sigmadrone/sigmadrone/hardware/kicad.old/readme.txt

This is old design for Panda ES extension board. It will not be used in the future!
It will be kept here just as reference.
