sigmadrone/sigmadrone/source/tools/glplane/numbers.bmp

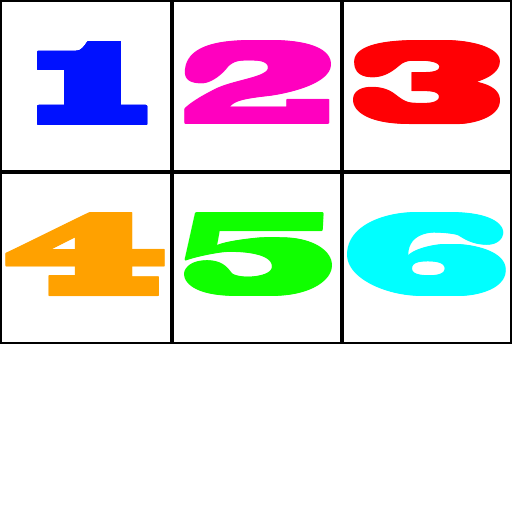
source/tools/glplane/numbers.bmp
