sigmadrone/sigmadrone/hardware/colibri/rev1j/Colibri_Rev1j_BOM.xlsx

Sheet: FULL BOM
 | DATE: | 2015-04-19 | FULL BOM
 | PROJECT: | Colibri_Rev1j
Note | Comp Name | PartName | Description | Type | Value | Maker | Maker Part Name | Provider | Provider Part Name | Maker2 | Maker2 Part Name | Provider2 | Provider2 Part Name | Maker3 | Maker3 Part Name | Provider3 | Provider3 Part Name | Maker4 | Maker4 Part Name | Provider4 | Provider4 Part Name
 | A1 | 1575AT43A0040E | ANTENNA CHIP GPS 1575 MHZ | SMT | 1575AT43A0040E | Johanson Technology Inc | 1575AT43A0040E | Digikey | 712-1003-1-ND | - | - | Mouser | 609-1575AT43A0040E | - | - | - | - | - | - | - | -
 | AREA1 | PATCH AREA 2.54/5X10/2X2/DRILL 1.00 | Patch Area 2.54/5x10/2x2/drill 1.00 | THT | Patch Area 2.54/5x10/2x2/drill 1.00 | - | - | - | - | - | - | - | - | - | - | - | - | - | - | - | -
 | B1 | WURTH 79527141 / BATTERY HOLDER 2032 | Battery Holder WA-BCMC 2032 | SMT | Battery Holder 2032 | WURTH ELEKTRONIK | 795 271 41 | WURTH ELEKTRONIK | - | - | - | - | - | - | - | - | - | - | - | - | -
 | C1 | C0603-100N/50V/±10%/X7R | Chip Capacitor 0603 100nF/50V/±10%/X7R | SMT | 100n/50V | KEMET | C0603X104K5RAC | Farnell | 1414028 | Kemet | C0603X104K5RACTU | DigiKey | 399-7969-1-ND | SAMSUNG | CL10B104KB8NNNC | Future | CL10B104KB8NNNC | Samsung | CL10B104KBNC | Comet | C0603 100nF 50V X7R SAMSU
 | C2 | C0603-100N/50V/±10%/X7R | Chip Capacitor 0603 100nF/50V/±10%/X7R | SMT | 100n/50V | KEMET | C0603X104K5RAC | Farnell | 1414028 | Kemet | C0603X104K5RACTU | DigiKey | 399-7969-1-ND | SAMSUNG | CL10B104KB8NNNC | Future | CL10B104KB8NNNC | Samsung | CL10B104KBNC | Comet | C0603 100nF 50V X7R SAMSU
 | C3 | C0805-10u/16V/X5R | CAP CER 10UF 16V 20% X5R 0805 | SMT | 10u/16V/X5R | MURATA | GRM21BR61C106KE15L | Farnell | 1762635 | TDK Corporation | C2012X5R1C106M/1.25 | Digikey | 445-4115-1-ND | SAMSUNG | CL21A106KOQNNNE | Comet | C0805 10uF 16V X5R SAMSUN | - | - | - | -
 | C4 | C0805-10u/16V/X5R | CAP CER 10UF 16V 20% X5R 0805 | SMT | 10u/16V/X5R | MURATA | GRM21BR61C106KE15L | Farnell | 1762635 | TDK Corporation | C2012X5R1C106M/1.25 | Digikey | 445-4115-1-ND | SAMSUNG | CL21A106KOQNNNE | Comet | C0805 10uF 16V X5R SAMSUN | - | - | - | -
 | C5 | C0603-100N/50V/±10%/X7R | Chip Capacitor 0603 100nF/50V/±10%/X7R | SMT | 100n/50V | KEMET | C0603X104K5RAC | Farnell | 1414028 | Kemet | C0603X104K5RACTU | DigiKey | 399-7969-1-ND | SAMSUNG | CL10B104KB8NNNC | Future | CL10B104KB8NNNC | Samsung | CL10B104KBNC | Comet | C0603 100nF 50V X7R SAMSU
 | C6 | C0805-10u/16V/X5R | CAP CER 10UF 16V 20% X5R 0805 | SMT | 10u/16V/X5R | MURATA | GRM21BR61C106KE15L | Farnell | 1762635 | TDK Corporation | C2012X5R1C106M/1.25 | Digikey | 445-4115-1-ND | SAMSUNG | CL21A106KOQNNNE | Comet | C0805 10uF 16V X5R SAMSUN | - | - | - | -
 | C7 | C0603-100N/50V/±10%/X7R | Chip Capacitor 0603 100nF/50V/±10%/X7R | SMT | 100n/50V | KEMET | C0603X104K5RAC | Farnell | 1414028 | Kemet | C0603X104K5RACTU | DigiKey | 399-7969-1-ND | SAMSUNG | CL10B104KB8NNNC | Future | CL10B104KB8NNNC | Samsung | CL10B104KBNC | Comet | C0603 100nF 50V X7R SAMSU
 | C8 | C_Tantalum C 220u/6V3 | Tantal Capacitor Case C 220u/6V3 | SMT | 220u/6V3_T | AVX | TPSC227K006R0125 | Farnell | 1462420 | AVX | TPSC227K006R0125 | Digikey | 478-1768-1-ND | AVX | TPSC227K006R0125 | Future | TPSC227K006R0125 | - | - | - | -
 | C9 | C0805-10u/16V/X5R | CAP CER 10UF 16V 20% X5R 0805 | SMT | 10u/16V/X5R | MURATA | GRM21BR61C106KE15L | Farnell | 1762635 | TDK Corporation | C2012X5R1C106M/1.25 | Digikey | 445-4115-1-ND | SAMSUNG | CL21A106KOQNNNE | Comet | C0805 10uF 16V X5R SAMSUN | - | - | - | -
 | C10 | C0603-100N/50V/±10%/X7R | Chip Capacitor 0603 100nF/50V/±10%/X7R | SMT | 100n/50V | KEMET | C0603X104K5RAC | Farnell | 1414028 | Kemet | C0603X104K5RACTU | DigiKey | 399-7969-1-ND | SAMSUNG | CL10B104KB8NNNC | Future | CL10B104KB8NNNC | Samsung | CL10B104KBNC | Comet | C0603 100nF 50V X7R SAMSU
 | C11 | C0603-100N/50V/±10%/X7R | Chip Capacitor 0603 100nF/50V/±10%/X7R | SMT | 100n/50V | KEMET | C0603X104K5RAC | Farnell | 1414028 | Kemet | C0603X104K5RACTU | DigiKey | 399-7969-1-ND | SAMSUNG | CL10B104KB8NNNC | Future | CL10B104KB8NNNC | Samsung | CL10B104KBNC | Comet | C0603 100nF 50V X7R SAMSU
 | C12 | C0805-10u/16V/X5R | CAP CER 10UF 16V 20% X5R 0805 | SMT | 10u/16V/X5R | MURATA | GRM21BR61C106KE15L | Farnell | 1762635 | TDK Corporation | C2012X5R1C106M/1.25 | Digikey | 445-4115-1-ND | SAMSUNG | CL21A106KOQNNNE | Comet | C0805 10uF 16V X5R SAMSUN | - | - | - | -
 | C13 | C0603-100N/50V/±10%/X7R | Chip Capacitor 0603 100nF/50V/±10%/X7R | SMT | 100n/50V | KEMET | C0603X104K5RAC | Farnell | 1414028 | Kemet | C0603X104K5RACTU | DigiKey | 399-7969-1-ND | SAMSUNG | CL10B104KB8NNNC | Future | CL10B104KB8NNNC | Samsung | CL10B104KBNC | Comet | C0603 100nF 50V X7R SAMSU
 | C14 | C0603-100N/50V/±10%/X7R | Chip Capacitor 0603 100nF/50V/±10%/X7R | SMT | 100n/50V | KEMET | C0603X104K5RAC | Farnell | 1414028 | Kemet | C0603X104K5RACTU | DigiKey | 399-7969-1-ND | SAMSUNG | CL10B104KB8NNNC | Future | CL10B104KB8NNNC | Samsung | CL10B104KBNC | Comet | C0603 100nF 50V X7R SAMSU
 | C15 | C0603-47p/50V/C0G/5% | Chip Capacitor 0603 47p/50V | SMT | 47p/50V | KEMET | C0603C470J1GACTU | Farnell | 1813433 | KEMET | C0603C470J1GACTU | Digikey | 399-7917-1-ND | AVX | 06035A470JAT2A | Future | 06035A470JAT2A | SAMSUNG | CL10C470JBNC | Comet | C0603 47pF 50V C0G SAMSUN
 | C16 | C0603-47p/50V/C0G/5% | Chip Capacitor 0603 47p/50V | SMT | 47p/50V | KEMET | C0603C470J1GACTU | Farnell | 1813433 | KEMET | C0603C470J1GACTU | Digikey | 399-7917-1-ND | AVX | 06035A470JAT2A | Future | 06035A470JAT2A | SAMSUNG | CL10C470JBNC | Comet | C0603 47pF 50V C0G SAMSUN
 | C17 | C_Tantalum C 220u/6V3 | Tantal Capacitor Case C 220u/6V3 | SMT | 220u/6V3_T | AVX | TPSC227K006R0125 | Farnell | 1462420 | AVX | TPSC227K006R0125 | Digikey | 478-1768-1-ND | AVX | TPSC227K006R0125 | Future | TPSC227K006R0125 | - | - | - | -
 | C18 | C0603-100N/50V/±10%/X7R | Chip Capacitor 0603 100nF/50V/±10%/X7R | SMT | 100n/50V | KEMET | C0603X104K5RAC | Farnell | 1414028 | Kemet | C0603X104K5RACTU | DigiKey | 399-7969-1-ND | SAMSUNG | CL10B104KB8NNNC | Future | CL10B104KB8NNNC | Samsung | CL10B104KBNC | Comet | C0603 100nF 50V X7R SAMSU
 | C19 | C0805-10u/16V/X5R | CAP CER 10UF 16V 20% X5R 0805 | SMT | 10u/16V/X5R | MURATA | GRM21BR61C106KE15L | Farnell | 1762635 | TDK Corporation | C2012X5R1C106M/1.25 | Digikey | 445-4115-1-ND | SAMSUNG | CL21A106KOQNNNE | Comet | C0805 10uF 16V X5R SAMSUN | - | - | - | -
 | C20 | C0603-100N/50V/±10%/X7R | Chip Capacitor 0603 100nF/50V/±10%/X7R | SMT | 100n/50V | KEMET | C0603X104K5RAC | Farnell | 1414028 | Kemet | C0603X104K5RACTU | DigiKey | 399-7969-1-ND | SAMSUNG | CL10B104KB8NNNC | Future | CL10B104KB8NNNC | Samsung | CL10B104KBNC | Comet | C0603 100nF 50V X7R SAMSU
 | C21 | C0603-100N/50V/±10%/X7R | Chip Capacitor 0603 100nF/50V/±10%/X7R | SMT | 100n/50V | KEMET | C0603X104K5RAC | Farnell | 1414028 | Kemet | C0603X104K5RACTU | DigiKey | 399-7969-1-ND | SAMSUNG | CL10B104KB8NNNC | Future | CL10B104KB8NNNC | Samsung | CL10B104KBNC | Comet | C0603 100nF 50V X7R SAMSU
 | C22 | C0603-220n/50V/±10%/X7R | CAP CER 0.22UF 50V 10% X7R 0603 | SMT | 220n/50V/X7R | TDK Corporation | CGA3E3X7R1H224K080AB | Farnell | 2210924 | TDK Corporation | C1608X7R1H224K | Digikey | 445-7408-1-ND | UWA | - | Comet | C0603 220nF 50V Y5V | - | - | - | -
 | C23 | C0603-100N/50V/±10%/X7R | Chip Capacitor 0603 100nF/50V/±10%/X7R | SMT | 100n/50V | KEMET | C0603X104K5RAC | Farnell | 1414028 | Kemet | C0603X104K5RACTU | DigiKey | 399-7969-1-ND | SAMSUNG | CL10B104KB8NNNC | Future | CL10B104KB8NNNC | Samsung | CL10B104KBNC | Comet | C0603 100nF 50V X7R SAMSU
 | C24 | C0603-4u7/6V3/X5R | Chip Capacitor 0603 4u7/6V3/X5R/10% | SMT | 4u7/6V3/X5R | AVX | 06036D475KAT2A | Farnell | 1833803 | TDK Corporation | C1608X6S0J475K | Digikey | 445-7446-1-ND | - | - | - | - | - | - | -
 | C25 | C0805-10u/16V/X5R | CAP CER 10UF 16V 20% X5R 0805 | SMT | 10u/16V/X5R | MURATA | GRM21BR61C106KE15L | Farnell | 1762635 | TDK Corporation | C2012X5R1C106M/1.25 | Digikey | 445-4115-1-ND | SAMSUNG | CL21A106KOQNNNE | Comet | C0805 10uF 16V X5R SAMSUN | - | - | - | -
 | C26 | C0603-100N/50V/±10%/X7R | Chip Capacitor 0603 100nF/50V/±10%/X7R | SMT | 100n/50V | KEMET | C0603X104K5RAC | Farnell | 1414028 | Kemet | C0603X104K5RACTU | DigiKey | 399-7969-1-ND | SAMSUNG | CL10B104KB8NNNC | Future | CL10B104KB8NNNC | Samsung | CL10B104KBNC | Comet | C0603 100nF 50V X7R SAMSU
 | C27 | C0805-10u/16V/X5R | CAP CER 10UF 16V 20% X5R 0805 | SMT | 10u/16V/X5R | MURATA | GRM21BR61C106KE15L | Farnell | 1762635 | TDK Corporation | C2012X5R1C106M/1.25 | Digikey | 445-4115-1-ND | SAMSUNG | CL21A106KOQNNNE | Comet | C0805 10uF 16V X5R SAMSUN | - | - | - | -
 | C28 | C0603-10n/50V/X7R | Chip Capacitor 0603 10nF/50V/X7R | SMT | 10n/50V/X7R | KEMET | C0603C103K5RACTU | Farnell | 1414609 | KEMET | C0603C103K5RACTU | DigiKey | 399-1091-1-ND | SAMSUNG | CL10B103KB8NNNC | Future | CL10B103KB8NNNC | MURATA | GRM216R71H103KA01D | Farnell | 1828948
 | C29 | C0603-470N/25V/±10%/X7R | Chip Capacitor 0603 470n/±10%/25V/X7R | SMT | 470n/25V/X7R | MULTICOMP | MCCA001174 | Farnell | 1856365 | - | - | - | - | - | - | - | - | - | - | - | -
 | C30 | C0603-15p/50V/1%/NP0 | Chip Capacitor 0603-15p/50V/1%/NP0 | SMT | 15p/50V/1% | MULTICOMP | MCCA000984 | Farnell | 1856143 | Samsung Electro-Mechanics | CL10C150JBNC | Comet | C0603 15pF 50V C0G SAMSUNG | YAGEO | CC0603FRNPO9BN150 | Future | CC0603FRNPO9BN150 | - | - | - | -
 | C31 | C0603-15p/50V/1%/NP0 | Chip Capacitor 0603-15p/50V/1%/NP0 | SMT | 15p/50V/1% | MULTICOMP | MCCA000984 | Farnell | 1856143 | Samsung Electro-Mechanics | CL10C150JBNC | Comet | C0603 15pF 50V C0G SAMSUNG | YAGEO | CC0603FRNPO9BN150 | Future | CC0603FRNPO9BN150 | - | - | - | -
 | C32 | C0603-10p/±0.25pF/NPO | Chip Capacitor 0603 10p/±0.25pF/NPO | SMT | 10p/50V/NPO | KEMET | C0603C100C5GAC | Farnell | 1414599 | KEMET | C0603C100C5GACTU | Digikey | C0603C100C5GACTU-ND | YAGEO AMERICA CORPORATION | CC0603CRNPO9BN100 | Future | CC0603CRNPO9BN100 | - | - | - | -
 | C33 | C0603-10p/±0.25pF/NPO | Chip Capacitor 0603 10p/±0.25pF/NPO | SMT | 10p/50V/NPO | KEMET | C0603C100C5GAC | Farnell | 1414599 | KEMET | C0603C100C5GACTU | Digikey | C0603C100C5GACTU-ND | YAGEO AMERICA CORPORATION | CC0603CRNPO9BN100 | Future | CC0603CRNPO9BN100 | - | - | - | -
 | C34 | C0603-2u2/10V/X5R | CAP CER 2.2UF 10V 10% X5R 0603 | SMT | 2u2/10V/X5R | KEMET | C0603C225K8PAC7867 | Farnell | 1108322 | Kemet | C0603C225K8PACTU | Digikey | 399-4911-1-ND | SAMSUNG | CL10A225KO8NNNC | Comet | C0603 2.2uF 16V X5R SAMSU | - | - | - | -
 | C35 | C0603-100N/50V/±10%/X7R | Chip Capacitor 0603 100nF/50V/±10%/X7R | SMT | 100n/50V | KEMET | C0603X104K5RAC | Farnell | 1414028 | Kemet | C0603X104K5RACTU | DigiKey | 399-7969-1-ND | SAMSUNG | CL10B104KB8NNNC | Future | CL10B104KB8NNNC | Samsung | CL10B104KBNC | Comet | C0603 100nF 50V X7R SAMSU
 | C36 | C0603-47p/50V/C0G/5% | Chip Capacitor 0603 47p/50V | SMT | 47p/50V | KEMET | C0603C470J1GACTU | Farnell | 1813433 | KEMET | C0603C470J1GACTU | Digikey | 399-7917-1-ND | AVX | 06035A470JAT2A | Future | 06035A470JAT2A | SAMSUNG | CL10C470JBNC | Comet | C0603 47pF 50V C0G SAMSUN
 | C37 | C0603-47p/50V/C0G/5% | Chip Capacitor 0603 47p/50V | SMT | 47p/50V | KEMET | C0603C470J1GACTU | Farnell | 1813433 | KEMET | C0603C470J1GACTU | Digikey | 399-7917-1-ND | AVX | 06035A470JAT2A | Future | 06035A470JAT2A | SAMSUNG | CL10C470JBNC | Comet | C0603 47pF 50V C0G SAMSUN
 | C38 | C0603-100N/50V/±10%/X7R | Chip Capacitor 0603 100nF/50V/±10%/X7R | SMT | 100n/50V | KEMET | C0603X104K5RAC | Farnell | 1414028 | Kemet | C0603X104K5RACTU | DigiKey | 399-7969-1-ND | SAMSUNG | CL10B104KB8NNNC | Future | CL10B104KB8NNNC | Samsung | CL10B104KBNC | Comet | C0603 100nF 50V X7R SAMSU
 | C39 | C0603-100N/50V/±10%/X7R | Chip Capacitor 0603 100nF/50V/±10%/X7R | SMT | 100n/50V | KEMET | C0603X104K5RAC | Farnell | 1414028 | Kemet | C0603X104K5RACTU | DigiKey | 399-7969-1-ND | SAMSUNG | CL10B104KB8NNNC | Future | CL10B104KB8NNNC | Samsung | CL10B104KBNC | Comet | C0603 100nF 50V X7R SAMSU
 | C40 | C0603-100N/50V/±10%/X7R | Chip Capacitor 0603 100nF/50V/±10%/X7R | SMT | 100n/50V | KEMET | C0603X104K5RAC | Farnell | 1414028 | Kemet | C0603X104K5RACTU | DigiKey | 399-7969-1-ND | SAMSUNG | CL10B104KB8NNNC | Future | CL10B104KB8NNNC | Samsung | CL10B104KBNC | Comet | C0603 100nF 50V X7R SAMSU
 | C41 | C0603-100N/50V/±10%/X7R | Chip Capacitor 0603 100nF/50V/±10%/X7R | SMT | 100n/50V | KEMET | C0603X104K5RAC | Farnell | 1414028 | Kemet | C0603X104K5RACTU | DigiKey | 399-7969-1-ND | SAMSUNG | CL10B104KB8NNNC | Future | CL10B104KB8NNNC | Samsung | CL10B104KBNC | Comet | C0603 100nF 50V X7R SAMSU
 | C42 | C0603-100N/50V/±10%/X7R | Chip Capacitor 0603 100nF/50V/±10%/X7R | SMT | 100n/50V | KEMET | C0603X104K5RAC | Farnell | 1414028 | Kemet | C0603X104K5RACTU | DigiKey | 399-7969-1-ND | SAMSUNG | CL10B104KB8NNNC | Future | CL10B104KB8NNNC | Samsung | CL10B104KBNC | Comet | C0603 100nF 50V X7R SAMSU
 | C43 | C0603-100N/50V/±10%/X7R | Chip Capacitor 0603 100nF/50V/±10%/X7R | SMT | 100n/50V | KEMET | C0603X104K5RAC | Farnell | 1414028 | Kemet | C0603X104K5RACTU | DigiKey | 399-7969-1-ND | SAMSUNG | CL10B104KB8NNNC | Future | CL10B104KB8NNNC | Samsung | CL10B104KBNC | Comet | C0603 100nF 50V X7R SAMSU
 | C44 | C0603-100N/50V/±10%/X7R | Chip Capacitor 0603 100nF/50V/±10%/X7R | SMT | 100n/50V | KEMET | C0603X104K5RAC | Farnell | 1414028 | Kemet | C0603X104K5RACTU | DigiKey | 399-7969-1-ND | SAMSUNG | CL10B104KB8NNNC | Future | CL10B104KB8NNNC | Samsung | CL10B104KBNC | Comet | C0603 100nF 50V X7R SAMSU
 | C45 | C0603-100N/50V/±10%/X7R | Chip Capacitor 0603 100nF/50V/±10%/X7R | SMT | 100n/50V | KEMET | C0603X104K5RAC | Farnell | 1414028 | Kemet | C0603X104K5RACTU | DigiKey | 399-7969-1-ND | SAMSUNG | CL10B104KB8NNNC | Future | CL10B104KB8NNNC | Samsung | CL10B104KBNC | Comet | C0603 100nF 50V X7R SAMSU
 | C46 | C0603-100N/50V/±10%/X7R | Chip Capacitor 0603 100nF/50V/±10%/X7R | SMT | 100n/50V | KEMET | C0603X104K5RAC | Farnell | 1414028 | Kemet | C0603X104K5RACTU | DigiKey | 399-7969-1-ND | SAMSUNG | CL10B104KB8NNNC | Future | CL10B104KB8NNNC | Samsung | CL10B104KBNC | Comet | C0603 100nF 50V X7R SAMSU
 | C47 | C0603-100N/50V/±10%/X7R | Chip Capacitor 0603 100nF/50V/±10%/X7R | SMT | 100n/50V | KEMET | C0603X104K5RAC | Farnell | 1414028 | Kemet | C0603X104K5RACTU | DigiKey | 399-7969-1-ND | SAMSUNG | CL10B104KB8NNNC | Future | CL10B104KB8NNNC | Samsung | CL10B104KBNC | Comet | C0603 100nF 50V X7R SAMSU
 | C48 | C0603-100N/50V/±10%/X7R | Chip Capacitor 0603 100nF/50V/±10%/X7R | SMT | 100n/50V | KEMET | C0603X104K5RAC | Farnell | 1414028 | Kemet | C0603X104K5RACTU | DigiKey | 399-7969-1-ND | SAMSUNG | CL10B104KB8NNNC | Future | CL10B104KB8NNNC | Samsung | CL10B104KBNC | Comet | C0603 100nF 50V X7R SAMSU
 | C49 | C0805-10u/16V/X5R | CAP CER 10UF 16V 20% X5R 0805 | SMT | 10u/16V/X5R | MURATA | GRM21BR61C106KE15L | Farnell | 1762635 | TDK Corporation | C2012X5R1C106M/1.25 | Digikey | 445-4115-1-ND | SAMSUNG | CL21A106KOQNNNE | Comet | C0805 10uF 16V X5R SAMSUN | - | - | - | -
 | C50 | C0603-1u/25V/±10%/X7R | CAP CER 1UF 25V 10% X7R 0603 | SMT | 1u/25V/X7R | MURATA | GRM188R71E105KA12D | Farnell | 1735540 | TDK Corporation | C1608X7R1E105K080AB | Digi-Key | 445-5956-1-ND | - | - | - | - | - | - | - | -
 | C51 | C0603-100N/50V/±10%/X7R | Chip Capacitor 0603 100nF/50V/±10%/X7R | SMT | 100n/50V | KEMET | C0603X104K5RAC | Farnell | 1414028 | Kemet | C0603X104K5RACTU | DigiKey | 399-7969-1-ND | SAMSUNG | CL10B104KB8NNNC | Future | CL10B104KB8NNNC | Samsung | CL10B104KBNC | Comet | C0603 100nF 50V X7R SAMSU
 | C52 | C0603-100N/50V/±10%/X7R | Chip Capacitor 0603 100nF/50V/±10%/X7R | SMT | 100n/50V | KEMET | C0603X104K5RAC | Farnell | 1414028 | Kemet | C0603X104K5RACTU | DigiKey | 399-7969-1-ND | SAMSUNG | CL10B104KB8NNNC | Future | CL10B104KB8NNNC | Samsung | CL10B104KBNC | Comet | C0603 100nF 50V X7R SAMSU
 | C53 | C0805-10u/16V/X5R | CAP CER 10UF 16V 20% X5R 0805 | SMT | 10u/16V/X5R | MURATA | GRM21BR61C106KE15L | Farnell | 1762635 | TDK Corporation | C2012X5R1C106M/1.25 | Digikey | 445-4115-1-ND | SAMSUNG | CL21A106KOQNNNE | Comet | C0805 10uF 16V X5R SAMSUN | - | - | - | -
 | C54 | C0603-100N/50V/±10%/X7R | Chip Capacitor 0603 100nF/50V/±10%/X7R | SMT | 100n/50V | KEMET | C0603X104K5RAC | Farnell | 1414028 | Kemet | C0603X104K5RACTU | DigiKey | 399-7969-1-ND | SAMSUNG | CL10B104KB8NNNC | Future | CL10B104KB8NNNC | Samsung | CL10B104KBNC | Comet | C0603 100nF 50V X7R SAMSU
 | C55 | C0603-100N/50V/±10%/X7R | Chip Capacitor 0603 100nF/50V/±10%/X7R | SMT | 100n/50V | KEMET | C0603X104K5RAC | Farnell | 1414028 | Kemet | C0603X104K5RACTU | DigiKey | 399-7969-1-ND | SAMSUNG | CL10B104KB8NNNC | Future | CL10B104KB8NNNC | Samsung | CL10B104KBNC | Comet | C0603 100nF 50V X7R SAMSU
 | C56 | C0603-2u2/10V/X5R | CAP CER 2.2UF 10V 10% X5R 0603 | SMT | 2u2/10V/X5R | KEMET | C0603C225K8PAC7867 | Farnell | 1108322 | Kemet | C0603C225K8PACTU | Digikey | 399-4911-1-ND | SAMSUNG | CL10A225KO8NNNC | Comet | C0603 2.2uF 16V X5R SAMSU | - | - | - | -
 | C57 | C0603-100N/50V/±10%/X7R | Chip Capacitor 0603 100nF/50V/±10%/X7R | SMT | 100n/50V | KEMET | C0603X104K5RAC | Farnell | 1414028 | Kemet | C0603X104K5RACTU | DigiKey | 399-7969-1-ND | SAMSUNG | CL10B104KB8NNNC | Future | CL10B104KB8NNNC | Samsung | CL10B104KBNC | Comet | C0603 100nF 50V X7R SAMSU
 | C58 | C0603-100N/50V/±10%/X7R | Chip Capacitor 0603 100nF/50V/±10%/X7R | SMT | 100n/50V | KEMET | C0603X104K5RAC | Farnell | 1414028 | Kemet | C0603X104K5RACTU | DigiKey | 399-7969-1-ND | SAMSUNG | CL10B104KB8NNNC | Future | CL10B104KB8NNNC | Samsung | CL10B104KBNC | Comet | C0603 100nF 50V X7R SAMSU
 | C59 | C0603-100N/50V/±10%/X7R | Chip Capacitor 0603 100nF/50V/±10%/X7R | SMT | 100n/50V | KEMET | C0603X104K5RAC | Farnell | 1414028 | Kemet | C0603X104K5RACTU | DigiKey | 399-7969-1-ND | SAMSUNG | CL10B104KB8NNNC | Future | CL10B104KB8NNNC | Samsung | CL10B104KBNC | Comet | C0603 100nF 50V X7R SAMSU
 | C60 | C0603-100N/50V/±10%/X7R | Chip Capacitor 0603 100nF/50V/±10%/X7R | SMT | 100n/50V | KEMET | C0603X104K5RAC | Farnell | 1414028 | Kemet | C0603X104K5RACTU | DigiKey | 399-7969-1-ND | SAMSUNG | CL10B104KB8NNNC | Future | CL10B104KB8NNNC | Samsung | CL10B104KBNC | Comet | C0603 100nF 50V X7R SAMSU
 | C61 | C0603-100N/50V/±10%/X7R | Chip Capacitor 0603 100nF/50V/±10%/X7R | SMT | 100n/50V | KEMET | C0603X104K5RAC | Farnell | 1414028 | Kemet | C0603X104K5RACTU | DigiKey | 399-7969-1-ND | SAMSUNG | CL10B104KB8NNNC | Future | CL10B104KB8NNNC | Samsung | CL10B104KBNC | Comet | C0603 100nF 50V X7R SAMSU
 | C62 | C0603-100N/50V/±10%/X7R | Chip Capacitor 0603 100nF/50V/±10%/X7R | SMT | 100n/50V | KEMET | C0603X104K5RAC | Farnell | 1414028 | Kemet | C0603X104K5RACTU | DigiKey | 399-7969-1-ND | SAMSUNG | CL10B104KB8NNNC | Future | CL10B104KB8NNNC | Samsung | CL10B104KBNC | Comet | C0603 100nF 50V X7R SAMSU
 | C63 | C0603-100N/50V/±10%/X7R | Chip Capacitor 0603 100nF/50V/±10%/X7R | SMT | 100n/50V | KEMET | C0603X104K5RAC | Farnell | 1414028 | Kemet | C0603X104K5RACTU | DigiKey | 399-7969-1-ND | SAMSUNG | CL10B104KB8NNNC | Future | CL10B104KB8NNNC | Samsung | CL10B104KBNC | Comet | C0603 100nF 50V X7R SAMSU
 | C64 | C0603-100N/50V/±10%/X7R | Chip Capacitor 0603 100nF/50V/±10%/X7R | SMT | 100n/50V | KEMET | C0603X104K5RAC | Farnell | 1414028 | Kemet | C0603X104K5RACTU | DigiKey | 399-7969-1-ND | SAMSUNG | CL10B104KB8NNNC | Future | CL10B104KB8NNNC | Samsung | CL10B104KBNC | Comet | C0603 100nF 50V X7R SAMSU
 | C65 | C0603-100N/50V/±10%/X7R | Chip Capacitor 0603 100nF/50V/±10%/X7R | SMT | 100n/50V | KEMET | C0603X104K5RAC | Farnell | 1414028 | Kemet | C0603X104K5RACTU | DigiKey | 399-7969-1-ND | SAMSUNG | CL10B104KB8NNNC | Future | CL10B104KB8NNNC | Samsung | CL10B104KBNC | Comet | C0603 100nF 50V X7R SAMSU
 | C66 | C0603-100N/50V/±10%/X7R | Chip Capacitor 0603 100nF/50V/±10%/X7R | SMT | 100n/50V | KEMET | C0603X104K5RAC | Farnell | 1414028 | Kemet | C0603X104K5RACTU | DigiKey | 399-7969-1-ND | SAMSUNG | CL10B104KB8NNNC | Future | CL10B104KB8NNNC | Samsung | CL10B104KBNC | Comet | C0603 100nF 50V X7R SAMSU
 | C67 | C0603-100N/50V/±10%/X7R | Chip Capacitor 0603 100nF/50V/±10%/X7R | SMT | 100n/50V | KEMET | C0603X104K5RAC | Farnell | 1414028 | Kemet | C0603X104K5RACTU | DigiKey | 399-7969-1-ND | SAMSUNG | CL10B104KB8NNNC | Future | CL10B104KB8NNNC | Samsung | CL10B104KBNC | Comet | C0603 100nF 50V X7R SAMSU
 | C68 | C0603-100N/50V/±10%/X7R | Chip Capacitor 0603 100nF/50V/±10%/X7R | SMT | 100n/50V | KEMET | C0603X104K5RAC | Farnell | 1414028 | Kemet | C0603X104K5RACTU | DigiKey | 399-7969-1-ND | SAMSUNG | CL10B104KB8NNNC | Future | CL10B104KB8NNNC | Samsung | CL10B104KBNC | Comet | C0603 100nF 50V X7R SAMSU
 | C69 | C0603-2u2/10V/X5R | CAP CER 2.2UF 10V 10% X5R 0603 | SMT | 2u2/10V/X5R | KEMET | C0603C225K8PAC7867 | Farnell | 1108322 | Kemet | C0603C225K8PACTU | Digikey | 399-4911-1-ND | SAMSUNG | CL10A225KO8NNNC | Comet | C0603 2.2uF 16V X5R SAMSU | - | - | - | -
 | C70 | C0603-100N/50V/±10%/X7R | Chip Capacitor 0603 100nF/50V/±10%/X7R | SMT | 100n/50V | KEMET | C0603X104K5RAC | Farnell | 1414028 | Kemet | C0603X104K5RACTU | DigiKey | 399-7969-1-ND | SAMSUNG | CL10B104KB8NNNC | Future | CL10B104KB8NNNC | Samsung | CL10B104KBNC | Comet | C0603 100nF 50V X7R SAMSU
 | C71 | C0603-100N/50V/±10%/X7R | Chip Capacitor 0603 100nF/50V/±10%/X7R | SMT | 100n/50V | KEMET | C0603X104K5RAC | Farnell | 1414028 | Kemet | C0603X104K5RACTU | DigiKey | 399-7969-1-ND | SAMSUNG | CL10B104KB8NNNC | Future | CL10B104KB8NNNC | Samsung | CL10B104KBNC | Comet | C0603 100nF 50V X7R SAMSU
 | C72 | C0805-10u/16V/X5R | CAP CER 10UF 16V 20% X5R 0805 | SMT | 10u/16V/X5R | MURATA | GRM21BR61C106KE15L | Farnell | 1762635 | TDK Corporation | C2012X5R1C106M/1.25 | Digikey | 445-4115-1-ND | SAMSUNG | CL21A106KOQNNNE | Comet | C0805 10uF 16V X5R SAMSUN | - | - | - | -
 | C73 | C0603-100N/50V/±10%/X7R | Chip Capacitor 0603 100nF/50V/±10%/X7R | SMT | 100n/50V | KEMET | C0603X104K5RAC | Farnell | 1414028 | Kemet | C0603X104K5RACTU | DigiKey | 399-7969-1-ND | SAMSUNG | CL10B104KB8NNNC | Future | CL10B104KB8NNNC | Samsung | CL10B104KBNC | Comet | C0603 100nF 50V X7R SAMSU
 | C74 | C0805-10u/16V/X5R | CAP CER 10UF 16V 20% X5R 0805 | SMT | 10u/16V/X5R | MURATA | GRM21BR61C106KE15L | Farnell | 1762635 | TDK Corporation | C2012X5R1C106M/1.25 | Digikey | 445-4115-1-ND | SAMSUNG | CL21A106KOQNNNE | Comet | C0805 10uF 16V X5R SAMSUN | - | - | - | -
 | C75 | C0603-10n/50V/X7R | Chip Capacitor 0603 10nF/50V/X7R | SMT | 10n/50V/X7R | KEMET | C0603C103K5RACTU | Farnell | 1414609 | KEMET | C0603C103K5RACTU | DigiKey | 399-1091-1-ND | SAMSUNG | CL10B103KB8NNNC | Future | CL10B103KB8NNNC | MURATA | GRM216R71H103KA01D | Farnell | 1828948
 | C76 | C0805-10u/16V/X5R | CAP CER 10UF 16V 20% X5R 0805 | SMT | 10u/16V/X5R | MURATA | GRM21BR61C106KE15L | Farnell | 1762635 | TDK Corporation | C2012X5R1C106M/1.25 | Digikey | 445-4115-1-ND | SAMSUNG | CL21A106KOQNNNE | Comet | C0805 10uF 16V X5R SAMSUN | - | - | - | -
 | C77 | C0805-10u/16V/X5R | CAP CER 10UF 16V 20% X5R 0805 | SMT | 10u/16V/X5R | MURATA | GRM21BR61C106KE15L | Farnell | 1762635 | TDK Corporation | C2012X5R1C106M/1.25 | Digikey | 445-4115-1-ND | SAMSUNG | CL21A106KOQNNNE | Comet | C0805 10uF 16V X5R SAMSUN | - | - | - | -
 | C78 | C0603-100N/50V/±10%/X7R | Chip Capacitor 0603 100nF/50V/±10%/X7R | SMT | 100n/50V | KEMET | C0603X104K5RAC | Farnell | 1414028 | Kemet | C0603X104K5RACTU | DigiKey | 399-7969-1-ND | SAMSUNG | CL10B104KB8NNNC | Future | CL10B104KB8NNNC | Samsung | CL10B104KBNC | Comet | C0603 100nF 50V X7R SAMSU
 | C79 | C1206-4u7/25V/X7R | Chip Capacitor 1206 4u7/25V | SMT | 4u7/25V | KEMET | C1206X475K3RAC | Farnell | 1414061 | Samsung | CL31B475KAHNNNE | Comet | C1206 4.7uF 25V X7R SAMSUNG | - | - | - | - | - | - | - | -
 | C80 | C1206-4u7/25V/X7R | Chip Capacitor 1206 4u7/25V | SMT | 4u7/25V | KEMET | C1206X475K3RAC | Farnell | 1414061 | Samsung | CL31B475KAHNNNE | Comet | C1206 4.7uF 25V X7R SAMSUNG | - | - | - | - | - | - | - | -
 | C81 | C0603-8n2/50V/±10%/X7R | Chip Capacitor 0603 8n2/50V/±0.10%/X7R | SMT | 8n2/50V | KEMET | C0603C822K5RACTU | Farnell | 1865533 | KEMET | C0603C822K5RACTU | Digikey | 399-7961-1-ND | - | - | - | - | - | - | - | -
 | C82 | C0805-10u/16V/X5R | CAP CER 10UF 16V 20% X5R 0805 | SMT | 10u/16V/X5R | MURATA | GRM21BR61C106KE15L | Farnell | 1762635 | TDK Corporation | C2012X5R1C106M/1.25 | Digikey | 445-4115-1-ND | SAMSUNG | CL21A106KOQNNNE | Comet | C0805 10uF 16V X5R SAMSUN | - | - | - | -
 | C83 | C0603-100N/50V/±10%/X7R | Chip Capacitor 0603 100nF/50V/±10%/X7R | SMT | 100n/50V | KEMET | C0603X104K5RAC | Farnell | 1414028 | Kemet | C0603X104K5RACTU | DigiKey | 399-7969-1-ND | SAMSUNG | CL10B104KB8NNNC | Future | CL10B104KB8NNNC | Samsung | CL10B104KBNC | Comet | C0603 100nF 50V X7R SAMSU
 | C84 | C1206-4u7/25V/X7R | Chip Capacitor 1206 4u7/25V | SMT | 4u7/25V | KEMET | C1206X475K3RAC | Farnell | 1414061 | Samsung | CL31B475KAHNNNE | Comet | C1206 4.7uF 25V X7R SAMSUNG | - | - | - | - | - | - | - | -
 | C85 | C1206-4u7/25V/X7R | Chip Capacitor 1206 4u7/25V | SMT | 4u7/25V | KEMET | C1206X475K3RAC | Farnell | 1414061 | Samsung | CL31B475KAHNNNE | Comet | C1206 4.7uF 25V X7R SAMSUNG | - | - | - | - | - | - | - | -
 | C86 | C0603-8n2/50V/±10%/X7R | Chip Capacitor 0603 8n2/50V/±0.10%/X7R | SMT | 8n2/50V | KEMET | C0603C822K5RACTU | Farnell | 1865533 | KEMET | C0603C822K5RACTU | Digikey | 399-7961-1-ND | - | - | - | - | - | - | - | -
 | C87 | C0603-10p/±0.25pF/NPO | Chip Capacitor 0603 10p/±0.25pF/NPO | SMT | 10p/50V/NPO | KEMET | C0603C100C5GAC | Farnell | 1414599 | KEMET | C0603C100C5GACTU | Digikey | C0603C100C5GACTU-ND | YAGEO AMERICA CORPORATION | CC0603CRNPO9BN100 | Future | CC0603CRNPO9BN100 | - | - | - | -
 | C88 | C0603-470p/50V/10%/X7R | CAP CERM X7R 470PF 50V 0603 | SMT | 470p/50V | AVX | 06035C471KAT2A | Farnell | 498580 | - | - | - | - | - | - | - | - | - | - | - | -
 | C89 | C0603-100N/50V/±10%/X7R | Chip Capacitor 0603 100nF/50V/±10%/X7R | SMT | 100n/50V | KEMET | C0603X104K5RAC | Farnell | 1414028 | Kemet | C0603X104K5RACTU | DigiKey | 399-7969-1-ND | SAMSUNG | CL10B104KB8NNNC | Future | CL10B104KB8NNNC | Samsung | CL10B104KBNC | Comet | C0603 100nF 50V X7R SAMSU
 | C90 | C0603-33n/50V/X7R/10% | Chip Capacitor 0603 33n/50V/X7R/10% | SMT | 33n/50V/10%/X7R | KEMET | C0603C333K5RAC | Farnell | 1414636 | KEMET | C0603C333K5RAC | Digikey | 399-7906-1-ND | - | - | - | - | - | - | - | -
 | C91 | C0603-10p/±0.25pF/NPO | Chip Capacitor 0603 10p/±0.25pF/NPO | SMT | 10p/50V/NPO | KEMET | C0603C100C5GAC | Farnell | 1414599 | KEMET | C0603C100C5GACTU | Digikey | C0603C100C5GACTU-ND | YAGEO AMERICA CORPORATION | CC0603CRNPO9BN100 | Future | CC0603CRNPO9BN100 | - | - | - | -
 | C92 | C0603-470p/50V/10%/X7R | CAP CERM X7R 470PF 50V 0603 | SMT | 470p/50V | AVX | 06035C471KAT2A | Farnell | 498580 | - | - | - | - | - | - | - | - | - | - | - | -
 | C93 | C0603-100N/50V/±10%/X7R | Chip Capacitor 0603 100nF/50V/±10%/X7R | SMT | 100n/50V | KEMET | C0603X104K5RAC | Farnell | 1414028 | Kemet | C0603X104K5RACTU | DigiKey | 399-7969-1-ND | SAMSUNG | CL10B104KB8NNNC | Future | CL10B104KB8NNNC | Samsung | CL10B104KBNC | Comet | C0603 100nF 50V X7R SAMSU
 | C94 | C0805-10u/16V/X5R | CAP CER 10UF 16V 20% X5R 0805 | SMT | 10u/16V/X5R | MURATA | GRM21BR61C106KE15L | Farnell | 1762635 | TDK Corporation | C2012X5R1C106M/1.25 | Digikey | 445-4115-1-ND | SAMSUNG | CL21A106KOQNNNE | Comet | C0805 10uF 16V X5R SAMSUN | - | - | - | -
 | C95 | C0603-100N/50V/±10%/X7R | Chip Capacitor 0603 100nF/50V/±10%/X7R | SMT | 100n/50V | KEMET | C0603X104K5RAC | Farnell | 1414028 | Kemet | C0603X104K5RACTU | DigiKey | 399-7969-1-ND | SAMSUNG | CL10B104KB8NNNC | Future | CL10B104KB8NNNC | Samsung | CL10B104KBNC | Comet | C0603 100nF 50V X7R SAMSU
 | C96 | C0603-1u/25V/±10%/X7R | CAP CER 1UF 25V 10% X7R 0603 | SMT | 1u/25V/X7R | MURATA | GRM188R71E105KA12D | Farnell | 1735540 | TDK Corporation | C1608X7R1E105K080AB | Digi-Key | 445-5956-1-ND | - | - | - | - | - | - | - | -
 | C97 | C0603-100N/50V/±10%/X7R | Chip Capacitor 0603 100nF/50V/±10%/X7R | SMT | 100n/50V | KEMET | C0603X104K5RAC | Farnell | 1414028 | Kemet | C0603X104K5RACTU | DigiKey | 399-7969-1-ND | SAMSUNG | CL10B104KB8NNNC | Future | CL10B104KB8NNNC | Samsung | CL10B104KBNC | Comet | C0603 100nF 50V X7R SAMSU
 | C98 | C0603-100N/50V/±10%/X7R | Chip Capacitor 0603 100nF/50V/±10%/X7R | SMT | 100n/50V | KEMET | C0603X104K5RAC | Farnell | 1414028 | Kemet | C0603X104K5RACTU | DigiKey | 399-7969-1-ND | SAMSUNG | CL10B104KB8NNNC | Future | CL10B104KB8NNNC | Samsung | CL10B104KBNC | Comet | C0603 100nF 50V X7R SAMSU
 | C99 | C0603-100N/50V/±10%/X7R | Chip Capacitor 0603 100nF/50V/±10%/X7R | SMT | 100n/50V | KEMET | C0603X104K5RAC | Farnell | 1414028 | Kemet | C0603X104K5RACTU | DigiKey | 399-7969-1-ND | SAMSUNG | CL10B104KB8NNNC | Future | CL10B104KB8NNNC | Samsung | CL10B104KBNC | Comet | C0603 100nF 50V X7R SAMSU
 | C100 | C0603-100N/50V/±10%/X7R | Chip Capacitor 0603 100nF/50V/±10%/X7R | SMT | 100n/50V | KEMET | C0603X104K5RAC | Farnell | 1414028 | Kemet | C0603X104K5RACTU | DigiKey | 399-7969-1-ND | SAMSUNG | CL10B104KB8NNNC | Future | CL10B104KB8NNNC | Samsung | CL10B104KBNC | Comet | C0603 100nF 50V X7R SAMSU
 | C101 | C0603-100N/50V/±10%/X7R | Chip Capacitor 0603 100nF/50V/±10%/X7R | SMT | 100n/50V | KEMET | C0603X104K5RAC | Farnell | 1414028 | Kemet | C0603X104K5RACTU | DigiKey | 399-7969-1-ND | SAMSUNG | CL10B104KB8NNNC | Future | CL10B104KB8NNNC | Samsung | CL10B104KBNC | Comet | C0603 100nF 50V X7R SAMSU
 | C102 | C_EL/SIZE5.0X5.5/-22U/35V | Electrolitic Capacitor SMD 22uF 35V | SMT | 22uF/35V | WURTH ELEKTRONIK | 865080542006 | Farnell | 2466315 | - | - | - | - | - | - | - | - | - | - | - | -
 | C103 | C0603-100N/50V/±10%/X7R | Chip Capacitor 0603 100nF/50V/±10%/X7R | SMT | 100n/50V | KEMET | C0603X104K5RAC | Farnell | 1414028 | Kemet | C0603X104K5RACTU | DigiKey | 399-7969-1-ND | SAMSUNG | CL10B104KB8NNNC | Future | CL10B104KB8NNNC | Samsung | CL10B104KBNC | Comet | C0603 100nF 50V X7R SAMSU
 | C104 | C0603-100N/50V/±10%/X7R | Chip Capacitor 0603 100nF/50V/±10%/X7R | SMT | 100n/50V | KEMET | C0603X104K5RAC | Farnell | 1414028 | Kemet | C0603X104K5RACTU | DigiKey | 399-7969-1-ND | SAMSUNG | CL10B104KB8NNNC | Future | CL10B104KB8NNNC | Samsung | CL10B104KBNC | Comet | C0603 100nF 50V X7R SAMSU
 | C105 | C_EL/SIZE5.0X5.5/-22U/35V | Electrolitic Capacitor SMD 22uF 35V | SMT | 22uF/35V | WURTH ELEKTRONIK | 865080542006 | Farnell | 2466315 | - | - | - | - | - | - | - | - | - | - | - | -
 | C106 | C0603-100N/50V/±10%/X7R | Chip Capacitor 0603 100nF/50V/±10%/X7R | SMT | 100n/50V | KEMET | C0603X104K5RAC | Farnell | 1414028 | Kemet | C0603X104K5RACTU | DigiKey | 399-7969-1-ND | SAMSUNG | CL10B104KB8NNNC | Future | CL10B104KB8NNNC | Samsung | CL10B104KBNC | Comet | C0603 100nF 50V X7R SAMSU
 | C107 | C0603-100N/50V/±10%/X7R | Chip Capacitor 0603 100nF/50V/±10%/X7R | SMT | 100n/50V | KEMET | C0603X104K5RAC | Farnell | 1414028 | Kemet | C0603X104K5RACTU | DigiKey | 399-7969-1-ND | SAMSUNG | CL10B104KB8NNNC | Future | CL10B104KB8NNNC | Samsung | CL10B104KBNC | Comet | C0603 100nF 50V X7R SAMSU
 | C108 | C0603-100N/50V/±10%/X7R | Chip Capacitor 0603 100nF/50V/±10%/X7R | SMT | 100n/50V | KEMET | C0603X104K5RAC | Farnell | 1414028 | Kemet | C0603X104K5RACTU | DigiKey | 399-7969-1-ND | SAMSUNG | CL10B104KB8NNNC | Future | CL10B104KB8NNNC | Samsung | CL10B104KBNC | Comet | C0603 100nF 50V X7R SAMSU
 | C109 | C_EL/SIZE5.0X5.5/-22U/35V | Electrolitic Capacitor SMD 22uF 35V | SMT | 22uF/35V | WURTH ELEKTRONIK | 865080542006 | Farnell | 2466315 | - | - | - | - | - | - | - | - | - | - | - | -
 | C110 | C0603-1u/25V/±10%/X7R | CAP CER 1UF 25V 10% X7R 0603 | SMT | 1u/25V/X7R | MURATA | GRM188R71E105KA12D | Farnell | 1735540 | TDK Corporation | C1608X7R1E105K080AB | Digi-Key | 445-5956-1-ND | - | - | - | - | - | - | - | -
 | C111 | C0603-100N/50V/±10%/X7R | Chip Capacitor 0603 100nF/50V/±10%/X7R | SMT | 100n/50V | KEMET | C0603X104K5RAC | Farnell | 1414028 | Kemet | C0603X104K5RACTU | DigiKey | 399-7969-1-ND | SAMSUNG | CL10B104KB8NNNC | Future | CL10B104KB8NNNC | Samsung | CL10B104KBNC | Comet | C0603 100nF 50V X7R SAMSU
 | C112 | C0603-100N/50V/±10%/X7R | Chip Capacitor 0603 100nF/50V/±10%/X7R | SMT | 100n/50V | KEMET | C0603X104K5RAC | Farnell | 1414028 | Kemet | C0603X104K5RACTU | DigiKey | 399-7969-1-ND | SAMSUNG | CL10B104KB8NNNC | Future | CL10B104KB8NNNC | Samsung | CL10B104KBNC | Comet | C0603 100nF 50V X7R SAMSU
 | C113 | C0603-100N/50V/±10%/X7R | Chip Capacitor 0603 100nF/50V/±10%/X7R | SMT | 100n/50V | KEMET | C0603X104K5RAC | Farnell | 1414028 | Kemet | C0603X104K5RACTU | DigiKey | 399-7969-1-ND | SAMSUNG | CL10B104KB8NNNC | Future | CL10B104KB8NNNC | Samsung | CL10B104KBNC | Comet | C0603 100nF 50V X7R SAMSU
 | C114 | C0603-100N/50V/±10%/X7R | Chip Capacitor 0603 100nF/50V/±10%/X7R | SMT | 100n/50V | KEMET | C0603X104K5RAC | Farnell | 1414028 | Kemet | C0603X104K5RACTU | DigiKey | 399-7969-1-ND | SAMSUNG | CL10B104KB8NNNC | Future | CL10B104KB8NNNC | Samsung | CL10B104KBNC | Comet | C0603 100nF 50V X7R SAMSU
 | C115 | C0603-100N/50V/±10%/X7R | Chip Capacitor 0603 100nF/50V/±10%/X7R | SMT | 100n/50V | KEMET | C0603X104K5RAC | Farnell | 1414028 | Kemet | C0603X104K5RACTU | DigiKey | 399-7969-1-ND | SAMSUNG | CL10B104KB8NNNC | Future | CL10B104KB8NNNC | Samsung | CL10B104KBNC | Comet | C0603 100nF 50V X7R SAMSU
 | C116 | C0603-100N/50V/±10%/X7R | Chip Capacitor 0603 100nF/50V/±10%/X7R | SMT | 100n/50V | KEMET | C0603X104K5RAC | Farnell | 1414028 | Kemet | C0603X104K5RACTU | DigiKey | 399-7969-1-ND | SAMSUNG | CL10B104KB8NNNC | Future | CL10B104KB8NNNC | Samsung | CL10B104KBNC | Comet | C0603 100nF 50V X7R SAMSU
 | C117 | C0603-2u2/10V/X5R | CAP CER 2.2UF 10V 10% X5R 0603 | SMT | 2u2/10V/X5R | KEMET | C0603C225K8PAC7867 | Farnell | 1108322 | Kemet | C0603C225K8PACTU | Digikey | 399-4911-1-ND | SAMSUNG | CL10A225KO8NNNC | Comet | C0603 2.2uF 16V X5R SAMSU | - | - | - | -
 | CN1 | 692121030100 | USB 3.0 TYPE A RECEPTACLE THT RA | THT | 692121030100 | WURTH ELEKTRONIK | 692121030100 | Farnell | 1861251 | - | - | - | - | - | - | - | - | - | - | - | -
 | CN2 | 629105150921 | Micro USB 2.0 Type AB - Horizontal - WR-COM | SMT | 629105150921 | WURTH ELEKTRONIK | 629105150921 | WURTH ELEKTRONIK | 629105150921 | - | - | - | - | - | - | - | - | - | - | - | -
 | CN3 | 629105150921 | Micro USB 2.0 Type AB - Horizontal - WR-COM | SMT | 629105150921 | WURTH ELEKTRONIK | 629105150921 | WURTH ELEKTRONIK | 629105150921 | - | - | - | - | - | - | - | - | - | - | - | -
 | CN4 | 687 118 145 22 | FFC 0.5MM R/A BOT ZIIF 18WAY | SMT | Wurth - 68711814522 | WURTH ELEKTRONIK | 68711814522 | WURTH ELEKTRONIK | - | - | - | - | - | - | - | - | - | - | - | - | -
 | CN5 | 629105150921 | Micro USB 2.0 Type AB - Horizontal - WR-COM | SMT | 629105150921 | WURTH ELEKTRONIK | 629105150921 | WURTH ELEKTRONIK | 629105150921 | - | - | - | - | - | - | - | - | - | - | - | -
 | CN6 | 629105150921 | Micro USB 2.0 Type AB - Horizontal - WR-COM | SMT | 629105150921 | WURTH ELEKTRONIK | 629105150921 | WURTH ELEKTRONIK | 629105150921 | - | - | - | - | - | - | - | - | - | - | - | -
 | CN7 | 612 020 216 21 | 2.54mm Male Box Header WR-BHD 20 pins | THT | 612 020 216 21 | WURTH ELEKTRONIK | 612 020 216 21 | Farnell | 1642021 | - | - | - | - | - | - | - | - | - | - | - | -
 | CN8 | MM70-314-310B1-1-R300 | MEM SOCKET 314POS RT ANG GOLD | SMT | MM70-314-310B1-1-R300 | JAE Electronics | MM70-314-310B1-1-R300 | DigiKey | 670-2431-1-ND | - | - | - | - | - | - | - | - | - | - | - | -
 | CN9 | FI-SE20P-HFE LVDS | FI-SE20P-HFE LVDS | SMT | FI-SE20P-HFE | JAE Electronics | FI-SE20P-HFE | DigiKey | 670-1843-ND | - | - | - | - | - | - | - | - | - | - | - | -
 | CN10 | 7499111121A | JACK MODULAR RJ45 1PORT 8P8C 10/100/1000 Base-T | THT | 7499111121A | WURTH ELEKTRONIK | 7499111121A | Farnell | 2356115 | WURTH ELEKTRONIK | 7499111121A | Digikey | 1297-1070-5-ND | - | - | - | - | - | - | - | -
 | CN11 | 685119136923 | Mini HDMI | SMT | 685119136923 | WURTH ELEKTRONIK | 685119136923 | WURTH ELEKTRONIK | 685119136923 | - | - | - | - | - | - | - | - | - | - | - | -
 | CN12 | YDJ-1134 | DC Power Connector O2.0mm | THT | YDJ-1134 | - | YDJ-1134 | Comet | YDJ-1134 | - | - | - | - | - | - | - | - | - | - | - | -
 | D1 | BAS316 - SOD323 | Diode SOD323 | SMT | BAS316 | NXP | BAS316 | Farnell | 8734275 | NXP | BAS316 | Digikey | 568-5003-1-ND | NXP | BAS316 | Future | BAS316 | - | - | - | -
 | D2 | BAS316 - SOD323 | Diode SOD323 | SMT | BAS316 | NXP | BAS316 | Farnell | 8734275 | NXP | BAS316 | Digikey | 568-5003-1-ND | NXP | BAS316 | Future | BAS316 | - | - | - | -
 | D3 | B560C-13-F | SCHOTTKY RECTIFIER 60V 5A | SMT | B560C-13-F | Diodes Incorporated | B560C-13-F | Farnell | 1858602 | Diodes Incorporated | B560C-13-F | Digikey | B560C-FDICT-ND | - | - | - | - | - | - | - | -
 | D4 | B560C-13-F | SCHOTTKY RECTIFIER 60V 5A | SMT | B560C-13-F | Diodes Incorporated | B560C-13-F | Farnell | 1858602 | Diodes Incorporated | B560C-13-F | Digikey | B560C-FDICT-ND | - | - | - | - | - | - | - | -
 | D5 | BAS316 - SOD323 | Diode SOD323 | SMT | BAS316 | NXP | BAS316 | Farnell | 8734275 | NXP | BAS316 | Digikey | 568-5003-1-ND | NXP | BAS316 | Future | BAS316 | - | - | - | -
 | D6 | VS-15MQ040NTRPBF | DIODE SCHOTTKY 3A 40V SMA | SMT | VS-15MQ040NTRPBF | VISHAY | VS-15MQ040NTRPBF | Farnell | 1463215 | VISHAY | VS-15MQ040NTRPBF | Digikey | 15MQ040NPBFCT-ND | - | - | - | - | - | - | - | -
 | D7 | BAS316 - SOD323 | Diode SOD323 | SMT | BAS316 | NXP | BAS316 | Farnell | 8734275 | NXP | BAS316 | Digikey | 568-5003-1-ND | NXP | BAS316 | Future | BAS316 | - | - | - | -
 | D8 | VS-15MQ040NTRPBF | DIODE SCHOTTKY 3A 40V SMA | SMT | VS-15MQ040NTRPBF | VISHAY | VS-15MQ040NTRPBF | Farnell | 1463215 | VISHAY | VS-15MQ040NTRPBF | Digikey | 15MQ040NPBFCT-ND | - | - | - | - | - | - | - | -
 | DL1 | LED 0603 WURTH - 150060RS75000 | LED 0603 RED 250MCD 625NM | SMT | LED 0603 RED | WURTH ELEKTRONIK | 150060RS75000 | Farnell | 2322071 | WURTH ELEKTRONIK | 150060RS75000 | Digikey | 732-4978-1-ND | - | - | - | - | - | - | - | -
 | DL2 | LED 0603 WURTH - 150060RS75000 | LED 0603 RED 250MCD 625NM | SMT | LED 0603 RED | WURTH ELEKTRONIK | 150060RS75000 | Farnell | 2322071 | WURTH ELEKTRONIK | 150060RS75000 | Digikey | 732-4978-1-ND | - | - | - | - | - | - | - | -
 | DL3 | LED 0603 WURTH - 150060GS75000 | LED 0603 GREEN 430MCD 520NM | SMT | LED 0603 GREEN | WURTH ELEKTRONIK | 150060GS75000 | Farnell | 2322070 | WURTH ELEKTRONIK | 150060GS75000 | Digikey | 732-4971-1-ND | - | - | - | - | - | - | - | -
 | DL4 | LED 0603 WURTH - 150060GS75000 | LED 0603 GREEN 430MCD 520NM | SMT | LED 0603 GREEN | WURTH ELEKTRONIK | 150060GS75000 | Farnell | 2322070 | WURTH ELEKTRONIK | 150060GS75000 | Digikey | 732-4971-1-ND | - | - | - | - | - | - | - | -
 | DL5 | LED 0603 WURTH - 150060RS75000 | LED 0603 RED 250MCD 625NM | SMT | LED 0603 RED | WURTH ELEKTRONIK | 150060RS75000 | Farnell | 2322071 | WURTH ELEKTRONIK | 150060RS75000 | Digikey | 732-4978-1-ND | - | - | - | - | - | - | - | -
 | DL6 | LED 0603 WURTH - 150060RS75000 | LED 0603 RED 250MCD 625NM | SMT | LED 0603 RED | WURTH ELEKTRONIK | 150060RS75000 | Farnell | 2322071 | WURTH ELEKTRONIK | 150060RS75000 | Digikey | 732-4978-1-ND | - | - | - | - | - | - | - | -
 | DL7 | LED 0603 WURTH - 150060GS75000 | LED 0603 GREEN 430MCD 520NM | SMT | LED 0603 GREEN | WURTH ELEKTRONIK | 150060GS75000 | Farnell | 2322070 | WURTH ELEKTRONIK | 150060GS75000 | Digikey | 732-4971-1-ND | - | - | - | - | - | - | - | -
 | DL8 | LED 0603 WURTH - 150060RS75000 | LED 0603 RED 250MCD 625NM | SMT | LED 0603 RED | WURTH ELEKTRONIK | 150060RS75000 | Farnell | 2322071 | WURTH ELEKTRONIK | 150060RS75000 | Digikey | 732-4978-1-ND | - | - | - | - | - | - | - | -
 | DL9 | LED 0603 WURTH - 150060GS75000 | LED 0603 GREEN 430MCD 520NM | SMT | LED 0603 GREEN | WURTH ELEKTRONIK | 150060GS75000 | Farnell | 2322070 | WURTH ELEKTRONIK | 150060GS75000 | Digikey | 732-4971-1-ND | - | - | - | - | - | - | - | -
 | DL10 | LED 0603 WURTH - 150060RS75000 | LED 0603 RED 250MCD 625NM | SMT | LED 0603 RED | WURTH ELEKTRONIK | 150060RS75000 | Farnell | 2322071 | WURTH ELEKTRONIK | 150060RS75000 | Digikey | 732-4978-1-ND | - | - | - | - | - | - | - | -
 | DL11 | LED 0603 WURTH - 150060RS75000 | LED 0603 RED 250MCD 625NM | SMT | LED 0603 RED | WURTH ELEKTRONIK | 150060RS75000 | Farnell | 2322071 | WURTH ELEKTRONIK | 150060RS75000 | Digikey | 732-4978-1-ND | - | - | - | - | - | - | - | -
 | DL12 | LED 0603 WURTH - 150060RS75000 | LED 0603 RED 250MCD 625NM | SMT | LED 0603 RED | WURTH ELEKTRONIK | 150060RS75000 | Farnell | 2322071 | WURTH ELEKTRONIK | 150060RS75000 | Digikey | 732-4978-1-ND | - | - | - | - | - | - | - | -
 | DZ1 | BZX384-B3V3 | DIODE ZENER 300MW 3V3 5% SOD323 | SMT | BZX384-B3V3 | NXP | BZX384-C3V3 | Farnell | 8735646 | NXP | BZX384-B3V3 | DIGIKEY | 568-3826-1-ND | - | - | - | - | - | - | - | -
 | DZ2 | BZX384-B16 | DIODE ZENER 300MW 16V 5% SOD323 | SMT | BZX384-B16 | NXP | BZX384-B16 | Farnell | 1757828 | NXP | BZX384-B16 | Digikey | 568-3813-1-ND | - | - | - | - | - | - | - | -
 | DZ3 | BZV55-C18 | DIODE ZENER 500MW 18V 5% SOD80 | SMT | BZV55-C18 | NXP | BZV55-C18 | Farnell | 1097211 | - | - | Comet | BZV55C18 | - | - | - | - | - | - | - | -
 | FB1 | FB - WURTH - 742792093 | FERRITE BEAD 0805 0.6OHM 0.2A | SMT | 742792093 | WURTH ELECRONICS | 742792093 | Farnell | 1635726 | WURTH ELECRONICS | 742792093 | Digikey | 732-1609-1-ND | - | - | - | - | - | - | - | -
 | FB2 | FB - WURTH - 742792093 | FERRITE BEAD 0805 0.6OHM 0.2A | SMT | 742792093 | WURTH ELECRONICS | 742792093 | Farnell | 1635726 | WURTH ELECRONICS | 742792093 | Digikey | 732-1609-1-ND | - | - | - | - | - | - | - | -
 | H1 | USD CARD HOLDER / 693072010801 WURTH | Micro SD Connector Hinge Type | SMT | 693072010801 | WURTH ELEKTRONIK | 693072010801 | Farnell | 2081364 | - | - | - | - | - | - | - | - | - | - | - | -
 | J1 | HEADER 2X1/100/0GR | Header 1Row 2.54mm S 2 pins | THT | Header 2x1/100/0gr | MULTICOMP | 2211S-02G | Farnell | 1593411 | Sullins Connector Solutions | PTC02SAAN | DigiKey | S1012-02-ND | Cvilux | CH31022V200 | Comet | HN1X2 | - | - | - | -
 | J3 | HEADER 2X1/100/0GR | Header 1Row 2.54mm S 2 pins | THT | Header 2x1/100/0gr | MULTICOMP | 2211S-02G | Farnell | 1593411 | Sullins Connector Solutions | PTC02SAAN | DigiKey | S1012-02-ND | Cvilux | CH31022V200 | Comet | HN1X2 | - | - | - | -
 | J4 | Header 4x1/100/0gr | Header 1Row 2.54mm S 4 pins | THT | Header 4x1/100/0gr | MULTICOMP | 2211S-04G | Farnell | 1593413 | - | - | - | - | - | - | - | - | Cvilux | CH31162V200 | Comet | HN1X16
NA | J5 | HEADER 7X1/100/0GR | Header 1Row 2.54mm S | THT | Header 7x1/100/0gr | - | - | - | - | - | - | - | - | - | - | - | - | - | - | - | -
NA | J6 | HEADER 8X1/100/0GR | Header 1Row 2.54mm S 8pos | THT | HEADER 8x1/100/0gr | TE CONNECTIVITY / AMP | 826629-8 | Farnell | 3418364 | 3M | 961108-6404-AR | DigiKey | 3M9452-ND | Cvilux | CH31402V200 | Comet 1/5 | HN1X40 | - | - | - | -
NA | J7 | HEADER 10x1/100/0gr | - | THT | HEADER 10x1/100/0gr | MULTICOMP | 2211S-10G | Farnell | 1593417 | Sullins Connector Solutions | PTC10SAAN | DigiKey | S1012-10-ND | - | - | - | - | - | - | - | -
NA | J8 | Header 4x1/100/0gr | Header 1Row 2.54mm S 4 pins | THT | Header 4x1/100/0gr | MULTICOMP | 2211S-04G | Farnell | 1593413 | - | - | - | - | - | - | - | - | Cvilux | CH31162V200 | Comet | HN1X16
NA | J9 | HEADER 10x1/100/0gr | - | THT | HEADER 10x1/100/0gr | MULTICOMP | 2211S-10G | Farnell | 1593417 | Sullins Connector Solutions | PTC10SAAN | DigiKey | S1012-10-ND | - | - | - | - | - | - | - | -
NA | J10 | Header 4x1/100/0gr | Header 1Row 2.54mm S 4 pins | THT | Header 4x1/100/0gr | MULTICOMP | 2211S-04G | Farnell | 1593413 | - | - | - | - | - | - | - | - | Cvilux | CH31162V200 | Comet | HN1X16
 | J11 | Header 3x2/100/0gr | Header 2Rows 2.54mm S | THT | Header 3x2/100/0gr | MULTICOMP | 2213S-06G | Farnell | 1593440 | - | - | - | - | - | - | - | - | - | - | - | -
 | J12 | HEADER 3X1/100/0GR | Header 1Row 2.54mm S | THT | Header 3x1/100/0gr | Cvilux | CH31402V200 | Comet 1/13 | HN1X40 | HARWIN | M20-9990345 | Farnell | 1022248 | Sullins Connector Solutions | PTC03SAAN | DigiKey | S1012-03-ND | - | - | - | -
 | J13 | HEADER 3X1/100/0GR | Header 1Row 2.54mm S | THT | Header 3x1/100/0gr | Cvilux | CH31402V200 | Comet 1/13 | HN1X40 | HARWIN | M20-9990345 | Farnell | 1022248 | Sullins Connector Solutions | PTC03SAAN | DigiKey | S1012-03-ND | - | - | - | -
 | J14 | HEADER 3X1/100/0GR | Header 1Row 2.54mm S | THT | Header 3x1/100/0gr | Cvilux | CH31402V200 | Comet 1/13 | HN1X40 | HARWIN | M20-9990345 | Farnell | 1022248 | Sullins Connector Solutions | PTC03SAAN | DigiKey | S1012-03-ND | - | - | - | -
 | J15 | HEADER 3X1/100/0GR | Header 1Row 2.54mm S | THT | Header 3x1/100/0gr | Cvilux | CH31402V200 | Comet 1/13 | HN1X40 | HARWIN | M20-9990345 | Farnell | 1022248 | Sullins Connector Solutions | PTC03SAAN | DigiKey | S1012-03-ND | - | - | - | -
 | J16 | HEADER 3X1/100/0GR | Header 1Row 2.54mm S | THT | Header 3x1/100/0gr | Cvilux | CH31402V200 | Comet 1/13 | HN1X40 | HARWIN | M20-9990345 | Farnell | 1022248 | Sullins Connector Solutions | PTC03SAAN | DigiKey | S1012-03-ND | - | - | - | -
 | J17 | HEADER 3X1/100/0GR | Header 1Row 2.54mm S | THT | Header 3x1/100/0gr | Cvilux | CH31402V200 | Comet 1/13 | HN1X40 | HARWIN | M20-9990345 | Farnell | 1022248 | Sullins Connector Solutions | PTC03SAAN | DigiKey | S1012-03-ND | - | - | - | -
 | J18 | HEADER 3X1/100/0GR | Header 1Row 2.54mm S | THT | Header 3x1/100/0gr | Cvilux | CH31402V200 | Comet 1/13 | HN1X40 | HARWIN | M20-9990345 | Farnell | 1022248 | Sullins Connector Solutions | PTC03SAAN | DigiKey | S1012-03-ND | - | - | - | -
 | J19 | HEADER 3X1/100/0GR | Header 1Row 2.54mm S | THT | Header 3x1/100/0gr | Cvilux | CH31402V200 | Comet 1/13 | HN1X40 | HARWIN | M20-9990345 | Farnell | 1022248 | Sullins Connector Solutions | PTC03SAAN | DigiKey | S1012-03-ND | - | - | - | -
 | J20 | HEADER 2X1/100/0GR | Header 1Row 2.54mm S 2 pins | THT | Header 2x1/100/0gr | MULTICOMP | 2211S-02G | Farnell | 1593411 | Sullins Connector Solutions | PTC02SAAN | DigiKey | S1012-02-ND | Cvilux | CH31022V200 | Comet | HN1X2 | - | - | - | -
 | J21 | HEADER 2X1/100/0GR | Header 1Row 2.54mm S 2 pins | THT | Header 2x1/100/0gr | MULTICOMP | 2211S-02G | Farnell | 1593411 | Sullins Connector Solutions | PTC02SAAN | DigiKey | S1012-02-ND | Cvilux | CH31022V200 | Comet | HN1X2 | - | - | - | -
 | J22 | HEADER 2X1/100/0GR | Header 1Row 2.54mm S 2 pins | THT | Header 2x1/100/0gr | MULTICOMP | 2211S-02G | Farnell | 1593411 | Sullins Connector Solutions | PTC02SAAN | DigiKey | S1012-02-ND | Cvilux | CH31022V200 | Comet | HN1X2 | - | - | - | -
 | J23 | HEADER 2X1/100/0GR | Header 1Row 2.54mm S 2 pins | THT | Header 2x1/100/0gr | MULTICOMP | 2211S-02G | Farnell | 1593411 | Sullins Connector Solutions | PTC02SAAN | DigiKey | S1012-02-ND | Cvilux | CH31022V200 | Comet | HN1X2 | - | - | - | -
 | J24 | HEADER 2X1/100/0GR | Header 1Row 2.54mm S 2 pins | THT | Header 2x1/100/0gr | MULTICOMP | 2211S-02G | Farnell | 1593411 | Sullins Connector Solutions | PTC02SAAN | DigiKey | S1012-02-ND | Cvilux | CH31022V200 | Comet | HN1X2 | - | - | - | -
 | L1 | BLM18EG101TN1D | FERRITE BEAD 0.045OHM 2A 0603 | SMT | BLM18EG101TN1D | MURATA | BLM18EG101TN1D | Farnell | 1515714 | MURATA | BLM18EG101TN1D | Digikey | 490-5978-1-ND | - | - | - | - | - | - | - | -
 | L2 | BLM18EG101TN1D | FERRITE BEAD 0.045OHM 2A 0603 | SMT | BLM18EG101TN1D | MURATA | BLM18EG101TN1D | Farnell | 1515714 | MURATA | BLM18EG101TN1D | Digikey | 490-5978-1-ND | - | - | - | - | - | - | - | -
 | L3 | BLM18EG101TN1D | FERRITE BEAD 0.045OHM 2A 0603 | SMT | BLM18EG101TN1D | MURATA | BLM18EG101TN1D | Farnell | 1515714 | MURATA | BLM18EG101TN1D | Digikey | 490-5978-1-ND | - | - | - | - | - | - | - | -
 | L4 | BLM18EG101TN1D | FERRITE BEAD 0.045OHM 2A 0603 | SMT | BLM18EG101TN1D | MURATA | BLM18EG101TN1D | Farnell | 1515714 | MURATA | BLM18EG101TN1D | Digikey | 490-5978-1-ND | - | - | - | - | - | - | - | -
 | L5 | FB 0.1R_DC/60R_100MHZ/300MA | FERRITE BEAD 0.1ohm/dc 60ohm/100MHz 300MA 0603 | SMT | 60ohm/100MHz/300mA | FERROXCUBE | MLS0603-4S7-600 | Farnell | 3056491 | - | - | - | - | - | - | - | - | - | - | - | -
 | L6 | L 3u3/4A6 - 7447713033 | INDUCTOR POWER 3.3UH 4.6A SMD | SMT | 3u3/4A6 | WURTH ELEKTRONIK | 7447713033 | Farnell | 2082660 | WURTH ELEKTRONIK | 7447713033 | Digikey | 732-2974-1-ND | - | - | - | - | - | - | - | -
 | L7 | L 3u3/4A6 - 7447713033 | INDUCTOR POWER 3.3UH 4.6A SMD | SMT | 3u3/4A6 | WURTH ELEKTRONIK | 7447713033 | Farnell | 2082660 | WURTH ELEKTRONIK | 7447713033 | Digikey | 732-2974-1-ND | - | - | - | - | - | - | - | -
 | Q1 | BSS138PW | MOSFET N CH 60V 0.32A SOT323 | SMT | BSS138PW | NXP | BSS138PW | Farnell | 1907611 | NXP | BSS138PW | Digikey | 568-10309-1-ND | - | - | - | - | - | - | - | -
 | Q2 | BSS138PW | MOSFET N CH 60V 0.32A SOT323 | SMT | BSS138PW | NXP | BSS138PW | Farnell | 1907611 | NXP | BSS138PW | Digikey | 568-10309-1-ND | - | - | - | - | - | - | - | -
 | Q3 | BSS138PW | MOSFET N CH 60V 0.32A SOT323 | SMT | BSS138PW | NXP | BSS138PW | Farnell | 1907611 | NXP | BSS138PW | Digikey | 568-10309-1-ND | - | - | - | - | - | - | - | -
 | Q4 | BSS138PW | MOSFET N CH 60V 0.32A SOT323 | SMT | BSS138PW | NXP | BSS138PW | Farnell | 1907611 | NXP | BSS138PW | Digikey | 568-10309-1-ND | - | - | - | - | - | - | - | -
 | Q5 | IRLML6402TRPBF | P MOS 20V 3.7A 1.3W 0.065Ohm/4.5V | SMT | IRLML6402TRPBF | INTERNATIONAL RECTIFIER | IRLML6402TRPBF | COMET | IRLML6402 | - | - | - | - | - | - | - | - | - | - | - | -
 | Q6 | BSS138PW | MOSFET N CH 60V 0.32A SOT323 | SMT | BSS138PW | NXP | BSS138PW | Farnell | 1907611 | NXP | BSS138PW | Digikey | 568-10309-1-ND | - | - | - | - | - | - | - | -
 | Q7 | BSS806N | MOSFET N-CH 20V 2.3A SOT23 | SMT | BSS806N | Infineon Technologies | BSS806N H6327 | Farnell | 2443469 | Infineon Technologies | BSS806N H6327 | Digikey | BSS806N H6327CT-ND | Infineon Technologies | BSS806NH6327XT | Mouser | 726-BSS806NH6327XTSA | - | - | - | -
 | Q8 | FDMA530PZ | MOSFET P-CH 30V 6.8A MLP2X2 | SMT | FDMA530PZ | Fairchild Semiconductor | FDMA530PZ | Farnell | 1495165 | Fairchild Semiconductor | FDMA530PZ | Digikey | FDMA530PZCT-ND | - | - | - | - | - | - | - | -
 | Q9 | AP6681GMT-HF-3TR | PMOS 30V 135A 83.3W 3.1mOhm/10V 4.6mOhm/4.5V PMPAK 5x6 | SMT | AP6681GMT-HF-3TR | APEC | AP6681GMT-HF-3TR | COMET | AP6681GMT | - | - | - | - | - | - | - | - | - | - | - | -
 | R1 | R0603-5% 10K | Chip Resistor 5% 0603 10k | SMT | 10k | MULTICOMP | MC 0.063W 0603 5% 10K | Farnell | 9331700 | Panasonic Electronic Components | ERJ-3GEYJ103V | DigiKey | P10KGCT-ND | YAGEO | RC0603JR-0710KL | Future | RC0603JR-0710KL | - | - | - | -
 | R2 | R0603-5% 620R | Chip Resistor 5% 0603 | SMT | 620R | VISHAY DRALORIC | CRCW0603620RFKEA | Farnell | 2141352 | - | - | - | - | - | - | - | - | - | - | - | -
 | R3 | R0603-5% 10K | Chip Resistor 5% 0603 10k | SMT | 10k | MULTICOMP | MC 0.063W 0603 5% 10K | Farnell | 9331700 | Panasonic Electronic Components | ERJ-3GEYJ103V | DigiKey | P10KGCT-ND | YAGEO | RC0603JR-0710KL | Future | RC0603JR-0710KL | - | - | - | -
 | R4 | R0603-5% 10K | Chip Resistor 5% 0603 10k | SMT | 10k | MULTICOMP | MC 0.063W 0603 5% 10K | Farnell | 9331700 | Panasonic Electronic Components | ERJ-3GEYJ103V | DigiKey | P10KGCT-ND | YAGEO | RC0603JR-0710KL | Future | RC0603JR-0710KL | - | - | - | -
 | R5 | R0603-5% 22R | Chip Resistor 5% 0603 22R | SMT | 22R | MULTICOMP | MC 0.063W 0603 5% 22R | Farnell | 9331891 | Stackpole Electronics Inc | RMCF0603JT22R0 | Digikey | RMCF0603JT22R0CT-ND | YAGEO | RC0603JR-0722RL | Future | RC0603JR-0722RL | Uni ohm | 0603SAJ0220T50 | Comet | R0603 22R 5%
 | R6 | R0603-5% 10K | Chip Resistor 5% 0603 10k | SMT | 10k | MULTICOMP | MC 0.063W 0603 5% 10K | Farnell | 9331700 | Panasonic Electronic Components | ERJ-3GEYJ103V | DigiKey | P10KGCT-ND | YAGEO | RC0603JR-0710KL | Future | RC0603JR-0710KL | - | - | - | -
 | R7 | R0603-5% 10K | Chip Resistor 5% 0603 10k | SMT | 10k | MULTICOMP | MC 0.063W 0603 5% 10K | Farnell | 9331700 | Panasonic Electronic Components | ERJ-3GEYJ103V | DigiKey | P10KGCT-ND | YAGEO | RC0603JR-0710KL | Future | RC0603JR-0710KL | - | - | - | -
 | R8 | R0603-5% 10K | Chip Resistor 5% 0603 10k | SMT | 10k | MULTICOMP | MC 0.063W 0603 5% 10K | Farnell | 9331700 | Panasonic Electronic Components | ERJ-3GEYJ103V | DigiKey | P10KGCT-ND | YAGEO | RC0603JR-0710KL | Future | RC0603JR-0710KL | - | - | - | -
 | R9 | R0603-5% 10K | Chip Resistor 5% 0603 10k | SMT | 10k | MULTICOMP | MC 0.063W 0603 5% 10K | Farnell | 9331700 | Panasonic Electronic Components | ERJ-3GEYJ103V | DigiKey | P10KGCT-ND | YAGEO | RC0603JR-0710KL | Future | RC0603JR-0710KL | - | - | - | -
 | R10 | R0603-5% 10K | Chip Resistor 5% 0603 10k | SMT | 10k | MULTICOMP | MC 0.063W 0603 5% 10K | Farnell | 9331700 | Panasonic Electronic Components | ERJ-3GEYJ103V | DigiKey | P10KGCT-ND | YAGEO | RC0603JR-0710KL | Future | RC0603JR-0710KL | - | - | - | -
 | R11 | R0603-5% 10K | Chip Resistor 5% 0603 10k | SMT | 10k | MULTICOMP | MC 0.063W 0603 5% 10K | Farnell | 9331700 | Panasonic Electronic Components | ERJ-3GEYJ103V | DigiKey | P10KGCT-ND | YAGEO | RC0603JR-0710KL | Future | RC0603JR-0710KL | - | - | - | -
 | R12 | R0603-5% 270R | Chip Resistor 5% 0603 270R | SMT | 270R | MULTICOMP | MC 0.063W 0603 1% 270R | Farnell | 9330917 | YAG/ASJ | R0603 270R 5% YAG/ASJ | Comet | R0603 270R 5% YAG/ASJ | - | - | - | - | - | - | - | -
 | R13 | R0603-5% 270R | Chip Resistor 5% 0603 270R | SMT | 270R | MULTICOMP | MC 0.063W 0603 1% 270R | Farnell | 9330917 | YAG/ASJ | R0603 270R 5% YAG/ASJ | Comet | R0603 270R 5% YAG/ASJ | - | - | - | - | - | - | - | -
NA | R14 | R0603-5% 0R | Chip Resistor 5% 0603 0R | SMT | 0R | VISHAY DRALORIC | CRCW06030000Z0EA | Farnell | 1469739 | Panasonic - ECG | ERJ-3GEY0R00V | Digikey | P0.0GCT-ND | YAGEO | RC0603JR-070RL | Future | RC0603JR-070RL | Uni ohm | 0603SAJ000JT50 | Comet | R0603 0R 5%
 | R15 | R0603-5% 620R | Chip Resistor 5% 0603 | SMT | 620R | VISHAY DRALORIC | CRCW0603620RFKEA | Farnell | 2141352 | - | - | - | - | - | - | - | - | - | - | - | -
 | R16 | R0603-5% 330R | Chip Resistor 5% 0603 330R | SMT | 330R | MULTICOMP | MC 0.063W 0603 5% 330R | Farnell | 9332014 | Panasonic Electronic Components | ERJ-3GEYJ331V | DigiKey | P330GCT-ND | ROHM | MCR03EZHJ331 | Future | MCR03EZHJ331 | - | - | - | -
 | R17 | R0603-5% 10K | Chip Resistor 5% 0603 10k | SMT | 10k | MULTICOMP | MC 0.063W 0603 5% 10K | Farnell | 9331700 | Panasonic Electronic Components | ERJ-3GEYJ103V | DigiKey | P10KGCT-ND | YAGEO | RC0603JR-0710KL | Future | RC0603JR-0710KL | - | - | - | -
 | R18 | R0603-5% 47K | Chip Resistor 5% 0603 47k | SMT | 47k | MULTICOMP | MC 0.063W 0603 5% 47K | Farnell | 9332162 | Stackpole Electronics Inc | RMCF0603JT47K0 | Digikey | RMCF0603JT47K0CT-ND | YAGEO | RC0603JR-0747KL | Future | RC0603JR-0747KL | Uni ohm | 0603SAJ0473T50 | Comet | R0603 47K 5%
 | R19 | R0603-5% 10K | Chip Resistor 5% 0603 10k | SMT | 10k | MULTICOMP | MC 0.063W 0603 5% 10K | Farnell | 9331700 | Panasonic Electronic Components | ERJ-3GEYJ103V | DigiKey | P10KGCT-ND | YAGEO | RC0603JR-0710KL | Future | RC0603JR-0710KL | - | - | - | -
 | R20 | R0603-5% 100R | Chip Resistor 5% 0603 100R | SMT | 100R | MULTICOMP | MC 0.063W 0603 5% 100R | Farnell | 9331689 | Yageo | RC0603FR-07100RL | Digikey | 311-100HRCT-ND | YAGEO | RC0603JR-07100RL | Future | RC0603JR-07100RL | - | - | - | -
 | R21 | R0603-5% 10K | Chip Resistor 5% 0603 10k | SMT | 10k | MULTICOMP | MC 0.063W 0603 5% 10K | Farnell | 9331700 | Panasonic Electronic Components | ERJ-3GEYJ103V | DigiKey | P10KGCT-ND | YAGEO | RC0603JR-0710KL | Future | RC0603JR-0710KL | - | - | - | -
 | R22 | R0603-5% 10K | Chip Resistor 5% 0603 10k | SMT | 10k | MULTICOMP | MC 0.063W 0603 5% 10K | Farnell | 9331700 | Panasonic Electronic Components | ERJ-3GEYJ103V | DigiKey | P10KGCT-ND | YAGEO | RC0603JR-0710KL | Future | RC0603JR-0710KL | - | - | - | -
 | R23 | R0603-5% 270R | Chip Resistor 5% 0603 270R | SMT | 270R | MULTICOMP | MC 0.063W 0603 1% 270R | Farnell | 9330917 | YAG/ASJ | R0603 270R 5% YAG/ASJ | Comet | R0603 270R 5% YAG/ASJ | - | - | - | - | - | - | - | -
 | R24 | R0603-5% 270R | Chip Resistor 5% 0603 270R | SMT | 270R | MULTICOMP | MC 0.063W 0603 1% 270R | Farnell | 9330917 | YAG/ASJ | R0603 270R 5% YAG/ASJ | Comet | R0603 270R 5% YAG/ASJ | - | - | - | - | - | - | - | -
 | R25 | R0603-5% 22R | Chip Resistor 5% 0603 22R | SMT | 22R | MULTICOMP | MC 0.063W 0603 5% 22R | Farnell | 9331891 | Stackpole Electronics Inc | RMCF0603JT22R0 | Digikey | RMCF0603JT22R0CT-ND | YAGEO | RC0603JR-0722RL | Future | RC0603JR-0722RL | Uni ohm | 0603SAJ0220T50 | Comet | R0603 22R 5%
 | R26 | R0603-5% 22R | Chip Resistor 5% 0603 22R | SMT | 22R | MULTICOMP | MC 0.063W 0603 5% 22R | Farnell | 9331891 | Stackpole Electronics Inc | RMCF0603JT22R0 | Digikey | RMCF0603JT22R0CT-ND | YAGEO | RC0603JR-0722RL | Future | RC0603JR-0722RL | Uni ohm | 0603SAJ0220T50 | Comet | R0603 22R 5%
 | R27 | R0603-5% 100R | Chip Resistor 5% 0603 100R | SMT | 100R | MULTICOMP | MC 0.063W 0603 5% 100R | Farnell | 9331689 | Yageo | RC0603FR-07100RL | Digikey | 311-100HRCT-ND | YAGEO | RC0603JR-07100RL | Future | RC0603JR-07100RL | - | - | - | -
 | R28 | R0603-5% 10K | Chip Resistor 5% 0603 10k | SMT | 10k | MULTICOMP | MC 0.063W 0603 5% 10K | Farnell | 9331700 | Panasonic Electronic Components | ERJ-3GEYJ103V | DigiKey | P10KGCT-ND | YAGEO | RC0603JR-0710KL | Future | RC0603JR-0710KL | - | - | - | -
NA | R29 | R0603-5% 10K | Chip Resistor 5% 0603 10k | SMT | 10k | MULTICOMP | MC 0.063W 0603 5% 10K | Farnell | 9331700 | Panasonic Electronic Components | ERJ-3GEYJ103V | DigiKey | P10KGCT-ND | YAGEO | RC0603JR-0710KL | Future | RC0603JR-0710KL | - | - | - | -
 | R30 | R0603-5% 620R | Chip Resistor 5% 0603 | SMT | 620R | VISHAY DRALORIC | CRCW0603620RFKEA | Farnell | 2141352 | - | - | - | - | - | - | - | - | - | - | - | -
 | R31 | R0603-5% 330R | Chip Resistor 5% 0603 330R | SMT | 330R | MULTICOMP | MC 0.063W 0603 5% 330R | Farnell | 9332014 | Panasonic Electronic Components | ERJ-3GEYJ331V | DigiKey | P330GCT-ND | ROHM | MCR03EZHJ331 | Future | MCR03EZHJ331 | - | - | - | -
 | R32 | R0603-5% 22R | Chip Resistor 5% 0603 22R | SMT | 22R | MULTICOMP | MC 0.063W 0603 5% 22R | Farnell | 9331891 | Stackpole Electronics Inc | RMCF0603JT22R0 | Digikey | RMCF0603JT22R0CT-ND | YAGEO | RC0603JR-0722RL | Future | RC0603JR-0722RL | Uni ohm | 0603SAJ0220T50 | Comet | R0603 22R 5%
 | R33 | R0603-5% 10K | Chip Resistor 5% 0603 10k | SMT | 10k | MULTICOMP | MC 0.063W 0603 5% 10K | Farnell | 9331700 | Panasonic Electronic Components | ERJ-3GEYJ103V | DigiKey | P10KGCT-ND | YAGEO | RC0603JR-0710KL | Future | RC0603JR-0710KL | - | - | - | -
 | R34 | R0603-5% 47K | Chip Resistor 5% 0603 47k | SMT | 47k | MULTICOMP | MC 0.063W 0603 5% 47K | Farnell | 9332162 | Stackpole Electronics Inc | RMCF0603JT47K0 | Digikey | RMCF0603JT47K0CT-ND | YAGEO | RC0603JR-0747KL | Future | RC0603JR-0747KL | Uni ohm | 0603SAJ0473T50 | Comet | R0603 47K 5%
 | R35 | R0603-5% 22R | Chip Resistor 5% 0603 22R | SMT | 22R | MULTICOMP | MC 0.063W 0603 5% 22R | Farnell | 9331891 | Stackpole Electronics Inc | RMCF0603JT22R0 | Digikey | RMCF0603JT22R0CT-ND | YAGEO | RC0603JR-0722RL | Future | RC0603JR-0722RL | Uni ohm | 0603SAJ0220T50 | Comet | R0603 22R 5%
 | R36 | R0603-5% 22R | Chip Resistor 5% 0603 22R | SMT | 22R | MULTICOMP | MC 0.063W 0603 5% 22R | Farnell | 9331891 | Stackpole Electronics Inc | RMCF0603JT22R0 | Digikey | RMCF0603JT22R0CT-ND | YAGEO | RC0603JR-0722RL | Future | RC0603JR-0722RL | Uni ohm | 0603SAJ0220T50 | Comet | R0603 22R 5%
 | R37 | R0603-5% 22R | Chip Resistor 5% 0603 22R | SMT | 22R | MULTICOMP | MC 0.063W 0603 5% 22R | Farnell | 9331891 | Stackpole Electronics Inc | RMCF0603JT22R0 | Digikey | RMCF0603JT22R0CT-ND | YAGEO | RC0603JR-0722RL | Future | RC0603JR-0722RL | Uni ohm | 0603SAJ0220T50 | Comet | R0603 22R 5%
 | R38 | R0603-5% 22R | Chip Resistor 5% 0603 22R | SMT | 22R | MULTICOMP | MC 0.063W 0603 5% 22R | Farnell | 9331891 | Stackpole Electronics Inc | RMCF0603JT22R0 | Digikey | RMCF0603JT22R0CT-ND | YAGEO | RC0603JR-0722RL | Future | RC0603JR-0722RL | Uni ohm | 0603SAJ0220T50 | Comet | R0603 22R 5%
 | R39 | R0603-5% 22R | Chip Resistor 5% 0603 22R | SMT | 22R | MULTICOMP | MC 0.063W 0603 5% 22R | Farnell | 9331891 | Stackpole Electronics Inc | RMCF0603JT22R0 | Digikey | RMCF0603JT22R0CT-ND | YAGEO | RC0603JR-0722RL | Future | RC0603JR-0722RL | Uni ohm | 0603SAJ0220T50 | Comet | R0603 22R 5%
NA | R40 | R0603-5% 0R | Chip Resistor 5% 0603 0R | SMT | 0R | VISHAY DRALORIC | CRCW06030000Z0EA | Farnell | 1469739 | Panasonic - ECG | ERJ-3GEY0R00V | Digikey | P0.0GCT-ND | YAGEO | RC0603JR-070RL | Future | RC0603JR-070RL | Uni ohm | 0603SAJ000JT50 | Comet | R0603 0R 5%
 | R41 | R0603-5% 10K | Chip Resistor 5% 0603 10k | SMT | 10k | MULTICOMP | MC 0.063W 0603 5% 10K | Farnell | 9331700 | Panasonic Electronic Components | ERJ-3GEYJ103V | DigiKey | P10KGCT-ND | YAGEO | RC0603JR-0710KL | Future | RC0603JR-0710KL | - | - | - | -
 | R42 | R0603-5% 10K | Chip Resistor 5% 0603 10k | SMT | 10k | MULTICOMP | MC 0.063W 0603 5% 10K | Farnell | 9331700 | Panasonic Electronic Components | ERJ-3GEYJ103V | DigiKey | P10KGCT-ND | YAGEO | RC0603JR-0710KL | Future | RC0603JR-0710KL | - | - | - | -
 | R43 | R0603-5% 10K | Chip Resistor 5% 0603 10k | SMT | 10k | MULTICOMP | MC 0.063W 0603 5% 10K | Farnell | 9331700 | Panasonic Electronic Components | ERJ-3GEYJ103V | DigiKey | P10KGCT-ND | YAGEO | RC0603JR-0710KL | Future | RC0603JR-0710KL | - | - | - | -
 | R44 | R0603-5% 10K | Chip Resistor 5% 0603 10k | SMT | 10k | MULTICOMP | MC 0.063W 0603 5% 10K | Farnell | 9331700 | Panasonic Electronic Components | ERJ-3GEYJ103V | DigiKey | P10KGCT-ND | YAGEO | RC0603JR-0710KL | Future | RC0603JR-0710KL | - | - | - | -
 | R45 | R0603-5% 10K | Chip Resistor 5% 0603 10k | SMT | 10k | MULTICOMP | MC 0.063W 0603 5% 10K | Farnell | 9331700 | Panasonic Electronic Components | ERJ-3GEYJ103V | DigiKey | P10KGCT-ND | YAGEO | RC0603JR-0710KL | Future | RC0603JR-0710KL | - | - | - | -
 | R46 | R0603-5% 10K | Chip Resistor 5% 0603 10k | SMT | 10k | MULTICOMP | MC 0.063W 0603 5% 10K | Farnell | 9331700 | Panasonic Electronic Components | ERJ-3GEYJ103V | DigiKey | P10KGCT-ND | YAGEO | RC0603JR-0710KL | Future | RC0603JR-0710KL | - | - | - | -
 | R47 | R0603-5% 22R | Chip Resistor 5% 0603 22R | SMT | 22R | MULTICOMP | MC 0.063W 0603 5% 22R | Farnell | 9331891 | Stackpole Electronics Inc | RMCF0603JT22R0 | Digikey | RMCF0603JT22R0CT-ND | YAGEO | RC0603JR-0722RL | Future | RC0603JR-0722RL | Uni ohm | 0603SAJ0220T50 | Comet | R0603 22R 5%
 | R48 | R0603-5% 22R | Chip Resistor 5% 0603 22R | SMT | 22R | MULTICOMP | MC 0.063W 0603 5% 22R | Farnell | 9331891 | Stackpole Electronics Inc | RMCF0603JT22R0 | Digikey | RMCF0603JT22R0CT-ND | YAGEO | RC0603JR-0722RL | Future | RC0603JR-0722RL | Uni ohm | 0603SAJ0220T50 | Comet | R0603 22R 5%
 | R49 | R0603-5% 22R | Chip Resistor 5% 0603 22R | SMT | 22R | MULTICOMP | MC 0.063W 0603 5% 22R | Farnell | 9331891 | Stackpole Electronics Inc | RMCF0603JT22R0 | Digikey | RMCF0603JT22R0CT-ND | YAGEO | RC0603JR-0722RL | Future | RC0603JR-0722RL | Uni ohm | 0603SAJ0220T50 | Comet | R0603 22R 5%
 | R50 | R0603-5% 22R | Chip Resistor 5% 0603 22R | SMT | 22R | MULTICOMP | MC 0.063W 0603 5% 22R | Farnell | 9331891 | Stackpole Electronics Inc | RMCF0603JT22R0 | Digikey | RMCF0603JT22R0CT-ND | YAGEO | RC0603JR-0722RL | Future | RC0603JR-0722RL | Uni ohm | 0603SAJ0220T50 | Comet | R0603 22R 5%
 | R51 | R0603-5% 22R | Chip Resistor 5% 0603 22R | SMT | 22R | MULTICOMP | MC 0.063W 0603 5% 22R | Farnell | 9331891 | Stackpole Electronics Inc | RMCF0603JT22R0 | Digikey | RMCF0603JT22R0CT-ND | YAGEO | RC0603JR-0722RL | Future | RC0603JR-0722RL | Uni ohm | 0603SAJ0220T50 | Comet | R0603 22R 5%
 | R52 | R0603-5% 22R | Chip Resistor 5% 0603 22R | SMT | 22R | MULTICOMP | MC 0.063W 0603 5% 22R | Farnell | 9331891 | Stackpole Electronics Inc | RMCF0603JT22R0 | Digikey | RMCF0603JT22R0CT-ND | YAGEO | RC0603JR-0722RL | Future | RC0603JR-0722RL | Uni ohm | 0603SAJ0220T50 | Comet | R0603 22R 5%
 | R53 | R0603-5% 2K2 | Chip Resistor 5% 0603 2k2 | SMT | 2k2 | MULTICOMP | MC 0.063W 0603 5% 2K2 | Farnell | 9331913 | Stackpole Electronics Inc | RMCF0603JT2K20 | Digikey | RMCF0603JT2K20CT-ND | YAGEO | RC0603JR-072K2L | Future | RC0603JR-072K2L | - | - | - | -
 | R54 | R0603-5% 22R | Chip Resistor 5% 0603 22R | SMT | 22R | MULTICOMP | MC 0.063W 0603 5% 22R | Farnell | 9331891 | Stackpole Electronics Inc | RMCF0603JT22R0 | Digikey | RMCF0603JT22R0CT-ND | YAGEO | RC0603JR-0722RL | Future | RC0603JR-0722RL | Uni ohm | 0603SAJ0220T50 | Comet | R0603 22R 5%
 | R55 | R0603-5% 22R | Chip Resistor 5% 0603 22R | SMT | 22R | MULTICOMP | MC 0.063W 0603 5% 22R | Farnell | 9331891 | Stackpole Electronics Inc | RMCF0603JT22R0 | Digikey | RMCF0603JT22R0CT-ND | YAGEO | RC0603JR-0722RL | Future | RC0603JR-0722RL | Uni ohm | 0603SAJ0220T50 | Comet | R0603 22R 5%
 | R56 | R0603-5% 22R | Chip Resistor 5% 0603 22R | SMT | 22R | MULTICOMP | MC 0.063W 0603 5% 22R | Farnell | 9331891 | Stackpole Electronics Inc | RMCF0603JT22R0 | Digikey | RMCF0603JT22R0CT-ND | YAGEO | RC0603JR-0722RL | Future | RC0603JR-0722RL | Uni ohm | 0603SAJ0220T50 | Comet | R0603 22R 5%
 | R57 | R0603-5% 22R | Chip Resistor 5% 0603 22R | SMT | 22R | MULTICOMP | MC 0.063W 0603 5% 22R | Farnell | 9331891 | Stackpole Electronics Inc | RMCF0603JT22R0 | Digikey | RMCF0603JT22R0CT-ND | YAGEO | RC0603JR-0722RL | Future | RC0603JR-0722RL | Uni ohm | 0603SAJ0220T50 | Comet | R0603 22R 5%
 | R58 | R0603-5% 22R | Chip Resistor 5% 0603 22R | SMT | 22R | MULTICOMP | MC 0.063W 0603 5% 22R | Farnell | 9331891 | Stackpole Electronics Inc | RMCF0603JT22R0 | Digikey | RMCF0603JT22R0CT-ND | YAGEO | RC0603JR-0722RL | Future | RC0603JR-0722RL | Uni ohm | 0603SAJ0220T50 | Comet | R0603 22R 5%
 | R59 | R0603-5% 22R | Chip Resistor 5% 0603 22R | SMT | 22R | MULTICOMP | MC 0.063W 0603 5% 22R | Farnell | 9331891 | Stackpole Electronics Inc | RMCF0603JT22R0 | Digikey | RMCF0603JT22R0CT-ND | YAGEO | RC0603JR-0722RL | Future | RC0603JR-0722RL | Uni ohm | 0603SAJ0220T50 | Comet | R0603 22R 5%
 | R60 | R0603-5% 22R | Chip Resistor 5% 0603 22R | SMT | 22R | MULTICOMP | MC 0.063W 0603 5% 22R | Farnell | 9331891 | Stackpole Electronics Inc | RMCF0603JT22R0 | Digikey | RMCF0603JT22R0CT-ND | YAGEO | RC0603JR-0722RL | Future | RC0603JR-0722RL | Uni ohm | 0603SAJ0220T50 | Comet | R0603 22R 5%
 | R61 | R0603-5% 22R | Chip Resistor 5% 0603 22R | SMT | 22R | MULTICOMP | MC 0.063W 0603 5% 22R | Farnell | 9331891 | Stackpole Electronics Inc | RMCF0603JT22R0 | Digikey | RMCF0603JT22R0CT-ND | YAGEO | RC0603JR-0722RL | Future | RC0603JR-0722RL | Uni ohm | 0603SAJ0220T50 | Comet | R0603 22R 5%
 | R62 | R0603-5% 22R | Chip Resistor 5% 0603 22R | SMT | 22R | MULTICOMP | MC 0.063W 0603 5% 22R | Farnell | 9331891 | Stackpole Electronics Inc | RMCF0603JT22R0 | Digikey | RMCF0603JT22R0CT-ND | YAGEO | RC0603JR-0722RL | Future | RC0603JR-0722RL | Uni ohm | 0603SAJ0220T50 | Comet | R0603 22R 5%
 | R63 | R0603-5% 22R | Chip Resistor 5% 0603 22R | SMT | 22R | MULTICOMP | MC 0.063W 0603 5% 22R | Farnell | 9331891 | Stackpole Electronics Inc | RMCF0603JT22R0 | Digikey | RMCF0603JT22R0CT-ND | YAGEO | RC0603JR-0722RL | Future | RC0603JR-0722RL | Uni ohm | 0603SAJ0220T50 | Comet | R0603 22R 5%
 | R64 | R0603-5% 22R | Chip Resistor 5% 0603 22R | SMT | 22R | MULTICOMP | MC 0.063W 0603 5% 22R | Farnell | 9331891 | Stackpole Electronics Inc | RMCF0603JT22R0 | Digikey | RMCF0603JT22R0CT-ND | YAGEO | RC0603JR-0722RL | Future | RC0603JR-0722RL | Uni ohm | 0603SAJ0220T50 | Comet | R0603 22R 5%
 | R65 | R0603-5% 22R | Chip Resistor 5% 0603 22R | SMT | 22R | MULTICOMP | MC 0.063W 0603 5% 22R | Farnell | 9331891 | Stackpole Electronics Inc | RMCF0603JT22R0 | Digikey | RMCF0603JT22R0CT-ND | YAGEO | RC0603JR-0722RL | Future | RC0603JR-0722RL | Uni ohm | 0603SAJ0220T50 | Comet | R0603 22R 5%
 | R66 | R0603-5% 10R | Chip Resistor 5% 0603 10R | SMT | 10R | MULTICOMP | MC 0.063W 0603 5% 10R | Farnell | 9331670 | Yageo | RC0603JR-0710RL | DigiKey | 311-10GRCT-ND | YAGEO | RC0603JR-0710RL | Future | RC0603JR-0710RL | - | - | - | -
 | R67 | R0603-5% 10K | Chip Resistor 5% 0603 10k | SMT | 10k | MULTICOMP | MC 0.063W 0603 5% 10K | Farnell | 9331700 | Panasonic Electronic Components | ERJ-3GEYJ103V | DigiKey | P10KGCT-ND | YAGEO | RC0603JR-0710KL | Future | RC0603JR-0710KL | - | - | - | -
NA | R68 | R0603-5% 0R | Chip Resistor 5% 0603 0R | SMT | 0R | VISHAY DRALORIC | CRCW06030000Z0EA | Farnell | 1469739 | Panasonic - ECG | ERJ-3GEY0R00V | Digikey | P0.0GCT-ND | YAGEO | RC0603JR-070RL | Future | RC0603JR-070RL | Uni ohm | 0603SAJ000JT50 | Comet | R0603 0R 5%
 | R69 | R0603-5% 10K | Chip Resistor 5% 0603 10k | SMT | 10k | MULTICOMP | MC 0.063W 0603 5% 10K | Farnell | 9331700 | Panasonic Electronic Components | ERJ-3GEYJ103V | DigiKey | P10KGCT-ND | YAGEO | RC0603JR-0710KL | Future | RC0603JR-0710KL | - | - | - | -
NA | R70 | R0603-5% 0R | Chip Resistor 5% 0603 0R | SMT | 0R | VISHAY DRALORIC | CRCW06030000Z0EA | Farnell | 1469739 | Panasonic - ECG | ERJ-3GEY0R00V | Digikey | P0.0GCT-ND | YAGEO | RC0603JR-070RL | Future | RC0603JR-070RL | Uni ohm | 0603SAJ000JT50 | Comet | R0603 0R 5%
 | R71 | R0603-5% 1K | Chip Resistor 5% 0603 1k | SMT | 1k | MULTICOMP | MC 0.063W 0603 5% 1K | Farnell | 9331697 | Panasonic Electronic Components | ERJ-3GEYJ102V | DIgiKey | P1.0KGCT-ND | YAGEO | RC0603JR-071KL | Future | RC0603JR-071KL | - | - | - | -
 | R72 | R0603-5% 22R | Chip Resistor 5% 0603 22R | SMT | 22R | MULTICOMP | MC 0.063W 0603 5% 22R | Farnell | 9331891 | Stackpole Electronics Inc | RMCF0603JT22R0 | Digikey | RMCF0603JT22R0CT-ND | YAGEO | RC0603JR-0722RL | Future | RC0603JR-0722RL | Uni ohm | 0603SAJ0220T50 | Comet | R0603 22R 5%
 | R73 | R0603-5% 2K2 | Chip Resistor 5% 0603 2k2 | SMT | 2k2 | MULTICOMP | MC 0.063W 0603 5% 2K2 | Farnell | 9331913 | Stackpole Electronics Inc | RMCF0603JT2K20 | Digikey | RMCF0603JT2K20CT-ND | YAGEO | RC0603JR-072K2L | Future | RC0603JR-072K2L | - | - | - | -
 | R74 | R0603-5% 10K | Chip Resistor 5% 0603 10k | SMT | 10k | MULTICOMP | MC 0.063W 0603 5% 10K | Farnell | 9331700 | Panasonic Electronic Components | ERJ-3GEYJ103V | DigiKey | P10KGCT-ND | YAGEO | RC0603JR-0710KL | Future | RC0603JR-0710KL | - | - | - | -
 | R75 | R0603-5% 10K | Chip Resistor 5% 0603 10k | SMT | 10k | MULTICOMP | MC 0.063W 0603 5% 10K | Farnell | 9331700 | Panasonic Electronic Components | ERJ-3GEYJ103V | DigiKey | P10KGCT-ND | YAGEO | RC0603JR-0710KL | Future | RC0603JR-0710KL | - | - | - | -
 | R76 | R0603-5% 10K | Chip Resistor 5% 0603 10k | SMT | 10k | MULTICOMP | MC 0.063W 0603 5% 10K | Farnell | 9331700 | Panasonic Electronic Components | ERJ-3GEYJ103V | DigiKey | P10KGCT-ND | YAGEO | RC0603JR-0710KL | Future | RC0603JR-0710KL | - | - | - | -
 | R77 | R0603-5% 22R | Chip Resistor 5% 0603 22R | SMT | 22R | MULTICOMP | MC 0.063W 0603 5% 22R | Farnell | 9331891 | Stackpole Electronics Inc | RMCF0603JT22R0 | Digikey | RMCF0603JT22R0CT-ND | YAGEO | RC0603JR-0722RL | Future | RC0603JR-0722RL | Uni ohm | 0603SAJ0220T50 | Comet | R0603 22R 5%
 | R78 | R0603-5% 22R | Chip Resistor 5% 0603 22R | SMT | 22R | MULTICOMP | MC 0.063W 0603 5% 22R | Farnell | 9331891 | Stackpole Electronics Inc | RMCF0603JT22R0 | Digikey | RMCF0603JT22R0CT-ND | YAGEO | RC0603JR-0722RL | Future | RC0603JR-0722RL | Uni ohm | 0603SAJ0220T50 | Comet | R0603 22R 5%
 | R79 | R0603-5% 22R | Chip Resistor 5% 0603 22R | SMT | 22R | MULTICOMP | MC 0.063W 0603 5% 22R | Farnell | 9331891 | Stackpole Electronics Inc | RMCF0603JT22R0 | Digikey | RMCF0603JT22R0CT-ND | YAGEO | RC0603JR-0722RL | Future | RC0603JR-0722RL | Uni ohm | 0603SAJ0220T50 | Comet | R0603 22R 5%
 | R80 | R0603-5% 22R | Chip Resistor 5% 0603 22R | SMT | 22R | MULTICOMP | MC 0.063W 0603 5% 22R | Farnell | 9331891 | Stackpole Electronics Inc | RMCF0603JT22R0 | Digikey | RMCF0603JT22R0CT-ND | YAGEO | RC0603JR-0722RL | Future | RC0603JR-0722RL | Uni ohm | 0603SAJ0220T50 | Comet | R0603 22R 5%
 | R81 | R0603-5% 22R | Chip Resistor 5% 0603 22R | SMT | 22R | MULTICOMP | MC 0.063W 0603 5% 22R | Farnell | 9331891 | Stackpole Electronics Inc | RMCF0603JT22R0 | Digikey | RMCF0603JT22R0CT-ND | YAGEO | RC0603JR-0722RL | Future | RC0603JR-0722RL | Uni ohm | 0603SAJ0220T50 | Comet | R0603 22R 5%
 | R82 | R0603-5% 22R | Chip Resistor 5% 0603 22R | SMT | 22R | MULTICOMP | MC 0.063W 0603 5% 22R | Farnell | 9331891 | Stackpole Electronics Inc | RMCF0603JT22R0 | Digikey | RMCF0603JT22R0CT-ND | YAGEO | RC0603JR-0722RL | Future | RC0603JR-0722RL | Uni ohm | 0603SAJ0220T50 | Comet | R0603 22R 5%
 | R83 | R0603-5% 22R | Chip Resistor 5% 0603 22R | SMT | 22R | MULTICOMP | MC 0.063W 0603 5% 22R | Farnell | 9331891 | Stackpole Electronics Inc | RMCF0603JT22R0 | Digikey | RMCF0603JT22R0CT-ND | YAGEO | RC0603JR-0722RL | Future | RC0603JR-0722RL | Uni ohm | 0603SAJ0220T50 | Comet | R0603 22R 5%
 | R84 | R0603-5% 22R | Chip Resistor 5% 0603 22R | SMT | 22R | MULTICOMP | MC 0.063W 0603 5% 22R | Farnell | 9331891 | Stackpole Electronics Inc | RMCF0603JT22R0 | Digikey | RMCF0603JT22R0CT-ND | YAGEO | RC0603JR-0722RL | Future | RC0603JR-0722RL | Uni ohm | 0603SAJ0220T50 | Comet | R0603 22R 5%
 | R85 | R0603-5% 22R | Chip Resistor 5% 0603 22R | SMT | 22R | MULTICOMP | MC 0.063W 0603 5% 22R | Farnell | 9331891 | Stackpole Electronics Inc | RMCF0603JT22R0 | Digikey | RMCF0603JT22R0CT-ND | YAGEO | RC0603JR-0722RL | Future | RC0603JR-0722RL | Uni ohm | 0603SAJ0220T50 | Comet | R0603 22R 5%
 | R86 | R0603-5% 22R | Chip Resistor 5% 0603 22R | SMT | 22R | MULTICOMP | MC 0.063W 0603 5% 22R | Farnell | 9331891 | Stackpole Electronics Inc | RMCF0603JT22R0 | Digikey | RMCF0603JT22R0CT-ND | YAGEO | RC0603JR-0722RL | Future | RC0603JR-0722RL | Uni ohm | 0603SAJ0220T50 | Comet | R0603 22R 5%
 | R87 | R0603-5% 100K | Chip Resistor 5% 0603 100k | SMT | 100k | PHYCOMP (YAGEO) | 232270260104 | Farnell | 9233628 | Panasonic Electronic Components | ERJ-3GEYJ104V | DigiKey | P100KGCT-ND | YAGEO AMERICA CORPORATION | RC0603JR-07100KL | Future | RC0603JR-07100KL | - | - | - | -
 | R88 | R0603-5% 10K | Chip Resistor 5% 0603 10k | SMT | 10k | MULTICOMP | MC 0.063W 0603 5% 10K | Farnell | 9331700 | Panasonic Electronic Components | ERJ-3GEYJ103V | DigiKey | P10KGCT-ND | YAGEO | RC0603JR-0710KL | Future | RC0603JR-0710KL | - | - | - | -
 | R89 | R0603-5% 10K | Chip Resistor 5% 0603 10k | SMT | 10k | MULTICOMP | MC 0.063W 0603 5% 10K | Farnell | 9331700 | Panasonic Electronic Components | ERJ-3GEYJ103V | DigiKey | P10KGCT-ND | YAGEO | RC0603JR-0710KL | Future | RC0603JR-0710KL | - | - | - | -
 | R90 | R0603-5% 10K | Chip Resistor 5% 0603 10k | SMT | 10k | MULTICOMP | MC 0.063W 0603 5% 10K | Farnell | 9331700 | Panasonic Electronic Components | ERJ-3GEYJ103V | DigiKey | P10KGCT-ND | YAGEO | RC0603JR-0710KL | Future | RC0603JR-0710KL | - | - | - | -
 | R91 | R0603-5% 10K | Chip Resistor 5% 0603 10k | SMT | 10k | MULTICOMP | MC 0.063W 0603 5% 10K | Farnell | 9331700 | Panasonic Electronic Components | ERJ-3GEYJ103V | DigiKey | P10KGCT-ND | YAGEO | RC0603JR-0710KL | Future | RC0603JR-0710KL | - | - | - | -
 | R92 | R0603-5% 10K | Chip Resistor 5% 0603 10k | SMT | 10k | MULTICOMP | MC 0.063W 0603 5% 10K | Farnell | 9331700 | Panasonic Electronic Components | ERJ-3GEYJ103V | DigiKey | P10KGCT-ND | YAGEO | RC0603JR-0710KL | Future | RC0603JR-0710KL | - | - | - | -
NA | R93 | R0603-5% 0R | Chip Resistor 5% 0603 0R | SMT | 0R | VISHAY DRALORIC | CRCW06030000Z0EA | Farnell | 1469739 | Panasonic - ECG | ERJ-3GEY0R00V | Digikey | P0.0GCT-ND | YAGEO | RC0603JR-070RL | Future | RC0603JR-070RL | Uni ohm | 0603SAJ000JT50 | Comet | R0603 0R 5%
 | R94 | R0603-5% 0R | Chip Resistor 5% 0603 0R | SMT | 0R | VISHAY DRALORIC | CRCW06030000Z0EA | Farnell | 1469739 | Panasonic - ECG | ERJ-3GEY0R00V | Digikey | P0.0GCT-ND | YAGEO | RC0603JR-070RL | Future | RC0603JR-070RL | Uni ohm | 0603SAJ000JT50 | Comet | R0603 0R 5%
 | R95 | R0603-5% 10K | Chip Resistor 5% 0603 10k | SMT | 10k | MULTICOMP | MC 0.063W 0603 5% 10K | Farnell | 9331700 | Panasonic Electronic Components | ERJ-3GEYJ103V | DigiKey | P10KGCT-ND | YAGEO | RC0603JR-0710KL | Future | RC0603JR-0710KL | - | - | - | -
 | R96 | R0603-5% 22R | Chip Resistor 5% 0603 22R | SMT | 22R | MULTICOMP | MC 0.063W 0603 5% 22R | Farnell | 9331891 | Stackpole Electronics Inc | RMCF0603JT22R0 | Digikey | RMCF0603JT22R0CT-ND | YAGEO | RC0603JR-0722RL | Future | RC0603JR-0722RL | Uni ohm | 0603SAJ0220T50 | Comet | R0603 22R 5%
 | R97 | R0603-5% 22R | Chip Resistor 5% 0603 22R | SMT | 22R | MULTICOMP | MC 0.063W 0603 5% 22R | Farnell | 9331891 | Stackpole Electronics Inc | RMCF0603JT22R0 | Digikey | RMCF0603JT22R0CT-ND | YAGEO | RC0603JR-0722RL | Future | RC0603JR-0722RL | Uni ohm | 0603SAJ0220T50 | Comet | R0603 22R 5%
NA | R98 | R0603-5% 10K | Chip Resistor 5% 0603 10k | SMT | 10k | MULTICOMP | MC 0.063W 0603 5% 10K | Farnell | 9331700 | Panasonic Electronic Components | ERJ-3GEYJ103V | DigiKey | P10KGCT-ND | YAGEO | RC0603JR-0710KL | Future | RC0603JR-0710KL | - | - | - | -
 | R99 | R0603-5% 10K | Chip Resistor 5% 0603 10k | SMT | 10k | MULTICOMP | MC 0.063W 0603 5% 10K | Farnell | 9331700 | Panasonic Electronic Components | ERJ-3GEYJ103V | DigiKey | P10KGCT-ND | YAGEO | RC0603JR-0710KL | Future | RC0603JR-0710KL | - | - | - | -
 | R100 | R0805-1% 21K5 | Chip Resistor 1% 0805 | SMT | 21k5/1% | VISHAY DRALORIC | CRCW080521K5FKEA | Farnell | 1652957 | - | - | - | - | - | - | - | - | - | - | - | -
 | R101 | R0603-5% 22R | Chip Resistor 5% 0603 22R | SMT | 22R | MULTICOMP | MC 0.063W 0603 5% 22R | Farnell | 9331891 | Stackpole Electronics Inc | RMCF0603JT22R0 | Digikey | RMCF0603JT22R0CT-ND | YAGEO | RC0603JR-0722RL | Future | RC0603JR-0722RL | Uni ohm | 0603SAJ0220T50 | Comet | R0603 22R 5%
 | R102 | R0603-5% 22R | Chip Resistor 5% 0603 22R | SMT | 22R | MULTICOMP | MC 0.063W 0603 5% 22R | Farnell | 9331891 | Stackpole Electronics Inc | RMCF0603JT22R0 | Digikey | RMCF0603JT22R0CT-ND | YAGEO | RC0603JR-0722RL | Future | RC0603JR-0722RL | Uni ohm | 0603SAJ0220T50 | Comet | R0603 22R 5%
 | R103 | R0603-5% 10K | Chip Resistor 5% 0603 10k | SMT | 10k | MULTICOMP | MC 0.063W 0603 5% 10K | Farnell | 9331700 | Panasonic Electronic Components | ERJ-3GEYJ103V | DigiKey | P10KGCT-ND | YAGEO | RC0603JR-0710KL | Future | RC0603JR-0710KL | - | - | - | -
NA | R104 | R0603-5% 10K | Chip Resistor 5% 0603 10k | SMT | 10k | MULTICOMP | MC 0.063W 0603 5% 10K | Farnell | 9331700 | Panasonic Electronic Components | ERJ-3GEYJ103V | DigiKey | P10KGCT-ND | YAGEO | RC0603JR-0710KL | Future | RC0603JR-0710KL | - | - | - | -
 | R105 | R0603-5% 10K | Chip Resistor 5% 0603 10k | SMT | 10k | MULTICOMP | MC 0.063W 0603 5% 10K | Farnell | 9331700 | Panasonic Electronic Components | ERJ-3GEYJ103V | DigiKey | P10KGCT-ND | YAGEO | RC0603JR-0710KL | Future | RC0603JR-0710KL | - | - | - | -
NA | R106 | R0603-5% 10K | Chip Resistor 5% 0603 10k | SMT | 10k | MULTICOMP | MC 0.063W 0603 5% 10K | Farnell | 9331700 | Panasonic Electronic Components | ERJ-3GEYJ103V | DigiKey | P10KGCT-ND | YAGEO | RC0603JR-0710KL | Future | RC0603JR-0710KL | - | - | - | -
 | R107 | R0805-5% 0R | Chip Resistor 5% 0805 0R | SMT | 0R | MULTICOMP | MC 0.1W 0805 0R | Farnell | 9333681 | Uni ohm | 0805S8J000JT50 | Comet | R0805 0R 5% | - | - | - | - | - | - | - | -
 | R108 | R0603-5% 330R | Chip Resistor 5% 0603 330R | SMT | 330R | MULTICOMP | MC 0.063W 0603 5% 330R | Farnell | 9332014 | Panasonic Electronic Components | ERJ-3GEYJ331V | DigiKey | P330GCT-ND | ROHM | MCR03EZHJ331 | Future | MCR03EZHJ331 | - | - | - | -
 | R109 | R0603-5% 150K | Chip Resistor 5% 0603 150k | SMT | 150k | MULTICOMP | MC 0.063W 0603 5% 150K | Farnell | 9331824 | Yageo | RC0603JR-07150KL | Digikey | 311-150KGRCT-ND | - | - | - | - | - | - | - | -
 | R110 | R0603-5% 150K | Chip Resistor 5% 0603 150k | SMT | 150k | MULTICOMP | MC 0.063W 0603 5% 150K | Farnell | 9331824 | Yageo | RC0603JR-07150KL | Digikey | 311-150KGRCT-ND | - | - | - | - | - | - | - | -
 | R111 | R0805-1% 100K | Chip Resistor 1% 0805 | SMT | 100k/1% | PHYCOMP | 232273461004 | Farnell | 9237879 | Vishay Dale | CRCW0805100KFKEA | Digikey | 541-100KCCT-ND | Uni ohm | 0805S8F0104T50 | Comet | R0805 100K 1% | - | - | - | -
 | R112 | R0805-5% 0R | Chip Resistor 5% 0805 0R | SMT | 0R | MULTICOMP | MC 0.1W 0805 0R | Farnell | 9333681 | Uni ohm | 0805S8J000JT50 | Comet | R0805 0R 5% | - | - | - | - | - | - | - | -
 | R113 | R0603-5% 330R | Chip Resistor 5% 0603 330R | SMT | 330R | MULTICOMP | MC 0.063W 0603 5% 330R | Farnell | 9332014 | Panasonic Electronic Components | ERJ-3GEYJ331V | DigiKey | P330GCT-ND | ROHM | MCR03EZHJ331 | Future | MCR03EZHJ331 | - | - | - | -
 | R114 | R0603-5% 150K | Chip Resistor 5% 0603 150k | SMT | 150k | MULTICOMP | MC 0.063W 0603 5% 150K | Farnell | 9331824 | Yageo | RC0603JR-07150KL | Digikey | 311-150KGRCT-ND | - | - | - | - | - | - | - | -
 | R115 | R0603-5% 150K | Chip Resistor 5% 0603 150k | SMT | 150k | MULTICOMP | MC 0.063W 0603 5% 150K | Farnell | 9331824 | Yageo | RC0603JR-07150KL | Digikey | 311-150KGRCT-ND | - | - | - | - | - | - | - | -
 | R116 | R0603-5% 22R | Chip Resistor 5% 0603 22R | SMT | 22R | MULTICOMP | MC 0.063W 0603 5% 22R | Farnell | 9331891 | Stackpole Electronics Inc | RMCF0603JT22R0 | Digikey | RMCF0603JT22R0CT-ND | YAGEO | RC0603JR-0722RL | Future | RC0603JR-0722RL | Uni ohm | 0603SAJ0220T50 | Comet | R0603 22R 5%
 | R117 | R0603-1% 10K2 | Chip Resistor 1% 0603 10k2 | SMT | 10k2/1% | MULTICOMP | MC 0.063W 0603 1% 10K2 | Farnell | 1170889 | Yageo | RC0603FR-0710K2L | Digikey | 311-10.2KHRCT-ND | - | - | - | - | - | - | - | -
 | R118 | R0603-1% 10K | Chip Resistor 1% 0603 10K | SMT | 10k/1% | MULTICOMP | MCHP03W8F1002T5E | Farnell | 1576297 | Panasonic Electronic Components | ERJ-3EKF1002V | Digikey | P10.0KHCT-ND | VISHAY | CRCW060310K0FKEA | Future | CRCW060310K0FKEA | Stackpole Electronics Inc | RMCF0603FT10K0 | Digikey | RMCF0603FT10K0CT-ND
 | R119 | R0603-5% 22R | Chip Resistor 5% 0603 22R | SMT | 22R | MULTICOMP | MC 0.063W 0603 5% 22R | Farnell | 9331891 | Stackpole Electronics Inc | RMCF0603JT22R0 | Digikey | RMCF0603JT22R0CT-ND | YAGEO | RC0603JR-0722RL | Future | RC0603JR-0722RL | Uni ohm | 0603SAJ0220T50 | Comet | R0603 22R 5%
 | R120 | R0603-5% 10K | Chip Resistor 5% 0603 10k | SMT | 10k | MULTICOMP | MC 0.063W 0603 5% 10K | Farnell | 9331700 | Panasonic Electronic Components | ERJ-3GEYJ103V | DigiKey | P10KGCT-ND | YAGEO | RC0603JR-0710KL | Future | RC0603JR-0710KL | - | - | - | -
 | R121 | R0603-5% 10K | Chip Resistor 5% 0603 10k | SMT | 10k | MULTICOMP | MC 0.063W 0603 5% 10K | Farnell | 9331700 | Panasonic Electronic Components | ERJ-3GEYJ103V | DigiKey | P10KGCT-ND | YAGEO | RC0603JR-0710KL | Future | RC0603JR-0710KL | - | - | - | -
 | R122 | R0603-1% 68K1 | Chip Resistor 1% 0603 68k1 | SMT | 68k1/1% | WELWYN | PCF0603R 68K1B.T1 | Farnell | 1160391 | - | - | - | - | - | - | - | - | - | - | - | -
 | R123 | R0603-1% 1K96 | Chip Resistor 1% 0603 | SMT | 1k96/1% | VISHAY DRALORIC | CRCW06031K96FKEA | Farnell | 2138374 | - | - | - | - | - | - | - | - | - | - | - | -
 | R124 | R0603-5% 10K | Chip Resistor 5% 0603 10k | SMT | 10k | MULTICOMP | MC 0.063W 0603 5% 10K | Farnell | 9331700 | Panasonic Electronic Components | ERJ-3GEYJ103V | DigiKey | P10KGCT-ND | YAGEO | RC0603JR-0710KL | Future | RC0603JR-0710KL | - | - | - | -
 | R125 | R0603-5% 10K | Chip Resistor 5% 0603 10k | SMT | 10k | MULTICOMP | MC 0.063W 0603 5% 10K | Farnell | 9331700 | Panasonic Electronic Components | ERJ-3GEYJ103V | DigiKey | P10KGCT-ND | YAGEO | RC0603JR-0710KL | Future | RC0603JR-0710KL | - | - | - | -
 | R126 | R0603-1% 68K1 | Chip Resistor 1% 0603 68k1 | SMT | 68k1/1% | WELWYN | PCF0603R 68K1B.T1 | Farnell | 1160391 | - | - | - | - | - | - | - | - | - | - | - | -
 | R127 | R0603-1% 3K24 | Chip Resistor 1% 0603 3k24 | SMT | 3k24/1% | MULTICOMP | MC 0.063W 0603 1% 3K24 | Farnell | 1170839 | - | - | - | - | - | - | - | - | - | - | - | -
 | R128 | R0603-5% 22R | Chip Resistor 5% 0603 22R | SMT | 22R | MULTICOMP | MC 0.063W 0603 5% 22R | Farnell | 9331891 | Stackpole Electronics Inc | RMCF0603JT22R0 | Digikey | RMCF0603JT22R0CT-ND | YAGEO | RC0603JR-0722RL | Future | RC0603JR-0722RL | Uni ohm | 0603SAJ0220T50 | Comet | R0603 22R 5%
 | R129 | R0603-5% 22R | Chip Resistor 5% 0603 22R | SMT | 22R | MULTICOMP | MC 0.063W 0603 5% 22R | Farnell | 9331891 | Stackpole Electronics Inc | RMCF0603JT22R0 | Digikey | RMCF0603JT22R0CT-ND | YAGEO | RC0603JR-0722RL | Future | RC0603JR-0722RL | Uni ohm | 0603SAJ0220T50 | Comet | R0603 22R 5%
 | R130 | R0603-5% 10K | Chip Resistor 5% 0603 10k | SMT | 10k | MULTICOMP | MC 0.063W 0603 5% 10K | Farnell | 9331700 | Panasonic Electronic Components | ERJ-3GEYJ103V | DigiKey | P10KGCT-ND | YAGEO | RC0603JR-0710KL | Future | RC0603JR-0710KL | - | - | - | -
 | R131 | R0603-5% 1K | Chip Resistor 5% 0603 1k | SMT | 1k | MULTICOMP | MC 0.063W 0603 5% 1K | Farnell | 9331697 | Panasonic Electronic Components | ERJ-3GEYJ102V | DIgiKey | P1.0KGCT-ND | YAGEO | RC0603JR-071KL | Future | RC0603JR-071KL | - | - | - | -
 | R132 | R0603-5% 10K | Chip Resistor 5% 0603 10k | SMT | 10k | MULTICOMP | MC 0.063W 0603 5% 10K | Farnell | 9331700 | Panasonic Electronic Components | ERJ-3GEYJ103V | DigiKey | P10KGCT-ND | YAGEO | RC0603JR-0710KL | Future | RC0603JR-0710KL | - | - | - | -
 | R133 | R0603-5% 10K | Chip Resistor 5% 0603 10k | SMT | 10k | MULTICOMP | MC 0.063W 0603 5% 10K | Farnell | 9331700 | Panasonic Electronic Components | ERJ-3GEYJ103V | DigiKey | P10KGCT-ND | YAGEO | RC0603JR-0710KL | Future | RC0603JR-0710KL | - | - | - | -
 | R134 | R0603-5% 100K | Chip Resistor 5% 0603 100k | SMT | 100k | PHYCOMP (YAGEO) | 232270260104 | Farnell | 9233628 | Panasonic Electronic Components | ERJ-3GEYJ104V | DigiKey | P100KGCT-ND | YAGEO AMERICA CORPORATION | RC0603JR-07100KL | Future | RC0603JR-07100KL | - | - | - | -
 | R135 | R0603-5% 10K | Chip Resistor 5% 0603 10k | SMT | 10k | MULTICOMP | MC 0.063W 0603 5% 10K | Farnell | 9331700 | Panasonic Electronic Components | ERJ-3GEYJ103V | DigiKey | P10KGCT-ND | YAGEO | RC0603JR-0710KL | Future | RC0603JR-0710KL | - | - | - | -
 | R136 | R0603-5% 1K | Chip Resistor 5% 0603 1k | SMT | 1k | MULTICOMP | MC 0.063W 0603 5% 1K | Farnell | 9331697 | Panasonic Electronic Components | ERJ-3GEYJ102V | DIgiKey | P1.0KGCT-ND | YAGEO | RC0603JR-071KL | Future | RC0603JR-071KL | - | - | - | -
 | R137 | R0603-5% 10K | Chip Resistor 5% 0603 10k | SMT | 10k | MULTICOMP | MC 0.063W 0603 5% 10K | Farnell | 9331700 | Panasonic Electronic Components | ERJ-3GEYJ103V | DigiKey | P10KGCT-ND | YAGEO | RC0603JR-0710KL | Future | RC0603JR-0710KL | - | - | - | -
 | R138 | R0603-5% 10K | Chip Resistor 5% 0603 10k | SMT | 10k | MULTICOMP | MC 0.063W 0603 5% 10K | Farnell | 9331700 | Panasonic Electronic Components | ERJ-3GEYJ103V | DigiKey | P10KGCT-ND | YAGEO | RC0603JR-0710KL | Future | RC0603JR-0710KL | - | - | - | -
 | R139 | R0603-5% 10K | Chip Resistor 5% 0603 10k | SMT | 10k | MULTICOMP | MC 0.063W 0603 5% 10K | Farnell | 9331700 | Panasonic Electronic Components | ERJ-3GEYJ103V | DigiKey | P10KGCT-ND | YAGEO | RC0603JR-0710KL | Future | RC0603JR-0710KL | - | - | - | -
 | R140 | R0603-5% 10K | Chip Resistor 5% 0603 10k | SMT | 10k | MULTICOMP | MC 0.063W 0603 5% 10K | Farnell | 9331700 | Panasonic Electronic Components | ERJ-3GEYJ103V | DigiKey | P10KGCT-ND | YAGEO | RC0603JR-0710KL | Future | RC0603JR-0710KL | - | - | - | -
 | R141 | R0603-5% 10K | Chip Resistor 5% 0603 10k | SMT | 10k | MULTICOMP | MC 0.063W 0603 5% 10K | Farnell | 9331700 | Panasonic Electronic Components | ERJ-3GEYJ103V | DigiKey | P10KGCT-ND | YAGEO | RC0603JR-0710KL | Future | RC0603JR-0710KL | - | - | - | -
 | R142 | R0805-5% 470R | Chip Resistor 5% 0805 470R | SMT | 470R | MULTICOMP | MC 0.1W 0805 5% 470R | Farnell | 9334572 | Uni ohm | 0805S8J0471T50 | Comet | R0805 470R 5% | - | - | - | - | - | - | - | -
 | R143 | R0805-5% 10K | Chip Resistor 5% 0805 10k | SMT | 10k | MULTICOMP | MC 0.1W 0805 5% 10K | Farnell | 9333720 | Uni ohm | 0805S8J0103T50 | Comet | R0805 10K 5% | - | - | - | - | - | - | - | -
 | R144 | R0603-5% 0R | Chip Resistor 5% 0603 0R | SMT | 0R | VISHAY DRALORIC | CRCW06030000Z0EA | Farnell | 1469739 | Panasonic - ECG | ERJ-3GEY0R00V | Digikey | P0.0GCT-ND | YAGEO | RC0603JR-070RL | Future | RC0603JR-070RL | Uni ohm | 0603SAJ000JT50 | Comet | R0603 0R 5%
 | R145 | R0603-5% 5K1 | Chip Resistor 5% 0603 | SMT | 5k1 | VISHAY DALE | CRCW06035K10JNEA | Farnell | 1570751 | - | - | - | - | - | - | - | - | - | - | - | -
 | R146 | R0603-5% 3K3 | Chip Resistor 5% 0603 3k3 | SMT | 3k3 | MULTICOMP | MC 0.063W 0603 5% 3K3 | Farnell | 9332022 | Stackpole Electronics Inc | RMCF0603JT3K30 | Digikey | RMCF0603JT3K30CT-ND | YAGEO | RC0603JR-073K3L | Future | RC0603JR-073K3L | - | - | Comet | R0603 3.3K 5% YAG
 | R147 | R0603-5% 1K8 | Chip Resistor 5% 0603 1k8 | SMT | 1k8 | MULTICOMP | MC 0.063W 0603 5% 1K8 | Farnell | 9331867 | Yageo | RC0603JR-071K8L | Digikey | 311-1.8KGRCT-ND | - | - | - | - | - | - | - | -
NA | R148 | R0603-5% 10K | Chip Resistor 5% 0603 10k | SMT | 10k | MULTICOMP | MC 0.063W 0603 5% 10K | Farnell | 9331700 | Panasonic Electronic Components | ERJ-3GEYJ103V | DigiKey | P10KGCT-ND | YAGEO | RC0603JR-0710KL | Future | RC0603JR-0710KL | - | - | - | -
 | R149 | R0603-5% 10K | Chip Resistor 5% 0603 10k | SMT | 10k | MULTICOMP | MC 0.063W 0603 5% 10K | Farnell | 9331700 | Panasonic Electronic Components | ERJ-3GEYJ103V | DigiKey | P10KGCT-ND | YAGEO | RC0603JR-0710KL | Future | RC0603JR-0710KL | - | - | - | -
 | R150 | R0603-5% 2K2 | Chip Resistor 5% 0603 2k2 | SMT | 2k2 | MULTICOMP | MC 0.063W 0603 5% 2K2 | Farnell | 9331913 | Stackpole Electronics Inc | RMCF0603JT2K20 | Digikey | RMCF0603JT2K20CT-ND | YAGEO | RC0603JR-072K2L | Future | RC0603JR-072K2L | - | - | - | -
 | R151 | R0603-5% 2K2 | Chip Resistor 5% 0603 2k2 | SMT | 2k2 | MULTICOMP | MC 0.063W 0603 5% 2K2 | Farnell | 9331913 | Stackpole Electronics Inc | RMCF0603JT2K20 | Digikey | RMCF0603JT2K20CT-ND | YAGEO | RC0603JR-072K2L | Future | RC0603JR-072K2L | - | - | - | -
 | R152 | R0603-5% 51K | Chip Resistor 5% 0603 51k | SMT | 51k | MULTICOMP | MC 0.063W 0603 5% 1K | Farnell | 9331697 | - | - | - | - | - | - | - | - | - | - | - | -
 | R153 | R0603-5% 0R | Chip Resistor 5% 0603 0R | SMT | 0R | VISHAY DRALORIC | CRCW06030000Z0EA | Farnell | 1469739 | Panasonic - ECG | ERJ-3GEY0R00V | Digikey | P0.0GCT-ND | YAGEO | RC0603JR-070RL | Future | RC0603JR-070RL | Uni ohm | 0603SAJ000JT50 | Comet | R0603 0R 5%
 | R154 | R0603-5% 1K8 | Chip Resistor 5% 0603 1k8 | SMT | 1k8 | MULTICOMP | MC 0.063W 0603 5% 1K8 | Farnell | 9331867 | Yageo | RC0603JR-071K8L | Digikey | 311-1.8KGRCT-ND | - | - | - | - | - | - | - | -
 | R155 | R0603-1% 5K1 | Chip Resistor 1% 0603 5k1 | SMT | 5k1/1% | MULTICOMP | MC 0.063W 0603 1% 5K1 | Farnell | 9331301 | - | - | - | - | - | - | - | - | - | - | - | -
 | R156 | R0603-5% 0R | Chip Resistor 5% 0603 0R | SMT | 0R | VISHAY DRALORIC | CRCW06030000Z0EA | Farnell | 1469739 | Panasonic - ECG | ERJ-3GEY0R00V | Digikey | P0.0GCT-ND | YAGEO | RC0603JR-070RL | Future | RC0603JR-070RL | Uni ohm | 0603SAJ000JT50 | Comet | R0603 0R 5%
 | R157 | R0603-5% 1K | Chip Resistor 5% 0603 1k | SMT | 1k | MULTICOMP | MC 0.063W 0603 5% 1K | Farnell | 9331697 | Panasonic Electronic Components | ERJ-3GEYJ102V | DIgiKey | P1.0KGCT-ND | YAGEO | RC0603JR-071KL | Future | RC0603JR-071KL | - | - | - | -
NA | R158 | R0603-5% 0R | Chip Resistor 5% 0603 0R | SMT | 0R | VISHAY DRALORIC | CRCW06030000Z0EA | Farnell | 1469739 | Panasonic - ECG | ERJ-3GEY0R00V | Digikey | P0.0GCT-ND | YAGEO | RC0603JR-070RL | Future | RC0603JR-070RL | Uni ohm | 0603SAJ000JT50 | Comet | R0603 0R 5%
 | R159 | R0603-5% 1K | Chip Resistor 5% 0603 1k | SMT | 1k | MULTICOMP | MC 0.063W 0603 5% 1K | Farnell | 9331697 | Panasonic Electronic Components | ERJ-3GEYJ102V | DIgiKey | P1.0KGCT-ND | YAGEO | RC0603JR-071KL | Future | RC0603JR-071KL | - | - | - | -
 | R160 | R0603-5% 1K | Chip Resistor 5% 0603 1k | SMT | 1k | MULTICOMP | MC 0.063W 0603 5% 1K | Farnell | 9331697 | Panasonic Electronic Components | ERJ-3GEYJ102V | DIgiKey | P1.0KGCT-ND | YAGEO | RC0603JR-071KL | Future | RC0603JR-071KL | - | - | - | -
 | R161 | R0603-5% 1K | Chip Resistor 5% 0603 1k | SMT | 1k | MULTICOMP | MC 0.063W 0603 5% 1K | Farnell | 9331697 | Panasonic Electronic Components | ERJ-3GEYJ102V | DIgiKey | P1.0KGCT-ND | YAGEO | RC0603JR-071KL | Future | RC0603JR-071KL | - | - | - | -
 | R162 | R0603-5% 1K | Chip Resistor 5% 0603 1k | SMT | 1k | MULTICOMP | MC 0.063W 0603 5% 1K | Farnell | 9331697 | Panasonic Electronic Components | ERJ-3GEYJ102V | DIgiKey | P1.0KGCT-ND | YAGEO | RC0603JR-071KL | Future | RC0603JR-071KL | - | - | - | -
 | R163 | R0603-5% 1K | Chip Resistor 5% 0603 1k | SMT | 1k | MULTICOMP | MC 0.063W 0603 5% 1K | Farnell | 9331697 | Panasonic Electronic Components | ERJ-3GEYJ102V | DIgiKey | P1.0KGCT-ND | YAGEO | RC0603JR-071KL | Future | RC0603JR-071KL | - | - | - | -
 | R164 | R0603-5% 1K | Chip Resistor 5% 0603 1k | SMT | 1k | MULTICOMP | MC 0.063W 0603 5% 1K | Farnell | 9331697 | Panasonic Electronic Components | ERJ-3GEYJ102V | DIgiKey | P1.0KGCT-ND | YAGEO | RC0603JR-071KL | Future | RC0603JR-071KL | - | - | - | -
 | R165 | R0603-5% 1K | Chip Resistor 5% 0603 1k | SMT | 1k | MULTICOMP | MC 0.063W 0603 5% 1K | Farnell | 9331697 | Panasonic Electronic Components | ERJ-3GEYJ102V | DIgiKey | P1.0KGCT-ND | YAGEO | RC0603JR-071KL | Future | RC0603JR-071KL | - | - | - | -
 | R166 | R0603-5% 10K | Chip Resistor 5% 0603 10k | SMT | 10k | MULTICOMP | MC 0.063W 0603 5% 10K | Farnell | 9331700 | Panasonic Electronic Components | ERJ-3GEYJ103V | DigiKey | P10KGCT-ND | YAGEO | RC0603JR-0710KL | Future | RC0603JR-0710KL | - | - | - | -
NA | R167 | R0603-5% 0R | Chip Resistor 5% 0603 0R | SMT | 0R | VISHAY DRALORIC | CRCW06030000Z0EA | Farnell | 1469739 | Panasonic - ECG | ERJ-3GEY0R00V | Digikey | P0.0GCT-ND | YAGEO | RC0603JR-070RL | Future | RC0603JR-070RL | Uni ohm | 0603SAJ000JT50 | Comet | R0603 0R 5%
 | R168 | R0603-1% 365R | Chip Resistor 1% 0603 | SMT | 365R/1% | PANASONIC | ERJ3EKF3650V | Farnell | 2303109 | - | - | - | - | - | - | - | - | - | - | - | -
 | R169 | R0603-5% 10K | Chip Resistor 5% 0603 10k | SMT | 10k | MULTICOMP | MC 0.063W 0603 5% 10K | Farnell | 9331700 | Panasonic Electronic Components | ERJ-3GEYJ103V | DigiKey | P10KGCT-ND | YAGEO | RC0603JR-0710KL | Future | RC0603JR-0710KL | - | - | - | -
 | R170 | R0603-5% 0R | Chip Resistor 5% 0603 0R | SMT | 0R | VISHAY DRALORIC | CRCW06030000Z0EA | Farnell | 1469739 | Panasonic - ECG | ERJ-3GEY0R00V | Digikey | P0.0GCT-ND | YAGEO | RC0603JR-070RL | Future | RC0603JR-070RL | Uni ohm | 0603SAJ000JT50 | Comet | R0603 0R 5%
 | R171 | R0603-5% 100R | Chip Resistor 5% 0603 100R | SMT | 100R | MULTICOMP | MC 0.063W 0603 5% 100R | Farnell | 9331689 | Yageo | RC0603FR-07100RL | Digikey | 311-100HRCT-ND | YAGEO | RC0603JR-07100RL | Future | RC0603JR-07100RL | - | - | - | -
 | R172 | R0603-5% 100R | Chip Resistor 5% 0603 100R | SMT | 100R | MULTICOMP | MC 0.063W 0603 5% 100R | Farnell | 9331689 | Yageo | RC0603FR-07100RL | Digikey | 311-100HRCT-ND | YAGEO | RC0603JR-07100RL | Future | RC0603JR-07100RL | - | - | - | -
 | R173 | R0603-5% 1K8 | Chip Resistor 5% 0603 1k8 | SMT | 1k8 | MULTICOMP | MC 0.063W 0603 5% 1K8 | Farnell | 9331867 | Yageo | RC0603JR-071K8L | Digikey | 311-1.8KGRCT-ND | - | - | - | - | - | - | - | -
 | R174 | R0603-5% 10K | Chip Resistor 5% 0603 10k | SMT | 10k | MULTICOMP | MC 0.063W 0603 5% 10K | Farnell | 9331700 | Panasonic Electronic Components | ERJ-3GEYJ103V | DigiKey | P10KGCT-ND | YAGEO | RC0603JR-0710KL | Future | RC0603JR-0710KL | - | - | - | -
 | R175 | R0603-5% 22R | Chip Resistor 5% 0603 22R | SMT | 22R | MULTICOMP | MC 0.063W 0603 5% 22R | Farnell | 9331891 | Stackpole Electronics Inc | RMCF0603JT22R0 | Digikey | RMCF0603JT22R0CT-ND | YAGEO | RC0603JR-0722RL | Future | RC0603JR-0722RL | Uni ohm | 0603SAJ0220T50 | Comet | R0603 22R 5%
 | R176 | R0603-5% 22R | Chip Resistor 5% 0603 22R | SMT | 22R | MULTICOMP | MC 0.063W 0603 5% 22R | Farnell | 9331891 | Stackpole Electronics Inc | RMCF0603JT22R0 | Digikey | RMCF0603JT22R0CT-ND | YAGEO | RC0603JR-0722RL | Future | RC0603JR-0722RL | Uni ohm | 0603SAJ0220T50 | Comet | R0603 22R 5%
 | R177 | R0603-5% 22R | Chip Resistor 5% 0603 22R | SMT | 22R | MULTICOMP | MC 0.063W 0603 5% 22R | Farnell | 9331891 | Stackpole Electronics Inc | RMCF0603JT22R0 | Digikey | RMCF0603JT22R0CT-ND | YAGEO | RC0603JR-0722RL | Future | RC0603JR-0722RL | Uni ohm | 0603SAJ0220T50 | Comet | R0603 22R 5%
 | R178 | R0603-5% 22R | Chip Resistor 5% 0603 22R | SMT | 22R | MULTICOMP | MC 0.063W 0603 5% 22R | Farnell | 9331891 | Stackpole Electronics Inc | RMCF0603JT22R0 | Digikey | RMCF0603JT22R0CT-ND | YAGEO | RC0603JR-0722RL | Future | RC0603JR-0722RL | Uni ohm | 0603SAJ0220T50 | Comet | R0603 22R 5%
 | R179 | R0603-5% 22R | Chip Resistor 5% 0603 22R | SMT | 22R | MULTICOMP | MC 0.063W 0603 5% 22R | Farnell | 9331891 | Stackpole Electronics Inc | RMCF0603JT22R0 | Digikey | RMCF0603JT22R0CT-ND | YAGEO | RC0603JR-0722RL | Future | RC0603JR-0722RL | Uni ohm | 0603SAJ0220T50 | Comet | R0603 22R 5%
 | R180 | R0603-5% 22R | Chip Resistor 5% 0603 22R | SMT | 22R | MULTICOMP | MC 0.063W 0603 5% 22R | Farnell | 9331891 | Stackpole Electronics Inc | RMCF0603JT22R0 | Digikey | RMCF0603JT22R0CT-ND | YAGEO | RC0603JR-0722RL | Future | RC0603JR-0722RL | Uni ohm | 0603SAJ0220T50 | Comet | R0603 22R 5%
 | R181 | R0603-5% 22R | Chip Resistor 5% 0603 22R | SMT | 22R | MULTICOMP | MC 0.063W 0603 5% 22R | Farnell | 9331891 | Stackpole Electronics Inc | RMCF0603JT22R0 | Digikey | RMCF0603JT22R0CT-ND | YAGEO | RC0603JR-0722RL | Future | RC0603JR-0722RL | Uni ohm | 0603SAJ0220T50 | Comet | R0603 22R 5%
 | R182 | R0603-5% 22R | Chip Resistor 5% 0603 22R | SMT | 22R | MULTICOMP | MC 0.063W 0603 5% 22R | Farnell | 9331891 | Stackpole Electronics Inc | RMCF0603JT22R0 | Digikey | RMCF0603JT22R0CT-ND | YAGEO | RC0603JR-0722RL | Future | RC0603JR-0722RL | Uni ohm | 0603SAJ0220T50 | Comet | R0603 22R 5%
 | R183 | R0603-5% 100R | Chip Resistor 5% 0603 100R | SMT | 100R | MULTICOMP | MC 0.063W 0603 5% 100R | Farnell | 9331689 | Yageo | RC0603FR-07100RL | Digikey | 311-100HRCT-ND | YAGEO | RC0603JR-07100RL | Future | RC0603JR-07100RL | - | - | - | -
 | R184 | R0603-5% 100R | Chip Resistor 5% 0603 100R | SMT | 100R | MULTICOMP | MC 0.063W 0603 5% 100R | Farnell | 9331689 | Yageo | RC0603FR-07100RL | Digikey | 311-100HRCT-ND | YAGEO | RC0603JR-07100RL | Future | RC0603JR-07100RL | - | - | - | -
 | R185 | R0603-5% 100R | Chip Resistor 5% 0603 100R | SMT | 100R | MULTICOMP | MC 0.063W 0603 5% 100R | Farnell | 9331689 | Yageo | RC0603FR-07100RL | Digikey | 311-100HRCT-ND | YAGEO | RC0603JR-07100RL | Future | RC0603JR-07100RL | - | - | - | -
 | R186 | R0603-5% 100R | Chip Resistor 5% 0603 100R | SMT | 100R | MULTICOMP | MC 0.063W 0603 5% 100R | Farnell | 9331689 | Yageo | RC0603FR-07100RL | Digikey | 311-100HRCT-ND | YAGEO | RC0603JR-07100RL | Future | RC0603JR-07100RL | - | - | - | -
 | R187 | R0603-5% 100R | Chip Resistor 5% 0603 100R | SMT | 100R | MULTICOMP | MC 0.063W 0603 5% 100R | Farnell | 9331689 | Yageo | RC0603FR-07100RL | Digikey | 311-100HRCT-ND | YAGEO | RC0603JR-07100RL | Future | RC0603JR-07100RL | - | - | - | -
 | R188 | R0603-5% 2K | Chip Resistor 5% 0603 2k0 | SMT | 2k | MULTICOMP | MCMR06X202 JTL | Farnell | 2073423 | Panasonic Electronic Components | ERJ-3GEYJ202V | DigiKey | P2.0KGTR-ND | YAGEO | RC0603JR-072KL | Future | RC0603JR-072KL | - | - | Comet | R0603 2.0K 5% YAG/ASJ
 | R189 | R0603-5% 22R | Chip Resistor 5% 0603 22R | SMT | 22R | MULTICOMP | MC 0.063W 0603 5% 22R | Farnell | 9331891 | Stackpole Electronics Inc | RMCF0603JT22R0 | Digikey | RMCF0603JT22R0CT-ND | YAGEO | RC0603JR-0722RL | Future | RC0603JR-0722RL | Uni ohm | 0603SAJ0220T50 | Comet | R0603 22R 5%
 | R190 | R0603-5% 22R | Chip Resistor 5% 0603 22R | SMT | 22R | MULTICOMP | MC 0.063W 0603 5% 22R | Farnell | 9331891 | Stackpole Electronics Inc | RMCF0603JT22R0 | Digikey | RMCF0603JT22R0CT-ND | YAGEO | RC0603JR-0722RL | Future | RC0603JR-0722RL | Uni ohm | 0603SAJ0220T50 | Comet | R0603 22R 5%
 | R191 | R0603-5% 22R | Chip Resistor 5% 0603 22R | SMT | 22R | MULTICOMP | MC 0.063W 0603 5% 22R | Farnell | 9331891 | Stackpole Electronics Inc | RMCF0603JT22R0 | Digikey | RMCF0603JT22R0CT-ND | YAGEO | RC0603JR-0722RL | Future | RC0603JR-0722RL | Uni ohm | 0603SAJ0220T50 | Comet | R0603 22R 5%
 | R192 | R0603-5% 22R | Chip Resistor 5% 0603 22R | SMT | 22R | MULTICOMP | MC 0.063W 0603 5% 22R | Farnell | 9331891 | Stackpole Electronics Inc | RMCF0603JT22R0 | Digikey | RMCF0603JT22R0CT-ND | YAGEO | RC0603JR-0722RL | Future | RC0603JR-0722RL | Uni ohm | 0603SAJ0220T50 | Comet | R0603 22R 5%
 | S1 | BMP180 | Digital pressure sensor | SMT | BMP180 | BOSCH | BMP180 | Mouser | 262-BMP180 | - | - | - | - | BOSCH | BMP180-0273300244 | Future | BMP180-0273300244 | - | - | - | -
 | S2 | LSM303DTR | ACCELEROMETER 3D MAGNO 16LGA | SMT | LSM303DTR | STMicroelectronics | LSM303DTR | Farnell | 2433076 | STMicroelectronics | LSM303DTR | Digikey | 497-13819-1-ND | - | - | - | - | - | - | - | -
 | SP1 | SP_ Sig 2/Circle 0.20 | SP_ Sig 2/Circle 0.20 | SMT
 | SP2 | SP_ Sig 2/Circle 0.20 | SP_ Sig 2/Circle 0.20 | SMT
 | SP3 | SP_ Sig 2/Circle 0.20 | SP_ Sig 2/Circle 0.20 | SMT
 | SW1 | WURTH 436353045816 | SWITCH 160GF SIDE WTE J-BEND BOSS | SMT | WURTH 436353045816 | WURTH ELEKTRONIK | 436353045816 | Farnell | 1868021 | - | - | - | - | - | - | - | - | - | - | - | -
 | SW2 | WURTH 436353045816 | SWITCH 160GF SIDE WTE J-BEND BOSS | SMT | WURTH 436353045816 | WURTH ELEKTRONIK | 436353045816 | Farnell | 1868021 | - | - | - | - | - | - | - | - | - | - | - | -
 | SW3 | WURTH 436353045816 | SWITCH 160GF SIDE WTE J-BEND BOSS | SMT | WURTH 436353045816 | WURTH ELEKTRONIK | 436353045816 | Farnell | 1868021 | - | - | - | - | - | - | - | - | - | - | - | -
 | SW4 | WURTH 436353045816 | SWITCH 160GF SIDE WTE J-BEND BOSS | SMT | WURTH 436353045816 | WURTH ELEKTRONIK | 436353045816 | Farnell | 1868021 | - | - | - | - | - | - | - | - | - | - | - | -
 | SW5 | WURTH 436353045816 | SWITCH 160GF SIDE WTE J-BEND BOSS | SMT | WURTH 436353045816 | WURTH ELEKTRONIK | 436353045816 | Farnell | 1868021 | - | - | - | - | - | - | - | - | - | - | - | -
 | SW6 | B3F-1020 | SWITCH 6X6 SPNO 100GF | THT | B3F-1020 | Omron Electronics Inc-ECB Div | B3F-1020 | Farnell | 1960939 | - | - | DigiKey | SW402-ND | - | - | - | - | - | - | - | -
 | SW7 | OS102011MA1QN1 | Slide RA SW 100mA 12V On/On THT | THT | OS102011MA1QN1 / Slide Switch | C&K Components | OS102011MA1QN1 | Farnell | 1201431 | - | - | - | - | - | - | - | - | - | - | - | -
 | T1 | TAP STRAIGHT 726386-2 | TAP STRAIGHT 6.3x0.8mm H=8mm | THT | 726386-2 | TE CONNECTIVITY / AMP | 726386-2 | Farnell | 4215618 | TE CONNECTIVITY / AMP | 726386-2 | Digikey | A114371-ND | - | - | - | - | - | - | - | -
 | T2 | TAP STRAIGHT 726386-2 | TAP STRAIGHT 6.3x0.8mm H=8mm | THT | 726386-2 | TE CONNECTIVITY / AMP | 726386-2 | Farnell | 4215618 | TE CONNECTIVITY / AMP | 726386-2 | Digikey | A114371-ND | - | - | - | - | - | - | - | -
 | U1 | TPS2061CDBVT | LOAD SWITCH 5.5V 1A ACT LW 5SOT23 | SMT | TPS2061CDBVT | TEXAS INSTRUMENTS | TPS2061CDBVT | Farnell | 2307990 | TEXAS INSTRUMENTS | TPS2061CDBVT | Digikey | 296-35522-1-ND | - | - | - | - | - | - | - | -
 | U2 | VBUS053CZ-HAF-G-08 | DIODE TVS ARR USB 28V LLP75-7L | SMT | VBUS053CZ-HAF-G-08 | VISHAY SEMICONDUCTOR | VBUS053CZ-HAF-G-08 | Farnell | 1864888 | - | - | - | - | - | - | - | - | - | - | - | -
 | U3 | TPS2061CDBVT | LOAD SWITCH 5.5V 1A ACT LW 5SOT23 | SMT | TPS2061CDBVT | TEXAS INSTRUMENTS | TPS2061CDBVT | Farnell | 2307990 | TEXAS INSTRUMENTS | TPS2061CDBVT | Digikey | 296-35522-1-ND | - | - | - | - | - | - | - | -
 | U4 | VBUS053CZ-HAF-G-08 | DIODE TVS ARR USB 28V LLP75-7L | SMT | VBUS053CZ-HAF-G-08 | VISHAY SEMICONDUCTOR | VBUS053CZ-HAF-G-08 | Farnell | 1864888 | - | - | - | - | - | - | - | - | - | - | - | -
 | U5 | FT232RQ - QFN32 | USB to Serial UART QFN32 | SMT | FT232RQ | FTDI | FT232RQ | Farnell | 1146033 | FTDI | FT232RQ | Digikey | 768-1008-1-ND | FTDI | FT232RQ | Comet | FT232RQ SMD | - | - | - | -
 | U6 | FT232RQ - QFN32 | USB to Serial UART QFN32 | SMT | FT232RQ | FTDI | FT232RQ | Farnell | 1146033 | FTDI | FT232RQ | Digikey | 768-1008-1-ND | FTDI | FT232RQ | Comet | FT232RQ SMD | - | - | - | -
 | U7 | TPS2041BDBV | Power-Distribution Switches SOT-23 | SMT | TPS2041BDBV | TEXAS INSTRUMENTS | TPS2041BDBVR | Farnell | 1703472 | - | - | - | - | - | - | - | - | - | - | - | -
 | U8 | VBUS053CZ-HAF-G-08 | DIODE TVS ARR USB 28V LLP75-7L | SMT | VBUS053CZ-HAF-G-08 | VISHAY SEMICONDUCTOR | VBUS053CZ-HAF-G-08 | Farnell | 1864888 | - | - | - | - | - | - | - | - | - | - | - | -
 | U9 | VBUS054CD-FHI-GS08 | QUAD BUS PROTECTION ARRAY | SMT | VBUS054CD-FHI-GS08 | VISHAY SEMICONDUCTOR | VBUS054CD-FHI-GS08 | Farnell | 1697039 | - | - | - | - | - | - | - | - | - | - | - | -
 | U10 | L3GD20 | IC MEMS MOTION SENSOR LGA-16 4x4x1 | SMT | L3GD20 | STMicroelectronics | L3GD20TR | Farnell | 2295818 | STMicroelectronics | L3GD20TR | Digikey | 497-12081-1-ND | - | - | - | - | - | - | - | -
 | U11 | GPS UBLOX LEA-6S | GPS UBLOX LEA-6S | SMT | LEA-6S | UBLOX | LEA-6S | Microdis.net | LEA-6S | - | - | - | - | - | - | - | - | - | - | - | -
 | U12 | TSC2007IPW | Nano-Power Touch Screen Controller with I2C Serial Interface | SMT | TSC2007IPW | TEXAS INSTRUMENTS | TSC2007IPW | Farnell | 1703440 | TEXAS INSTRUMENTS | TSC2007IPW | Digikey | 296-27124-1-ND | - | - | - | - | - | - | - | -
 | U13 | IS42S16400J-7TLI | DRAM - Synchronous TSOP-II 4M x 16bit | SMT | IS42S16400J-7TLI | INTEGRATED SILICON SOLUTION | IS42S16400J-7TLI | Farnell | 2253831 | INTEGRATED SILICON SOLUTION | IS42S16400J-7TLI | Digikey | 706-1132-ND | - | - | - | - | - | - | - | -
 | U14 | STM32F429ZIT6 | IC MCU 32BIT 2MB FLASH 144LQFP | SMT | STM32F429ZIT6 | STMICROELECTRONICS | STM32F429ZIT6 | Farnell | 2393661 | STMICROELECTRONICS | STM32F429ZIT6 | Digikey | 497-14053-ND | - | - | - | - | - | - | - | -
 | U15 | TPS2034D | 2.2A 2.7-5.5V Single Hot-Swap IC Hi-Side MOSFET Fault Report Act-High Enable | SMT | TPS2034D | TEXAS INSTRUMENTS | TPS2034D | Farnell | 1755301 | TEXAS INSTRUMENTS | TPS2034D | Digikey | 296-26905-1-ND | - | - | - | - | - | - | - | -
 | U16 | TPS54332DDA | 3.5A 28V 1MHz STEP DOWN | SMT | TPS54332DDA | TI | TPS54332DDA | Farnell | 1710821 | TI | TPS54332DDA | Digi-Key | 296-24141-5-ND | - | - | - | - | - | - | - | -
 | U17 | TPS54332DDA | 3.5A 28V 1MHz STEP DOWN | SMT | TPS54332DDA | TI | TPS54332DDA | Farnell | 1710821 | TI | TPS54332DDA | Digi-Key | 296-24141-5-ND | - | - | - | - | - | - | - | -
 | U18 | LTC2954CTS8-2 | IC PB ON/OFF CONTROLLER TSOT23-8 | SMT | LTC2954CTS8-2 | Linear Technology | LTC2954CTS8-2#TRMPBF | Farnell | 1663887 | Linear Technology | LTC2954CTS8-2#TRMPBF | Digikey | LTC2954CTS8-2#TRMPBFCT-ND | - | - | - | - | - | - | - | -
 | U19 | LM358DT | OP AMP DUAL LOW POWER 1.1MHZ | SMT | LM358DT | STMICROELECTRONICS | LM358DT | Farnell | 1564331 | STMICROELECTRONICS | LM358DT | Digikey | 497-1591-1-ND | On Semiconductor | LM358DR2G | Comet | LM358D SMD | - | - | - | -
 | U20 | SN74AHC1G09DBVR | IC LOGIC AND SINGLE 5SOT23 | SMT | SN74AHC1G09DBVR | Texas Instruments | SN74AHC1G09DBVR | Farnell | 2342469 | - | - | - | - | - | - | - | - | - | - | - | -
 | U21 | TPD12S521DBTR | HDMI Receiver Port Protection and Interface 38-TSSOP | SMT | TPD12S521DBTR | TEXAS INSTRUMENTS | TPD12S521DBTR | Farnell | 2335651 | TEXAS INSTRUMENTS | TPD12S521DBTR | Digikey | 296-24020-1-ND | - | - | - | - | - | - | - | -
 | U22 | SN74LVC07APW | HEX Buffer Open-Drain TSSOP14 | SMT | SN74LVC07APW | TI | SN74LVC07APW | Farnell | 1236302 | TI | SN74LVC07APW | Digikey | 296-8442-1-ND | - | - | - | - | - | - | - | -
 | U23 | SN74LVC07APW | HEX Buffer Open-Drain TSSOP14 | SMT | SN74LVC07APW | TI | SN74LVC07APW | Farnell | 1236302 | TI | SN74LVC07APW | Digikey | 296-8442-1-ND | - | - | - | - | - | - | - | -
 | U24 | SN74AHC1G09DBVR | IC LOGIC AND SINGLE 5SOT23 | SMT | SN74AHC1G09DBVR | Texas Instruments | SN74AHC1G09DBVR | Farnell | 2342469 | - | - | - | - | - | - | - | - | - | - | - | -
 | U25 | SN74AHC1G09DBVR | IC LOGIC AND SINGLE 5SOT23 | SMT | SN74AHC1G09DBVR | Texas Instruments | SN74AHC1G09DBVR | Farnell | 2342469 | - | - | - | - | - | - | - | - | - | - | - | -
 | U26 | M25P32-VME6G | FLASH 32MBIT | SMT | M25P32-VME6G | MICRON | M25P32-VME6G | Farnell | 1099666 | - | - | - | - | - | - | - | - | - | - | - | -
 | Y1 | ABS07-32.768KHZ-T | CRYSTAL 32.768KHZ 12.5PF SMD | SMT | ABS07-32.768KHZ-T | Abracon Corporation | ABS07-32.768KHZ-T | Farnell | 2101347 | Abracon Corporation | ABS07-32.768KHZ-T | Digikey | 535-9542-1-ND | Abracon Corporation | ABS07-32.768KHZ-T | Future | ABS07-32.768KHZ-T | - | - | - | -
 | Y2 | ABMM2-8.000MHZ-E2-T | CRYSTAL 8M 18PF CL 6X3.6MM SMT | SMT | 8MHz - ABBM2 | ABRACON | ABMM2-8.000MHZ-E2-T | Farnell | 1611803 | ABRACON | ABMM2-8.000MHZ-E2-T | Digikey | 535-9628-1-ND | ABRACON | ABMM2-8.000MHZ-E2-T | Future | ABMM2-8.000MHZ-E2-T | - | - | - | -

Sheet: QTY BOM
 | DATE: | 2015-04-19 | QTY BOM
 | PROJECT: | Colibri_Rev1j
 | Part Name Library | Value | Description | Qty | Location | Type | Maker | Maker Part Name | Provider | Provider Part Name | Maker2 | Maker2 Part Name | Provider2 | Provider2 Part Name | Maker3 | Maker3 Part Name | Provider3 | Provider3 Part Name | Maker4 | Maker4 Part Name | Provider4 | Provider4 Part Name
A | 1575AT43A0040E | 1575AT43A0040E | ANTENNA CHIP GPS 1575 MHZ | 1 | A1; | SMT | Johanson Technology Inc | 1575AT43A0040E | Digikey | 712-1003-1-ND | - | - | Mouser | 609-1575AT43A0040E | - | - | - | - | - | - | - | -
AREA | PATCH AREA 2.54/5X10/2X2/DRILL 1.00 | Patch Area 2.54/5x10/2x2/drill 1.00 | Patch Area 2.54/5x10/2x2/drill 1.00 | 1 | AREA1; | THT | - | - | - | - | - | - | - | - | - | - | - | - | - | - | - | -
B | WURTH 79527141 / BATTERY HOLDER 2032 | Battery Holder 2032 | Battery Holder WA-BCMC 2032 | 1 | B1; | SMT | WURTH ELEKTRONIK | 795 271 41 | WURTH ELEKTRONIK | - | - | - | - | - | - | - | - | - | - | - | - | -
C | C0603-10n/50V/X7R | 10n/50V/X7R | Chip Capacitor 0603 10nF/50V/X7R | 2 | C28;C75; | SMT | KEMET | C0603C103K5RACTU | Farnell | 1414609 | KEMET | C0603C103K5RACTU | DigiKey | 399-1091-1-ND | SAMSUNG | CL10B103KB8NNNC | Future | CL10B103KB8NNNC | MURATA | GRM216R71H103KA01D | Farnell | 1828948
C | C0805-10u/16V/X5R | 10u/16V/X5R | CAP CER 10UF 16V 20% X5R 0805 | 16 | C3;C4;C6;C9;C12;C19;C25;C27;C49;C53;C72;C74;C76;C77;C82;C94; | SMT | MURATA | GRM21BR61C106KE15L | Farnell | 1762635 | TDK Corporation | C2012X5R1C106M/1.25 | Digikey | 445-4115-1-ND | SAMSUNG | CL21A106KOQNNNE | Comet | C0805 10uF 16V X5R SAMSUN | - | - | - | -
C | C0603-470N/25V/±10%/X7R | 470n/25V/X7R | Chip Capacitor 0603 470n/±10%/25V/X7R | 1 | C29; | SMT | MULTICOMP | MCCA001174 | Farnell | 1856365 | - | - | - | - | - | - | - | - | - | - | - | -
C | C1206-4u7/25V/X7R | 4u7/25V | Chip Capacitor 1206 4u7/25V | 4 | C79;C80;C84;C85; | SMT | KEMET | C1206X475K3RAC | Farnell | 1414061 | Samsung | CL31B475KAHNNNE | Comet | C1206 4.7uF 25V X7R SAMSUNG | - | - | - | - | - | - | - | -
C | C0603-10p/±0.25pF/NPO | 10p/50V/NPO | Chip Capacitor 0603 10p/±0.25pF/NPO | 4 | C32;C33;C87;C91; | SMT | KEMET | C0603C100C5GAC | Farnell | 1414599 | KEMET | C0603C100C5GACTU | Digikey | C0603C100C5GACTU-ND | YAGEO AMERICA CORPORATION | CC0603CRNPO9BN100 | Future | CC0603CRNPO9BN100 | - | - | - | -
C | C0603-4u7/6V3/X5R | 4u7/6V3/X5R | Chip Capacitor 0603 4u7/6V3/X5R/10% | 1 | C24; | SMT | AVX | 06036D475KAT2A | Farnell | 1833803 | TDK Corporation | C1608X6S0J475K | Digikey | 445-7446-1-ND | - | - | - | - | - | - | -
C | C0603-47p/50V/C0G/5% | 47p/50V | Chip Capacitor 0603 47p/50V | 4 | C15;C16;C36;C37; | SMT | KEMET | C0603C470J1GACTU | Farnell | 1813433 | KEMET | C0603C470J1GACTU | Digikey | 399-7917-1-ND | AVX | 06035A470JAT2A | Future | 06035A470JAT2A | SAMSUNG | CL10C470JBNC | Comet | C0603 47pF 50V C0G SAMSUN
C | C0603-2u2/10V/X5R | 2u2/10V/X5R | CAP CER 2.2UF 10V 10% X5R 0603 | 4 | C34;C56;C69;C117; | SMT | KEMET | C0603C225K8PAC7867 | Farnell | 1108322 | Kemet | C0603C225K8PACTU | Digikey | 399-4911-1-ND | SAMSUNG | CL10A225KO8NNNC | Comet | C0603 2.2uF 16V X5R SAMSU | - | - | - | -
C | C_Tantalum C 220u/6V3 | 220u/6V3_T | Tantal Capacitor Case C 220u/6V3 | 2 | C8;C17; | SMT | AVX | TPSC227K006R0125 | Farnell | 1462420 | AVX | TPSC227K006R0125 | Digikey | 478-1768-1-ND | AVX | TPSC227K006R0125 | Future | TPSC227K006R0125 | - | - | - | -
C | C0603-33n/50V/X7R/10% | 33n/50V/10%/X7R | Chip Capacitor 0603 33n/50V/X7R/10% | 1 | C90; | SMT | KEMET | C0603C333K5RAC | Farnell | 1414636 | KEMET | C0603C333K5RAC | Digikey | 399-7906-1-ND | - | - | - | - | - | - | - | -
C | C0603-470p/50V/10%/X7R | 470p/50V | CAP CERM X7R 470PF 50V 0603 | 2 | C88;C92; | SMT | AVX | 06035C471KAT2A | Farnell | 498580 | - | - | - | - | - | - | - | - | - | - | - | -
C | C0603-8n2/50V/±10%/X7R | 8n2/50V | Chip Capacitor 0603 8n2/50V/±0.10%/X7R | 2 | C81;C86; | SMT | KEMET | C0603C822K5RACTU | Farnell | 1865533 | KEMET | C0603C822K5RACTU | Digikey | 399-7961-1-ND | - | - | - | - | - | - | - | -
C | C_EL/SIZE5.0X5.5/-22U/35V | 22uF/35V | Electrolitic Capacitor SMD 22uF 35V | 3 | C102;C105;C109; | SMT | WURTH ELEKTRONIK | 865080542006 | Farnell | 2466315 | - | - | - | - | - | - | - | - | - | - | - | -
C | C0603-15p/50V/1%/NP0 | 15p/50V/1% | Chip Capacitor 0603-15p/50V/1%/NP0 | 2 | C30;C31; | SMT | MULTICOMP | MCCA000984 | Farnell | 1856143 | Samsung Electro-Mechanics | CL10C150JBNC | Comet | C0603 15pF 50V C0G SAMSUNG | YAGEO | CC0603FRNPO9BN150 | Future | CC0603FRNPO9BN150 | - | - | - | -
C | C0603-220n/50V/±10%/X7R | 220n/50V/X7R | CAP CER 0.22UF 50V 10% X7R 0603 | 1 | C22; | SMT | TDK Corporation | CGA3E3X7R1H224K080AB | Farnell | 2210924 | TDK Corporation | C1608X7R1H224K | Digikey | 445-7408-1-ND | UWA | - | Comet | C0603 220nF 50V Y5V | - | - | - | -
C | C0603-100N/50V/±10%/X7R | 100n/50V | Chip Capacitor 0603 100nF/50V/±10%/X7R | 65 | C1;C2;C5;C7;C10;C11;C13;C14;C18;C20;C21;C23;C26;C35;C38;C39;C40;C41;C42;C43;C44;C45;C46;C47;C48;C51;C52;C54;C55;C57;C58;C59;C60;C61;C62;C63;C64;C65;C66;C67;C68;C70;C71;C73;C78;C83;C89;C93;C95;C97;C98;C99;C100;C101;C103;C104;C106;C107;C108;C111;C112;C113;C114;C115;C116; | SMT | KEMET | C0603X104K5RAC | Farnell | 1414028 | Kemet | C0603X104K5RACTU | DigiKey | 399-7969-1-ND | SAMSUNG | CL10B104KB8NNNC | Future | CL10B104KB8NNNC | Samsung | CL10B104KBNC | Comet | C0603 100nF 50V X7R SAMSU
C | C0603-1u/25V/±10%/X7R | 1u/25V/X7R | CAP CER 1UF 25V 10% X7R 0603 | 3 | C50;C96;C110; | SMT | MURATA | GRM188R71E105KA12D | Farnell | 1735540 | TDK Corporation | C1608X7R1E105K080AB | Digi-Key | 445-5956-1-ND | - | - | - | - | - | - | - | -
CN | 612 020 216 21 | 612 020 216 21 | 2.54mm Male Box Header WR-BHD 20 pins | 1 | CN7; | THT | WURTH ELEKTRONIK | 612 020 216 21 | Farnell | 1642021 | - | - | - | - | - | - | - | - | - | - | - | -
CN | 629105150921 | 629105150921 | Micro USB 2.0 Type AB - Horizontal - WR-COM | 4 | CN2;CN3;CN5;CN6; | SMT | WURTH ELEKTRONIK | 629105150921 | WURTH ELEKTRONIK | 629105150921 | - | - | - | - | - | - | - | - | - | - | - | -
CN | 692121030100 | 692121030100 | USB 3.0 TYPE A RECEPTACLE THT RA | 1 | CN1; | THT | WURTH ELEKTRONIK | 692121030100 | Farnell | 1861251 | - | - | - | - | - | - | - | - | - | - | - | -
CN | FI-SE20P-HFE LVDS | FI-SE20P-HFE | FI-SE20P-HFE LVDS | 1 | CN9; | SMT | JAE Electronics | FI-SE20P-HFE | DigiKey | 670-1843-ND | - | - | - | - | - | - | - | - | - | - | - | -
CN | 687 118 145 22 | Wurth - 68711814522 | FFC 0.5MM R/A BOT ZIIF 18WAY | 1 | CN4; | SMT | WURTH ELEKTRONIK | 68711814522 | WURTH ELEKTRONIK | - | - | - | - | - | - | - | - | - | - | - | - | -
CN | 685119136923 | 685119136923 | Mini HDMI | 1 | CN11; | SMT | WURTH ELEKTRONIK | 685119136923 | WURTH ELEKTRONIK | 685119136923 | - | - | - | - | - | - | - | - | - | - | - | -
CN | 7499111121A | 7499111121A | JACK MODULAR RJ45 1PORT 8P8C 10/100/1000 Base-T | 1 | CN10; | THT | WURTH ELEKTRONIK | 7499111121A | Farnell | 2356115 | WURTH ELEKTRONIK | 7499111121A | Digikey | 1297-1070-5-ND | - | - | - | - | - | - | - | -
CN | YDJ-1134 | YDJ-1134 | DC Power Connector O2.0mm | 1 | CN12; | THT | - | YDJ-1134 | Comet | YDJ-1134 | - | - | - | - | - | - | - | - | - | - | - | -
CN | MM70-314-310B1-1-R300 | MM70-314-310B1-1-R300 | MEM SOCKET 314POS RT ANG GOLD | 1 | CN8; | SMT | JAE Electronics | MM70-314-310B1-1-R300 | DigiKey | 670-2431-1-ND | - | - | - | - | - | - | - | - | - | - | - | -
D | VS-15MQ040NTRPBF | VS-15MQ040NTRPBF | DIODE SCHOTTKY 3A 40V SMA | 2 | D6;D8; | SMT | VISHAY | VS-15MQ040NTRPBF | Farnell | 1463215 | VISHAY | VS-15MQ040NTRPBF | Digikey | 15MQ040NPBFCT-ND | - | - | - | - | - | - | - | -
D | BAS316 - SOD323 | BAS316 | Diode SOD323 | 4 | D1;D2;D5;D7; | SMT | NXP | BAS316 | Farnell | 8734275 | NXP | BAS316 | Digikey | 568-5003-1-ND | NXP | BAS316 | Future | BAS316 | - | - | - | -
D | B560C-13-F | B560C-13-F | SCHOTTKY RECTIFIER 60V 5A | 2 | D3;D4; | SMT | Diodes Incorporated | B560C-13-F | Farnell | 1858602 | Diodes Incorporated | B560C-13-F | Digikey | B560C-FDICT-ND | - | - | - | - | - | - | - | -
DL | LED 0603 WURTH - 150060RS75000 | LED 0603 RED | LED 0603 RED 250MCD 625NM | 8 | DL1;DL2;DL5;DL6;DL8;DL10;DL11;DL12; | SMT | WURTH ELEKTRONIK | 150060RS75000 | Farnell | 2322071 | WURTH ELEKTRONIK | 150060RS75000 | Digikey | 732-4978-1-ND | - | - | - | - | - | - | - | -
DL | LED 0603 WURTH - 150060GS75000 | LED 0603 GREEN | LED 0603 GREEN 430MCD 520NM | 4 | DL3;DL4;DL7;DL9; | SMT | WURTH ELEKTRONIK | 150060GS75000 | Farnell | 2322070 | WURTH ELEKTRONIK | 150060GS75000 | Digikey | 732-4971-1-ND | - | - | - | - | - | - | - | -
DZ | BZV55-C18 | BZV55-C18 | DIODE ZENER 500MW 18V 5% SOD80 | 1 | DZ3; | SMT | NXP | BZV55-C18 | Farnell | 1097211 | - | - | Comet | BZV55C18 | - | - | - | - | - | - | - | -
DZ | BZX384-B16 | BZX384-B16 | DIODE ZENER 300MW 16V 5% SOD323 | 1 | DZ2; | SMT | NXP | BZX384-B16 | Farnell | 1757828 | NXP | BZX384-B16 | Digikey | 568-3813-1-ND | - | - | - | - | - | - | - | -
DZ | BZX384-B3V3 | BZX384-B3V3 | DIODE ZENER 300MW 3V3 5% SOD323 | 1 | DZ1; | SMT | NXP | BZX384-C3V3 | Farnell | 8735646 | NXP | BZX384-B3V3 | DIGIKEY | 568-3826-1-ND | - | - | - | - | - | - | - | -
FB | FB - WURTH - 742792093 | 742792093 | FERRITE BEAD 0805 0.6OHM 0.2A | 2 | FB1;FB2; | SMT | WURTH ELECRONICS | 742792093 | Farnell | 1635726 | WURTH ELECRONICS | 742792093 | Digikey | 732-1609-1-ND | - | - | - | - | - | - | - | -
H | USD CARD HOLDER / 693072010801 WURTH | 693072010801 | Micro SD Connector Hinge Type | 1 | H1; | SMT | WURTH ELEKTRONIK | 693072010801 | Farnell | 2081364 | - | - | - | - | - | - | - | - | - | - | - | -
J | Header 3x2/100/0gr | Header 3x2/100/0gr | Header 2Rows 2.54mm S | 1 | J11; | THT | MULTICOMP | 2213S-06G | Farnell | 1593440 | - | - | - | - | - | - | - | - | - | - | - | -
J | HEADER 8X1/100/0GR | HEADER 8x1/100/0gr | Header 1Row 2.54mm S 8pos | 1 | J6; | THT | TE CONNECTIVITY / AMP | 826629-8 | Farnell | 3418364 | 3M | 961108-6404-AR | DigiKey | 3M9452-ND | Cvilux | CH31402V200 | Comet 1/5 | HN1X40 | - | - | - | -
J | HEADER 7X1/50/D0.70 | Header 7x1/50/d0.70 | Header 7x1/50/d0.70 NA | 1 | J2; | THT | NA | NA | NA | NA | NA | NA | NA | NA | NA | NA | NA | NA | NA | NA | NA | NA
J | HEADER 3X1/100/0GR | Header 3x1/100/0gr | Header 1Row 2.54mm S | 8 | J12;J13;J14;J15;J16;J17;J18;J19; | THT | Cvilux | CH31402V200 | Comet 1/13 | HN1X40 | HARWIN | M20-9990345 | Farnell | 1022248 | Sullins Connector Solutions | PTC03SAAN | DigiKey | S1012-03-ND | - | - | - | -
J | HEADER 7X1/100/0GR | Header 7x1/100/0gr | Header 1Row 2.54mm S | 1 | J5; | THT | - | - | - | - | - | - | - | - | - | - | - | - | - | - | - | -
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
