sigmadrone/sigmadrone/hardware/sto-1/assembly_sto-1.fcstd

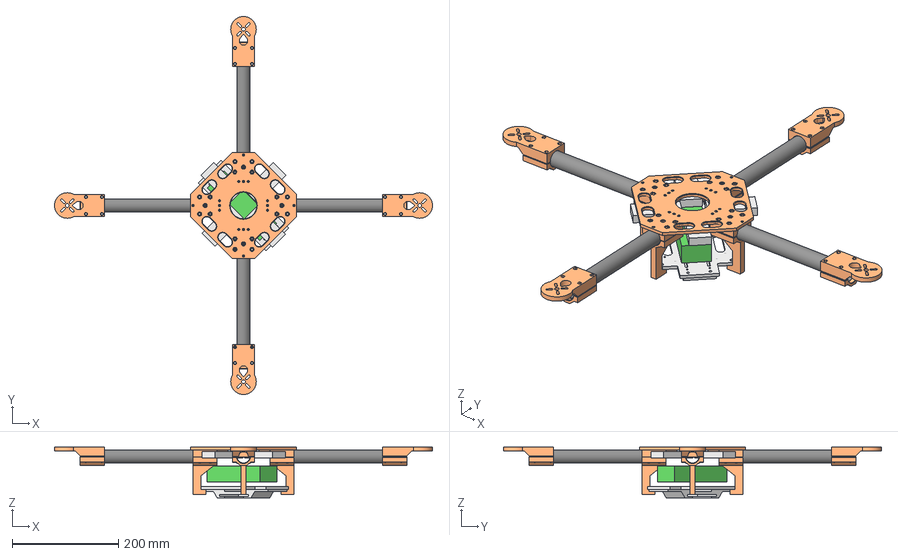
[picture p2: CAD file, 2016-06-22]
hardware/sto-1/assembly_sto-1.fcstd
710.0 x 710.0 x 95.0 mm
motor_mount_top_flat_01
tube_01
body_top_01
M3x20-Screw
M3-Nut
tube_02
tube_03
tube_04
motor_mount_top_flat_01001
motor_mount_top_flat_01002
motor_mount_top_flat_01003
body_tube_leg_01
body_tube_leg_01001
body_tube_leg_01002
body_tube_leg_01003
battery_01
esc_01
esc_02
esc_03
esc_04
motor_mount_bottom_01
motor_mount_bottom_02
motor_mount_bottom_03
motor_mount_bottom_04
stand_mount_01
body_bottom_01
M3x25-Screw
M3x10-Screw
