sigmadrone/sigmadrone/hardware/frame/colibri-v2-cover.fcstd

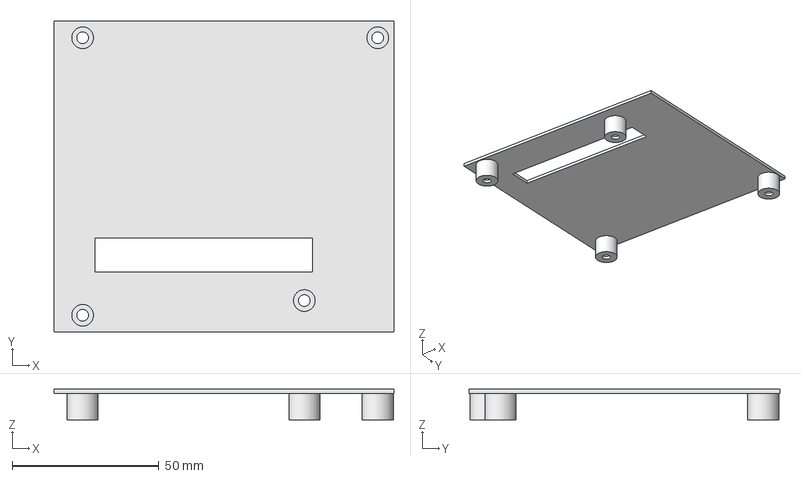
[picture p3: CAD file, 2016-10-18]
hardware/frame/colibri-v2-cover.fcstd
115.8 x 106.0 x 10.5 mm
