sigmadrone/sigmadrone/hardware/sto-1/colibri-v2-gyrotest-frame.fcstd

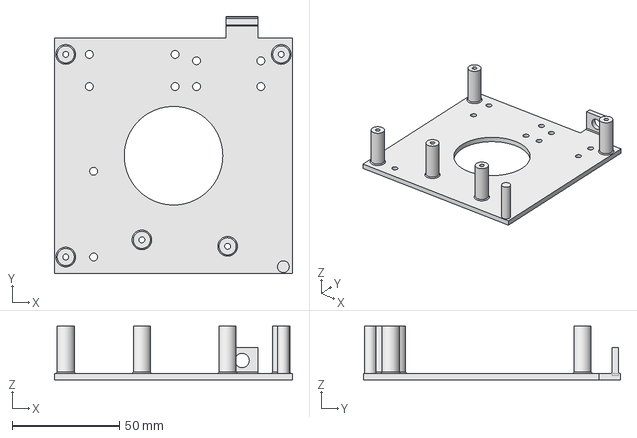
[picture p4: CAD file, 2016-06-29]
hardware/sto-1/colibri-v2-gyrotest-frame.fcstd
111.0 x 120.0 x 25.0 mm
