sigmadrone/sigmadrone/hardware/frame/colibri-v2-box.fcstd

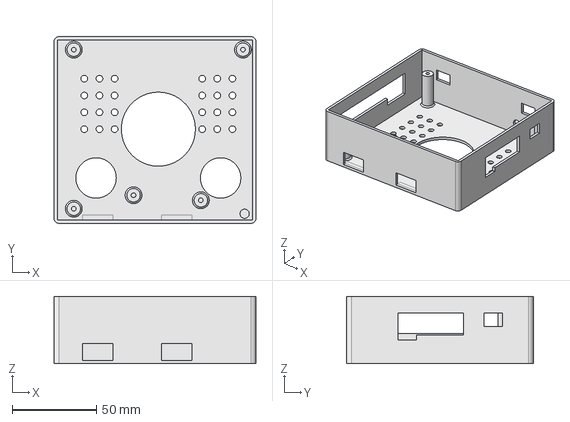
[picture p5: CAD file, 2016-10-18]
hardware/frame/colibri-v2-box.fcstd
120.0 x 111.0 x 40.0 mm
