sigmadrone/sigmadrone/hardware/sto-1/motor_mount_top-flat.fcstd

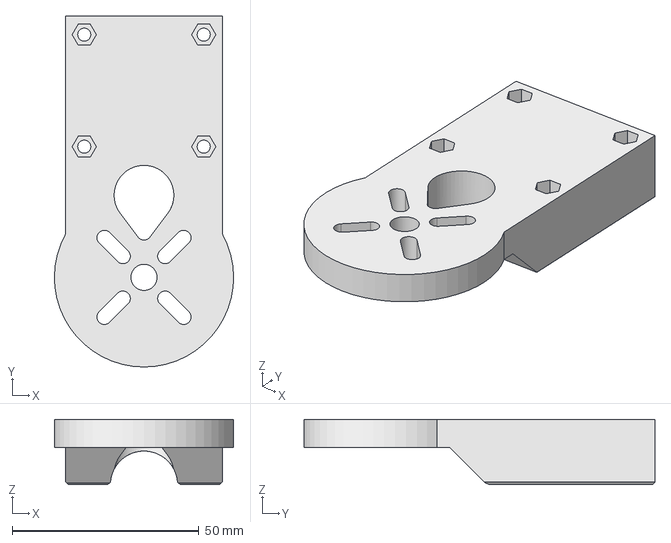
[picture p6: CAD file, 2016-06-22]
hardware/sto-1/motor_mount_top-flat.fcstd
48.0 x 94.0 x 17.5 mm
