sigmadrone/sigmadrone/hardware/frame/motor_base_landing_gear_2.fcstd

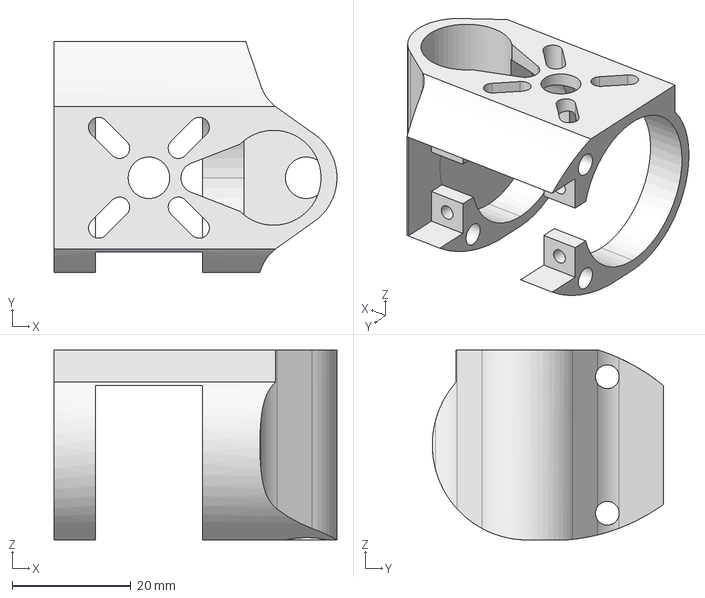
[picture p7: CAD file, 2016-05-19]
hardware/frame/motor_base_landing_gear_2.fcstd
47.7 x 39.0 x 32.0 mm
