sigmadrone/sigmadrone/hardware/sto-1/colibri-v2-frame-receiver-mnt.fcstd

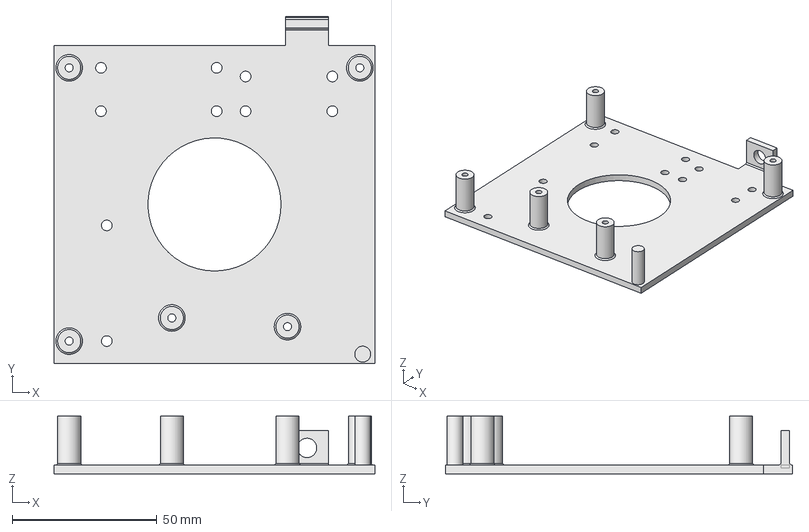
[picture p8: CAD file, 2016-06-22]
hardware/sto-1/colibri-v2-frame-receiver-mnt.fcstd
111.0 x 120.0 x 20.0 mm
