sigmadrone/sigmadrone/hardware/frame/motor_mount_cut.FCStd

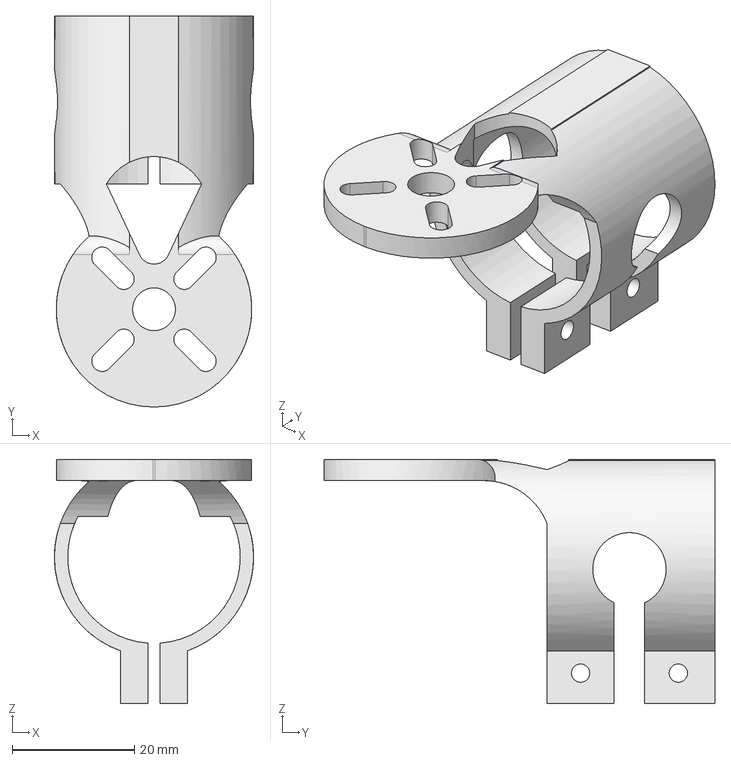
[picture p9: CAD file, 2016-05-17]
hardware/frame/motor_mount_cut.FCStd
32.6 x 64.0 x 40.0 mm
