sigmadrone/sigmadrone/hardware/sto-1/distribution-box.fcstd

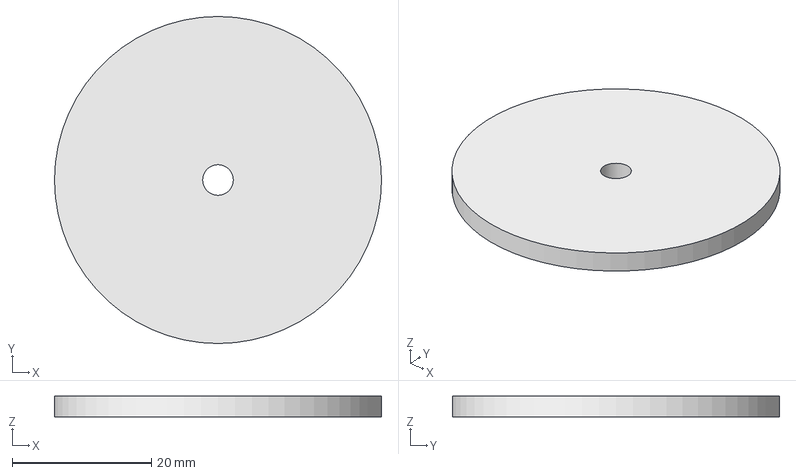
[picture p10: CAD file, 2016-06-22]
hardware/sto-1/distribution-box.fcstd
47.0 x 47.0 x 3.00 mm
