sigmadrone/sigmadrone/hardware/frame/motor_base_landing_gear.fcstd

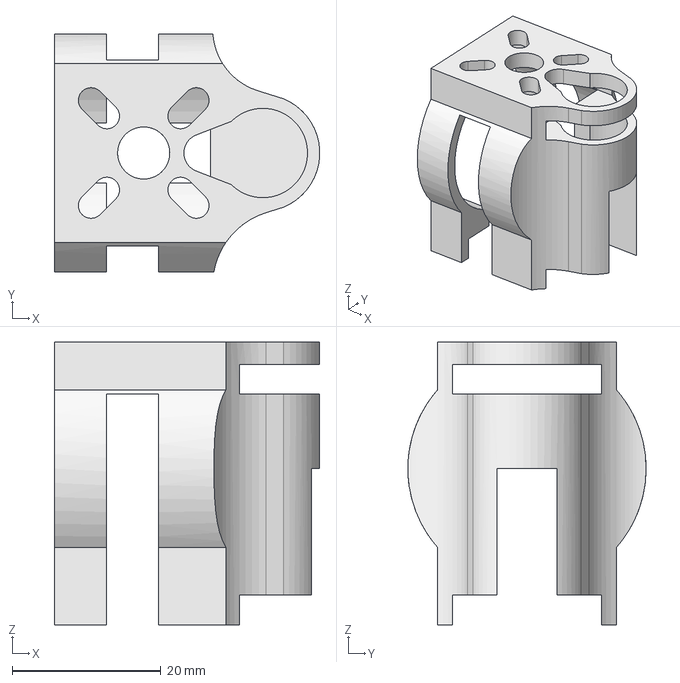
[picture p11: CAD file, 2016-05-12]
hardware/frame/motor_base_landing_gear.fcstd
35.6 x 32.0 x 38.0 mm
