sigmadrone/sigmadrone/hardware/sto-1/ar6260-holder.fcstd

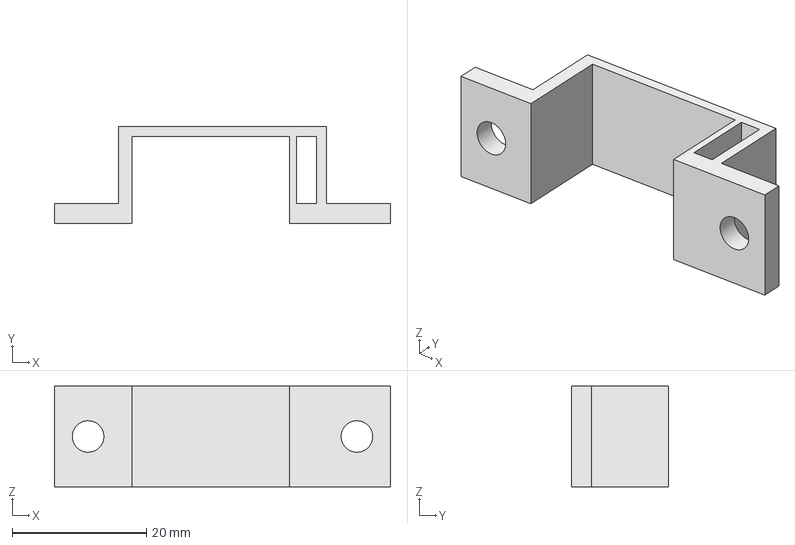
[picture p12: CAD file, 2016-06-22]
hardware/sto-1/ar6260-holder.fcstd
50.0 x 14.5 x 15.0 mm
