sigmadrone/sigmadrone/hardware/frame/body-bracket-c.fcstd

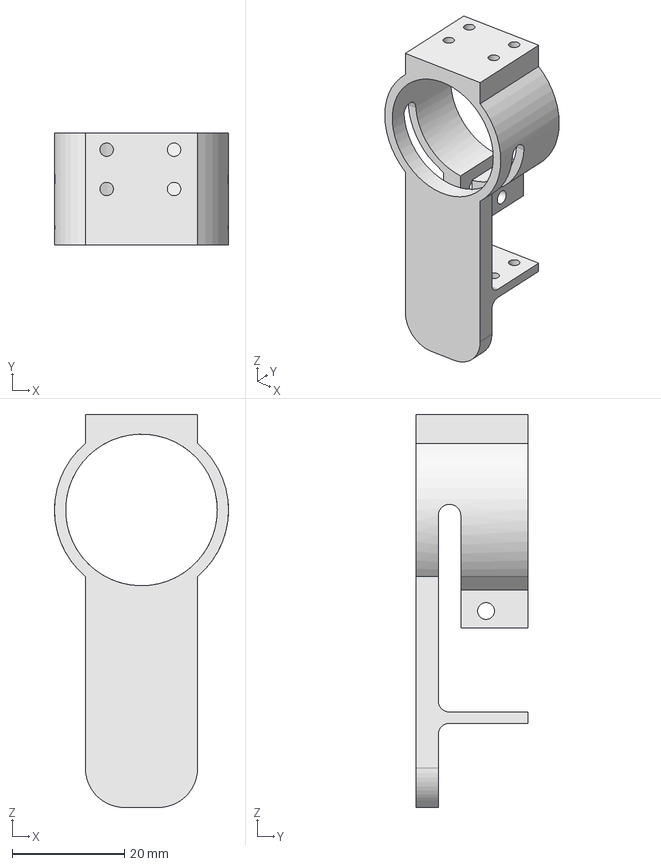
[picture p13: CAD file, 2016-04-26]
hardware/frame/body-bracket-c.fcstd
31.0 x 20.0 x 70.0 mm
