sigmadrone/sigmadrone/hardware/frame/motor_mount.FCStd

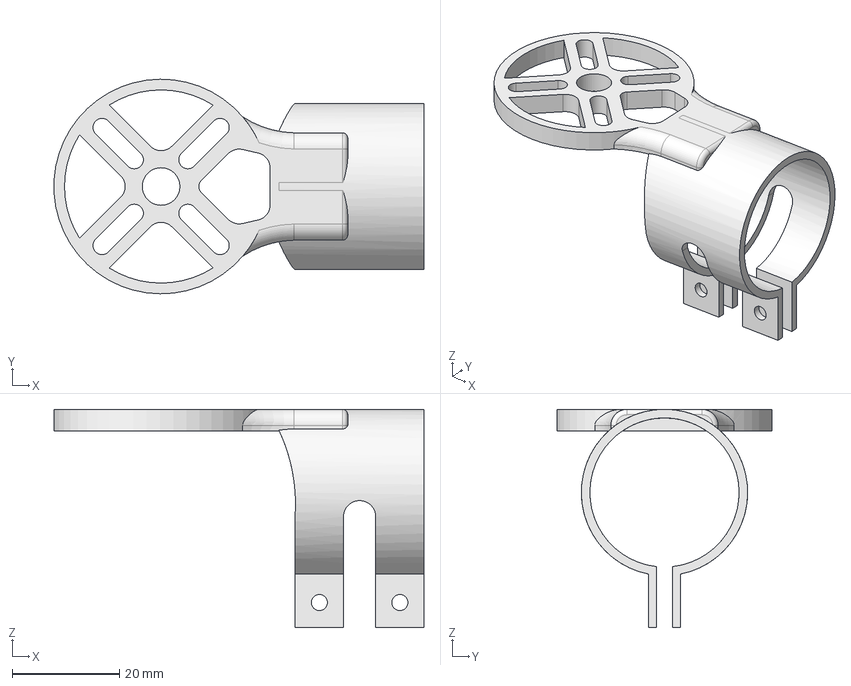
[picture p14: CAD file, 2016-04-24]
hardware/frame/motor_mount.FCStd
69.0 x 40.0 x 40.7 mm
