sigmadrone/sigmadrone/hardware/sto-1/steval-holder.fcstd

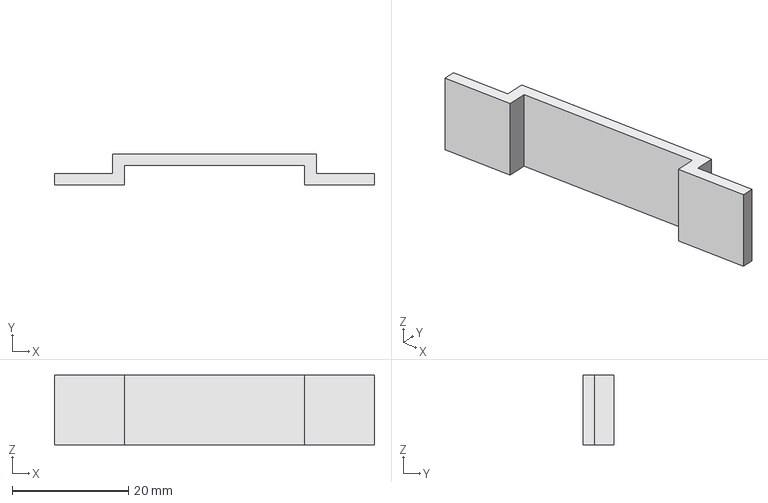
[picture p15: CAD file, 2016-06-22]
hardware/sto-1/steval-holder.fcstd
55.0 x 5.30 x 12.0 mm
