sigmadrone/sigmadrone/hardware/frame/motor_mount_round.FCStd

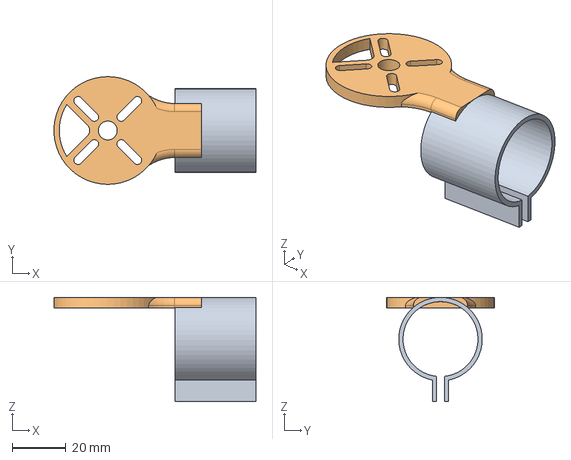
[picture p16: CAD file, 2016-04-22]
hardware/frame/motor_mount_round.FCStd
75.0 x 40.0 x 38.7 mm
Bracket_Cylinder
