sigmadrone/sigmadrone/hardware/sto-1/motor_mount_bottom.fcstd

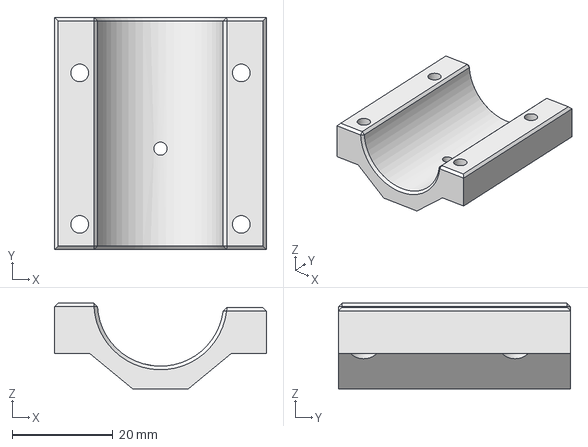
[picture p17: CAD file, 2016-06-14]
hardware/sto-1/motor_mount_bottom.fcstd
42.0 x 46.0 x 17.0 mm
