sigmadrone/sigmadrone/hardware/frame/body-bracket-light.fcstd

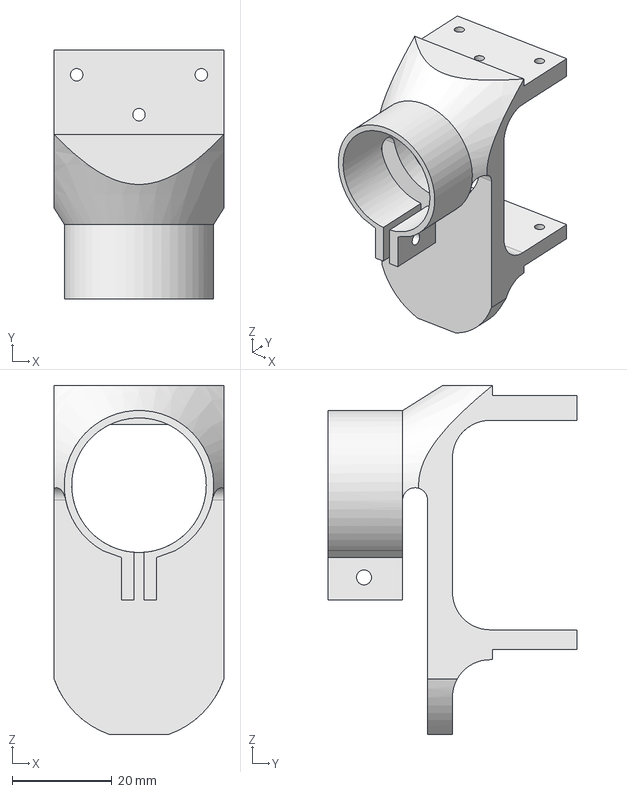
[picture p18: CAD file, 2016-04-18]
hardware/frame/body-bracket-light.fcstd
34.0 x 50.0 x 70.0 mm
