sigmadrone/sigmadrone/hardware/sto-1/body-tube-leg.fcstd

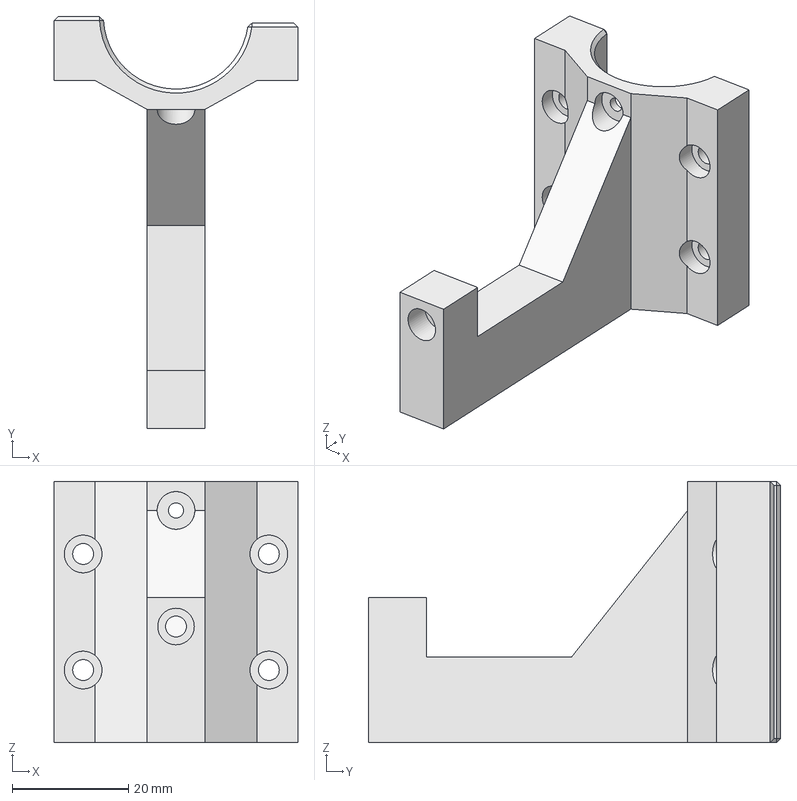
[picture p19: CAD file, 2016-06-14]
hardware/sto-1/body-tube-leg.fcstd
42.0 x 71.0 x 45.0 mm
