sigmadrone/sigmadrone/hardware/frame/H_hub.FCStd

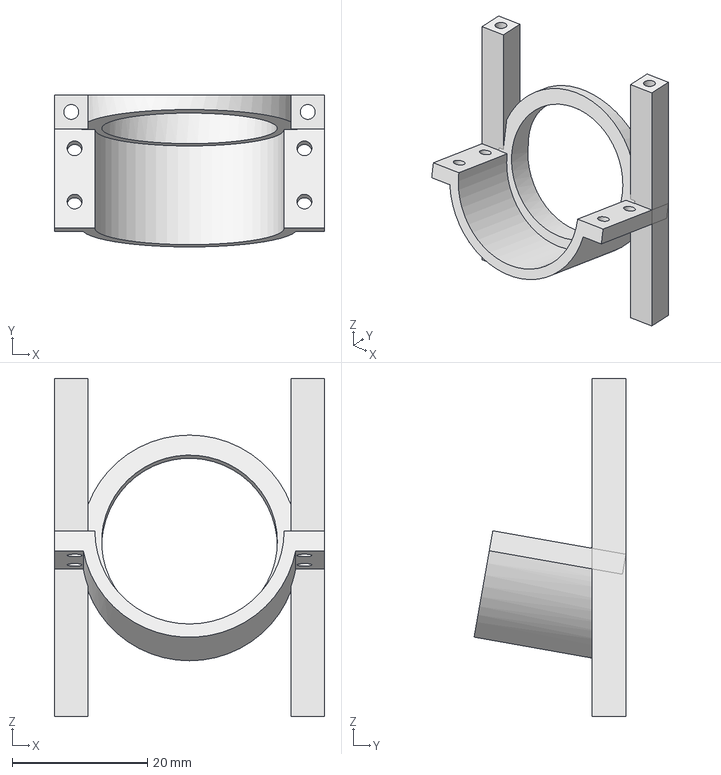
[picture p20: CAD file, 2016-04-17]
hardware/frame/H_hub.FCStd
40.0 x 22.5 x 50.0 mm
