sigmadrone/sigmadrone/hardware/sto-1/esc-frame-e300.fcstd

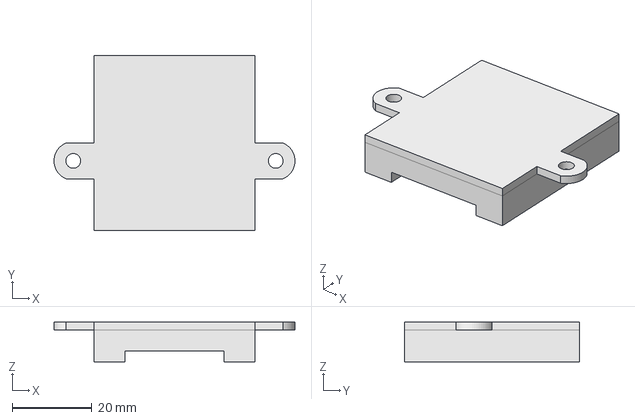
[picture p21: CAD file, 2016-06-14]
hardware/sto-1/esc-frame-e300.fcstd
60.6 x 44.0 x 10.0 mm
