sigmadrone/sigmadrone/hardware/frame/hub2.FCStd

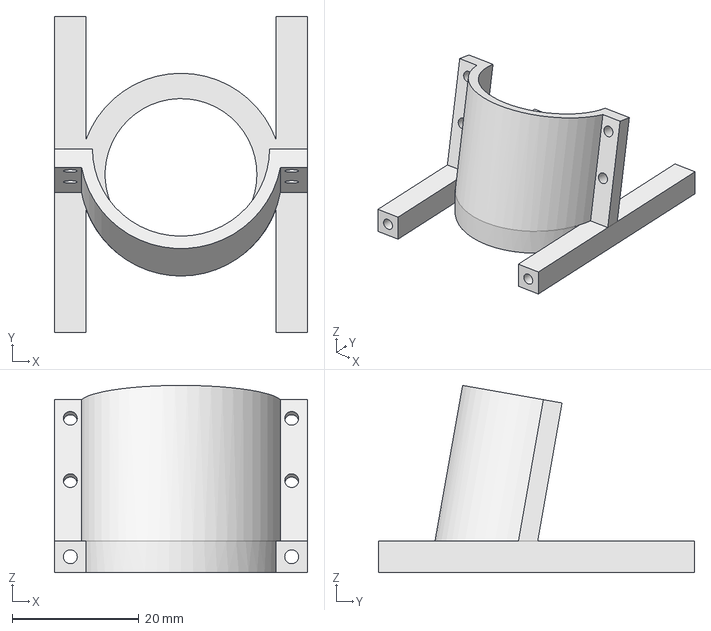
[picture p22: CAD file, 2016-04-17]
hardware/frame/hub2.FCStd
40.0 x 50.0 x 29.6 mm
