sigmadrone/sigmadrone/hardware/sto-1/body-top.fcstd

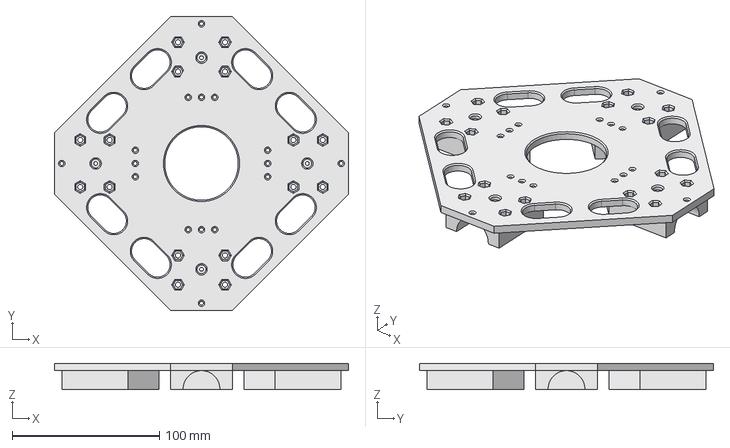
[picture p23: CAD file, 2016-06-14]
hardware/sto-1/body-top.fcstd
200.0 x 200.0 x 18.0 mm
