sigmadrone/sigmadrone/hardware/frame/bracket1inch.FCStd

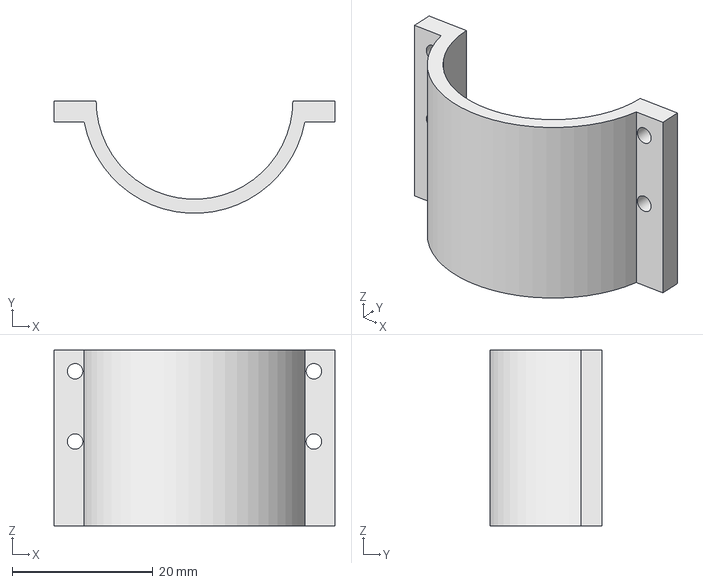
[picture p24: CAD file, 2016-04-17]
hardware/frame/bracket1inch.FCStd
40.0 x 16.0 x 25.0 mm
