sigmadrone/sigmadrone/hardware/sto-1/body-bottom.fcstd

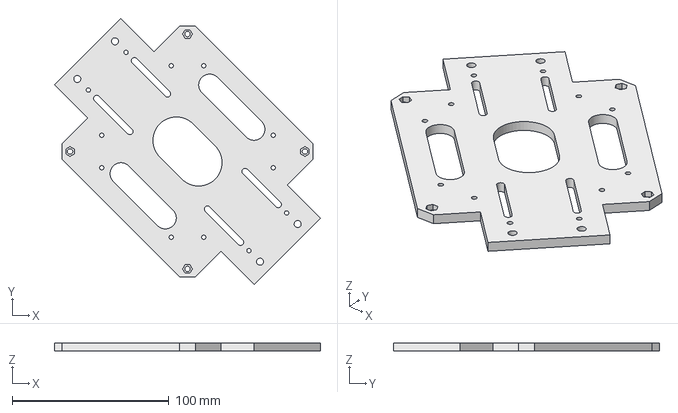
[picture p25: CAD file, 2016-06-14]
hardware/sto-1/body-bottom.fcstd
169.9 x 169.9 x 5.00 mm
