sigmadrone/sigmadrone/hardware/frame/hub2_no_union.FCStd

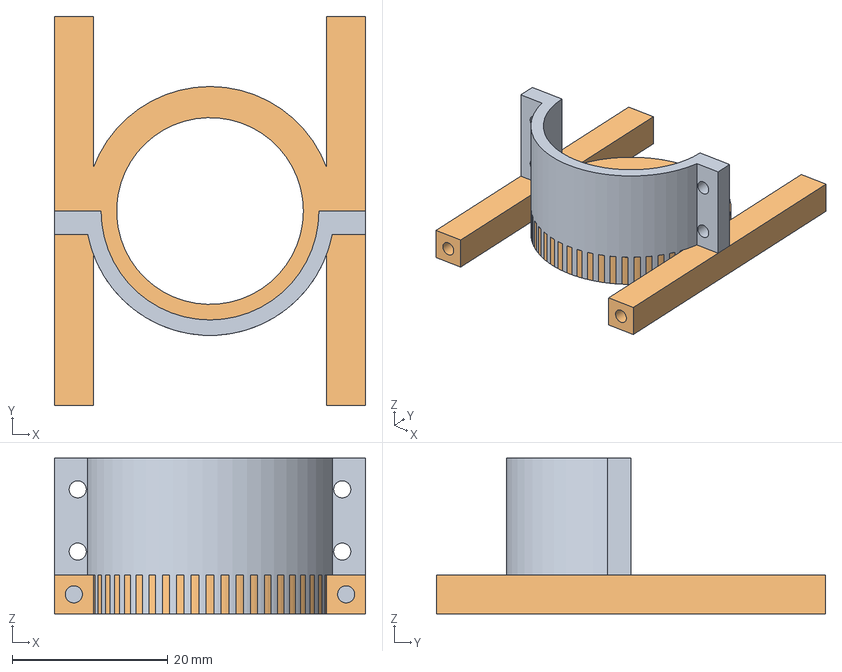
[picture p26: CAD file, 2016-04-17]
hardware/frame/hub2_no_union.FCStd
40.0 x 50.0 x 20.0 mm
FastenerHolesBracket
FastenerHolesPocket
