sigmadrone/sigmadrone/hardware/sto-1/colibri-v2-frame.fcstd

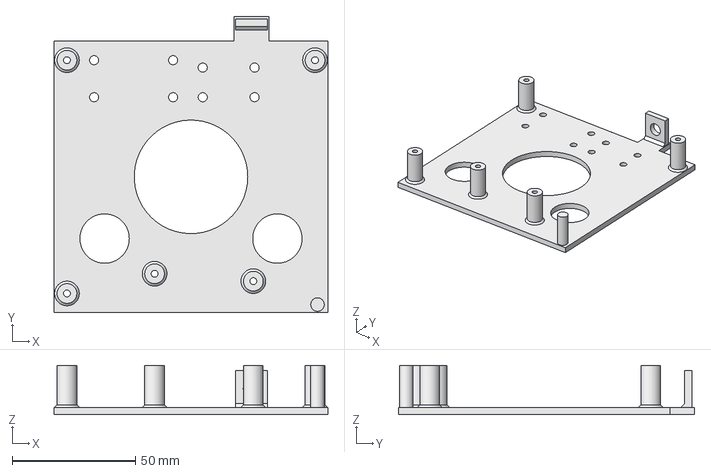
[picture p27: CAD file, 2016-06-09]
hardware/sto-1/colibri-v2-frame.fcstd
111.0 x 120.0 x 20.0 mm
