sigmadrone/sigmadrone/hardware/frame/body-bracket.fcstd

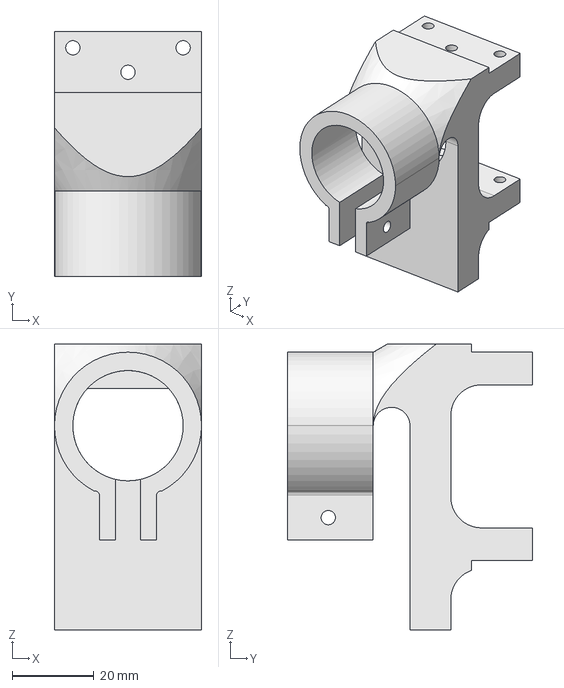
[picture p28: CAD file, 2016-04-15]
hardware/frame/body-bracket.fcstd
36.0 x 60.0 x 70.0 mm
