sigmadrone/sigmadrone/hardware/sto-1/stand-mount.fcstd

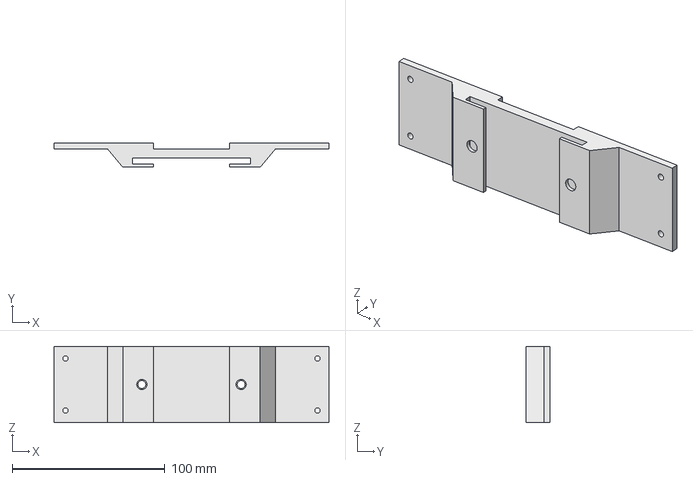
[picture p29: CAD file, 2016-06-09]
hardware/sto-1/stand-mount.fcstd
180.0 x 16.0 x 50.0 mm
