sigmadrone/sigmadrone/hardware/frame/bracket.FCStd

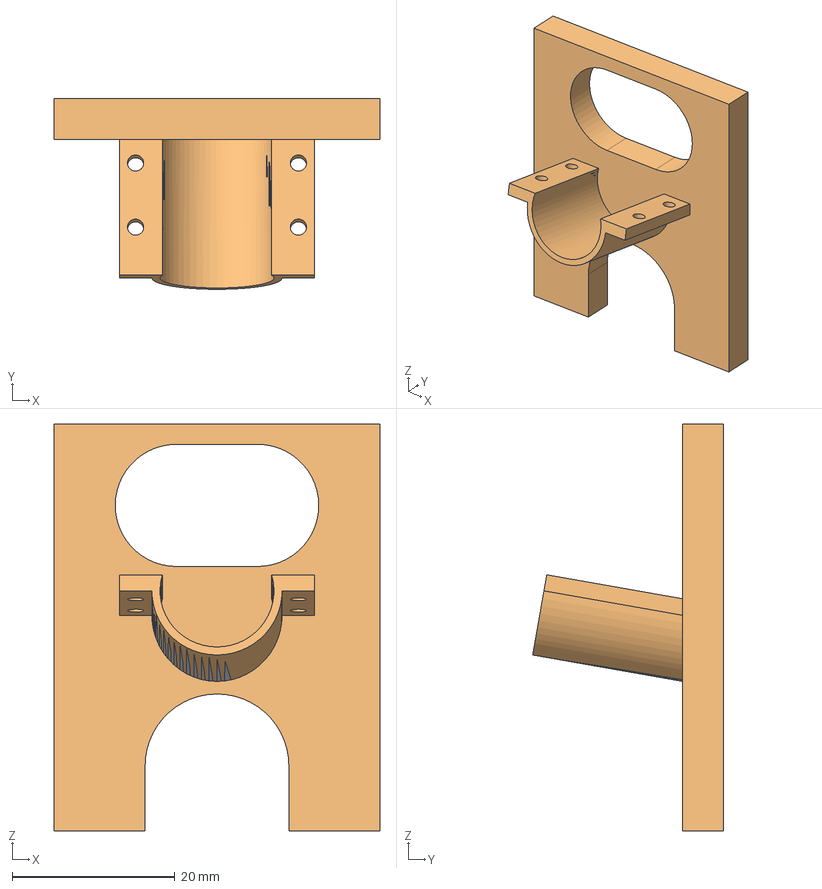
[picture p30: CAD file, 2016-04-10]
hardware/frame/bracket.FCStd
40.0 x 23.4 x 50.0 mm
