sigmadrone/sigmadrone/hardware/sto-1/colibri_v2.fcstd

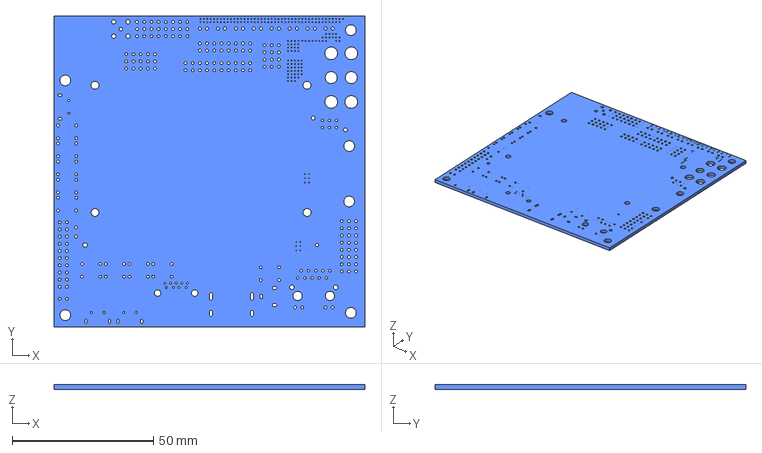
[picture p31: CAD file, 2016-06-03]
hardware/sto-1/colibri_v2.fcstd
110.0 x 110.0 x 1.60 mm
