sigmadrone/sigmadrone/hardware/sto-1/body-bracket2.fcstd

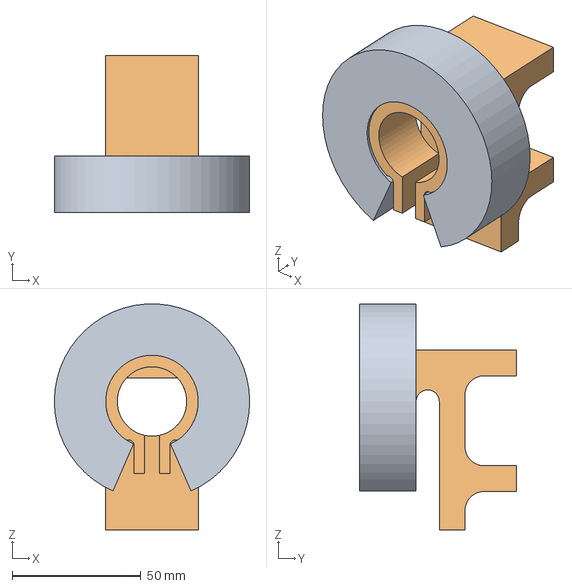
[picture p32: CAD file, 2016-06-03]
hardware/sto-1/body-bracket2.fcstd
76.0 x 61.0 x 87.9 mm
