sigmadrone/sigmadrone/hardware/sto-1/body-bottom-reversed.fcstd

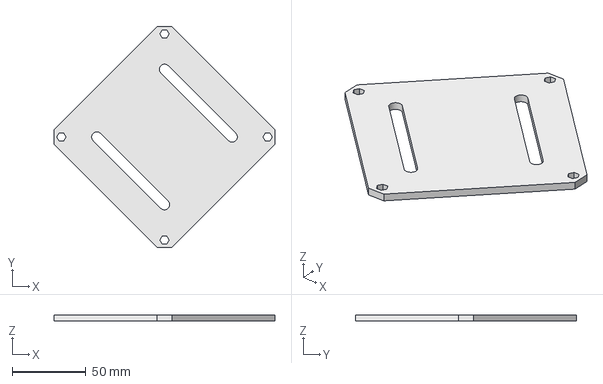
[picture p33: CAD file, 2016-06-03]
hardware/sto-1/body-bottom-reversed.fcstd
150.0 x 150.0 x 4.00 mm
