sigmadrone/sigmadrone/hardware/sto-1/battery.fcstd

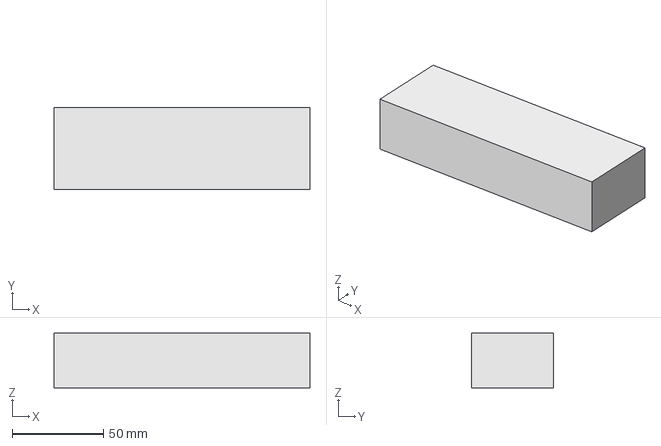
[picture p34: CAD file, 2016-06-03]
hardware/sto-1/battery.fcstd
140.0 x 45.0 x 30.0 mm
