sigmadrone/sigmadrone/hardware/sto-1/esc.fcstd

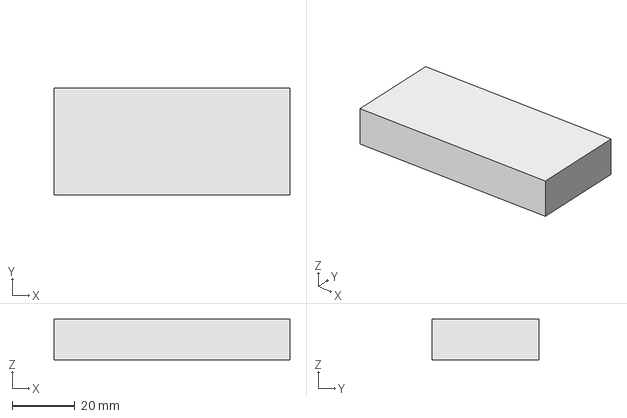
[picture p35: CAD file, 2016-06-03]
hardware/sto-1/esc.fcstd
75.0 x 34.0 x 13.0 mm
