sigmadrone/sigmadrone/hardware/sto-1/esc-frame.fcstd

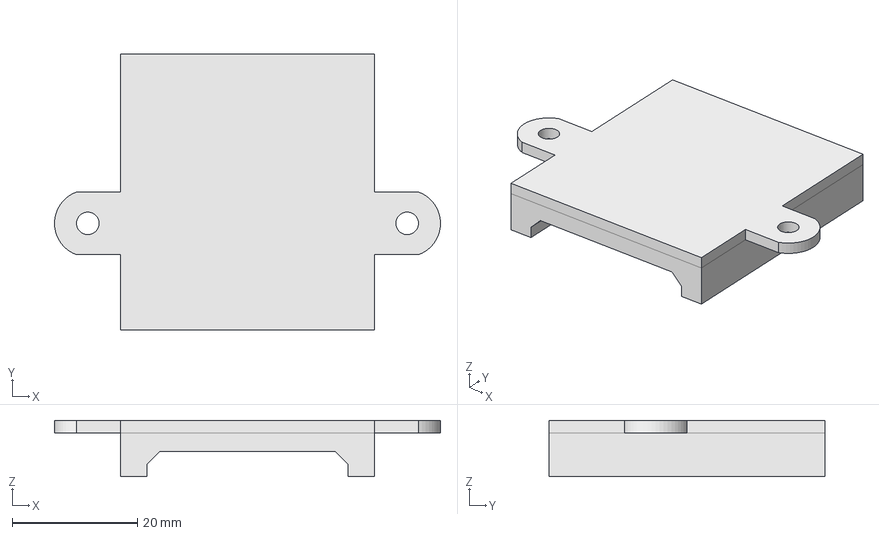
[picture p36: CAD file, 2016-06-03]
hardware/sto-1/esc-frame.fcstd
61.5 x 44.0 x 9.00 mm
