sigmadrone/sigmadrone/hardware/sto-1/motor_mount_top.fcstd

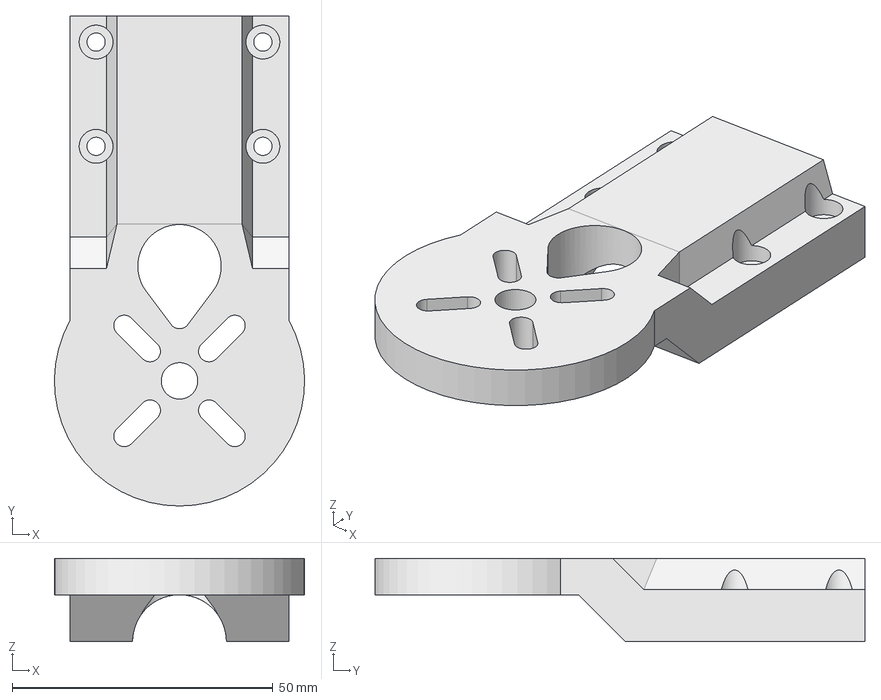
[picture p37: CAD file, 2016-06-03]
hardware/sto-1/motor_mount_top.fcstd
48.0 x 94.0 x 16.0 mm
