sigmadrone/sigmadrone/hardware/sto-1/tube.fcstd

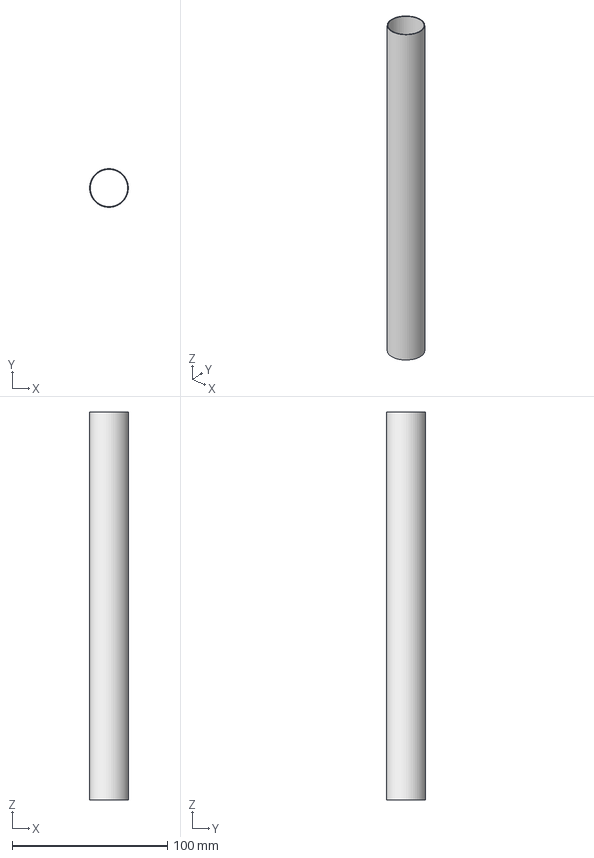
[picture p38: CAD file, 2016-06-03]
hardware/sto-1/tube.fcstd
25.0 x 25.0 x 250.0 mm
