sigmadrone/sigmadrone/hardware/sto-1/body-bracket-mt-holes.fcstd

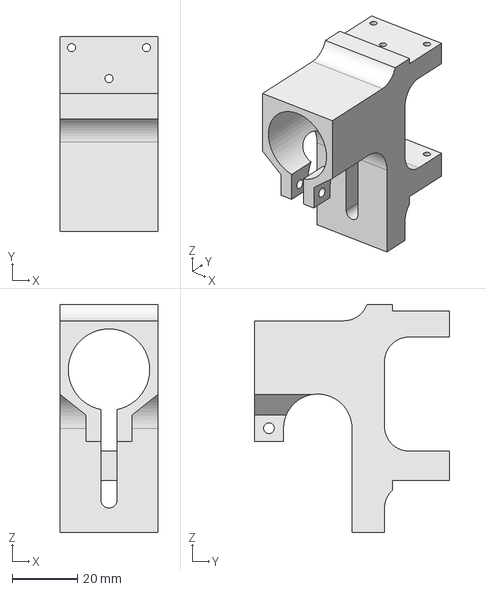
[picture p39: CAD file, 2016-06-03]
hardware/sto-1/body-bracket-mt-holes.fcstd
30.0 x 60.0 x 70.0 mm
