sigmadrone/sigmadrone/hardware/sto-1/body-bracket.fcstd

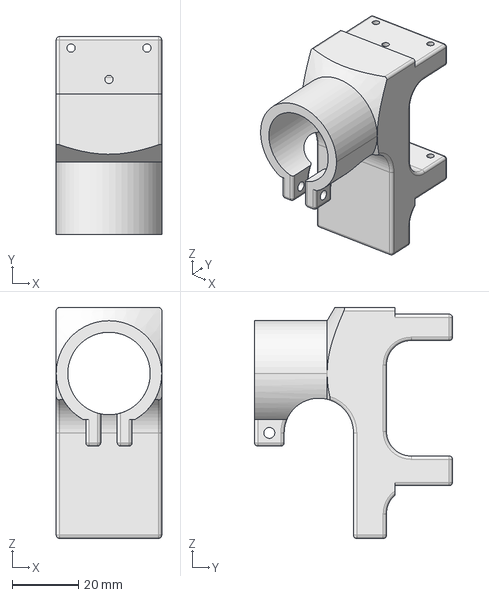
[picture p40: CAD file, 2016-04-14]
hardware/sto-1/body-bracket.fcstd
32.0 x 60.0 x 70.0 mm
