sigmadrone/sigmadrone/(list of files, cad)

Other CAD files:
hardware/sto-1/colibri-v1-frame.fcstd
