sigmadrone/sigmadrone/source/tests/matrix/results-new.txt

A is:
   2.00    3.00    1.00    5.00 
   6.00   13.00    5.00   19.00 
   2.00   19.00   10.00   23.00 
   4.00   10.00   11.00   31.00 

B is:
   2.00    0.00    2.00    0.60 
   3.00    3.00    4.00   -2.00 
   5.00    5.00    4.00    2.00 
  -1.00   -2.00    3.40   -1.00 

A * B is:
  13.00    4.00   37.00   -7.80 
  57.00   26.00  148.60  -31.40 
  88.00   61.00  198.20  -39.80 
  62.00   23.00  197.40  -26.60 

A * 2 is:
   4.00    6.00    2.00   10.00 
  12.00   26.00   10.00   38.00 
   4.00   38.00   20.00   46.00 
   8.00   20.00   22.00   62.00 

A + 2 is:
   4.00    5.00    3.00    7.00 
   8.00   15.00    7.00   21.00 
   4.00   21.00   12.00   25.00 
   6.00   12.00   13.00   33.00 

A - 2 is:
   0.00    1.00   -1.00    3.00 
   4.00   11.00    3.00   17.00 
   0.00   17.00    8.00   21.00 
   2.00    8.00    9.00   29.00 

A / 2 is:
   1.00    1.50    0.50    2.50 
   3.00    6.50    2.50    9.50 
   1.00    9.50    5.00   11.50 
   2.00    5.00    5.50   15.50 

D is:
   1.00    2.00    0.00 
   3.00    4.00    4.00 
   5.00    6.00    3.00 

C is:
   3.00 
   7.00 
   8.00 

D * C is:
  17.00 
  69.00 
  81.00 

D.inverse() is:
  -1.20   -0.60    0.80 
   1.10    0.30   -0.40 
  -0.20    0.40   -0.20 

D * D.inverse() is:
   1.00    0.00    0.00 
   0.00    1.00    0.00 
   0.00    0.00    1.00 

D.transpose() is:
   1.00    3.00    5.00 
   2.00    4.00    6.00 
   0.00    4.00    3.00 

C.length() is: 
11.0454

C.normalize() is: 
   0.27 
   0.63 
   0.72 

C.normalize().transpose() is: 
   0.27    0.63    0.72 

C x C.normalize() is: 
   0.00 
   0.00 
   0.00 

C dot C.normalize() is: 
11.0454
Re-mapped C is:
  -7.00 
   3.00 
   8.00 

Transposed POD init: 
   1.00    4.00    7.00 
   2.00    5.00    8.00 
   3.00    6.00    9.00
