sigmadrone/sigmadrone/hardware/colibri/rev1j/Colibri_Rev1j_PCB_Diagram.pdf

## PCB Diagram

# Layer pairs & Via appearance

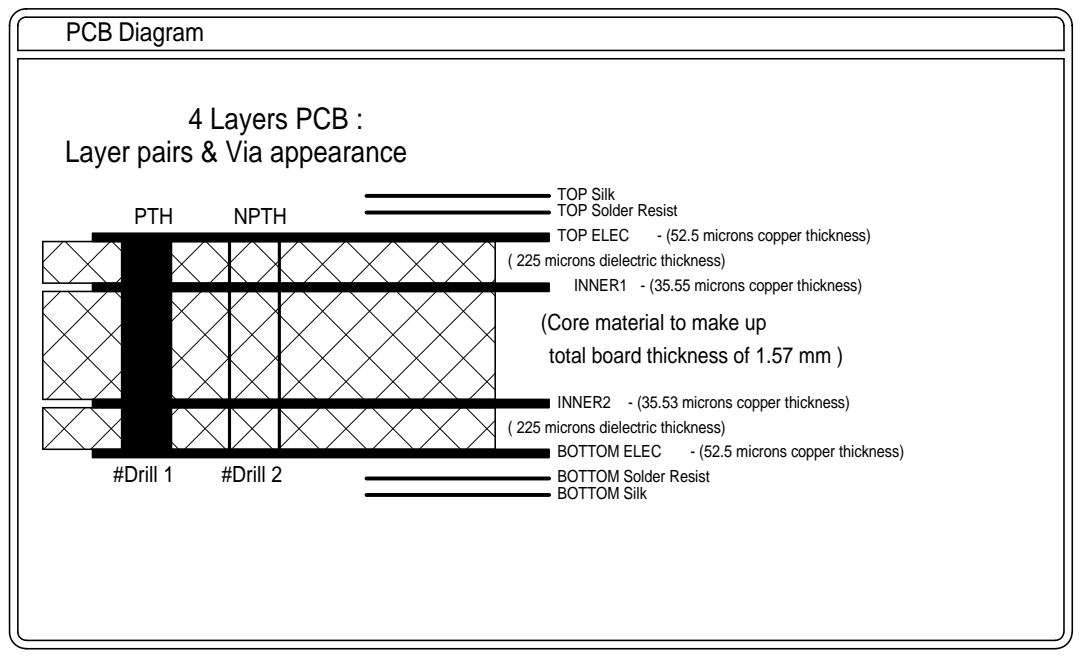
[picture p41: page 1]
PTH; NPTH; #Drill 1; #Drill 2; 4 Layers PCB :

TOP Silk
TOP Solder Resist
TOP ELEC
( 225 microns dielectric thickness)

- (52.5 microns copper thickness)

INNER1
(Core material to make up
total board thickness of 1.57 mm )

- (35.55 microns copper thickness)

INNER2 - (35.53 microns copper thickness)
BOTTOM ELEC
BOTTOM Solder Resist
BOTTOM Silk
