sigmadrone/sigmadrone/hardware/colibri/rev1j/Colibri_Rev1j_Schematics.pdf

# On/Off Control

# CORTEX

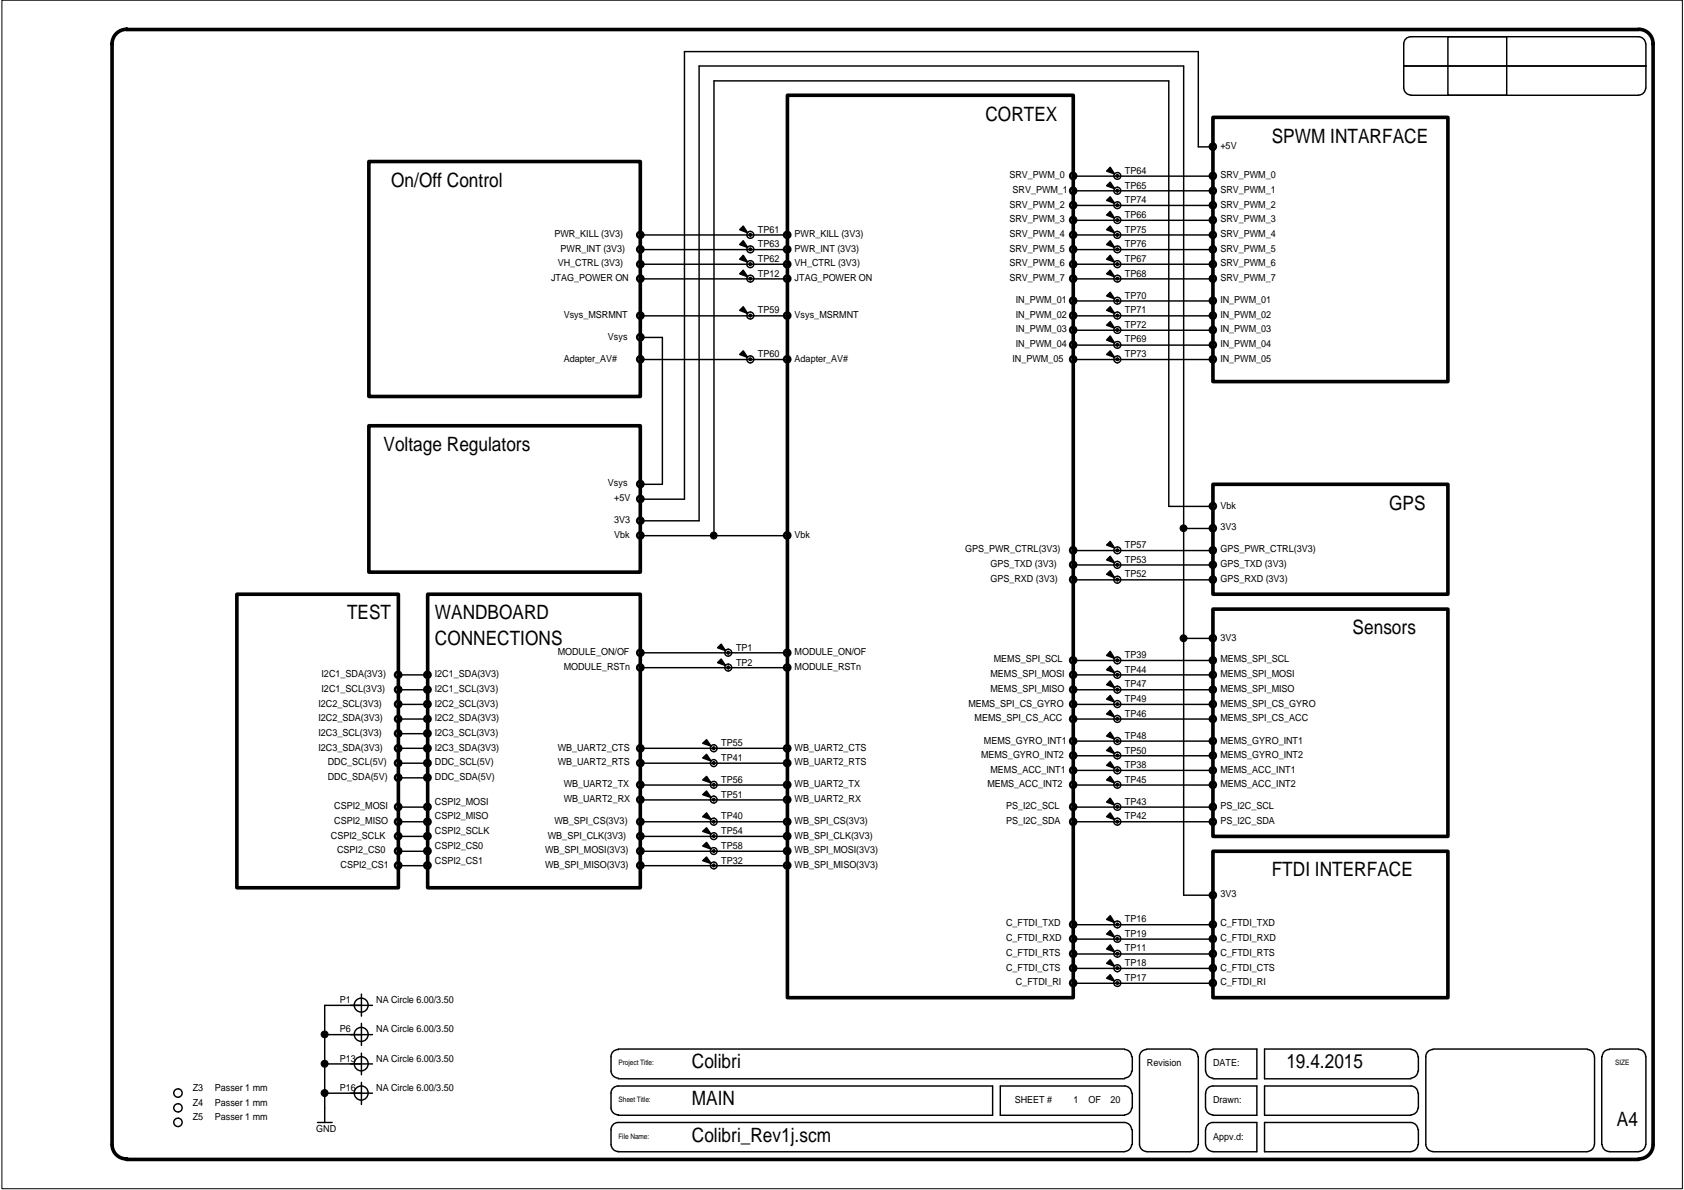
[picture p42: page 1]

# TFT LCD

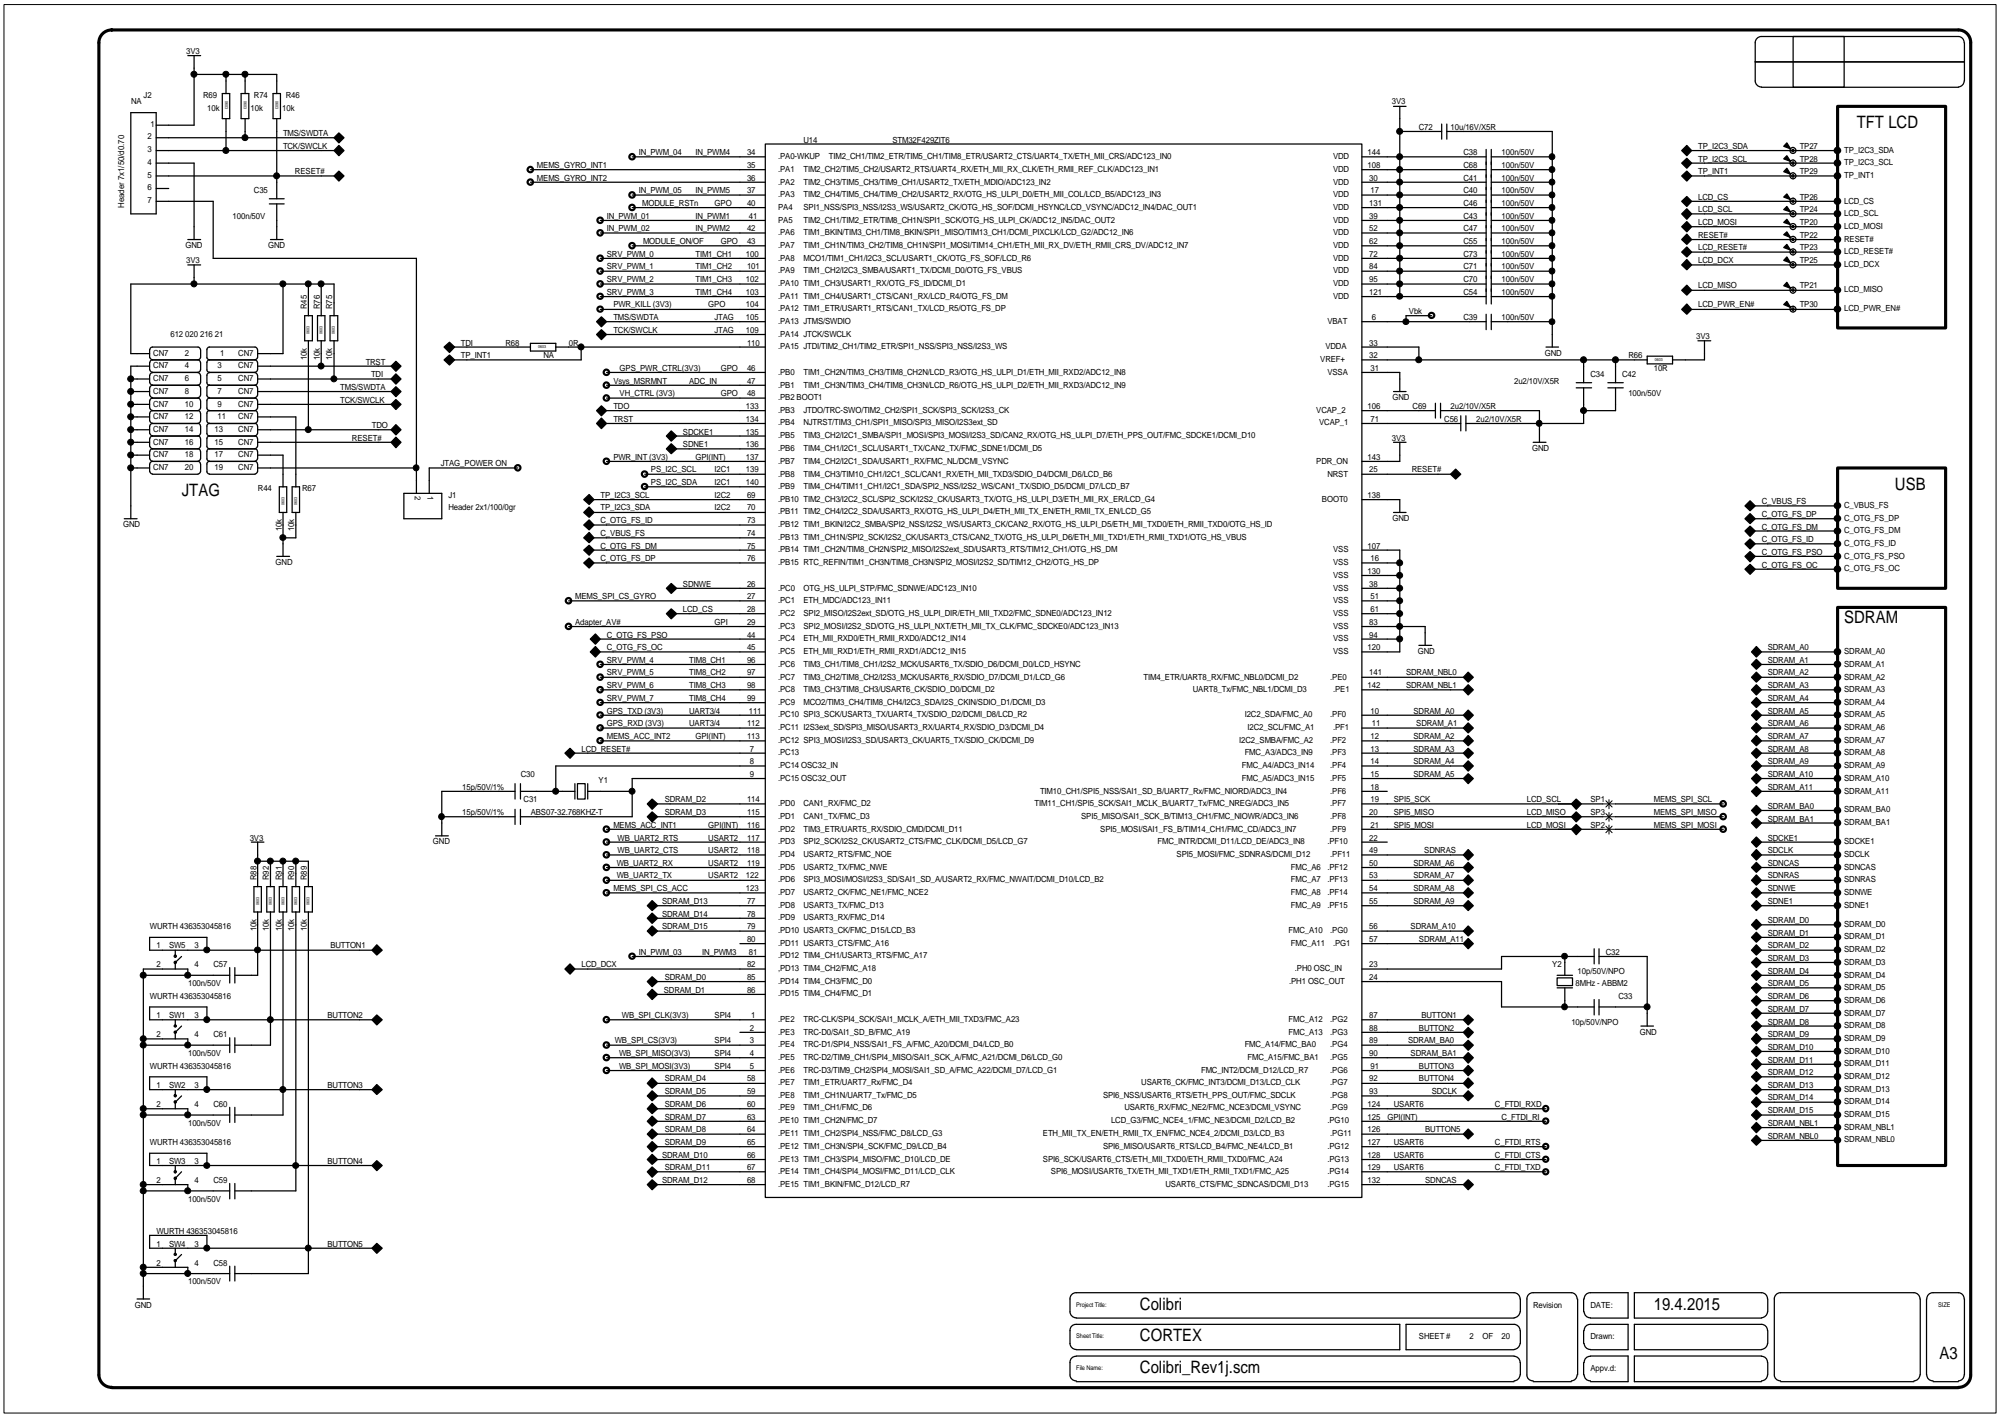
[picture p43: page 2]

## SDRAM_A0 SDRAM_A1

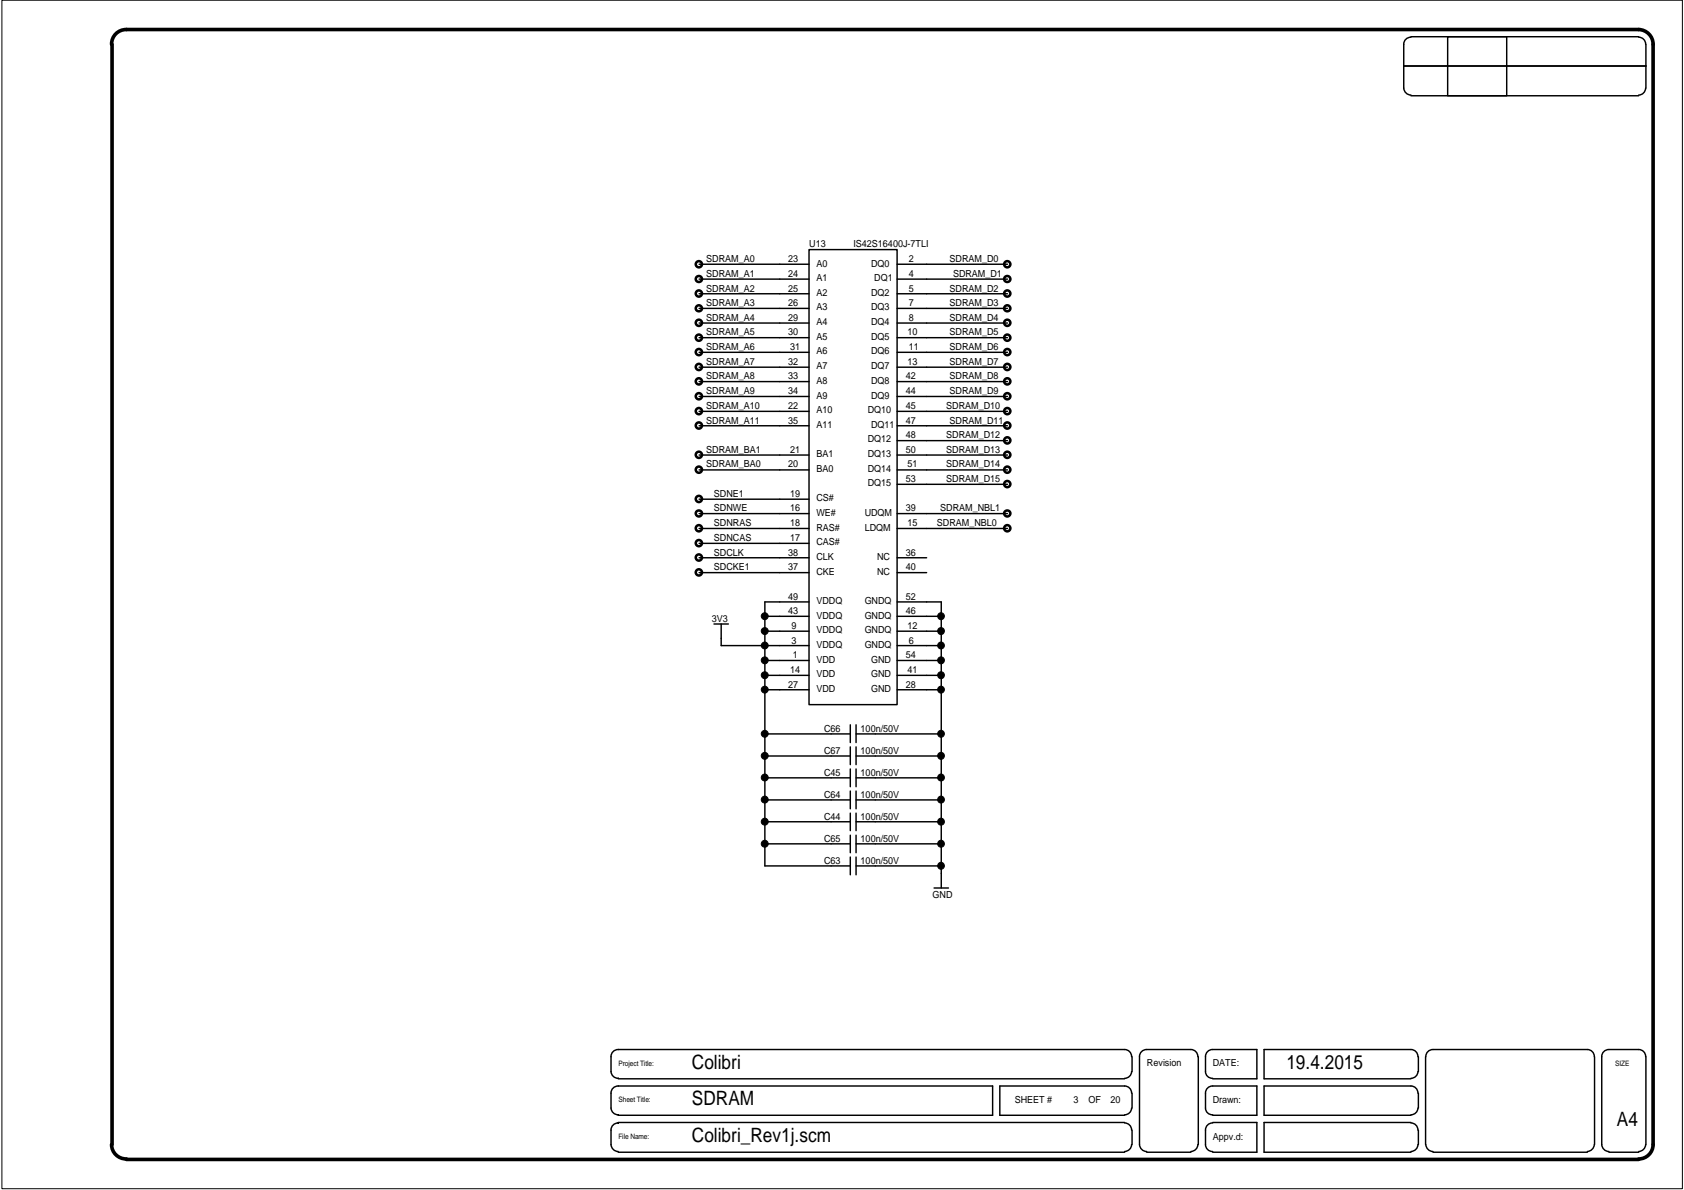
[picture p44: page 3]

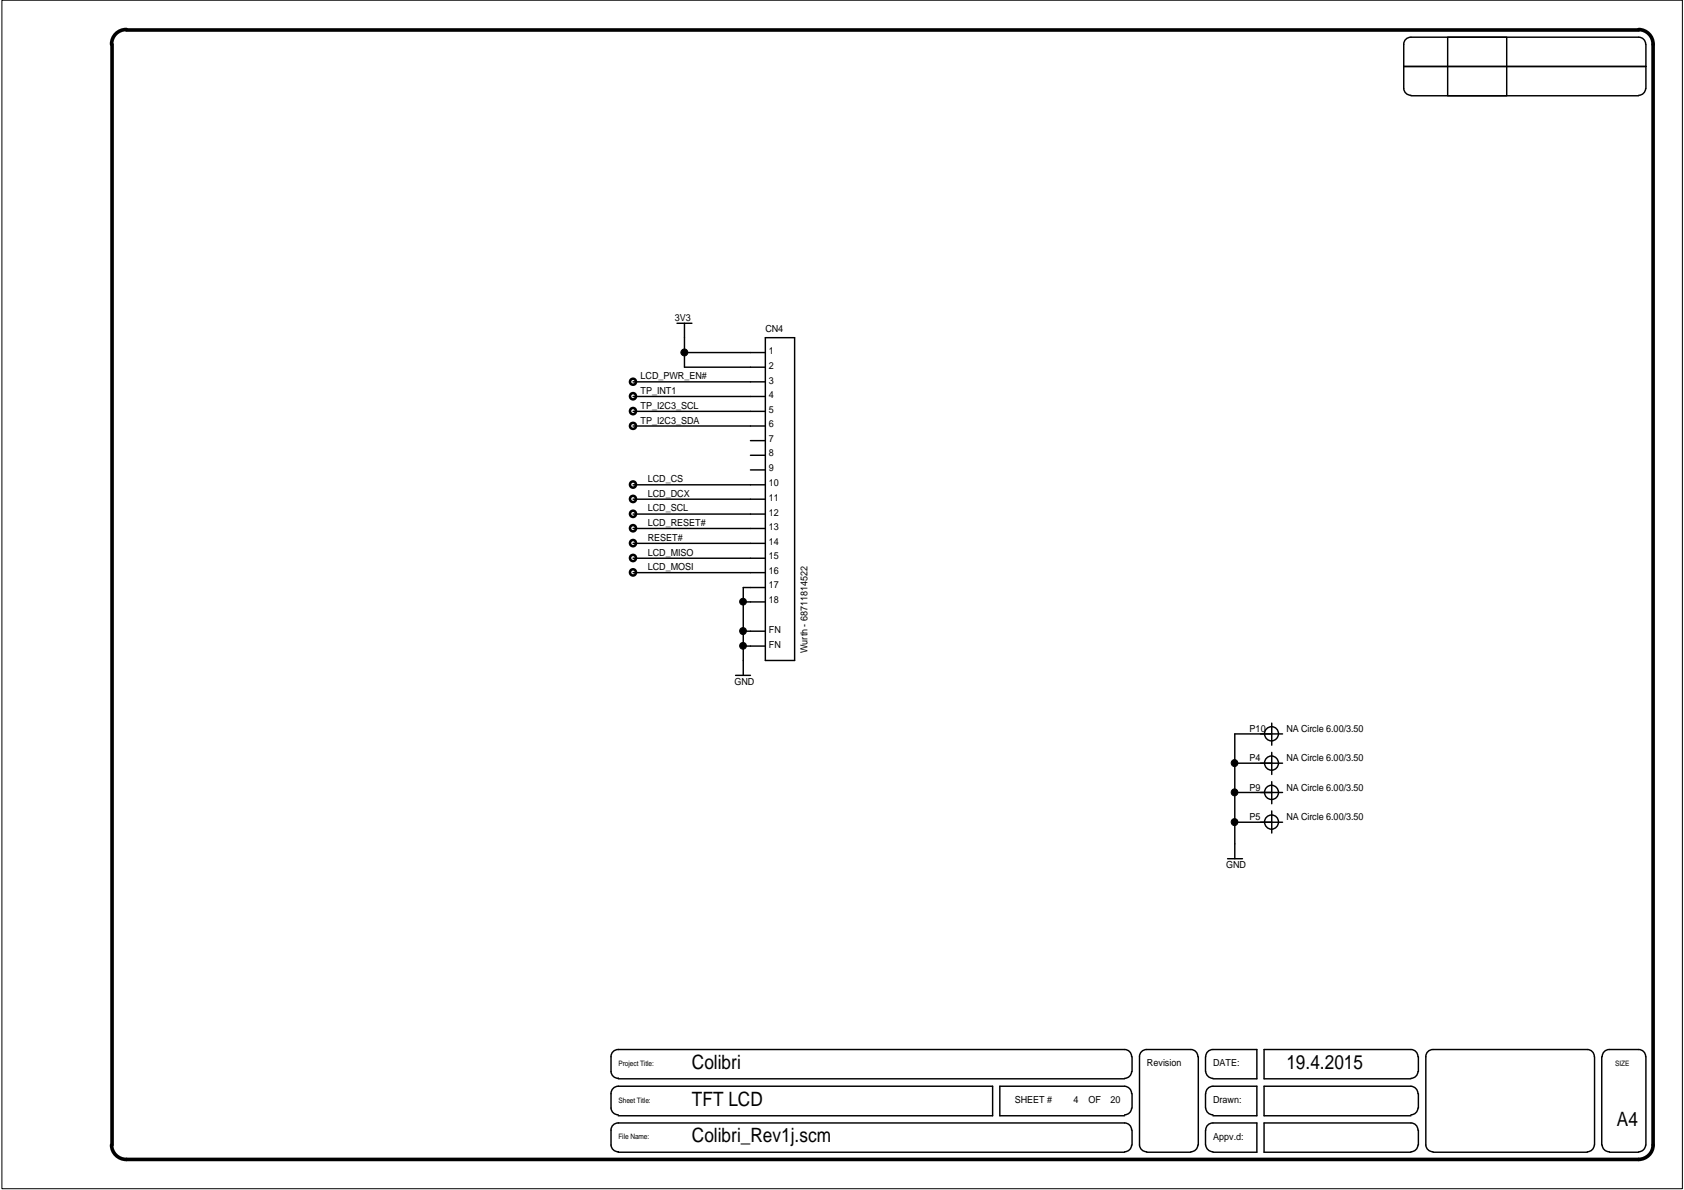
[picture p45: page 4]
LCD_PWR_EN# TP_INT1 TP_I2C3_SCL TP_I2C3_SDA; LCD_MISO; LCD_CS LCD_DCX LCD_SCL LCD_RESET# RESET#; LCD_MOSI; Project Title:; SIZE; Revision; DATE:; GND; Wurth - 68711814522; NA Circle 6.00/3.50; TFT LCD; Colibri

## C_VBUS_FS

## C_OTG_FS_PSO

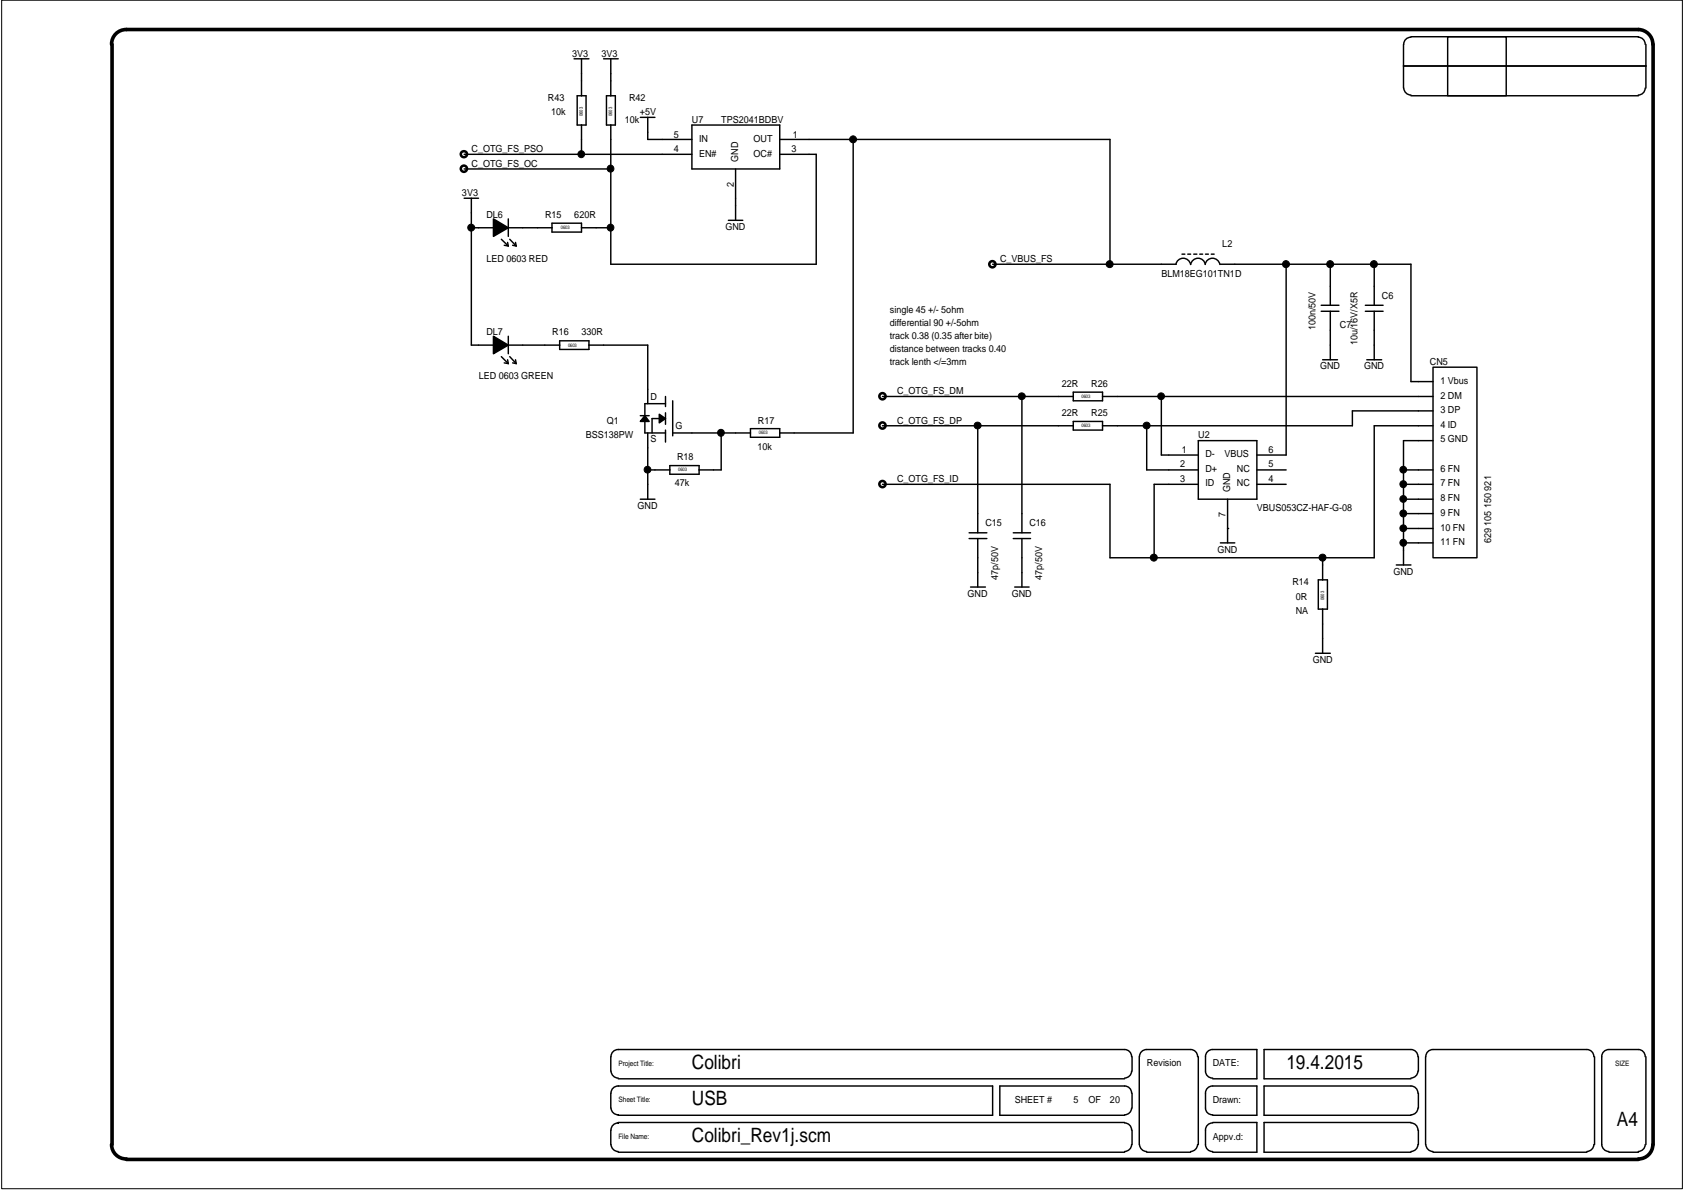
[picture p46: page 5]

## +Vbat

## +Vbat

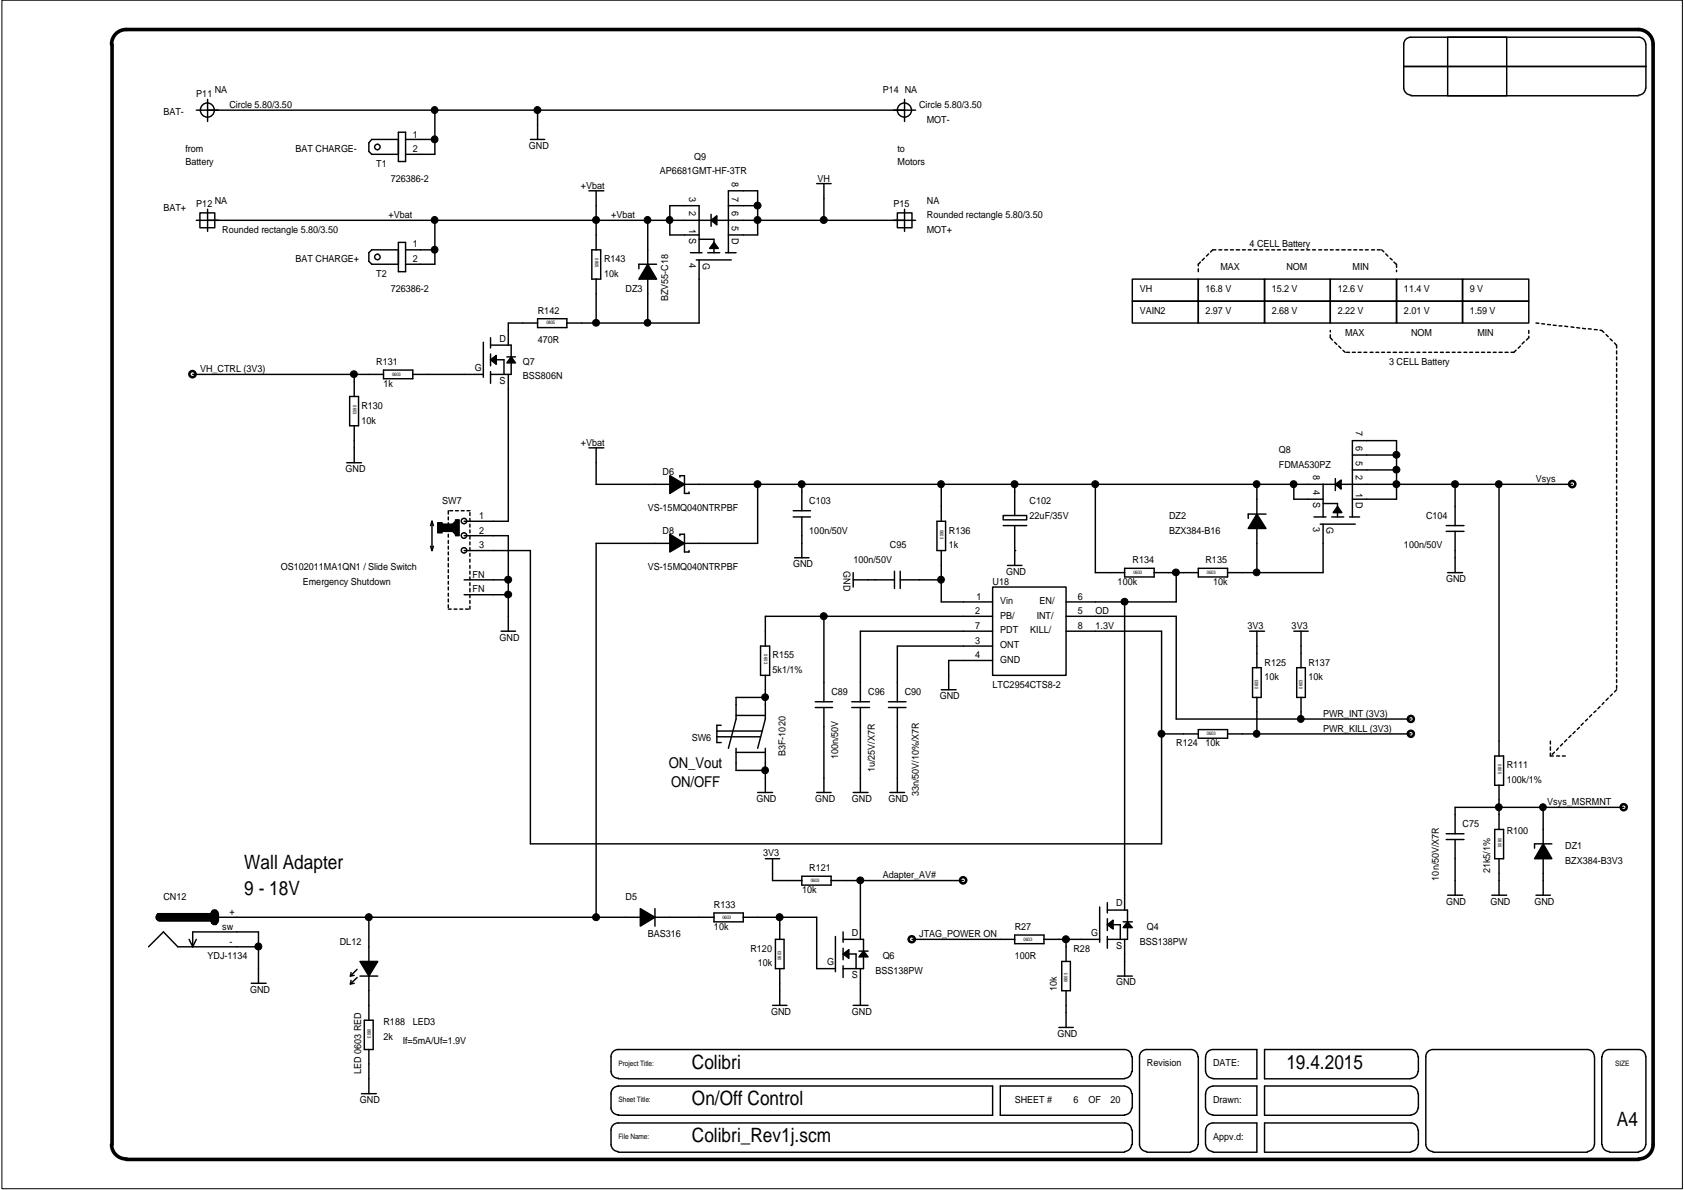
[picture p47: page 6]

## Vsys

+5V

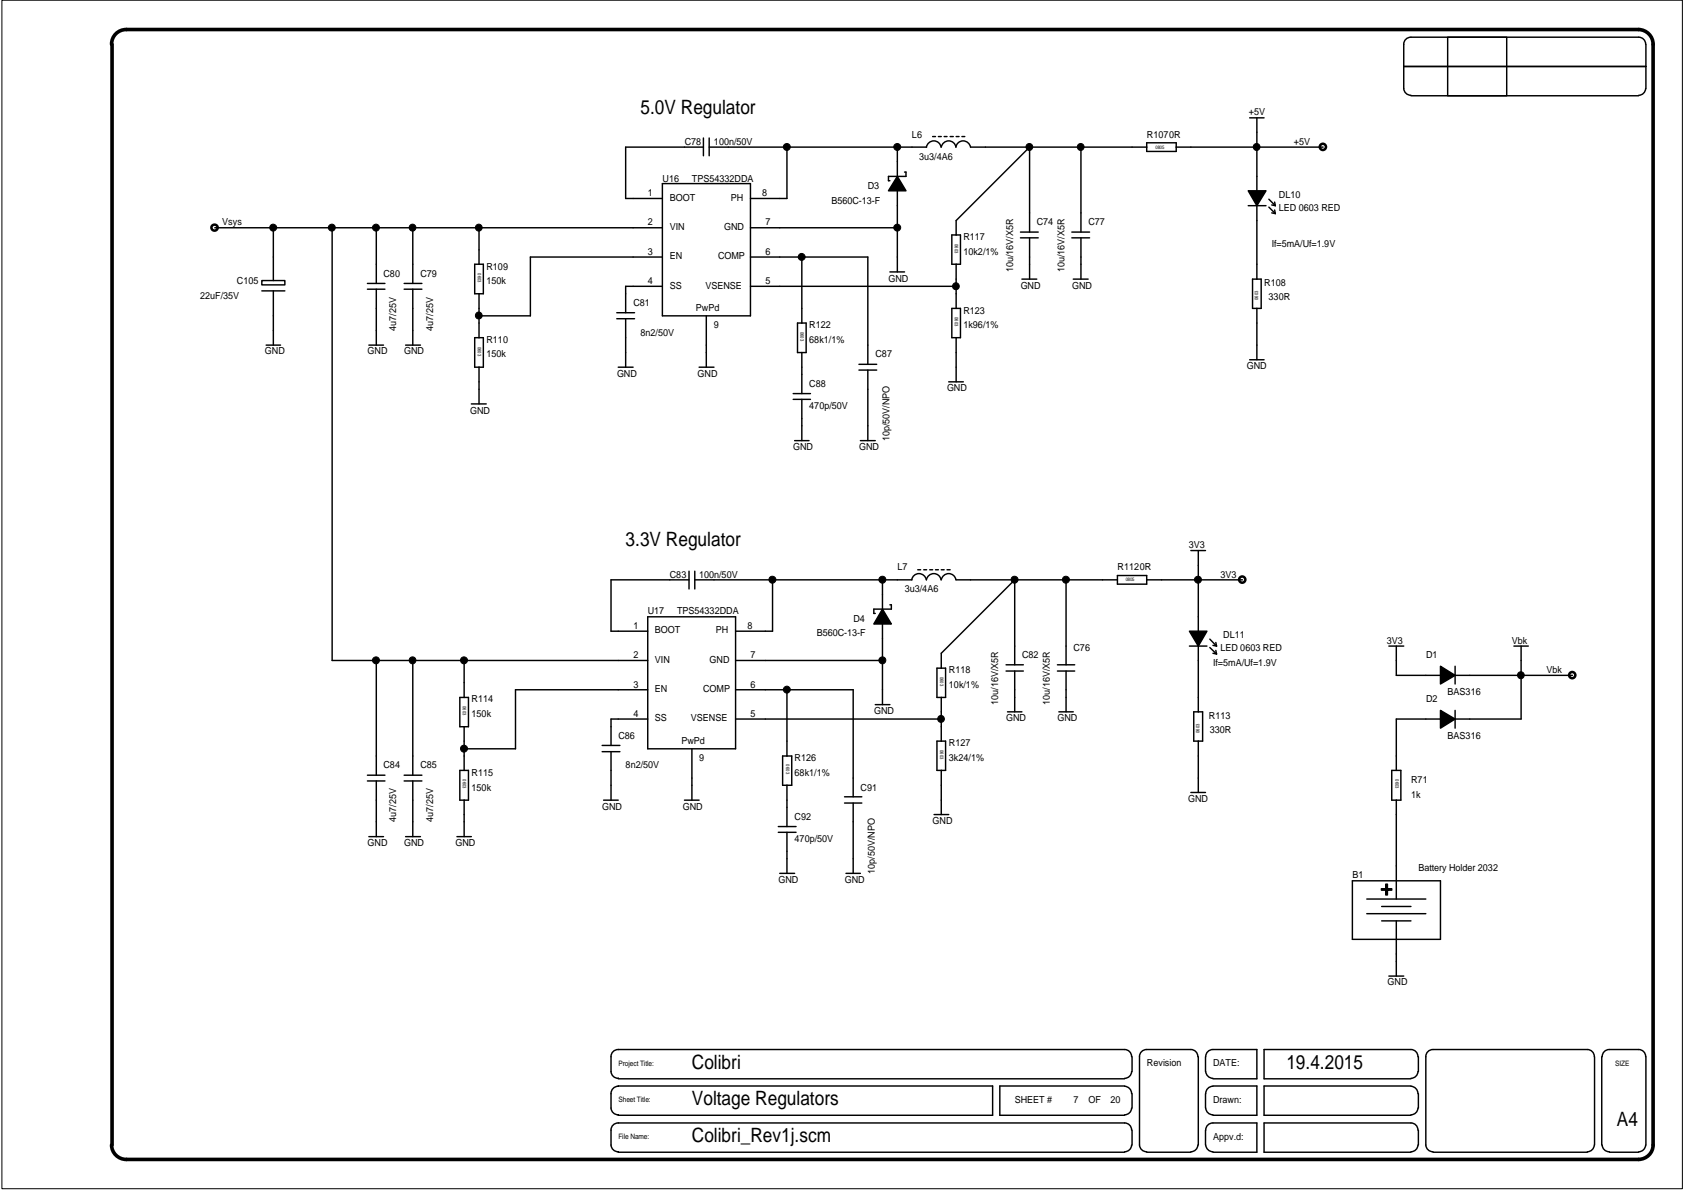
[picture p48: page 7]

# USB0 to OTG

# uSD CARD

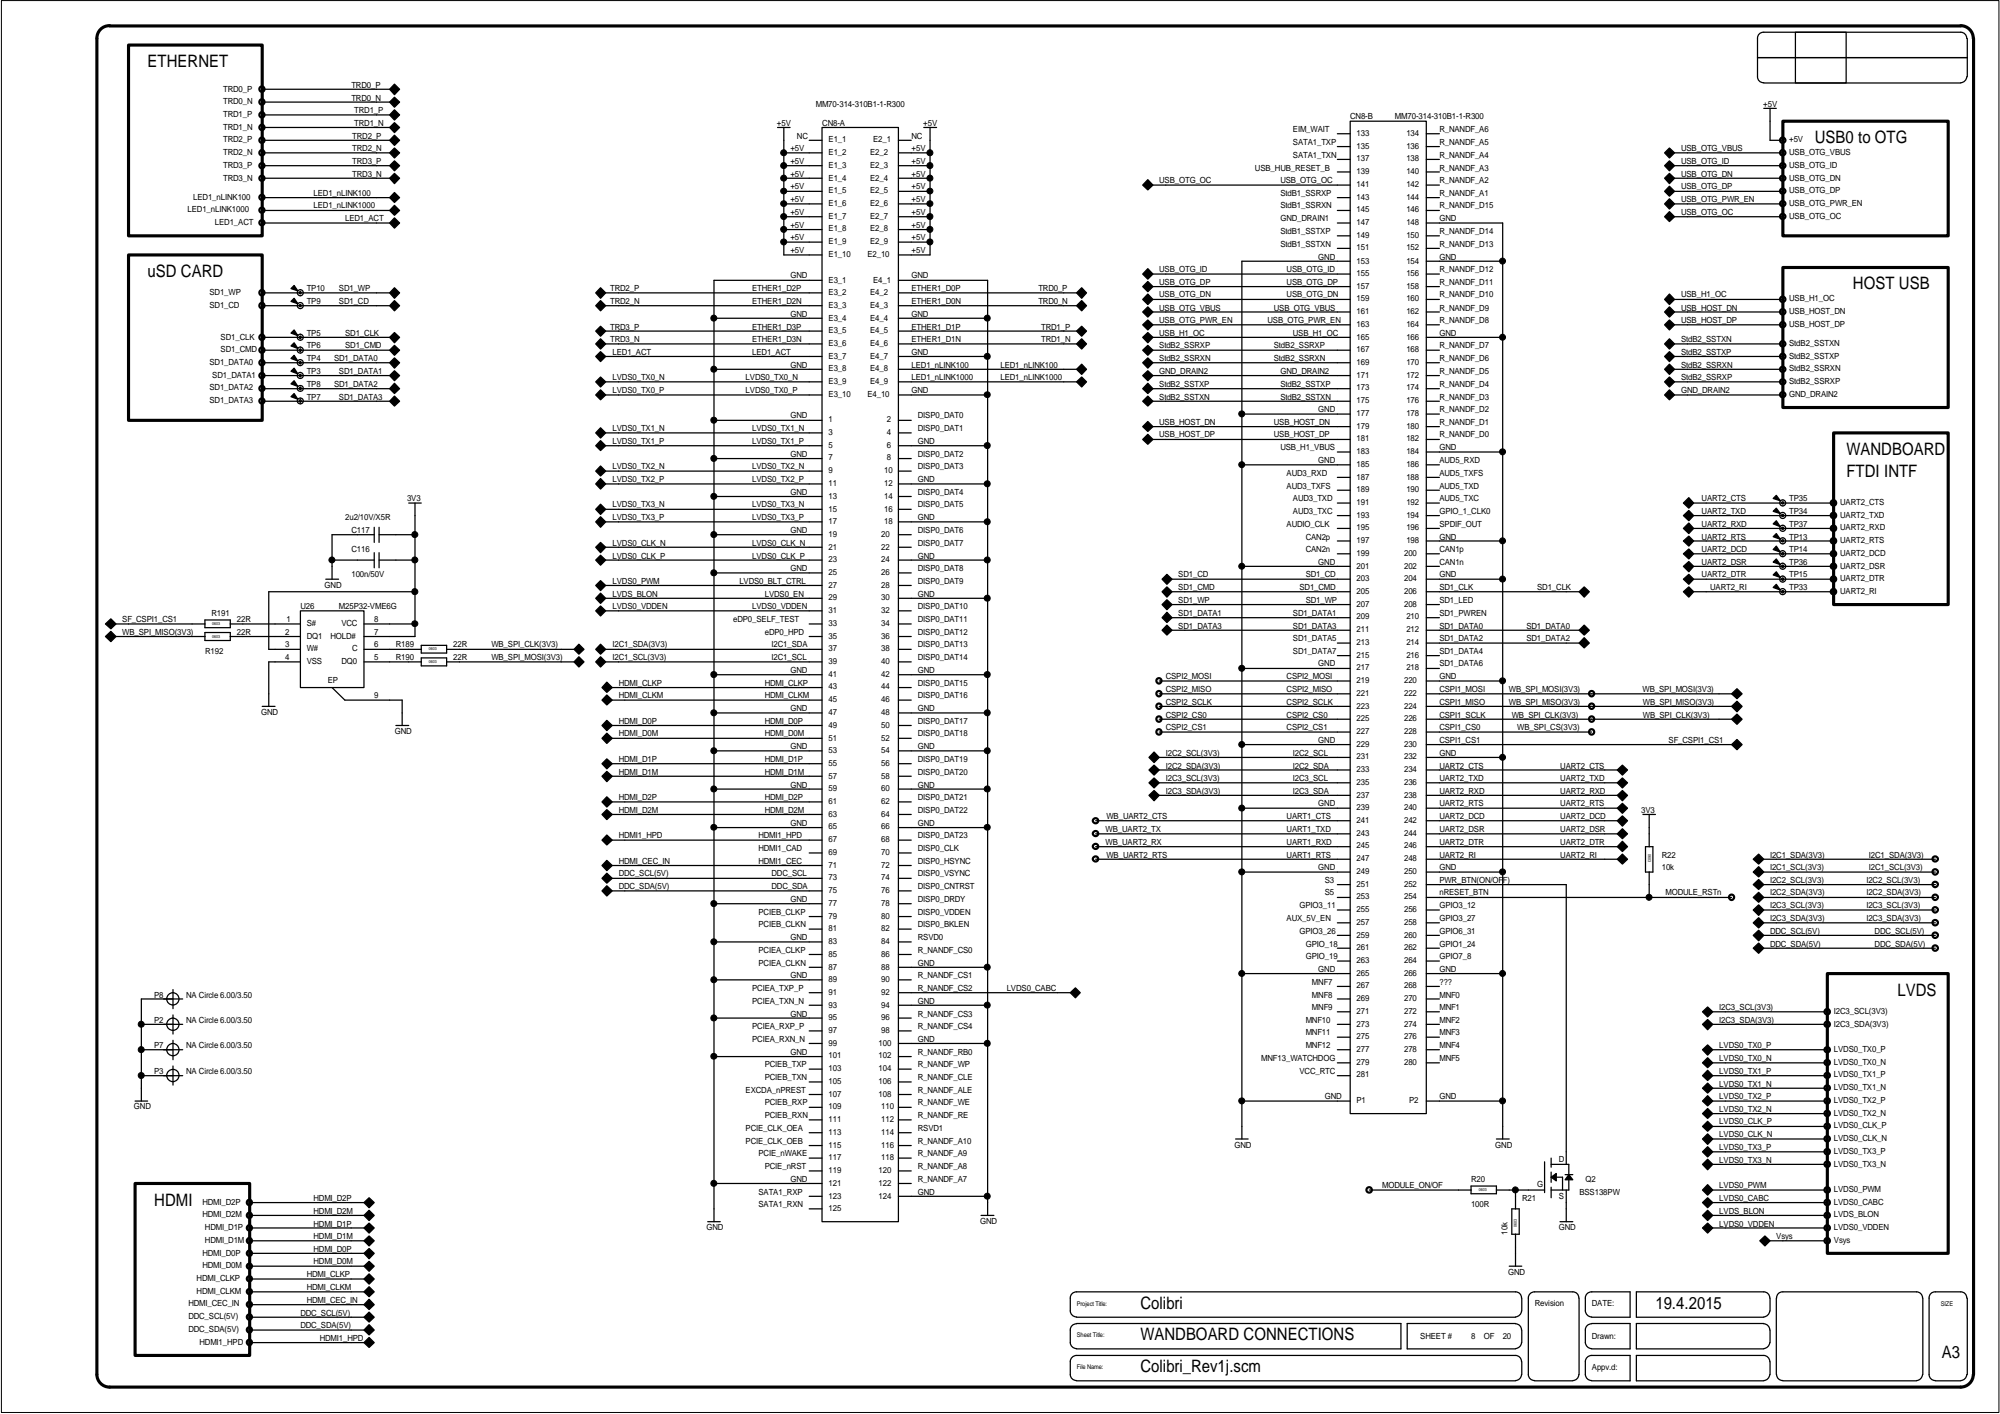
[picture p49: page 8]

+5V

USB_OTG_OC | USB_OTG_PWR_EN

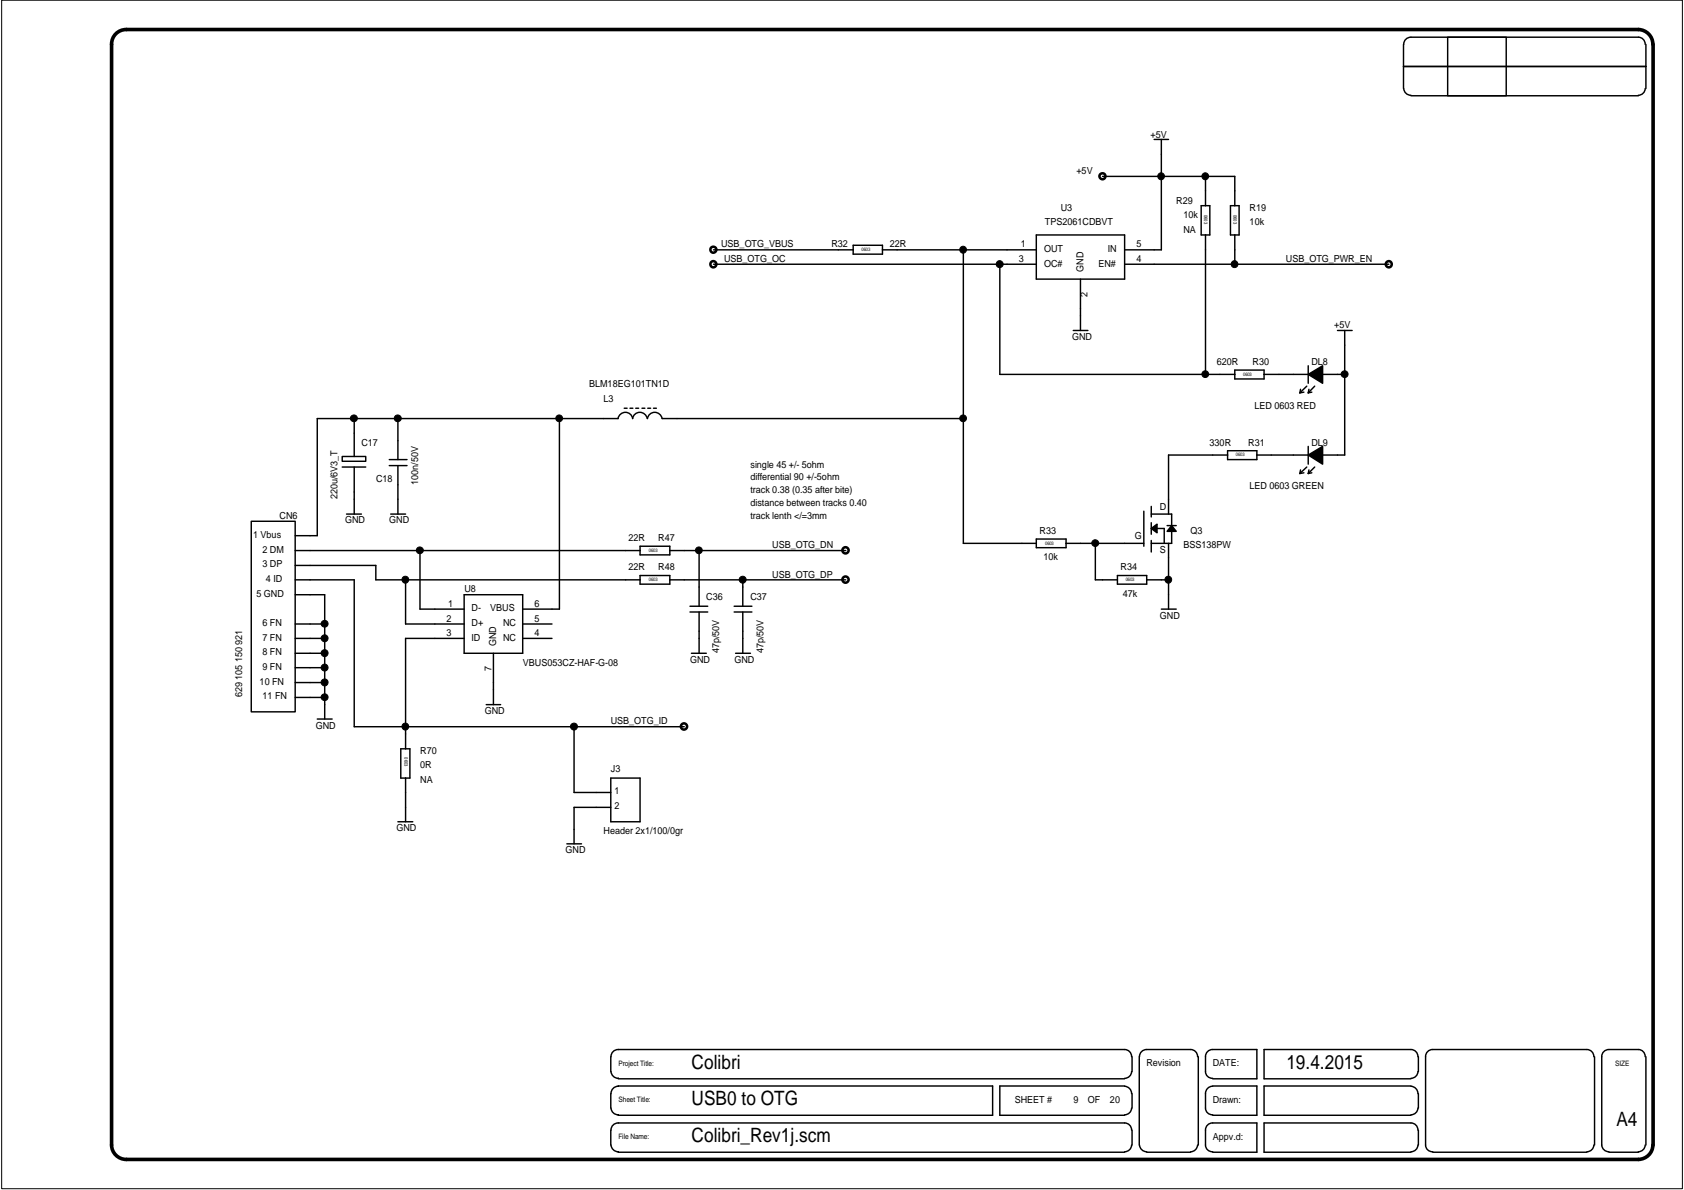
[picture p50: page 9]

3V3

## C19 10u/16V/X5R

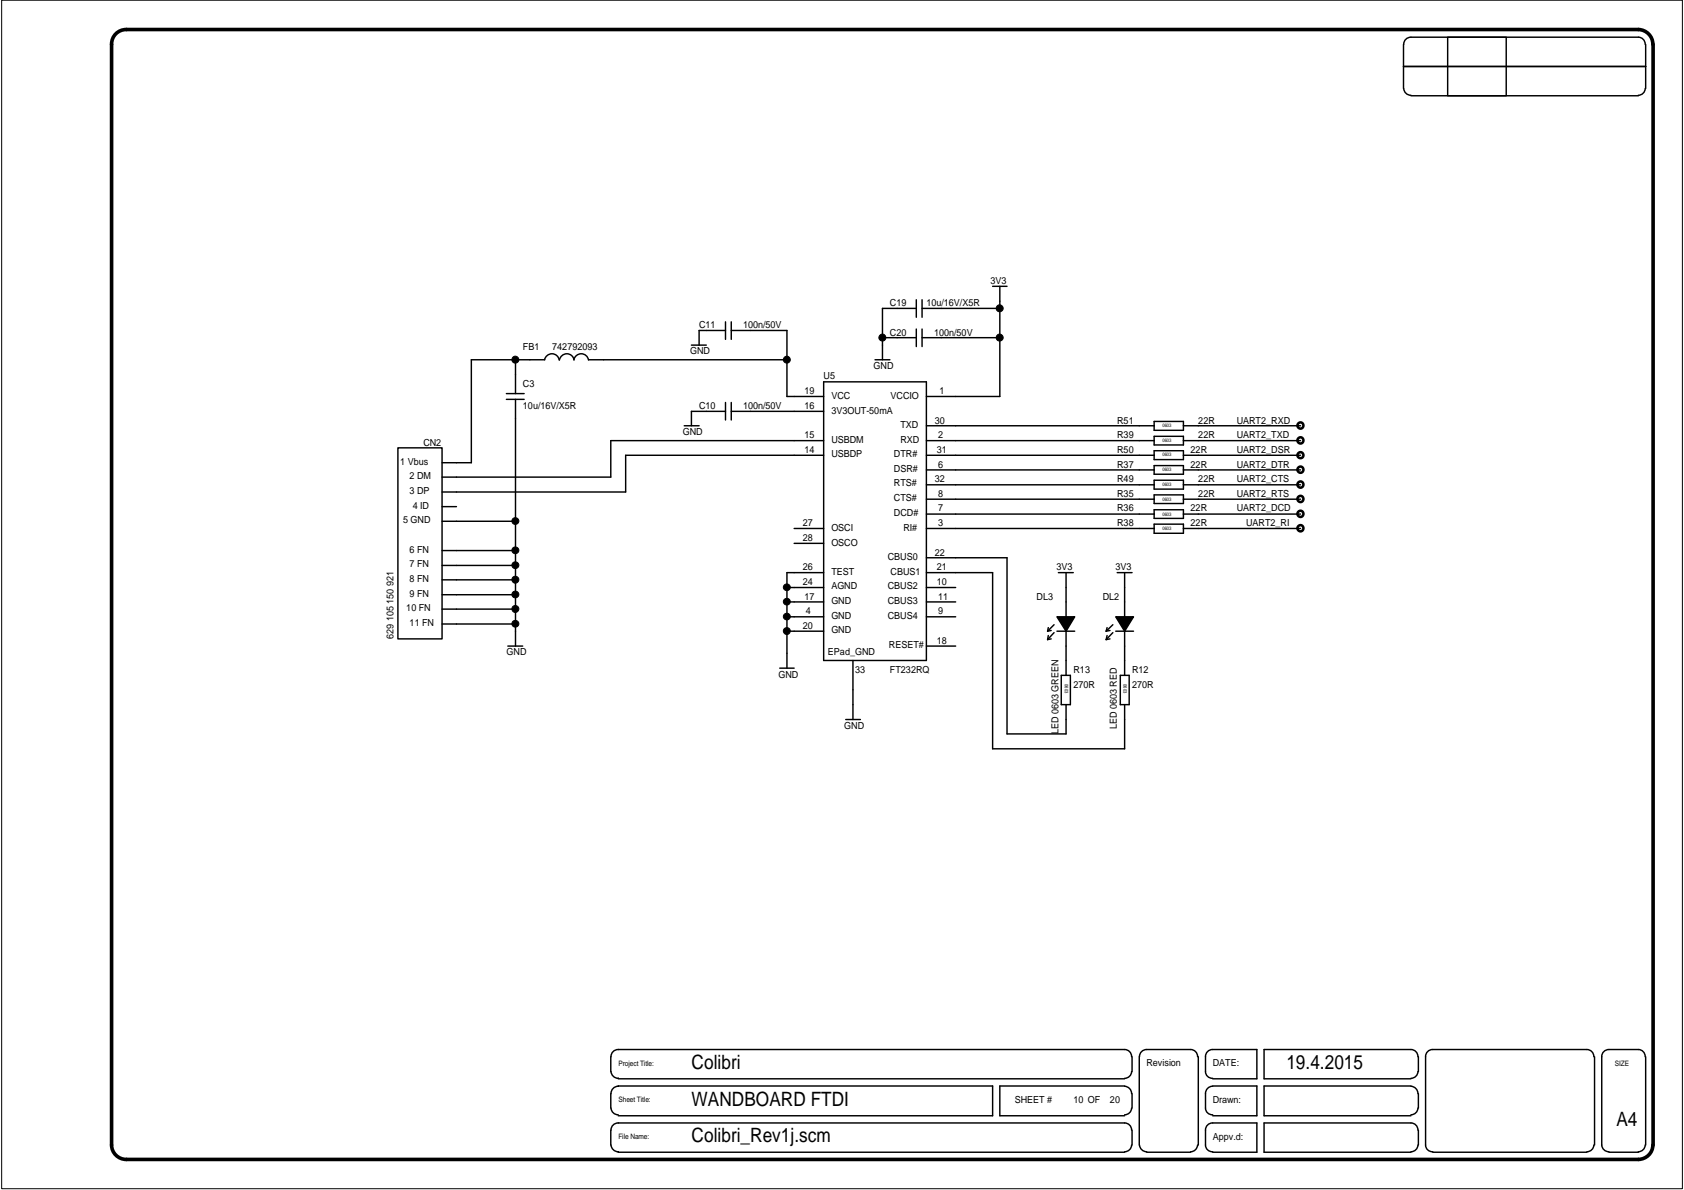
[picture p51: page 10]

3V3

## GND

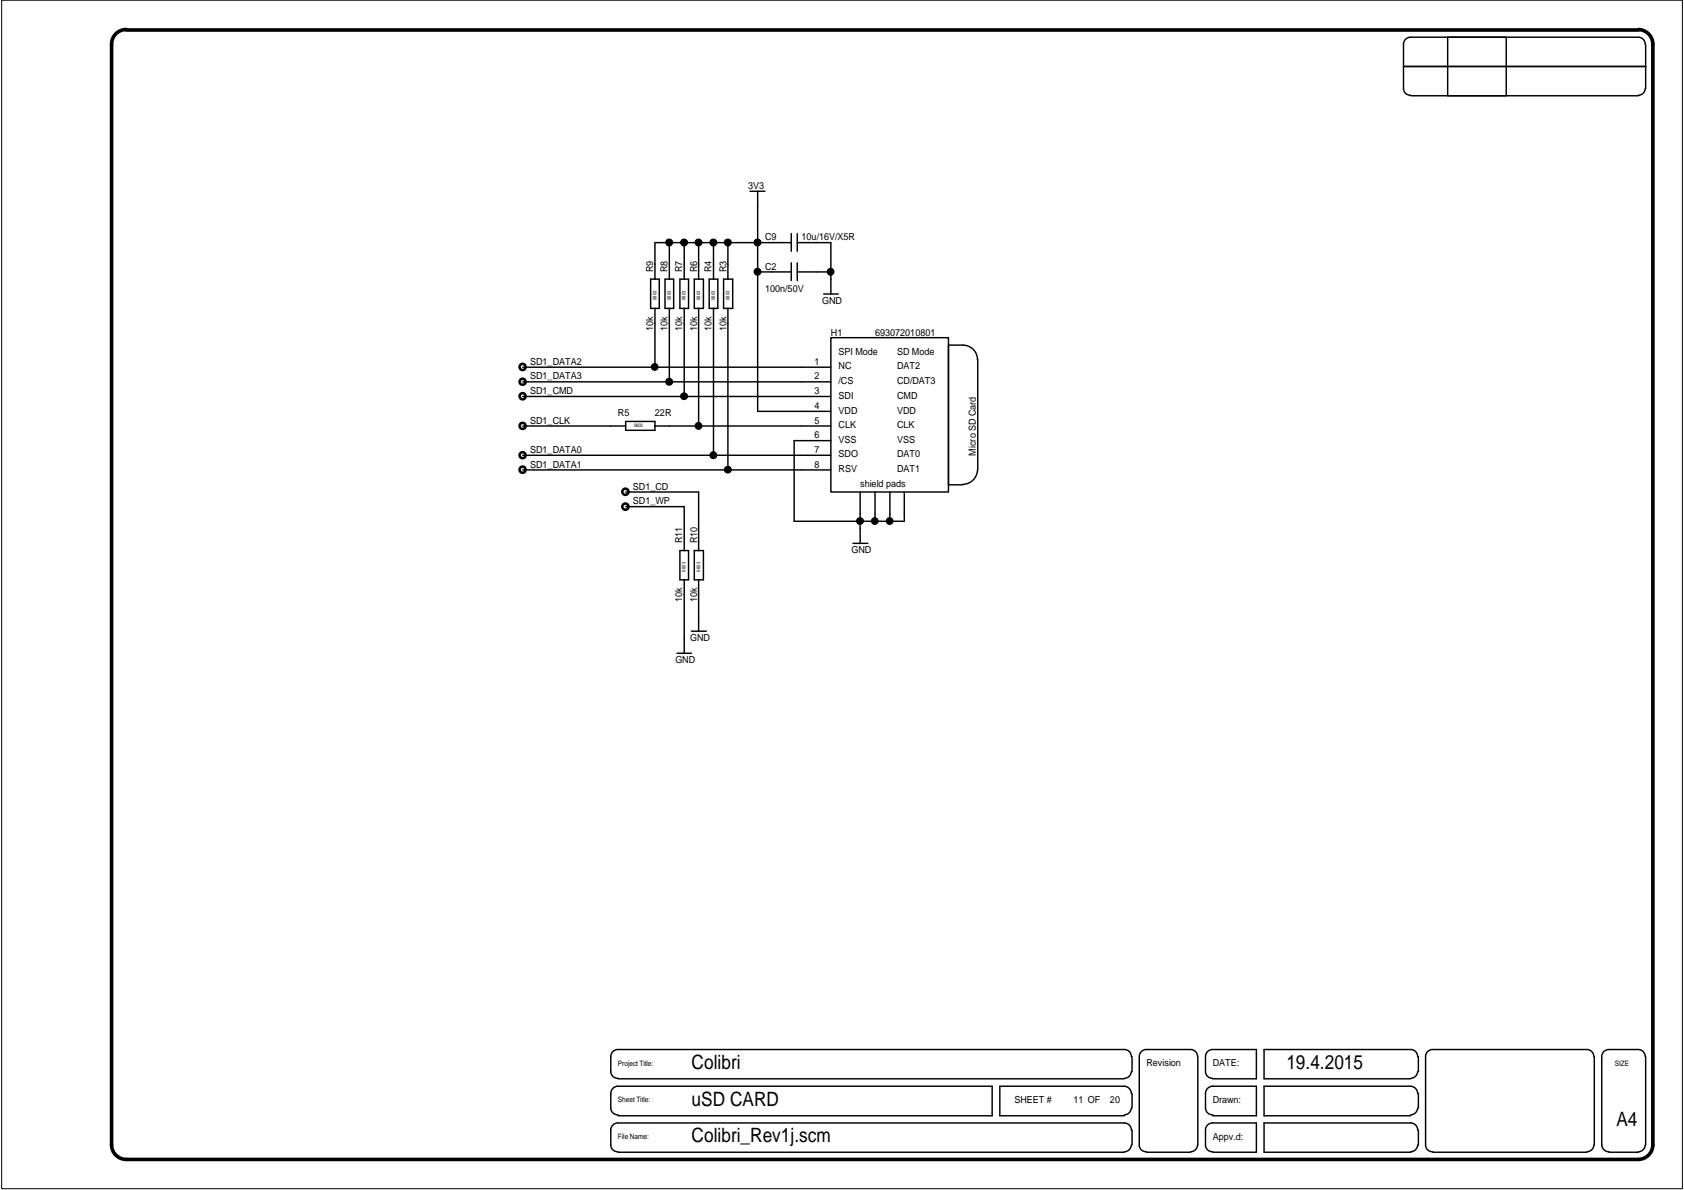
[picture p52: page 11]

Micro SD Card VSS

## single 50 +/- 5ohm differential 100 +/-5ohm

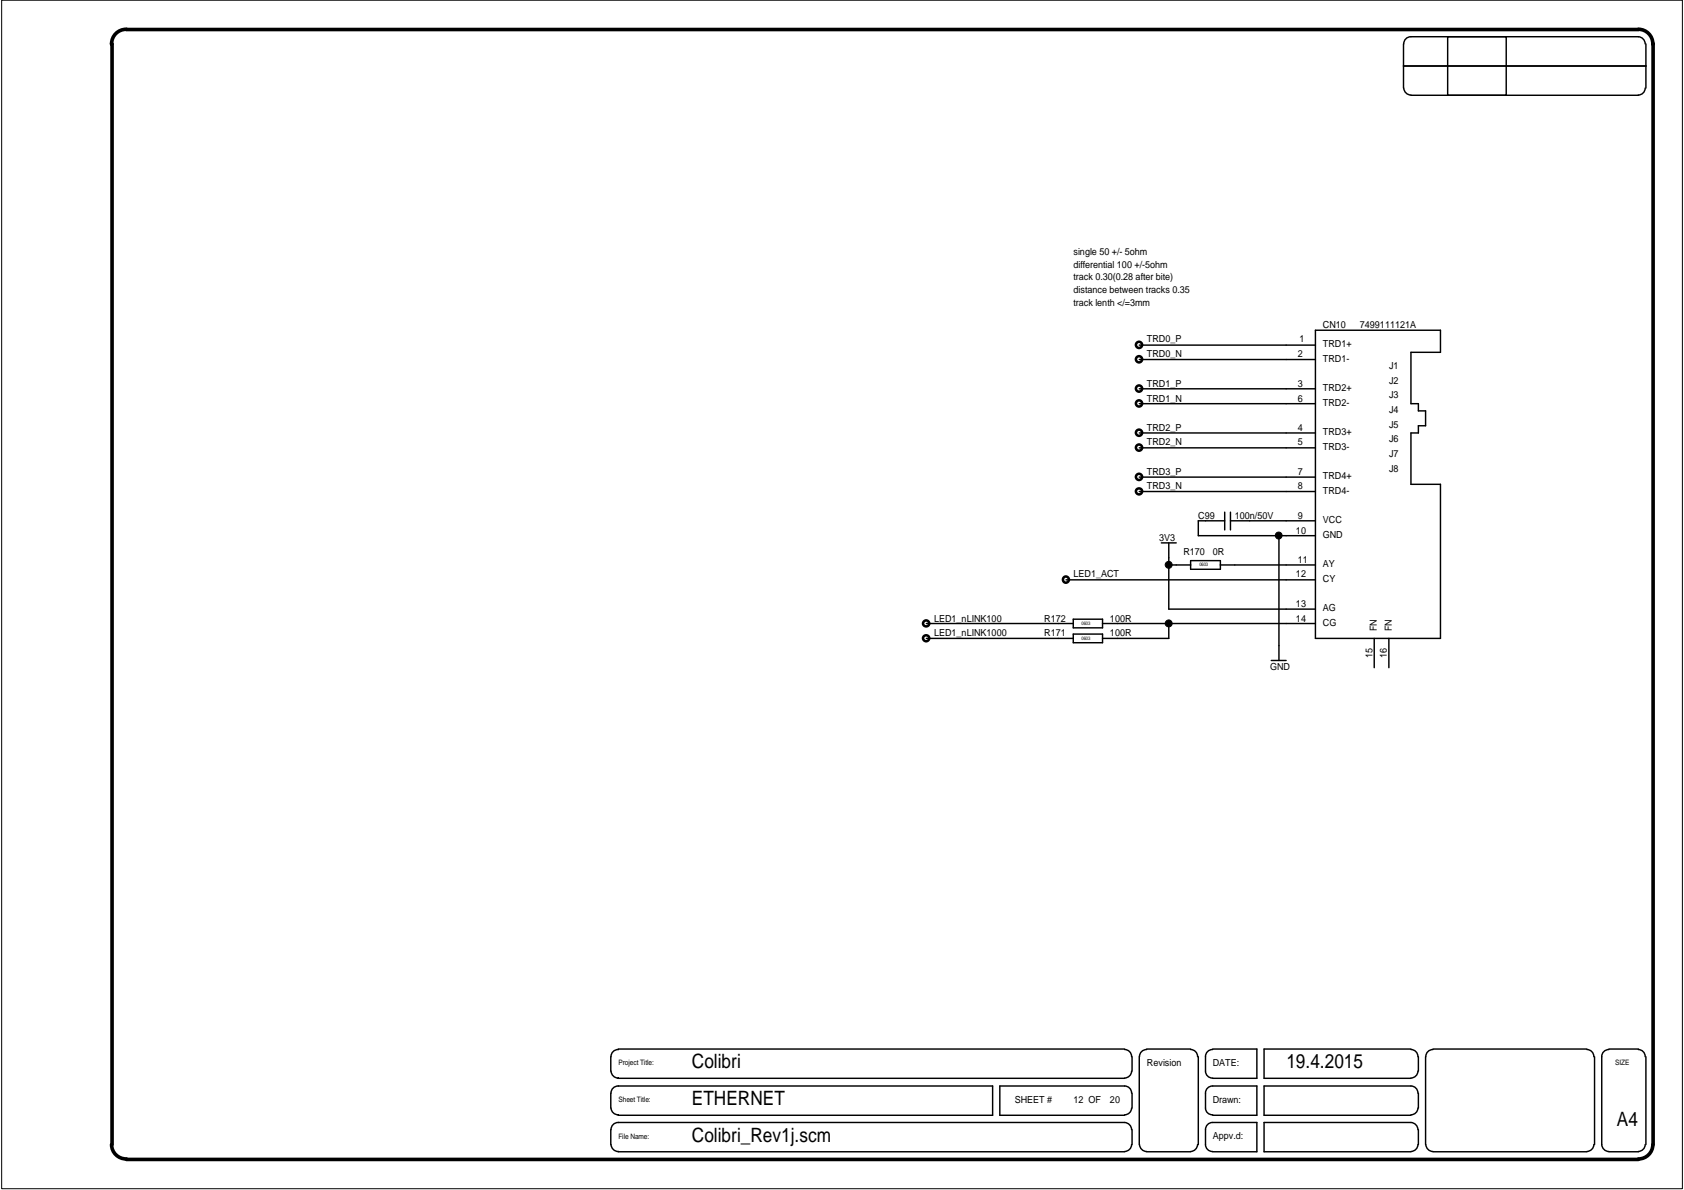
[picture p53: page 12]

3V3

+5V

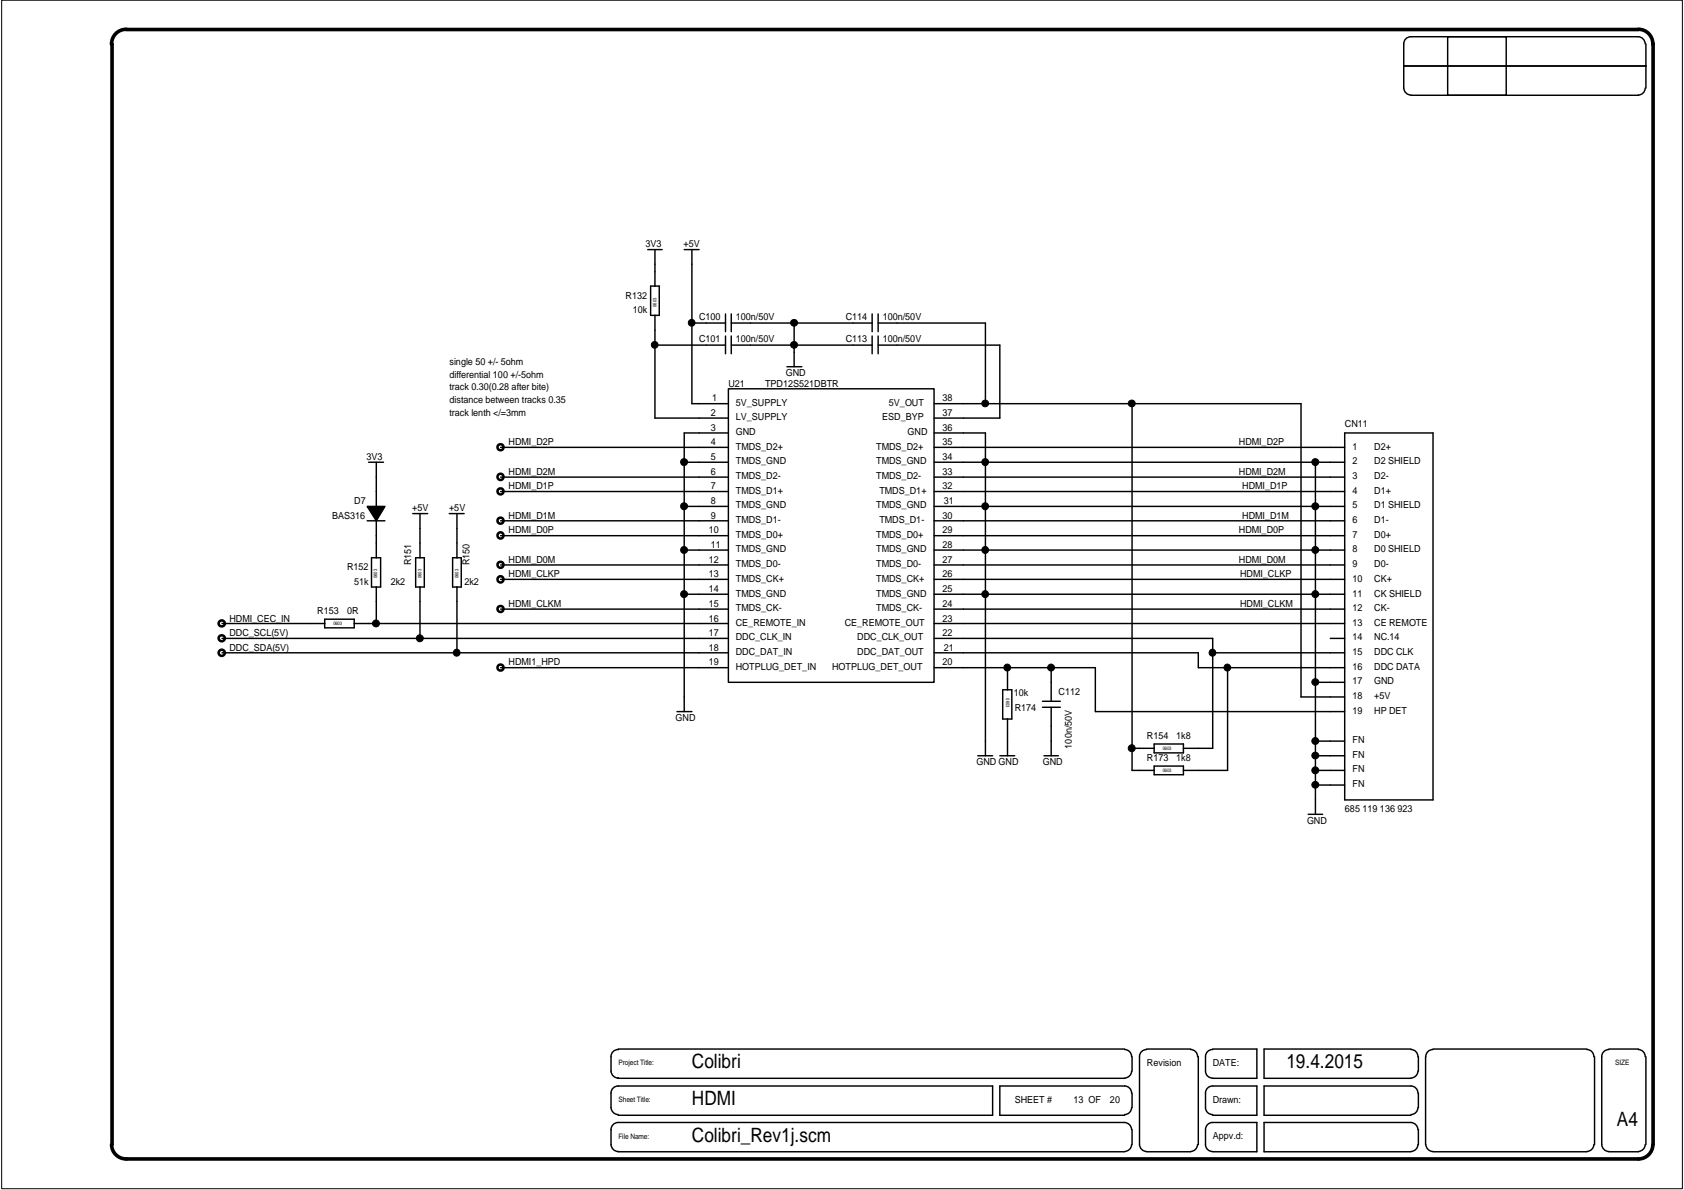
[picture p54: page 13]

## Vsys

## LVDS0_CABC

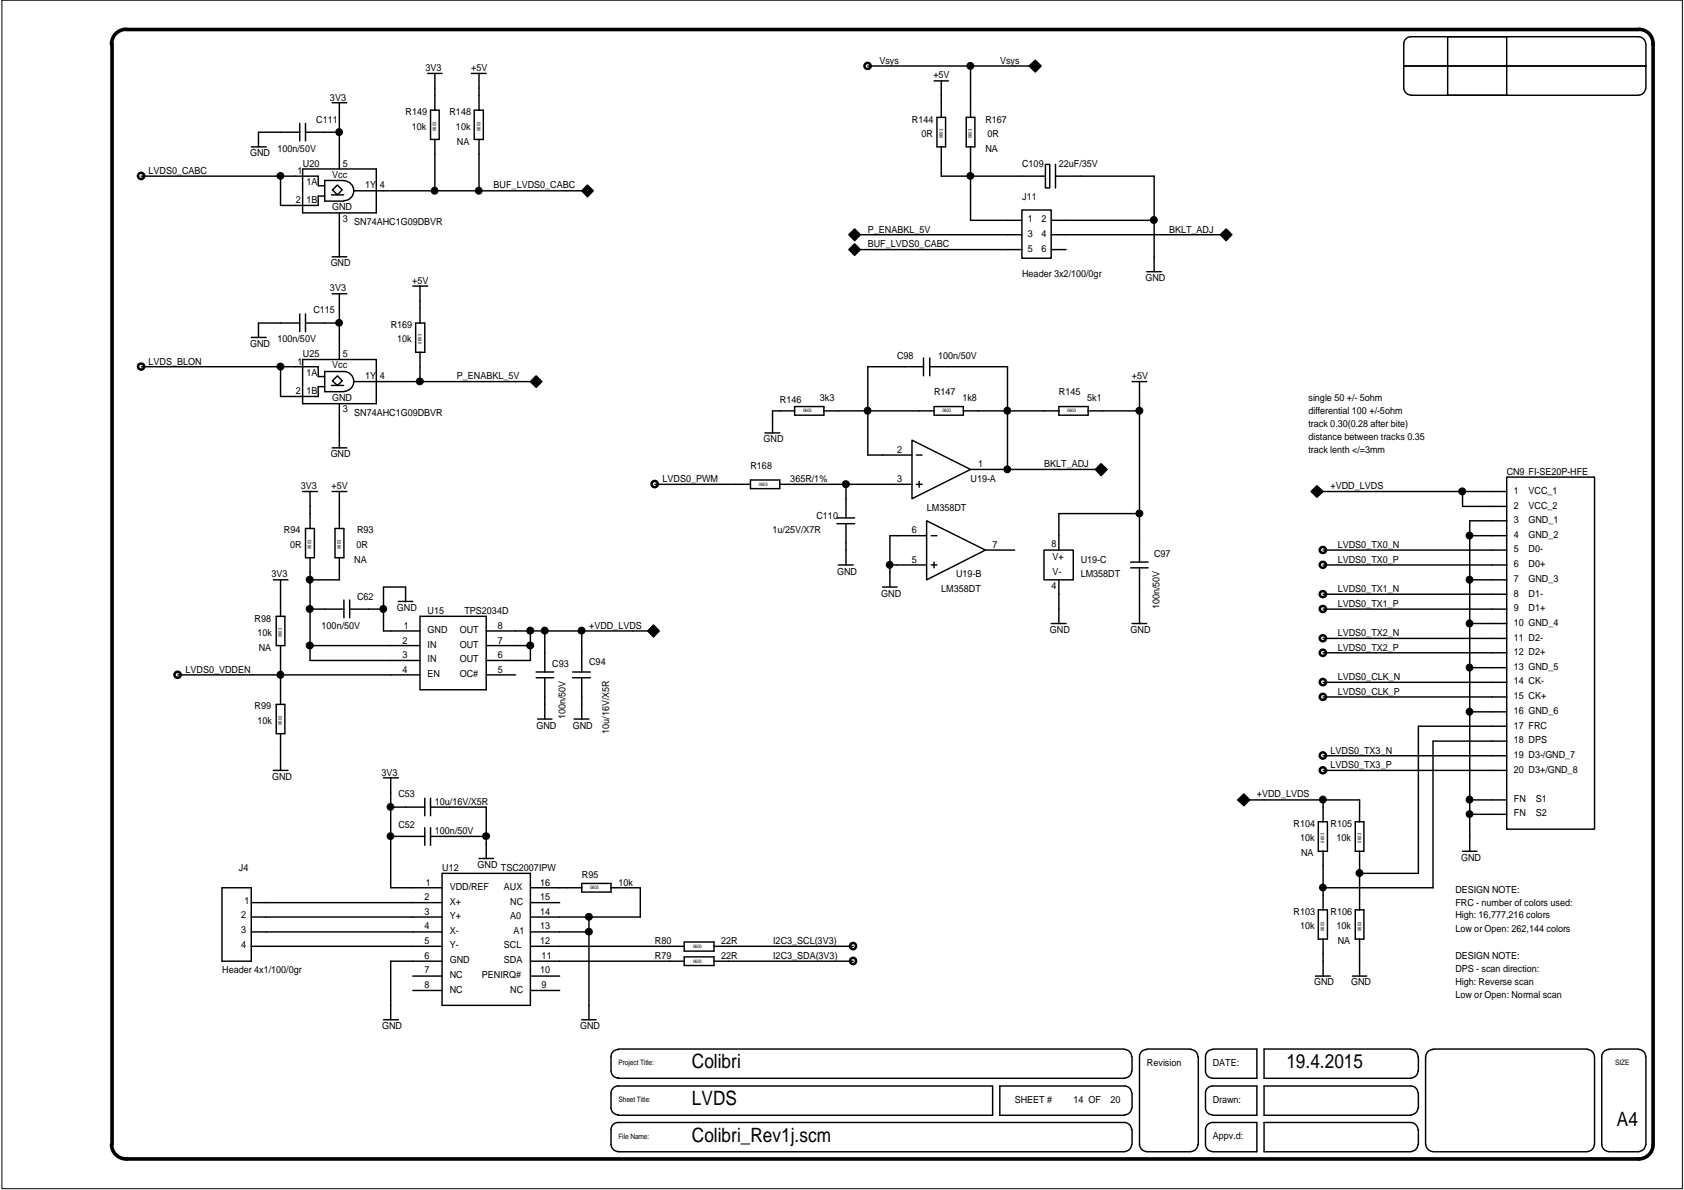
[picture p55: page 14]

DESIGN NOTE:
FRC - number of colors used:
High: 16,777,216 colors
Low or Open: 262,144 colors

DPS - scan direction:
High: Reverse scan
Low or Open: Normal scan

## USB_H1_OC

+5V

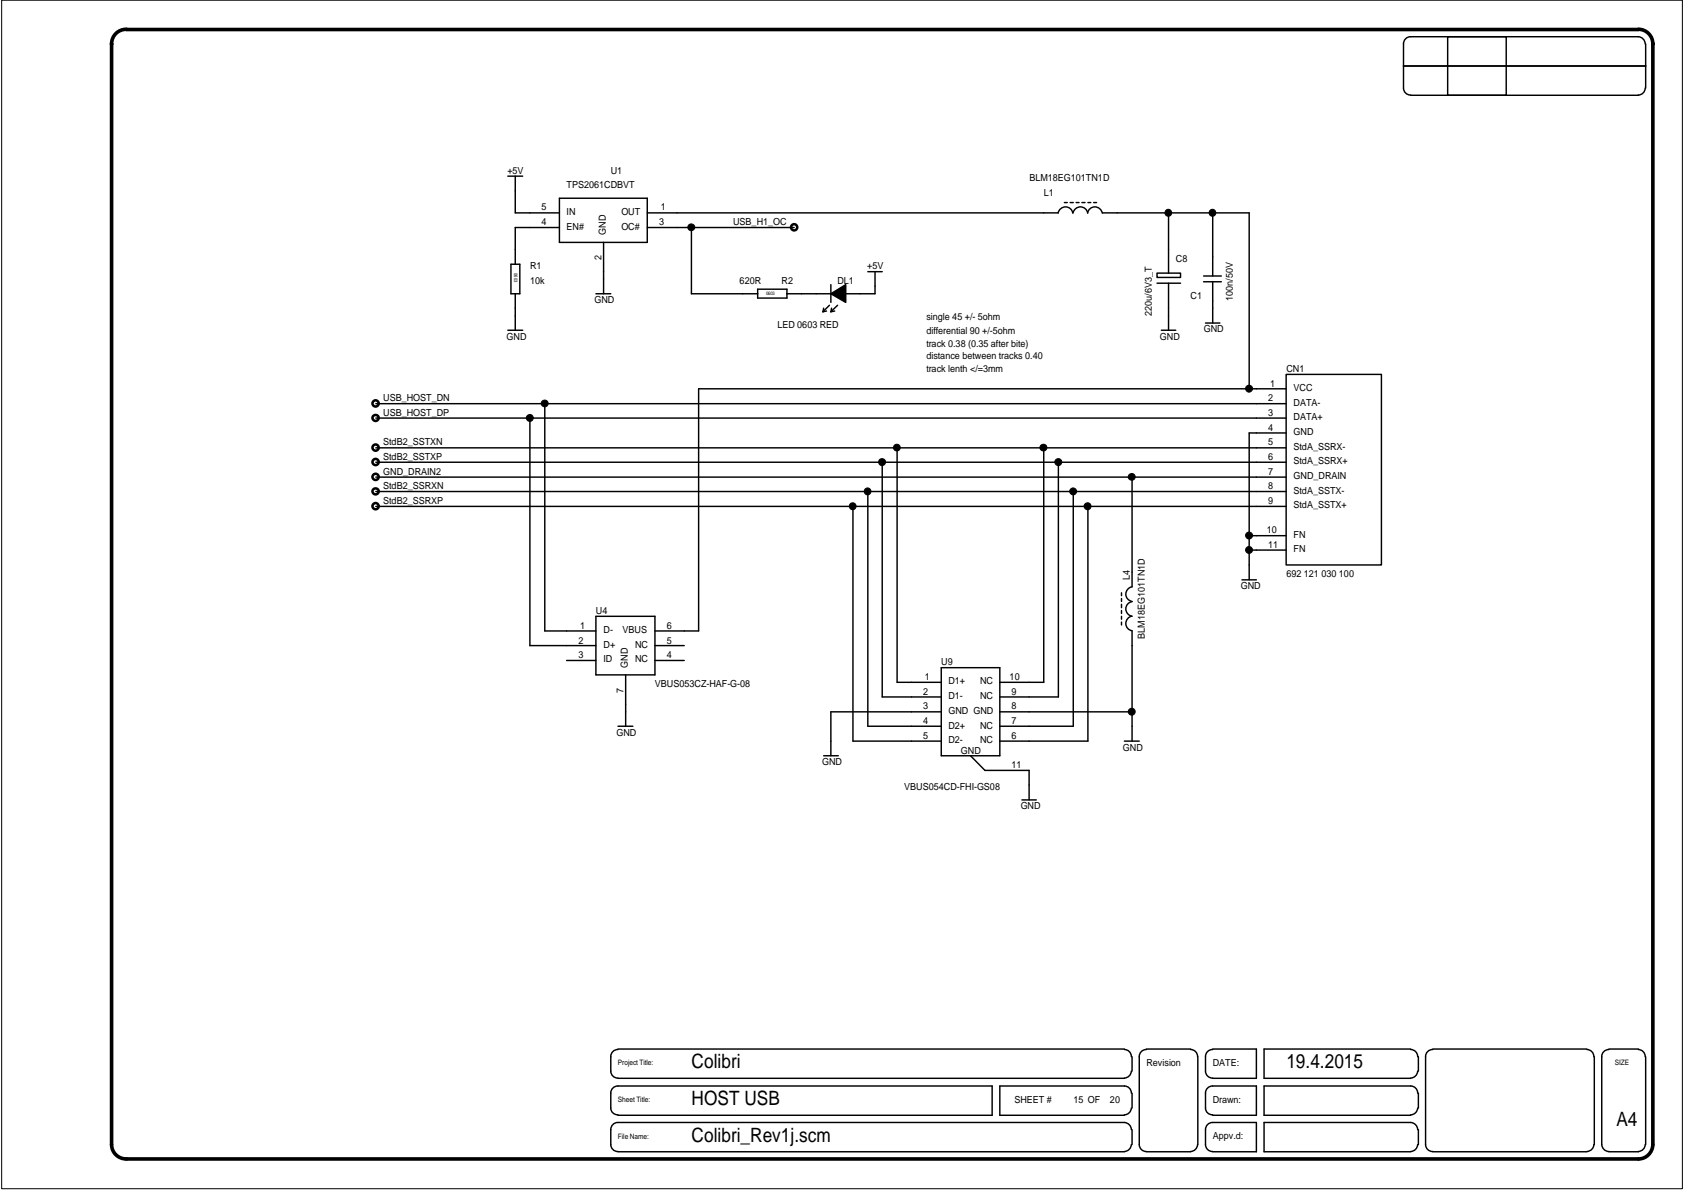
[picture p56: page 15]

+5V

## SRV_PWM_0

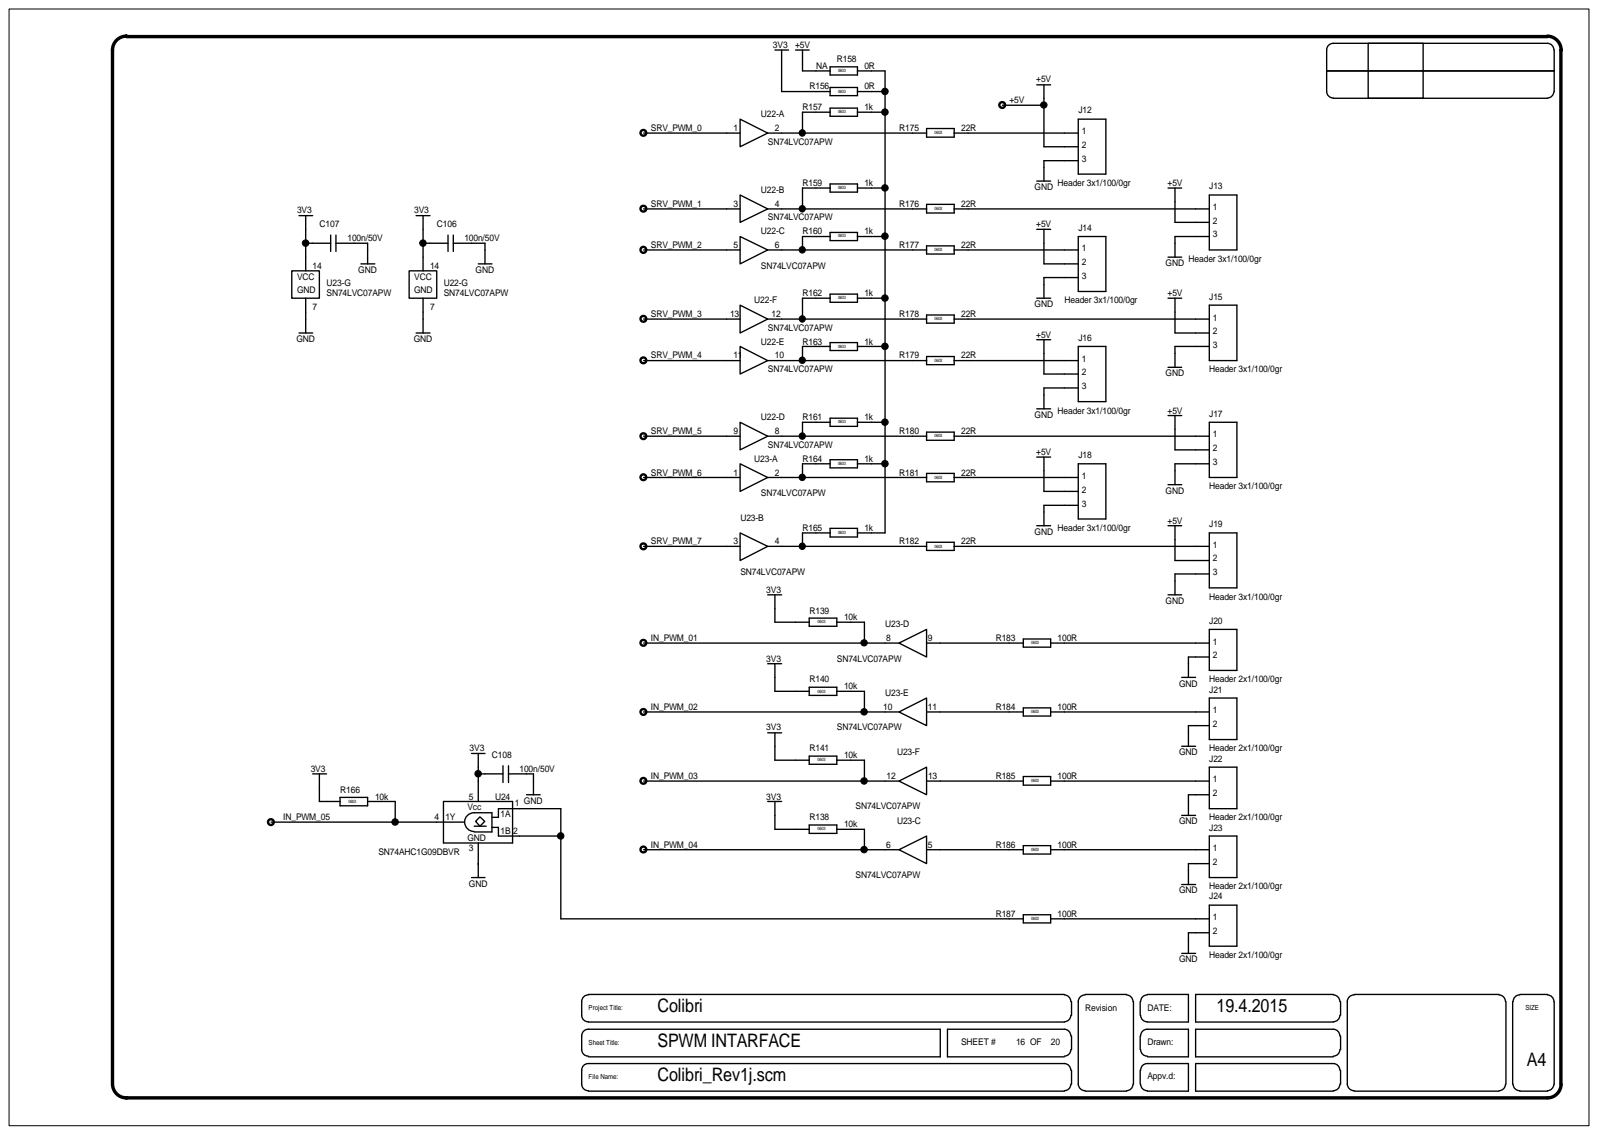
[picture p57: page 16]

3V3

3V3

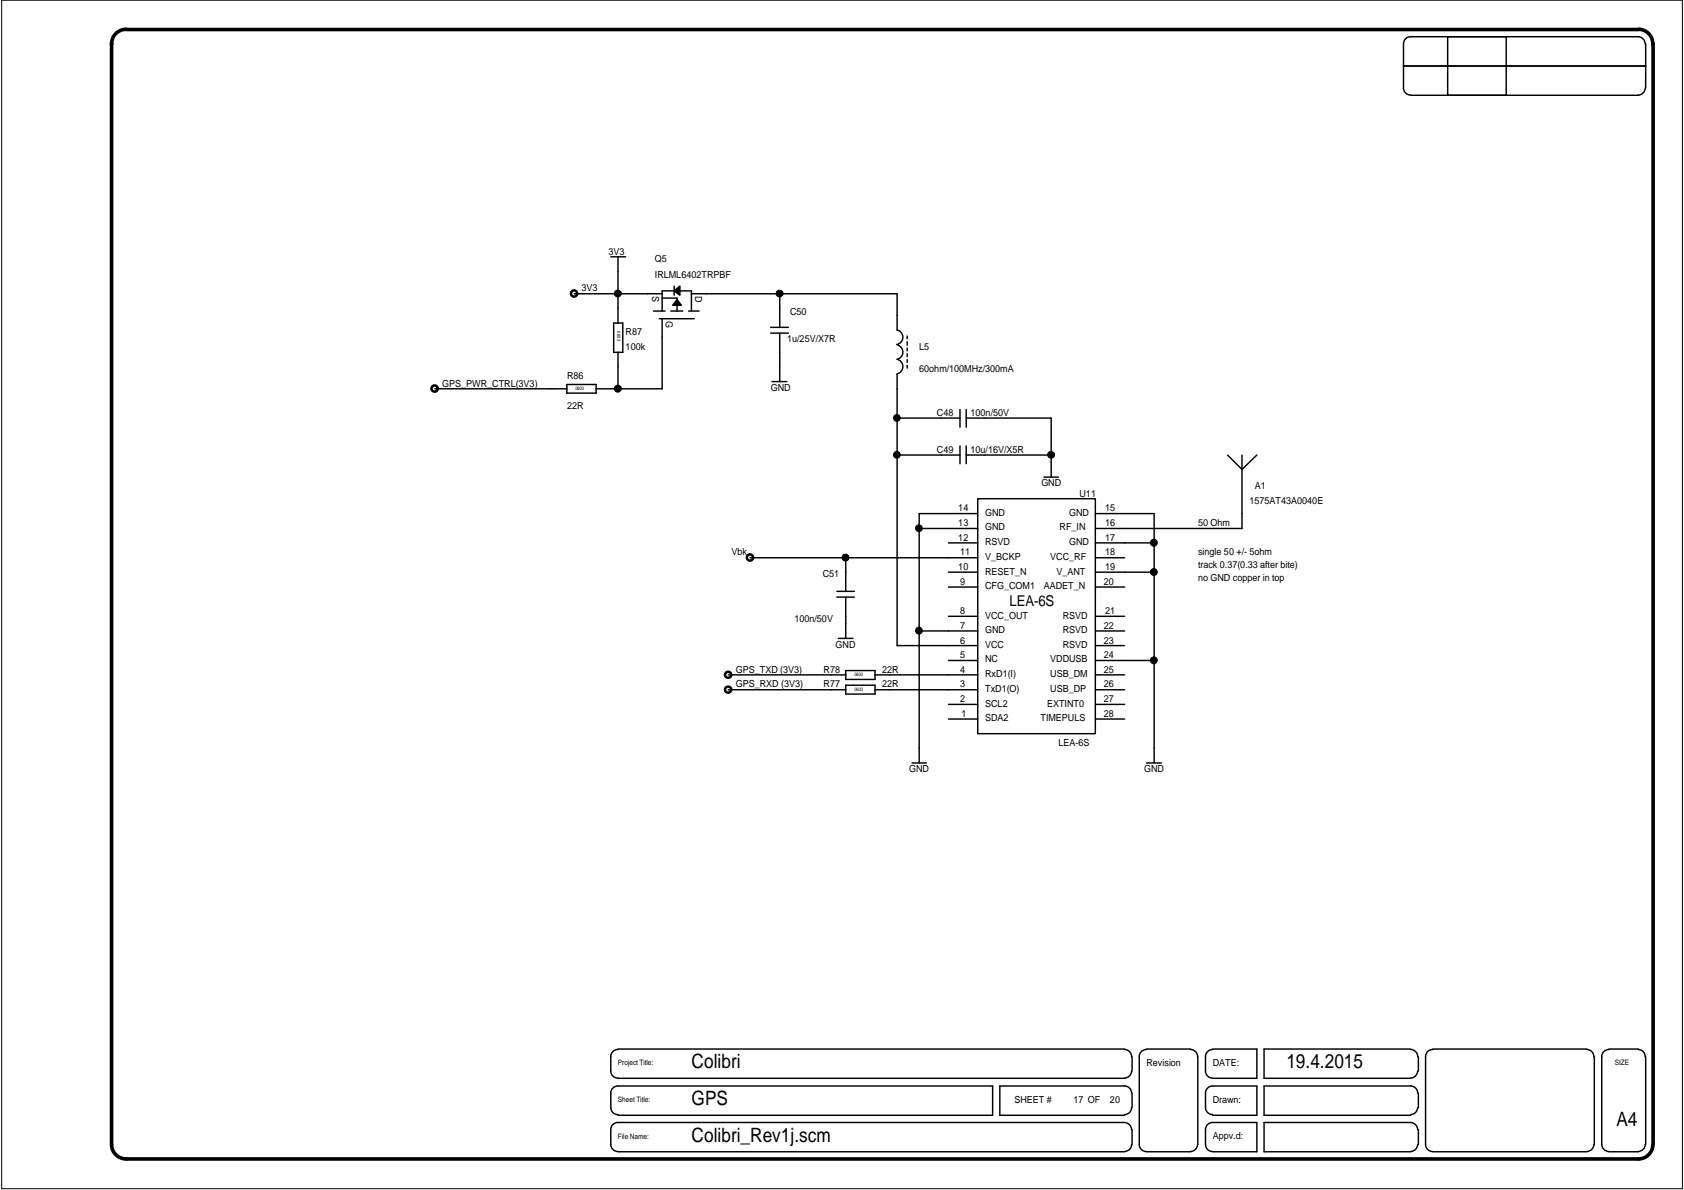
[picture p58: page 17]

single 50 +/- 5ohm
track 0.37(0.33 after bite)
no GND copper in top

## MEMS_SPI_SCL MEMS_SPI_MOSI

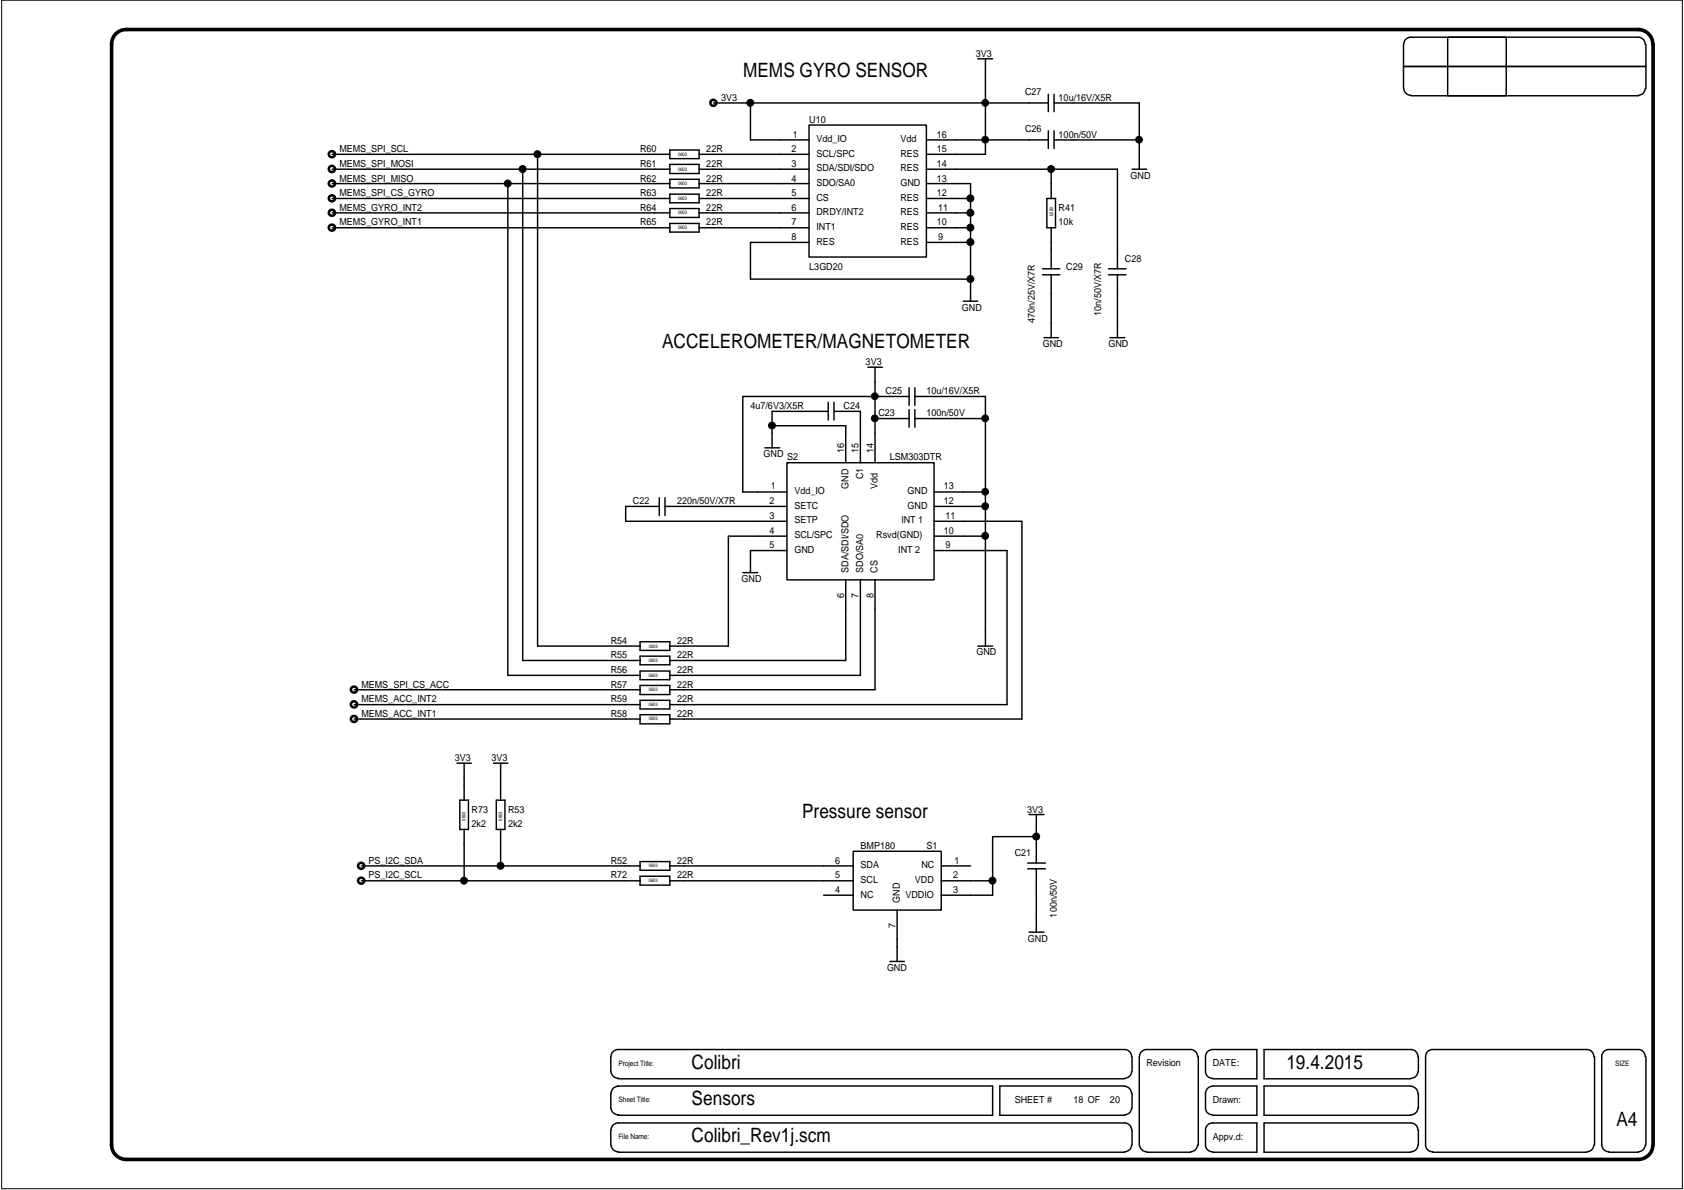
[picture p59: page 18]

3V3

## C12 10u/16V/X5R

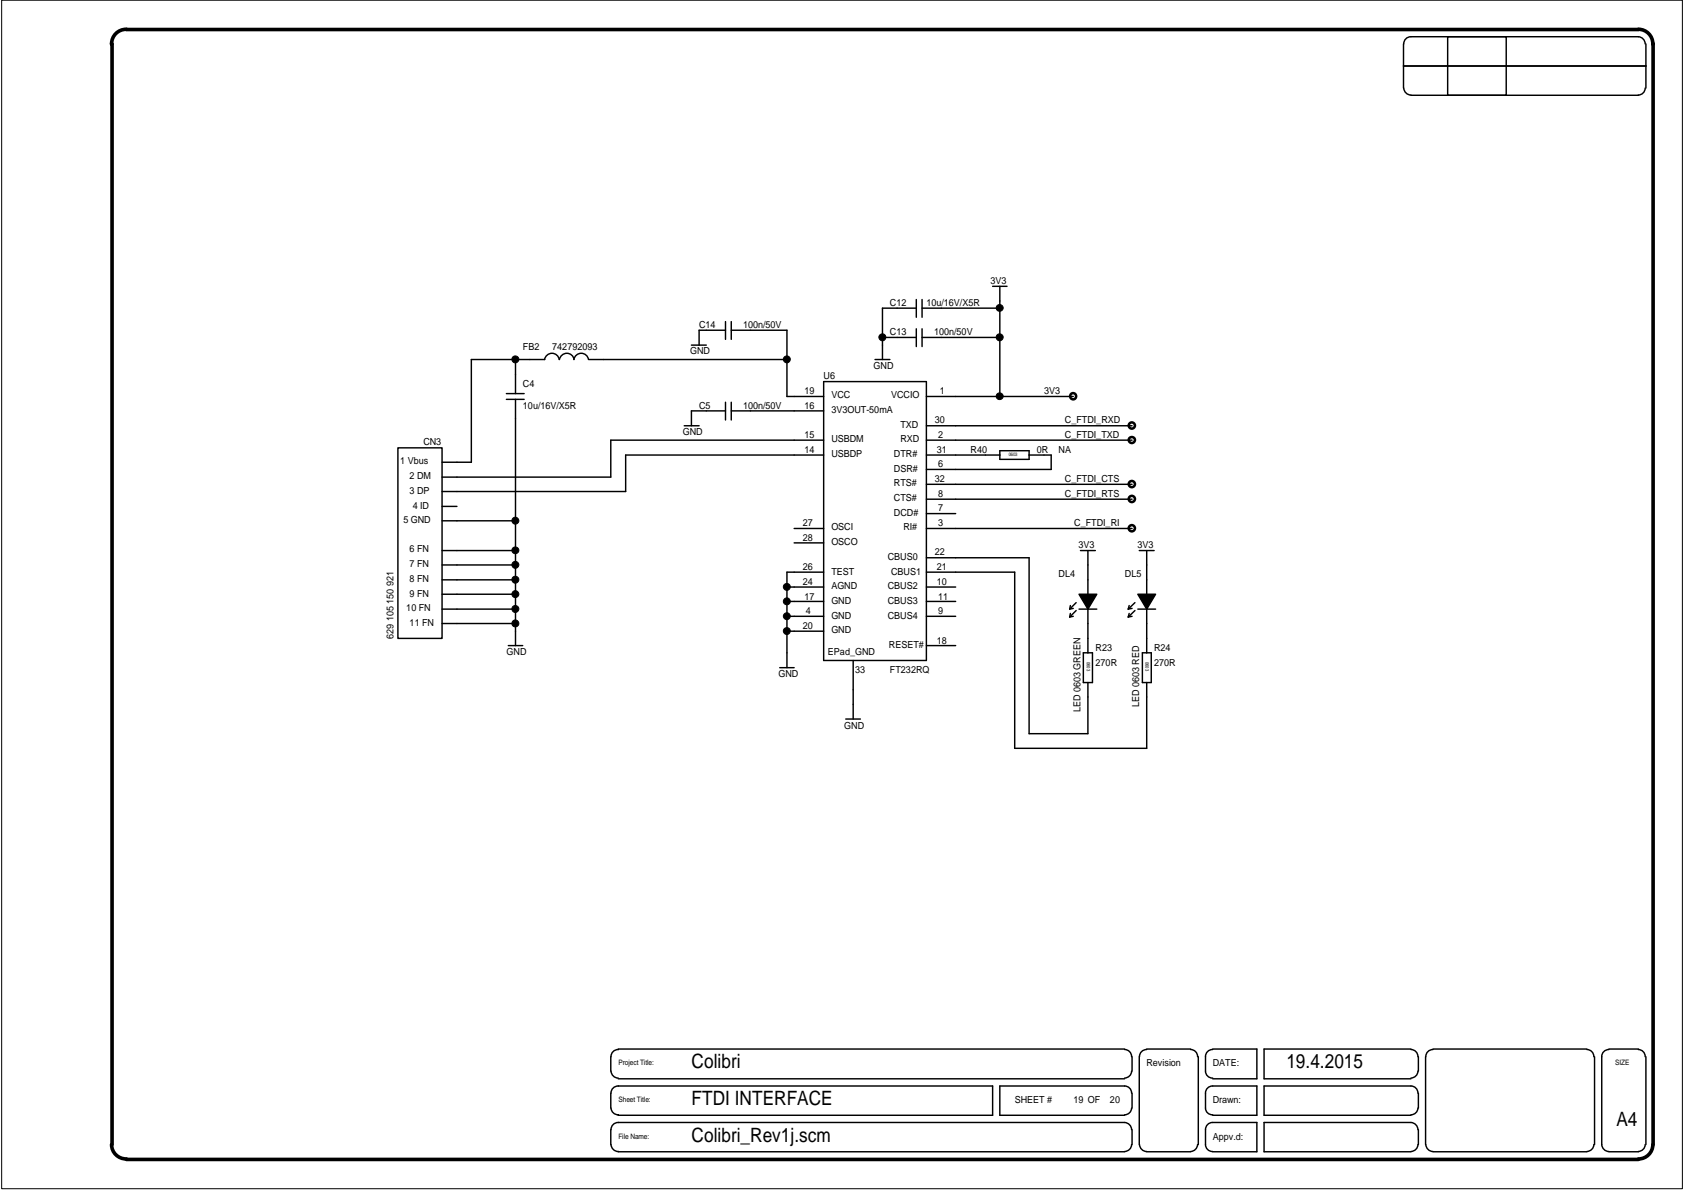
[picture p60: page 19]

3V3

+5V

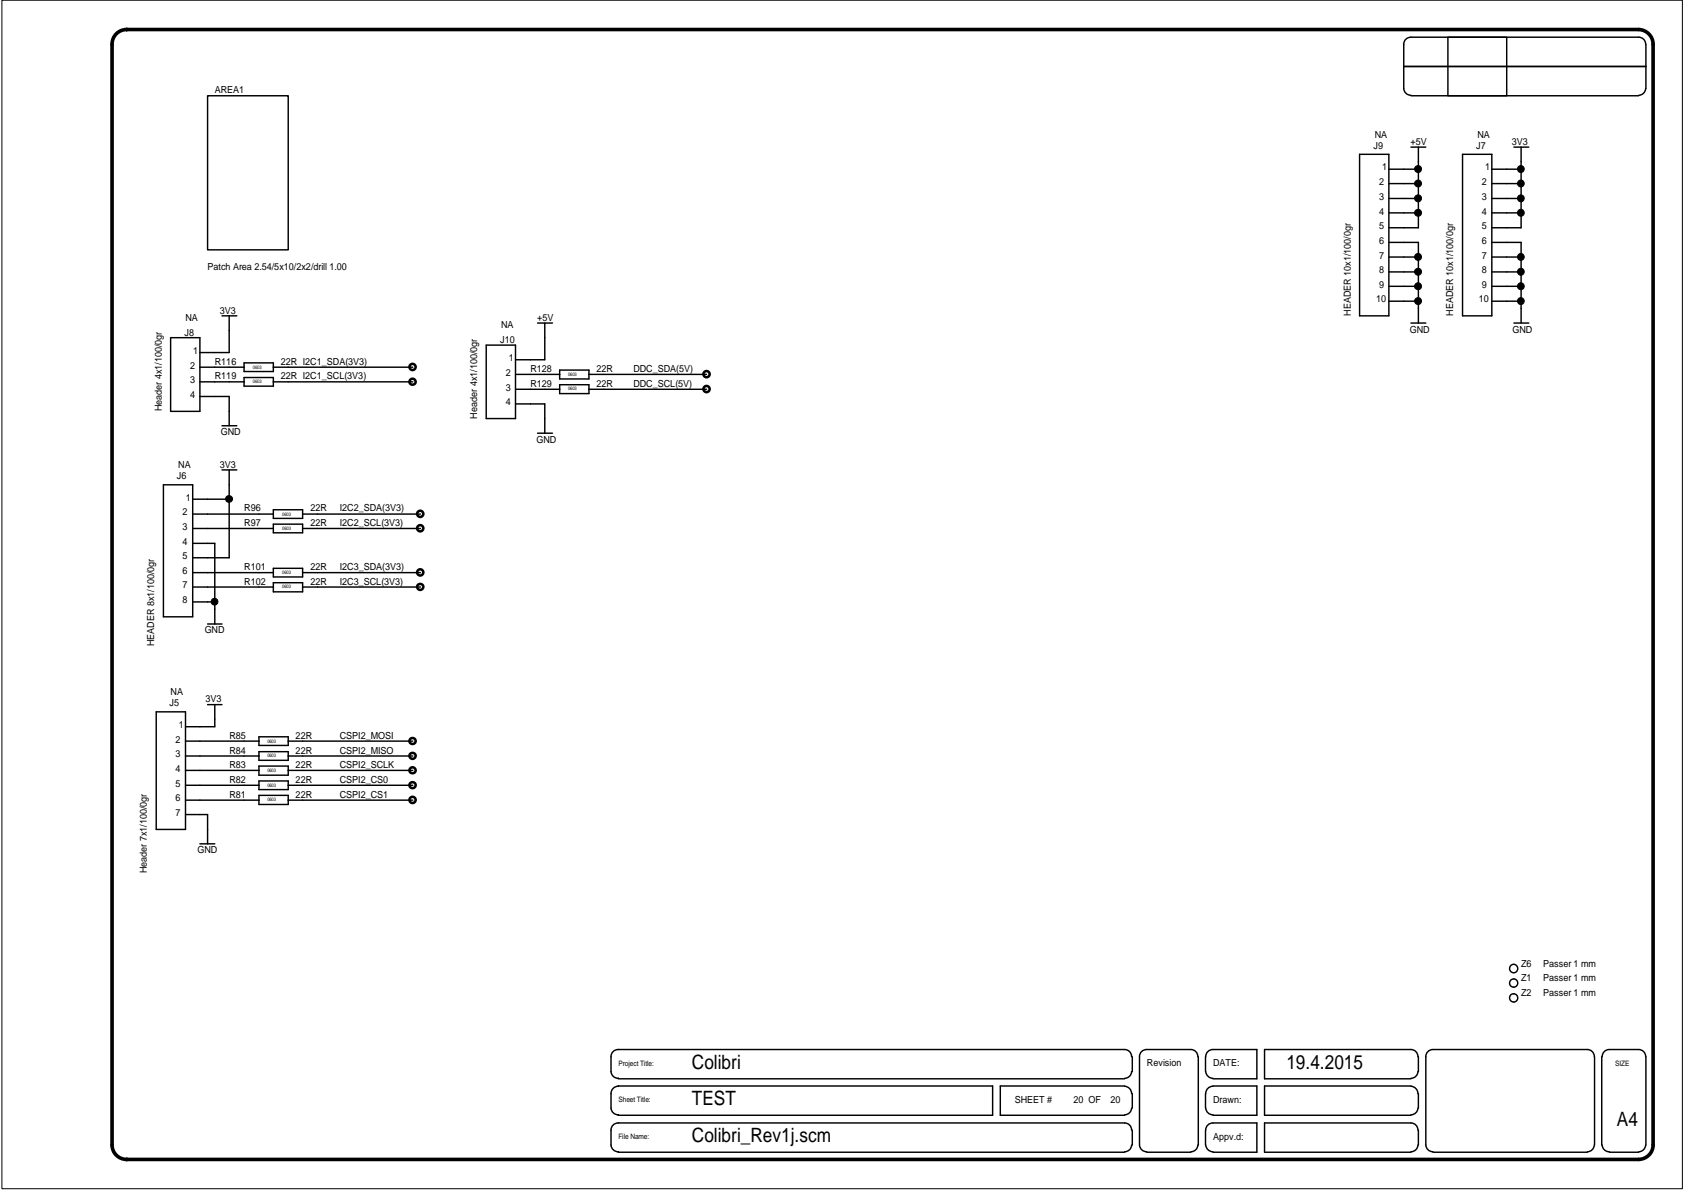
[picture p61: page 20]
