sigmadrone/sigmadrone/hardware/colibri/rev1j/Colibri_Rev1j_Bot_SS_P&P-no pads.pdf

# Colibri_Rev1

04.2015

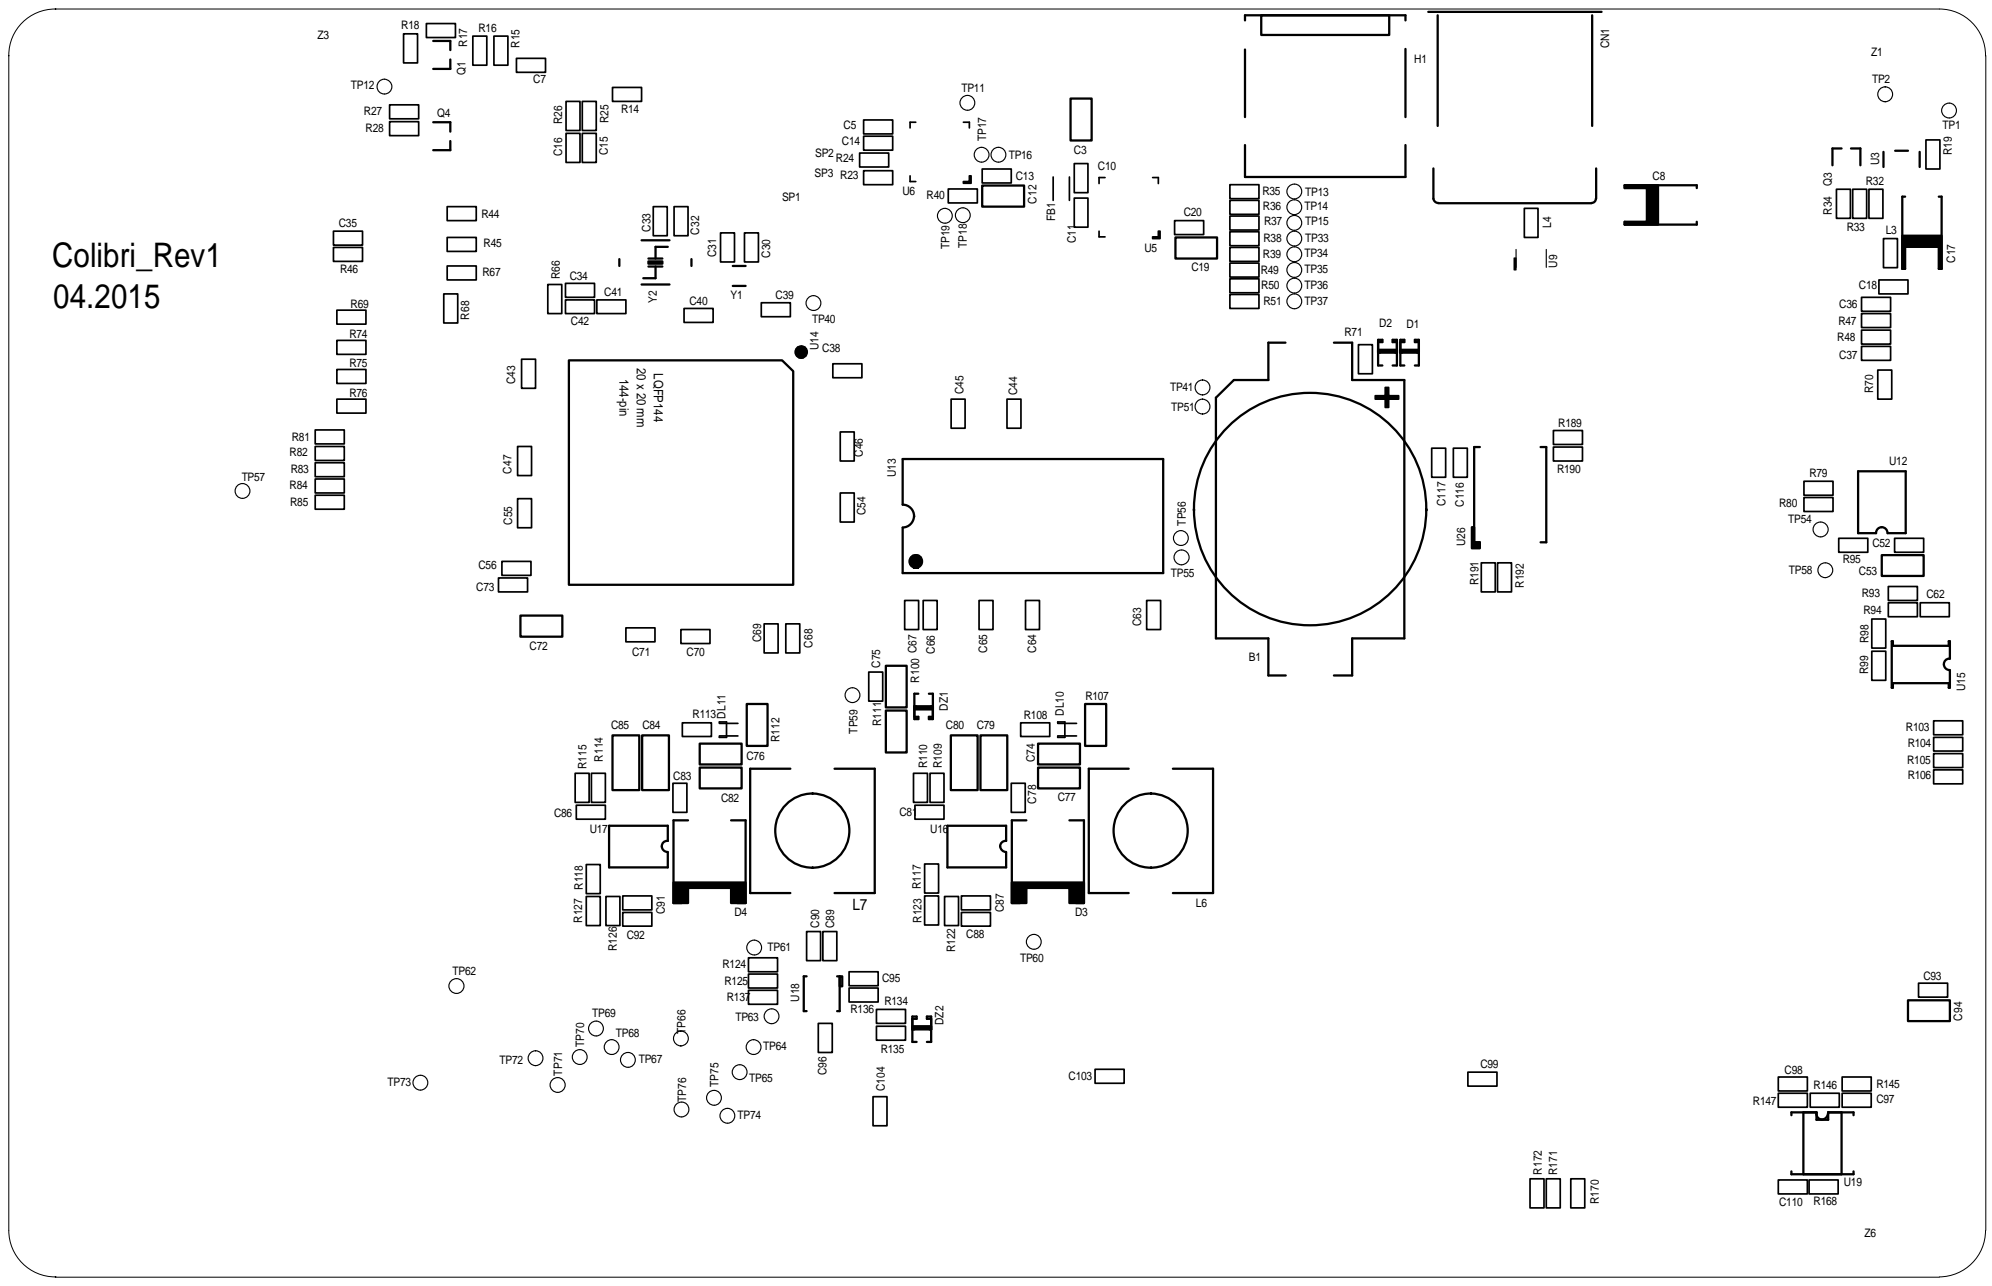
[picture p62: page 1]
