sigmadrone/sigmadrone/hardware/colibri/rev1j/Colibri_Rev1j_Bot_SS_P&P.pdf

# Colibri_Rev1

04.2015

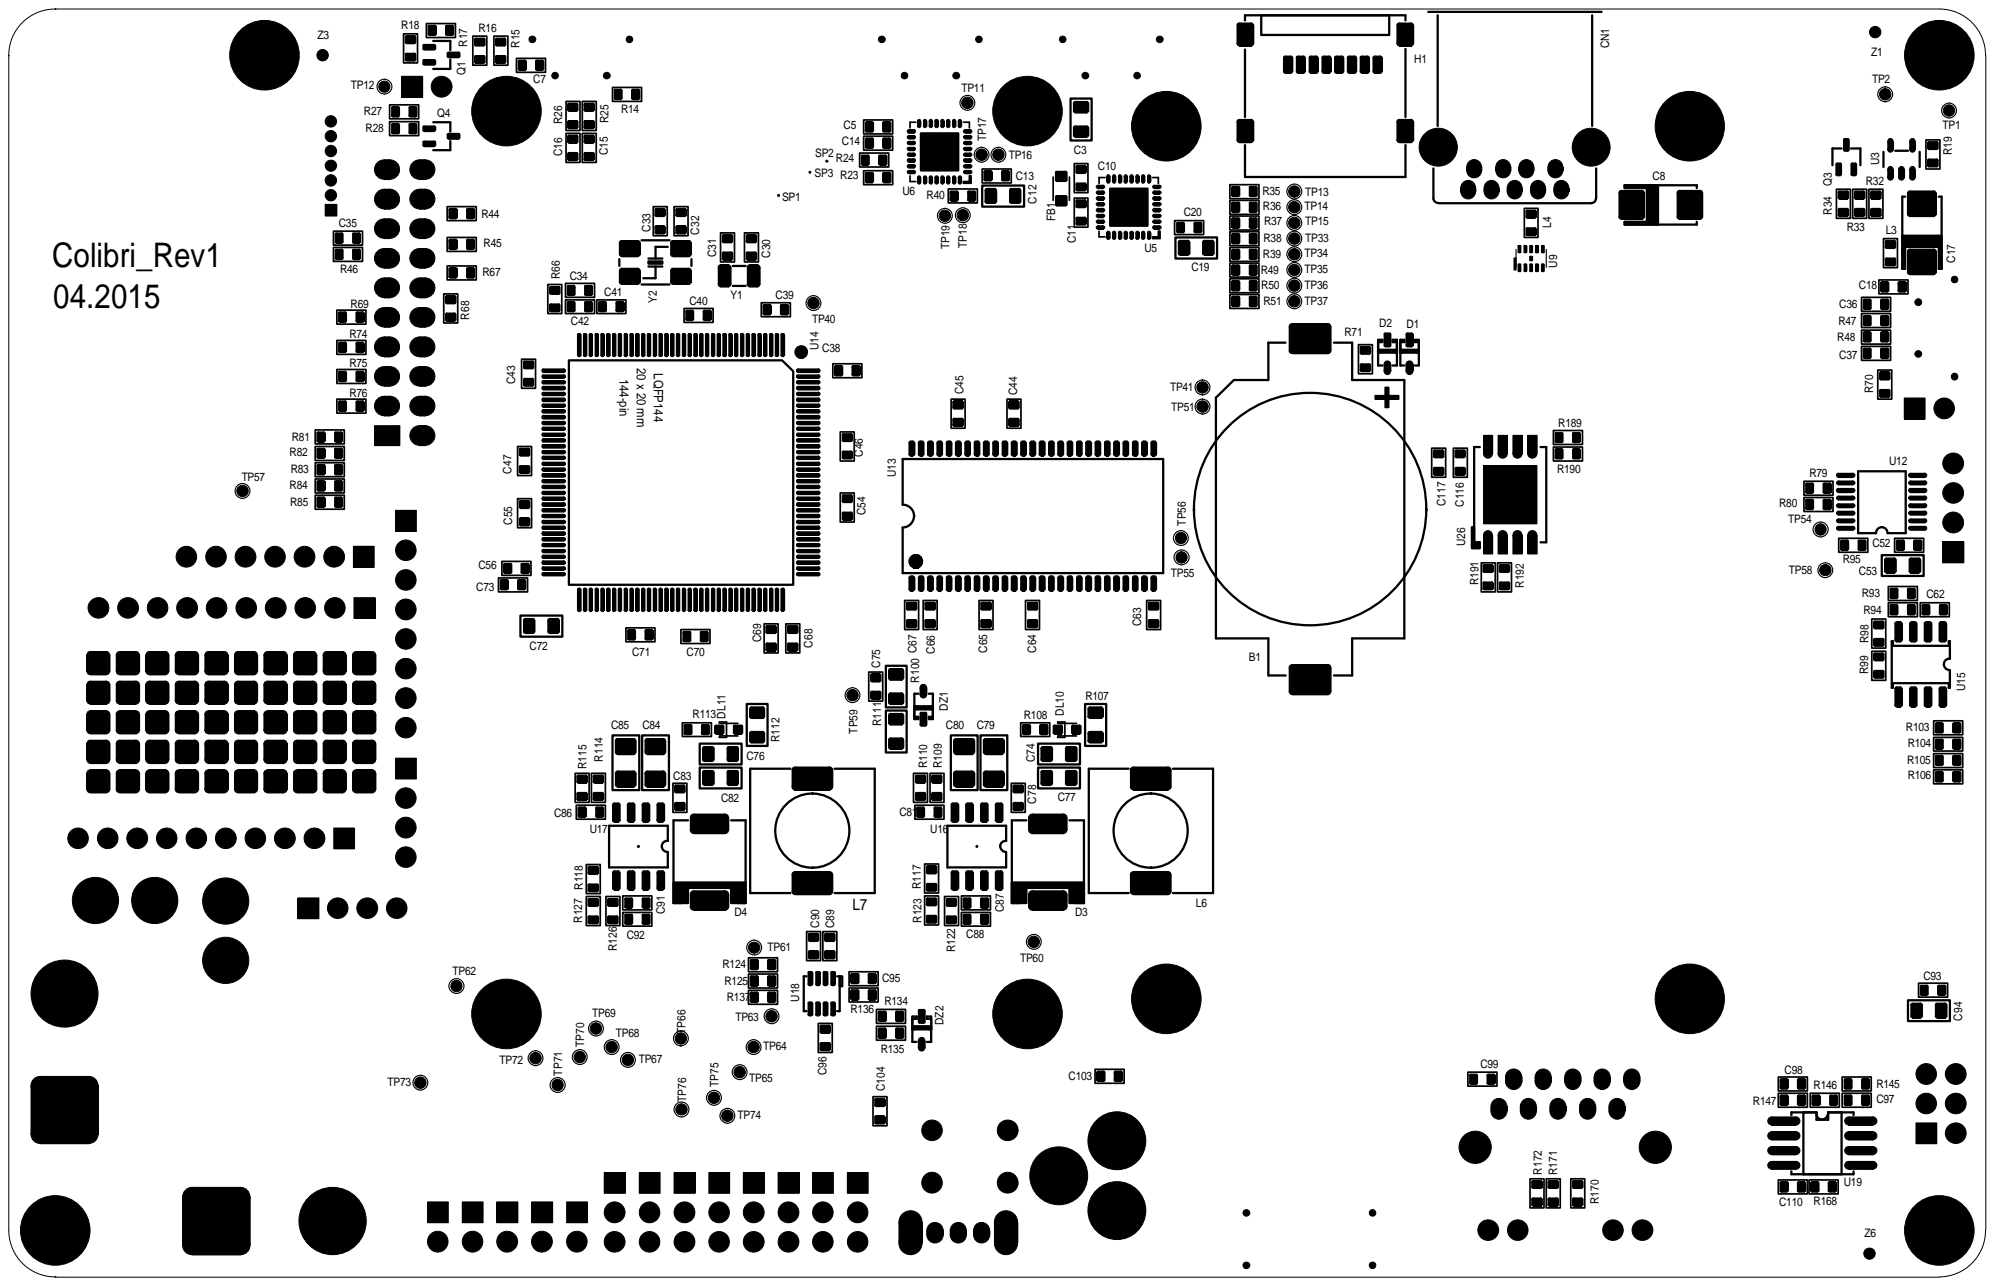
[picture p63: page 1]
