sigmadrone/sigmadrone/hardware/colibri/rev1j/Colibri_Rev1j_GERBER View.pdf

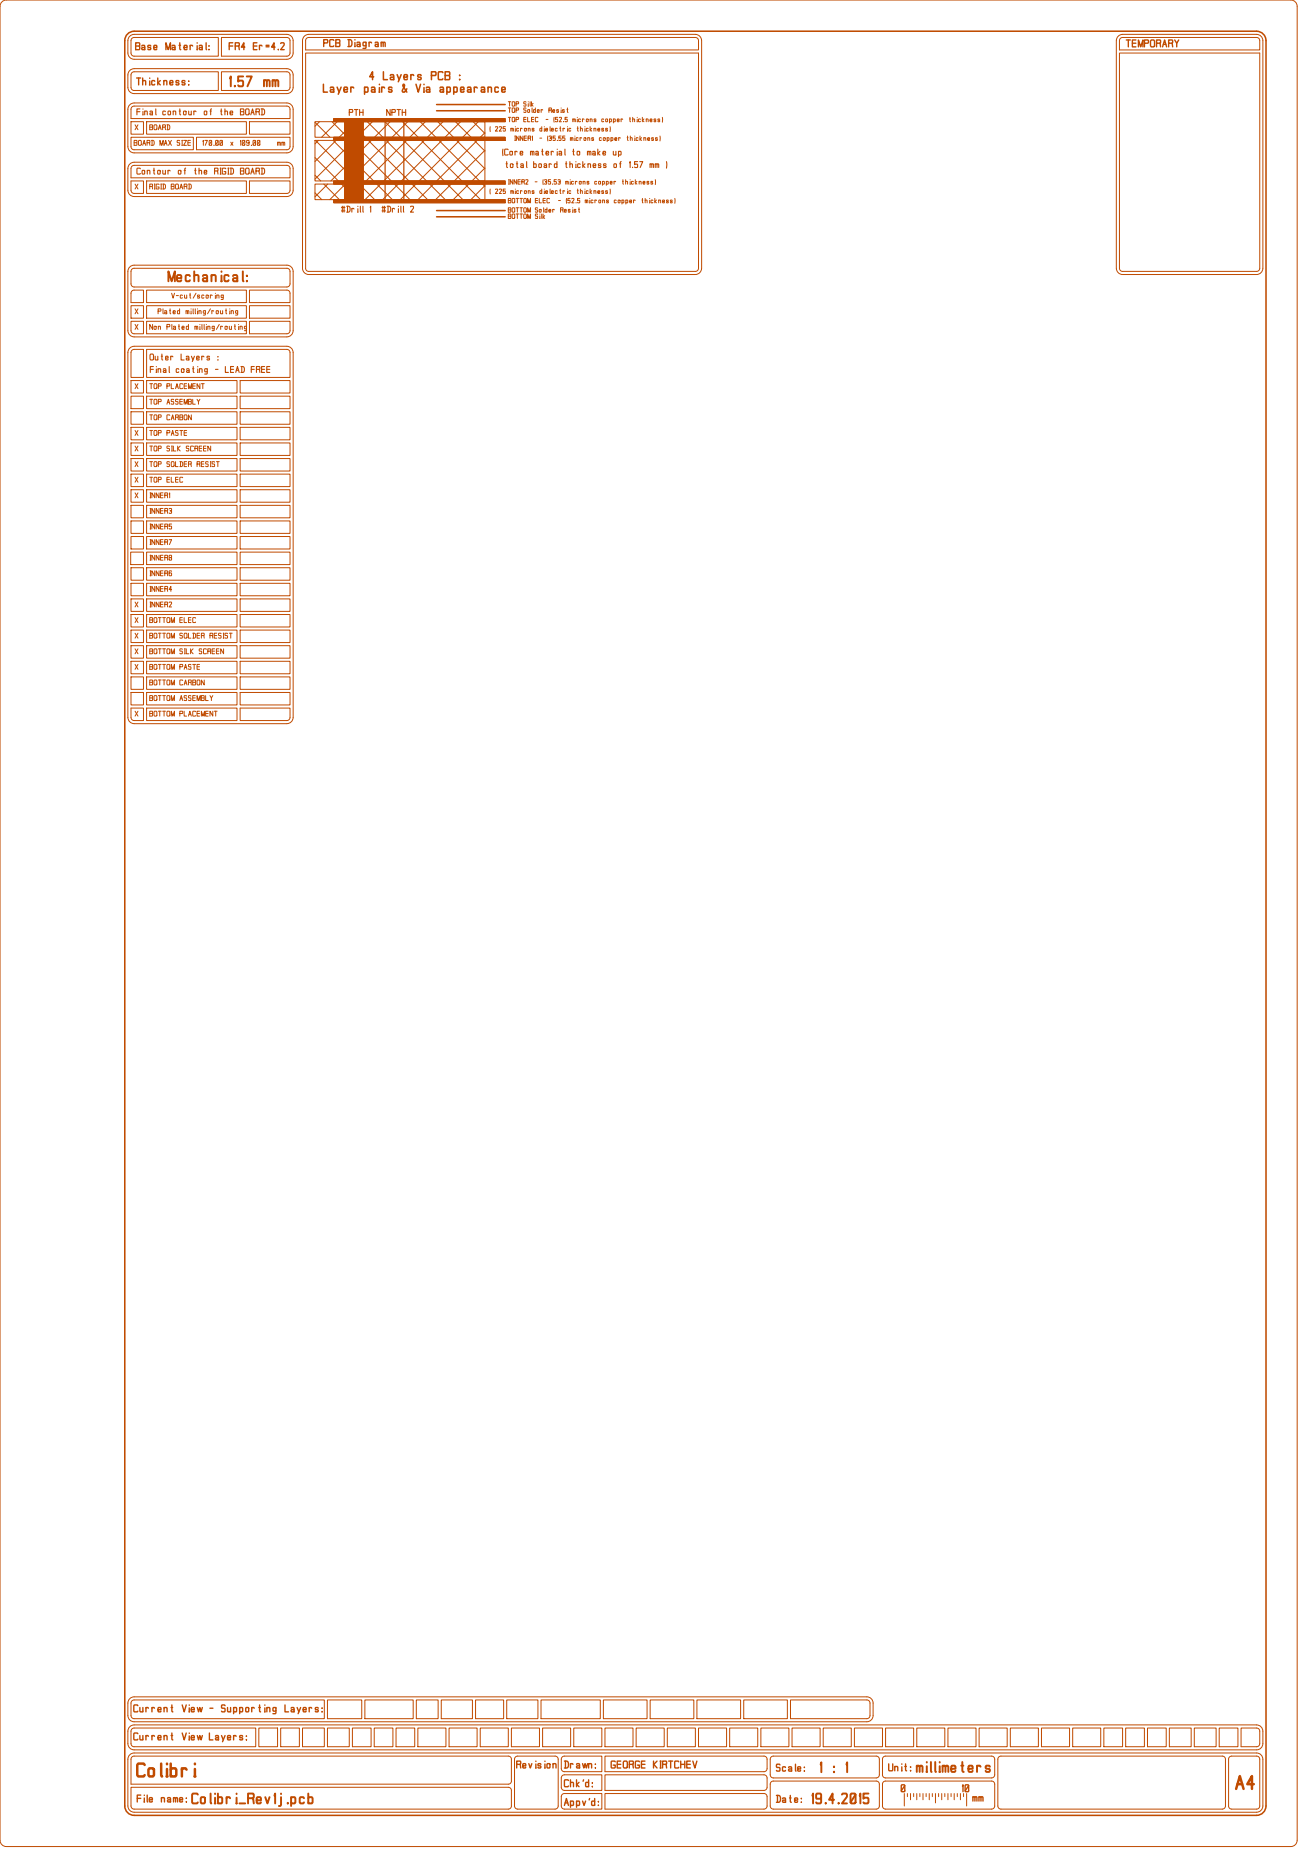
[picture p64: page 1]

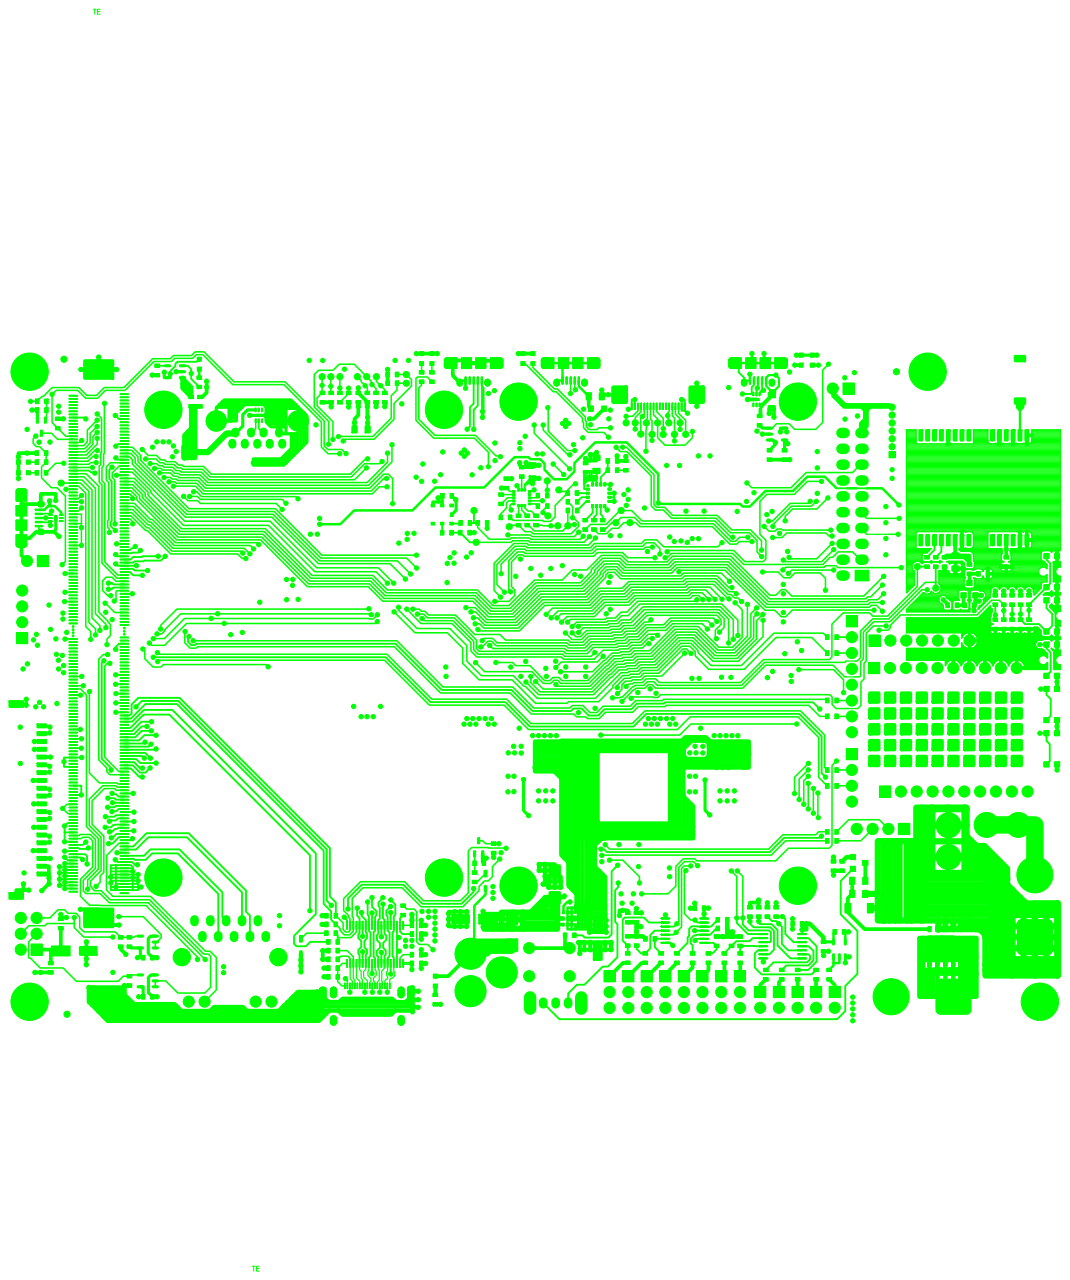
[picture p65: page 3]

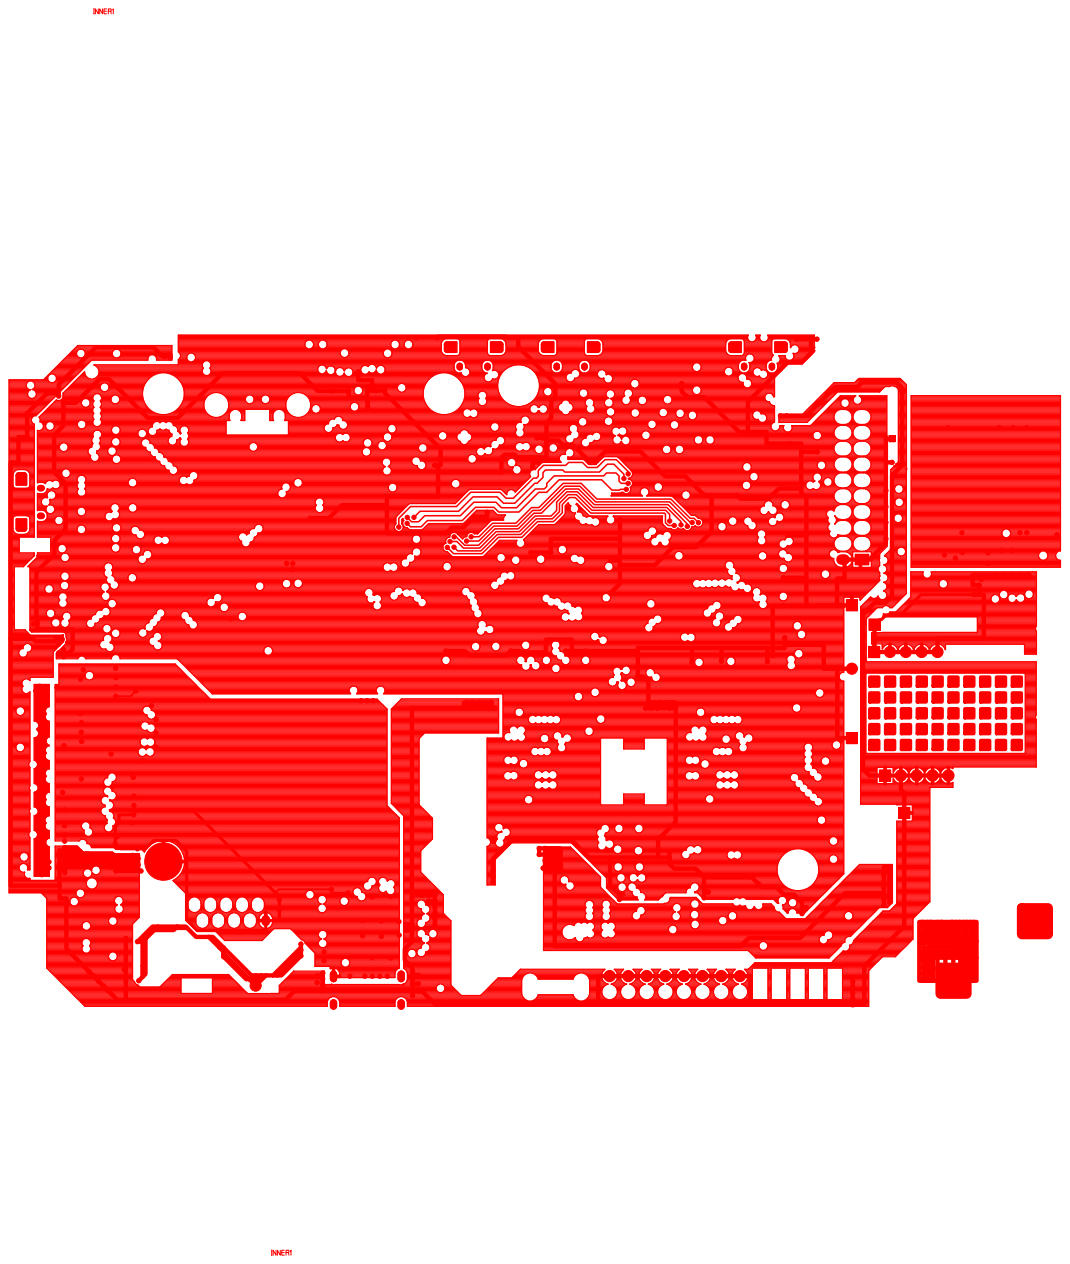
[picture p66: page 4]

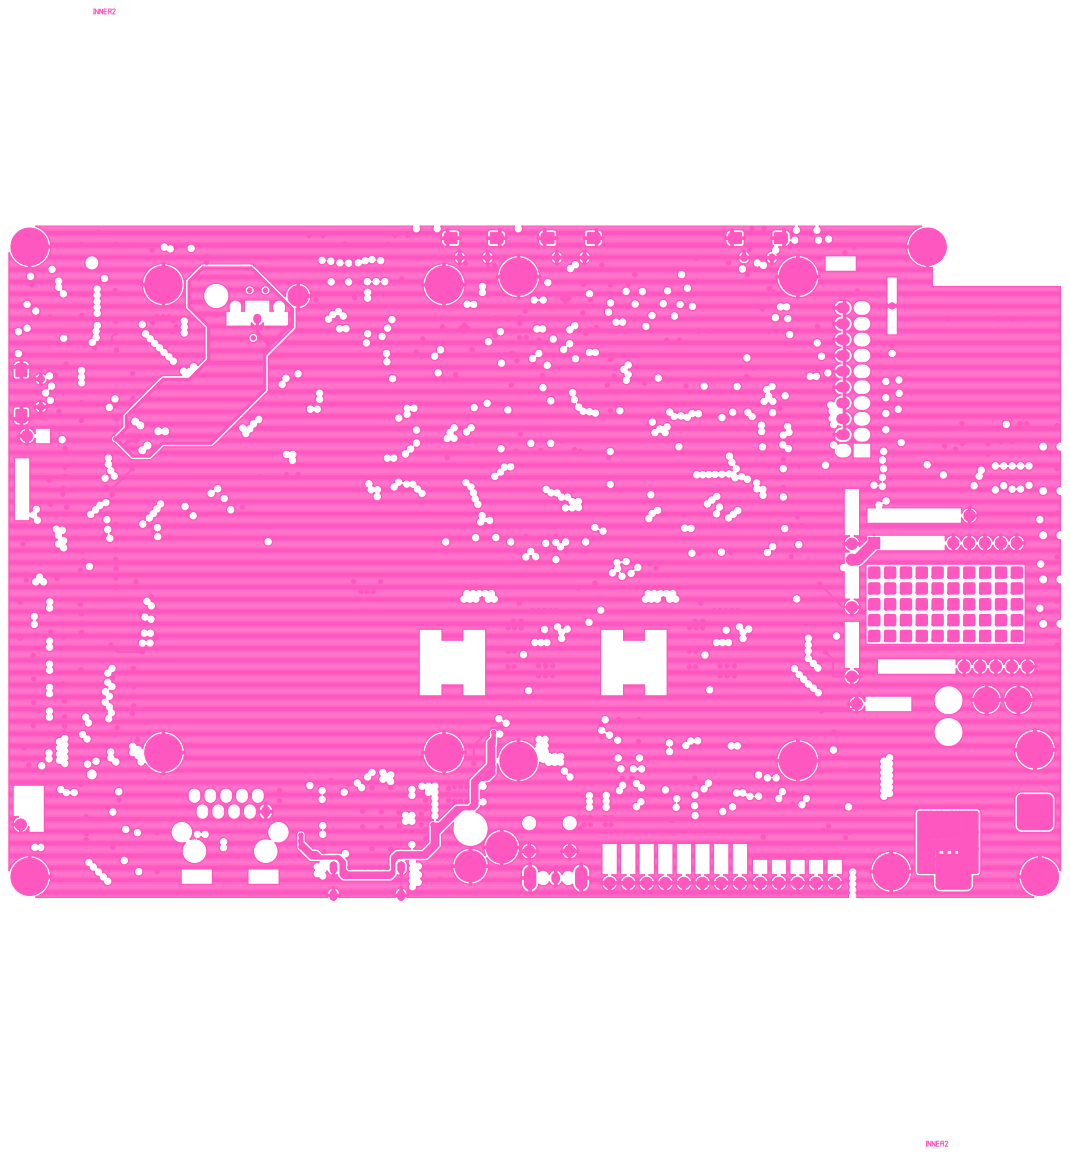
[picture p67: page 5]

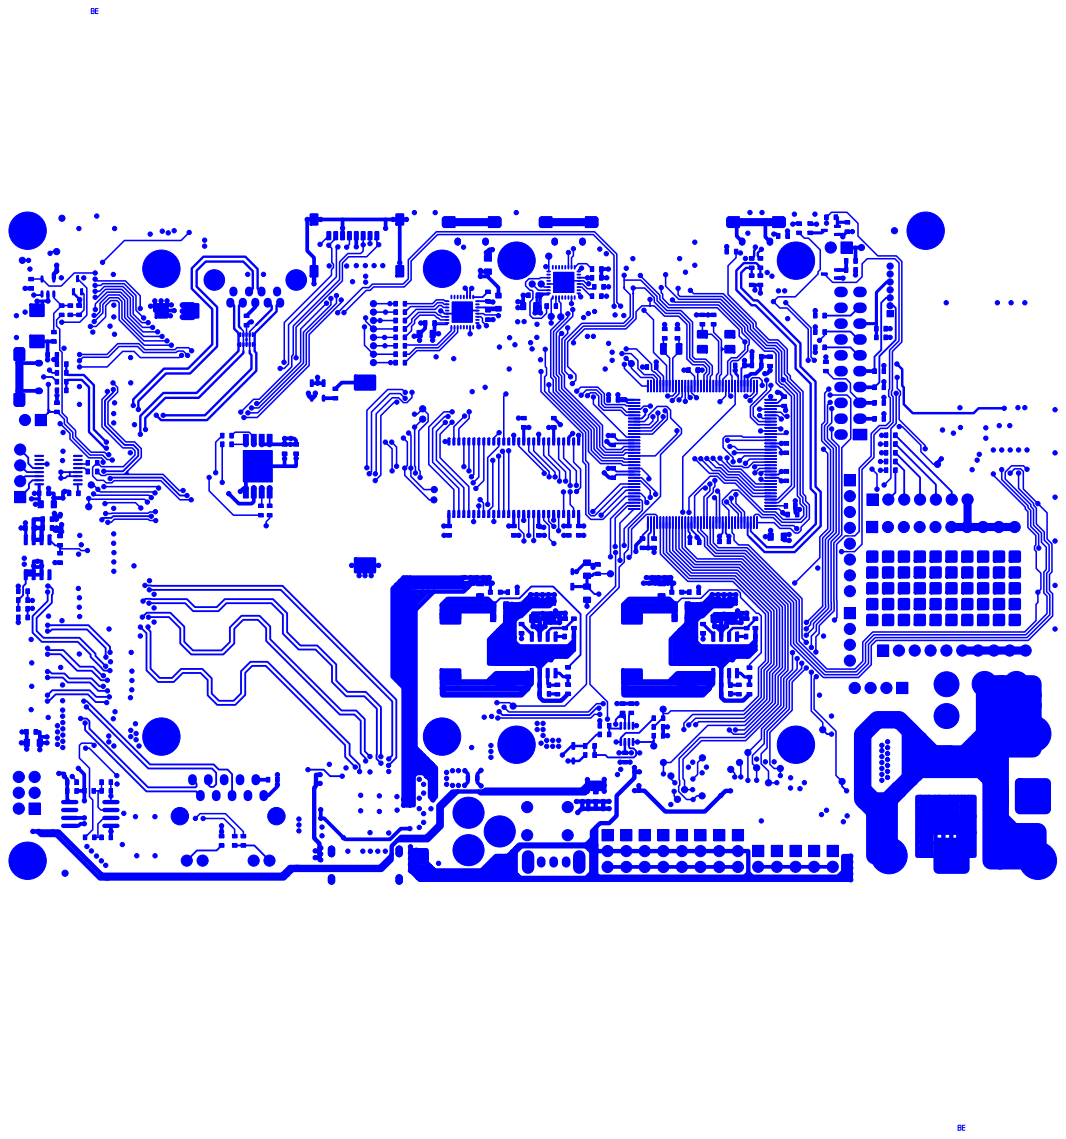
[picture p68: page 6]

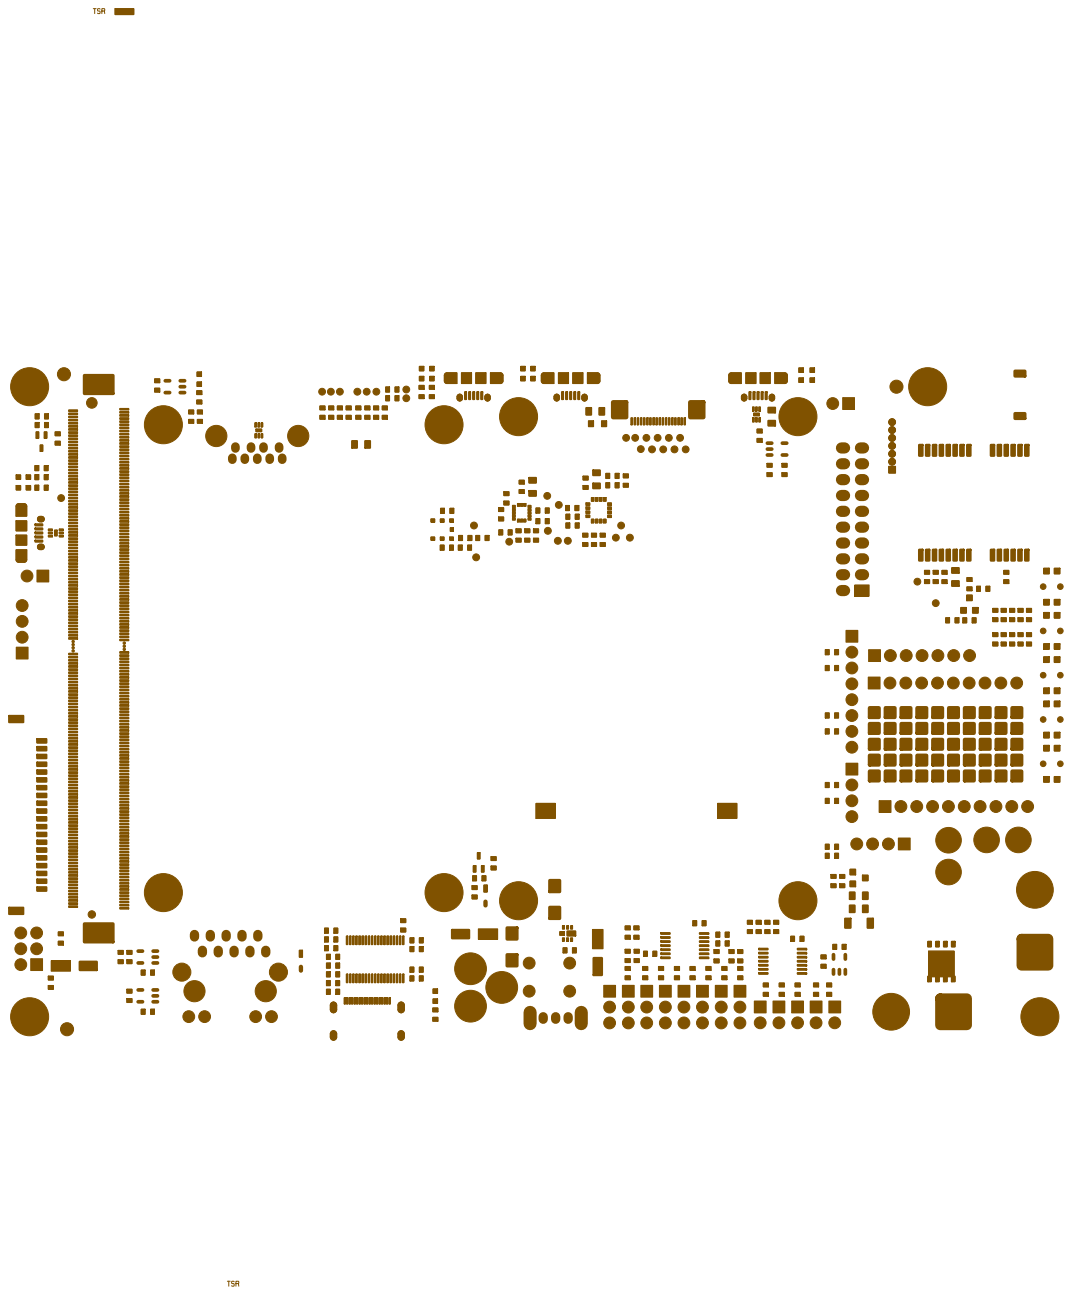
[picture p69: page 7]

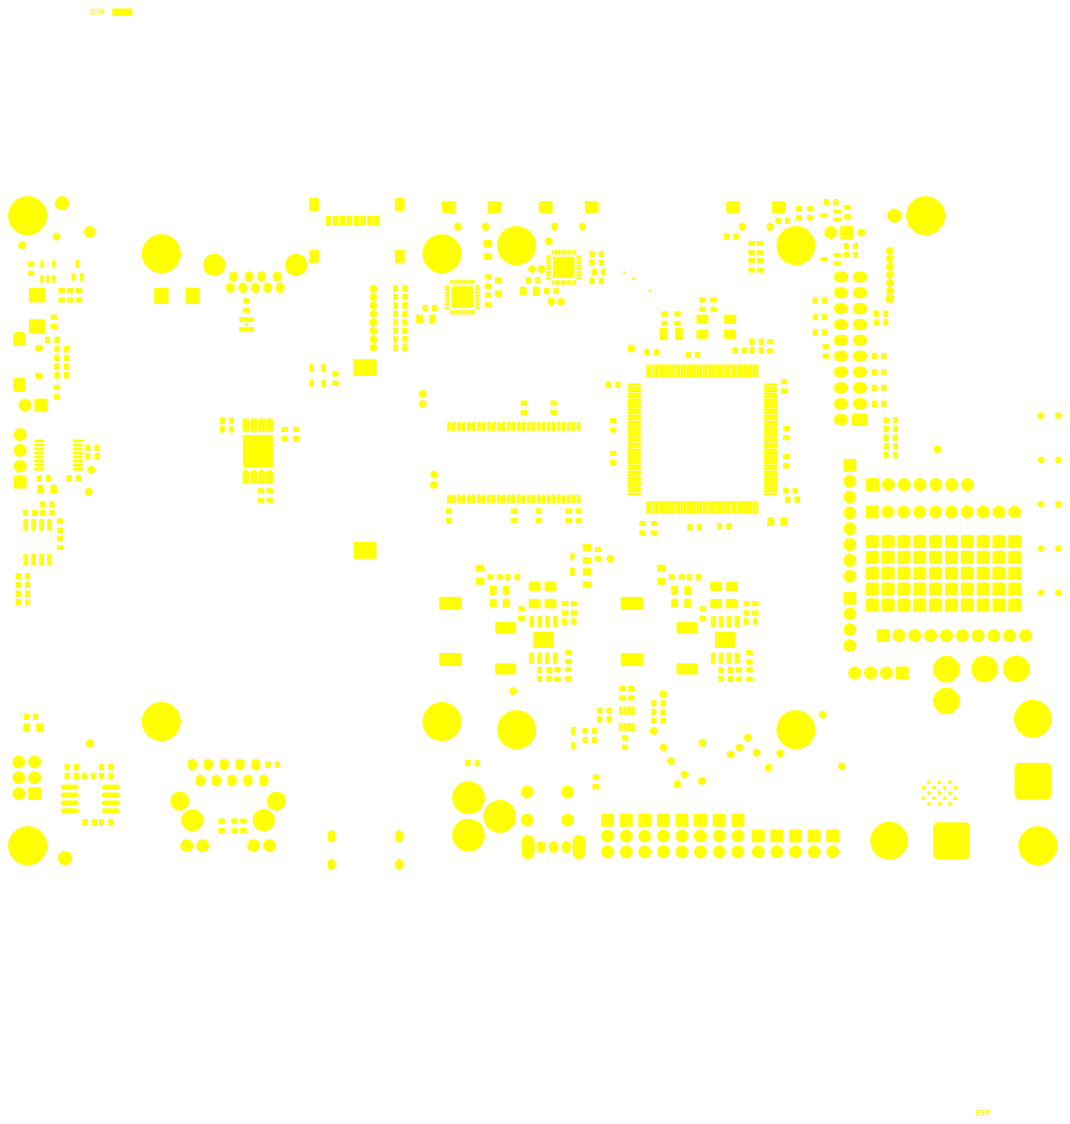
[picture p70: page 8]

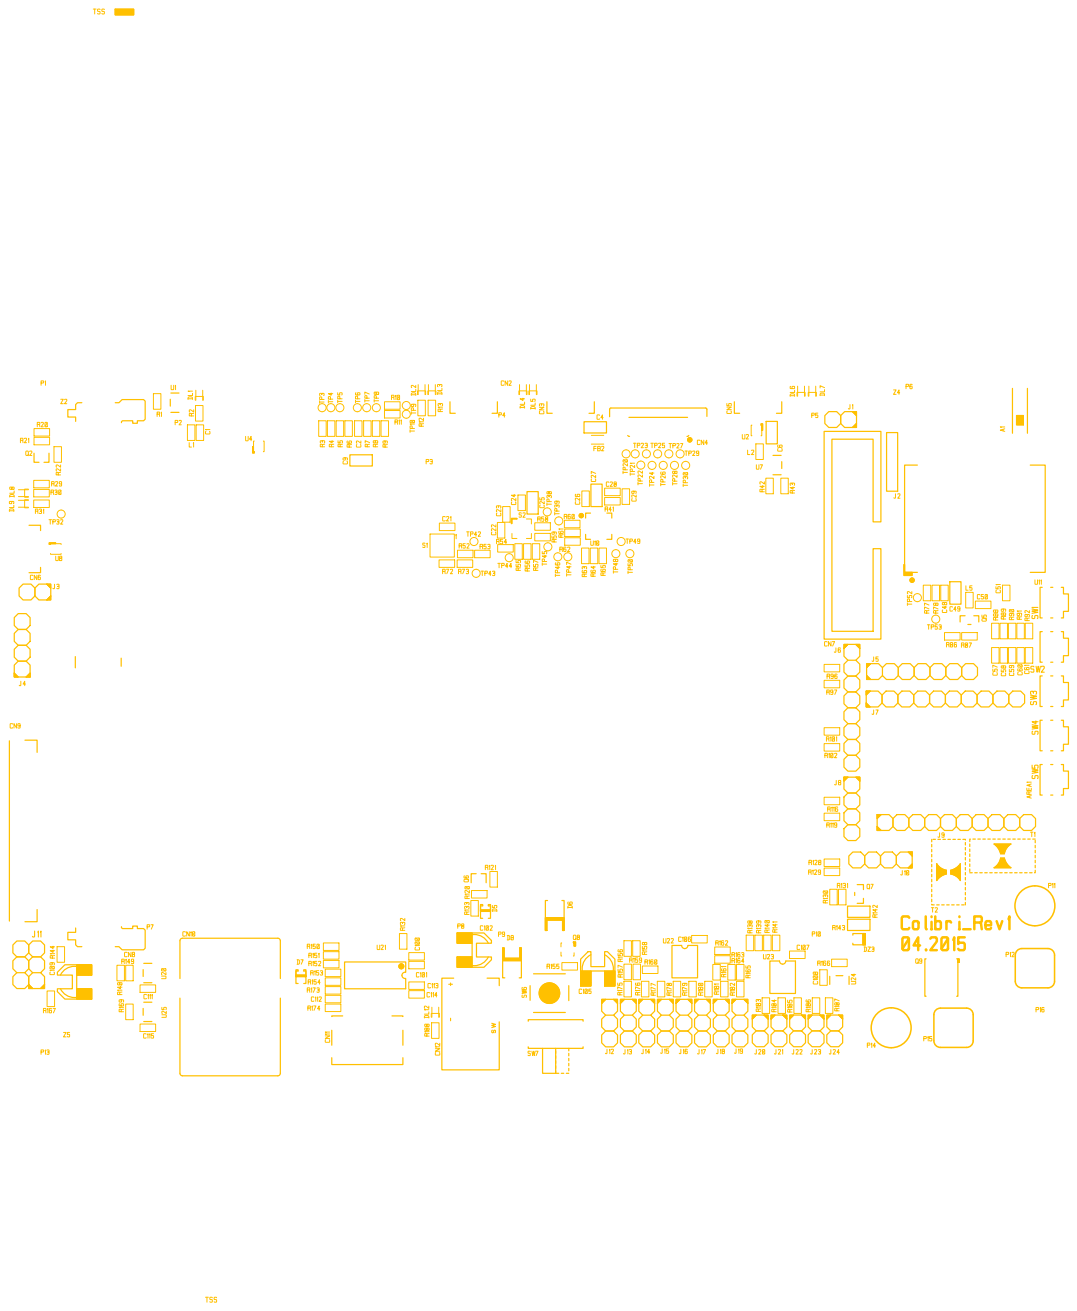
[picture p71: page 9]

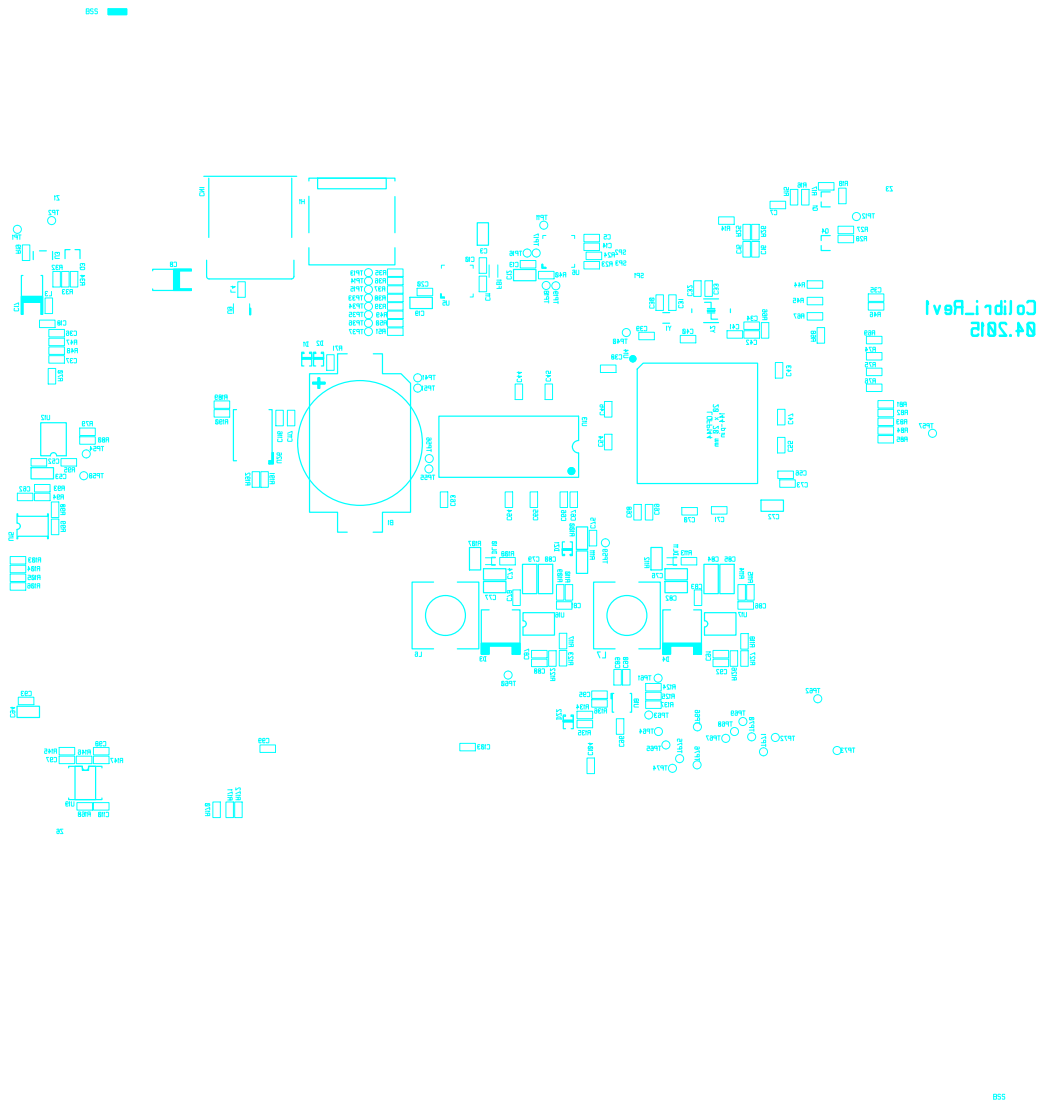
[picture p72: page 10]

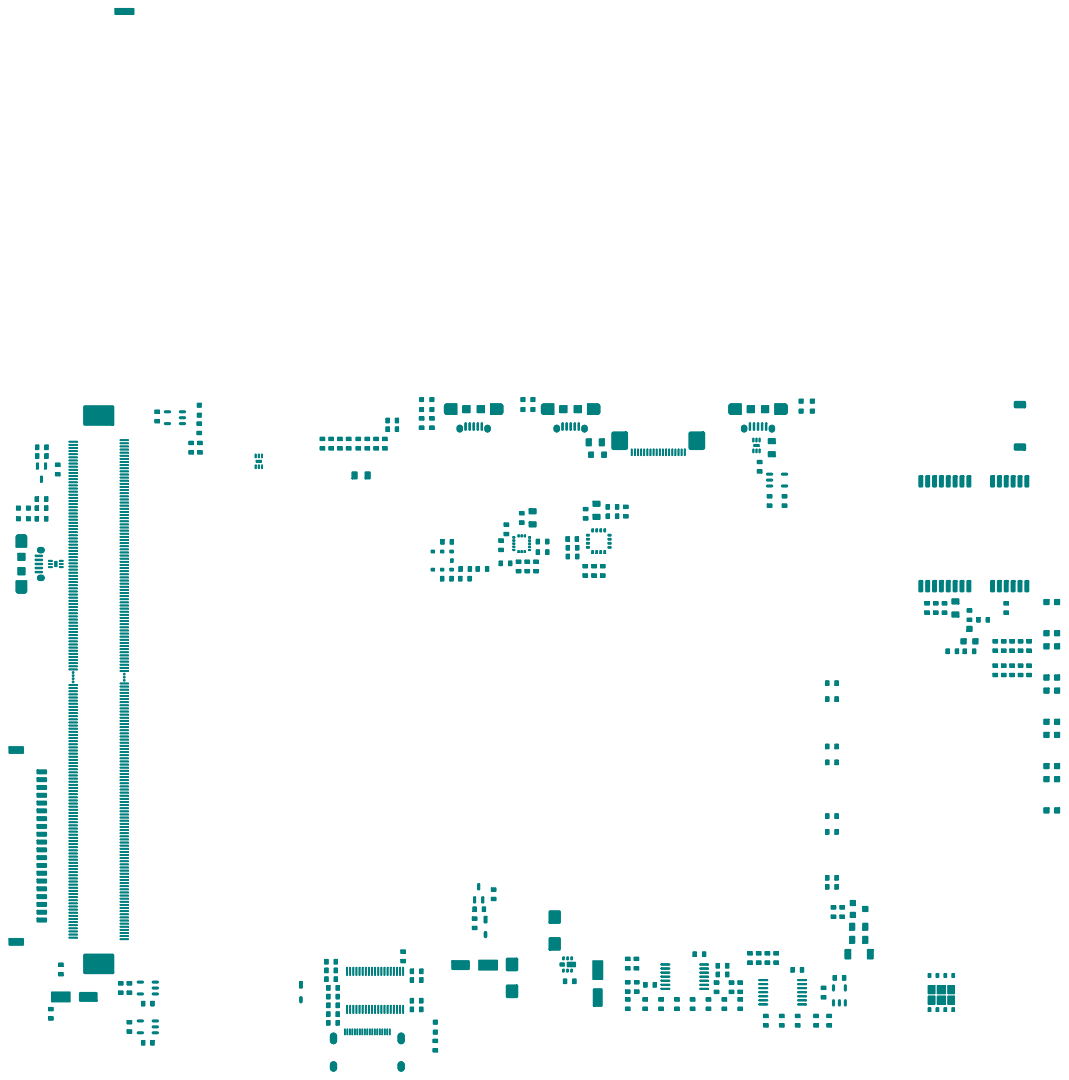
[picture p73: page 11]

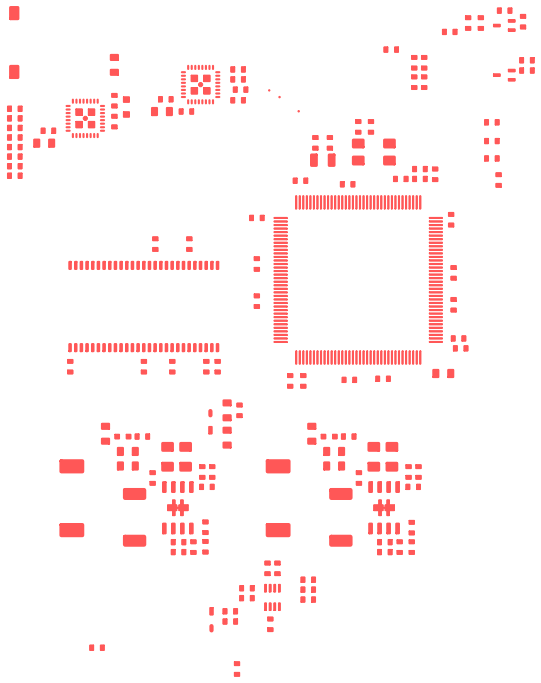
[picture p74: figure]
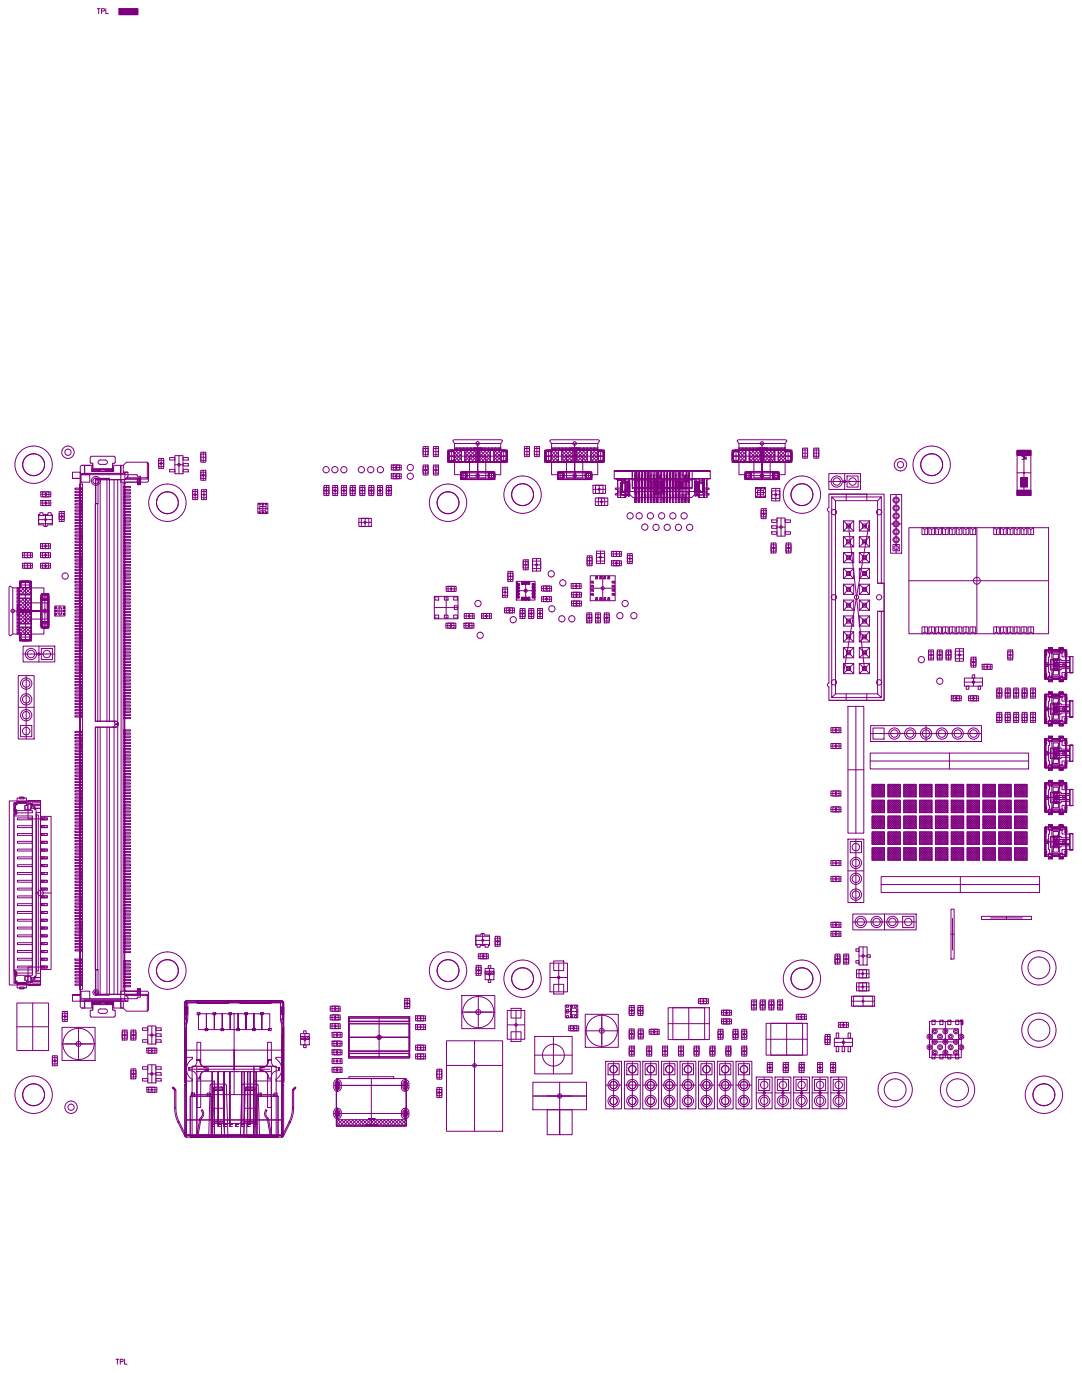
[picture p75: page 13]

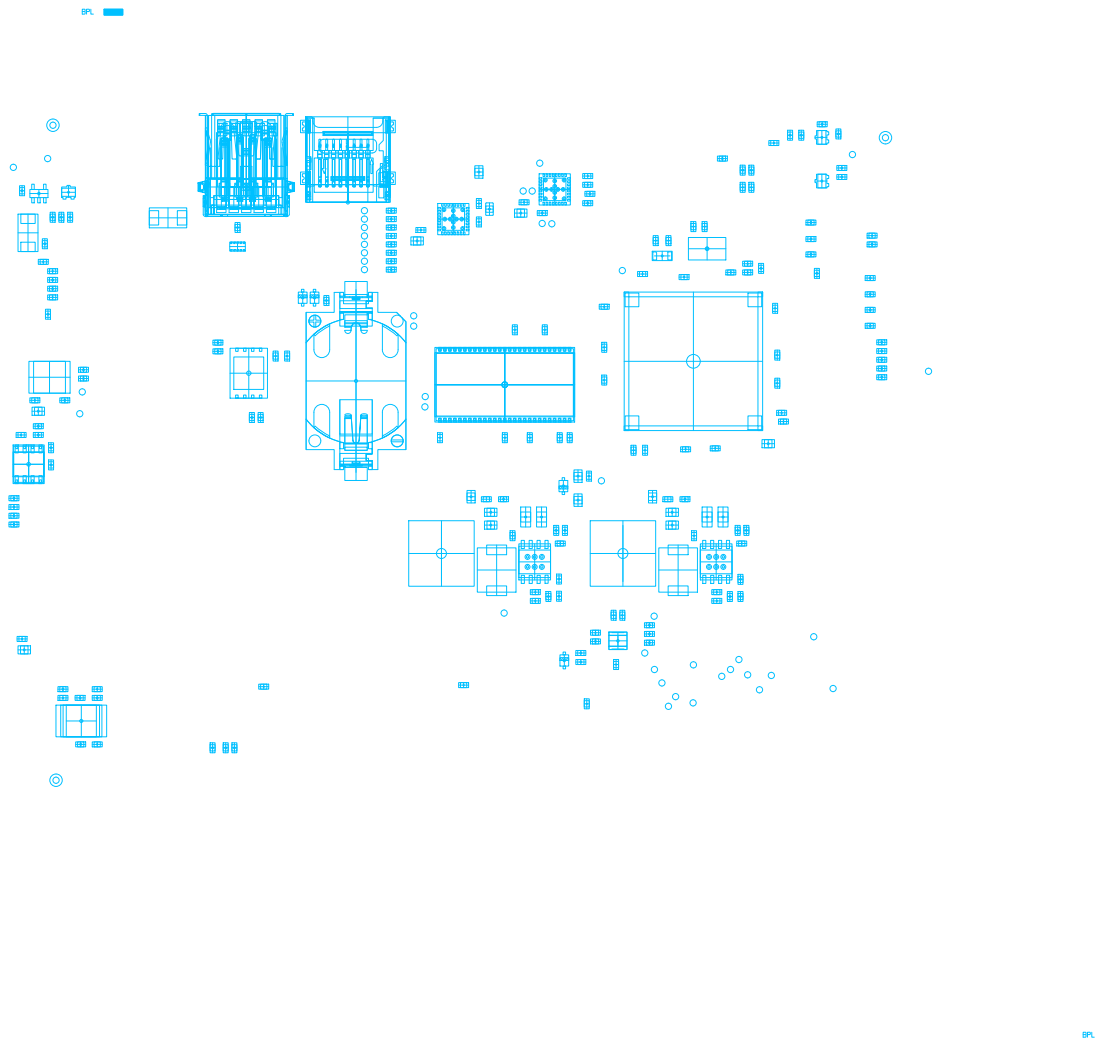
[picture p76: page 14]

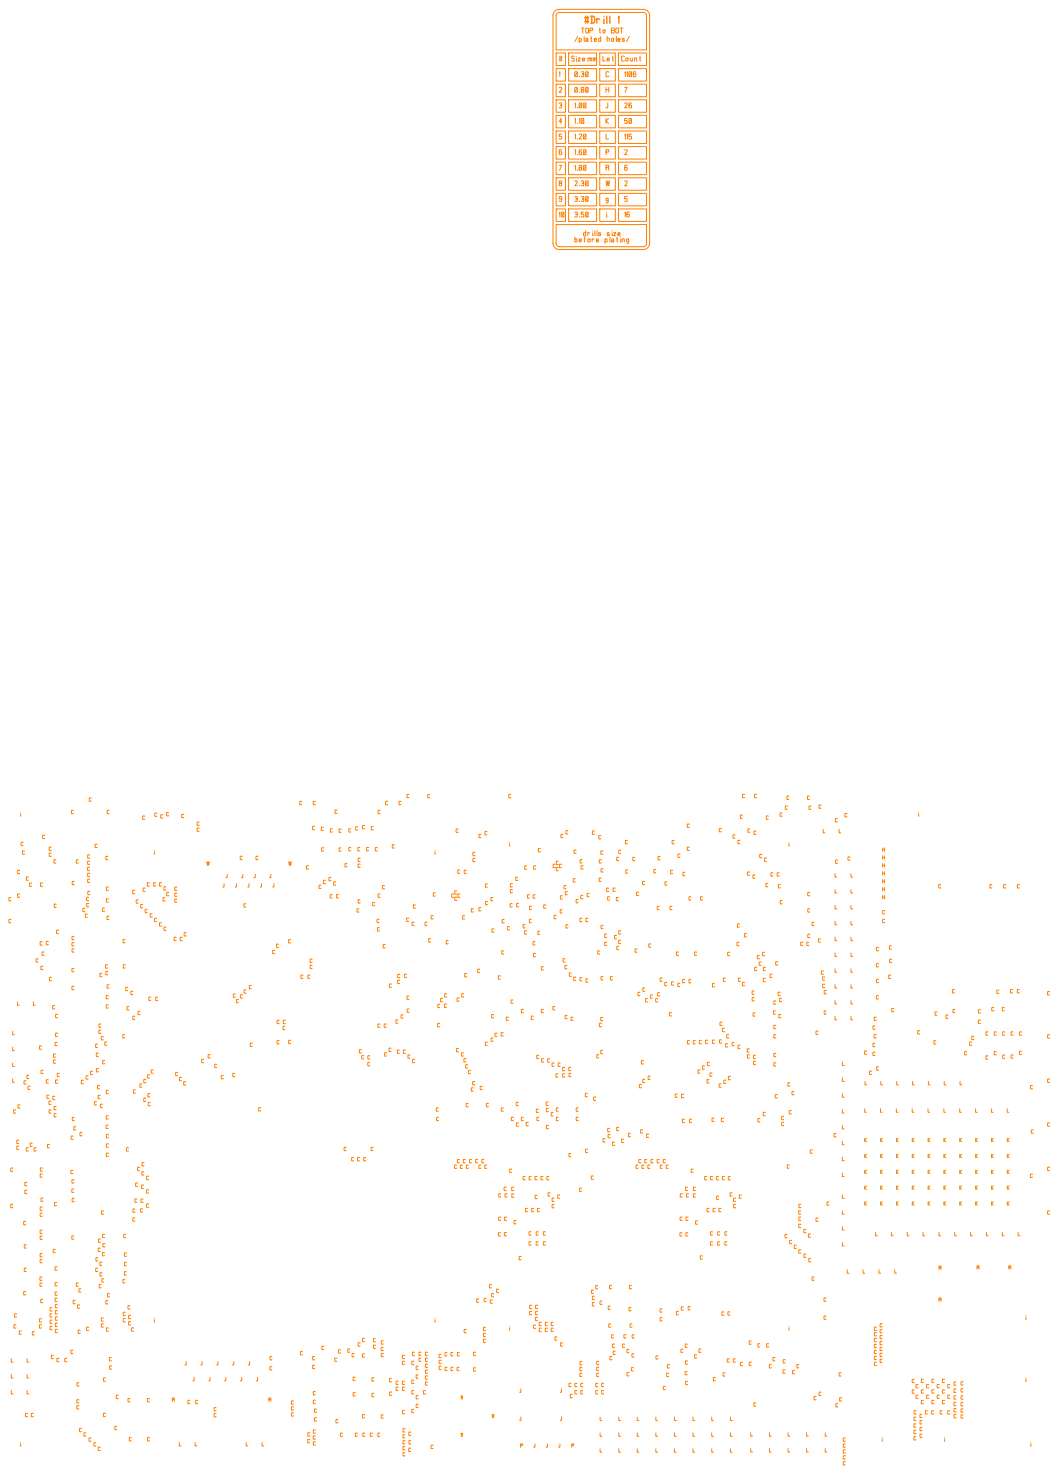
[picture p77: page 15]

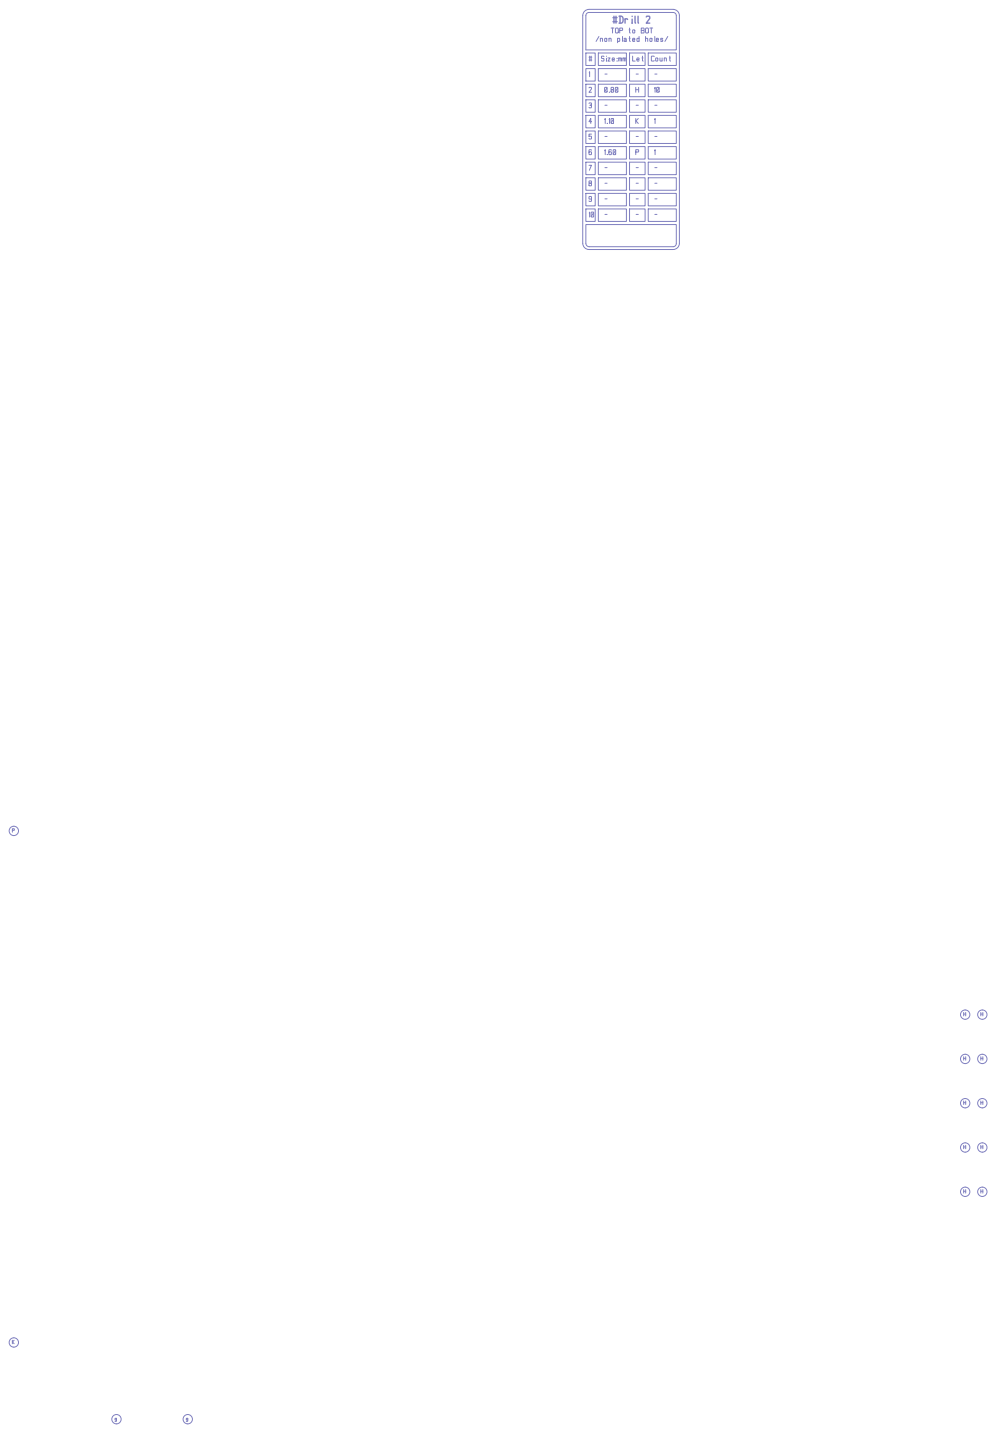
[picture p78: page 16]

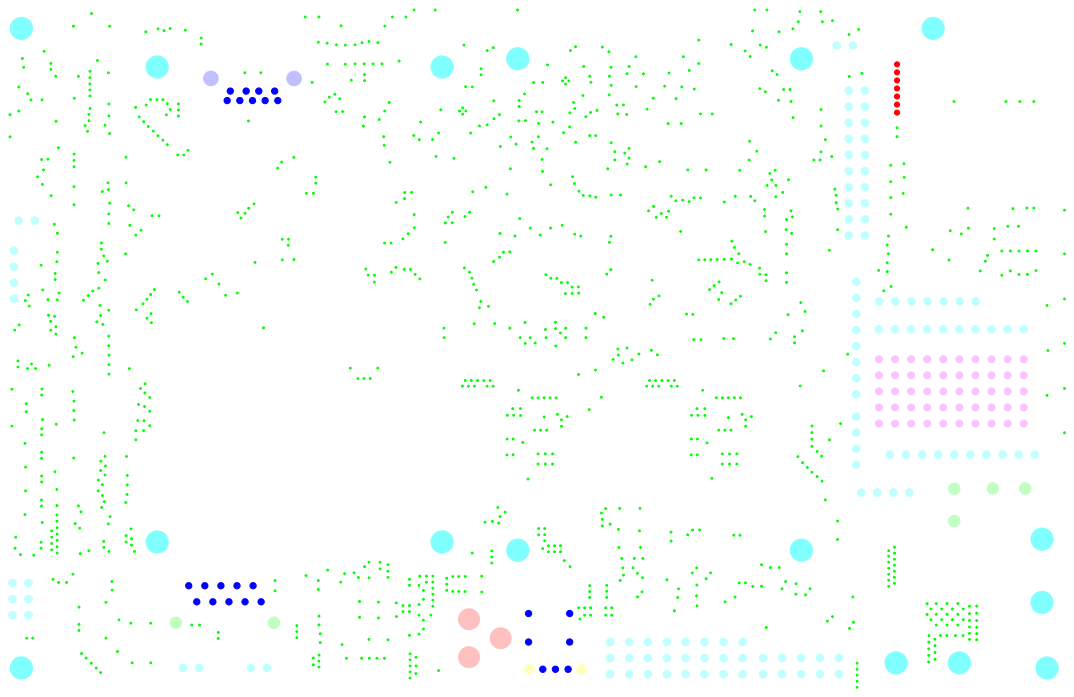
[picture p79: page 19]
