sigmadrone/sigmadrone/hardware/colibri/rev1j/Colibri_Rev1j_PCB View.pdf

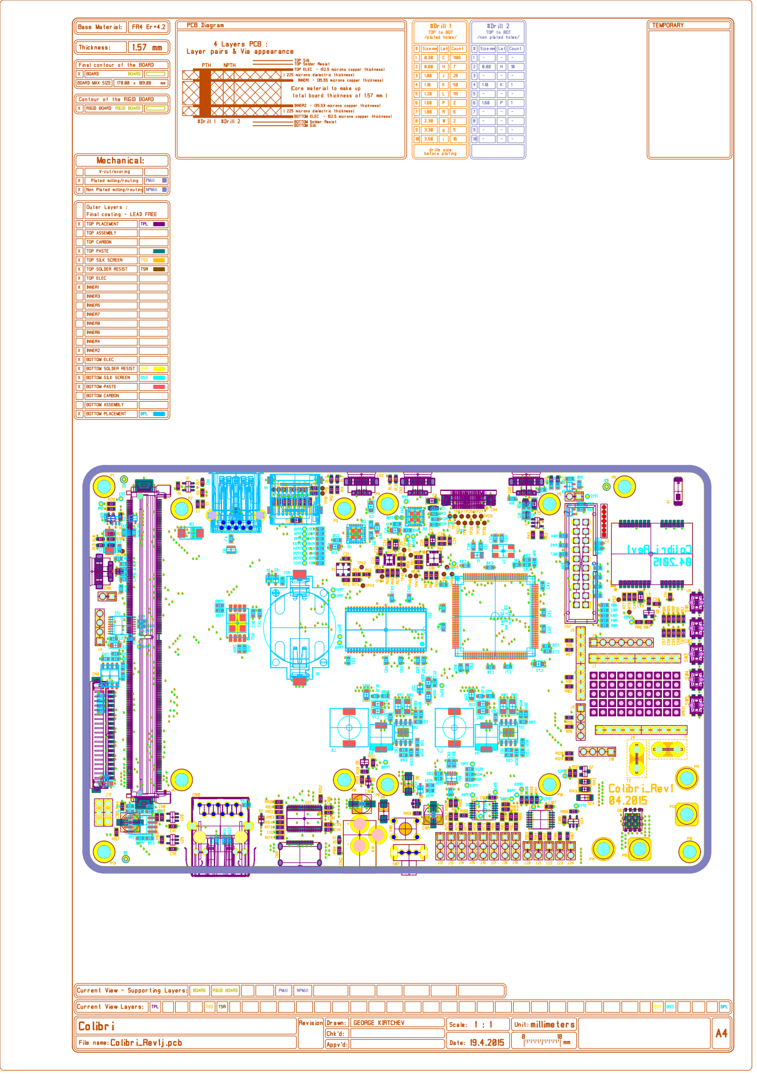
[picture p80: page 1]
