sigmadrone/sigmadrone/hardware/colibri/rev1j/Colibri_Rev1j_Top_SS_P&P-no pads.pdf

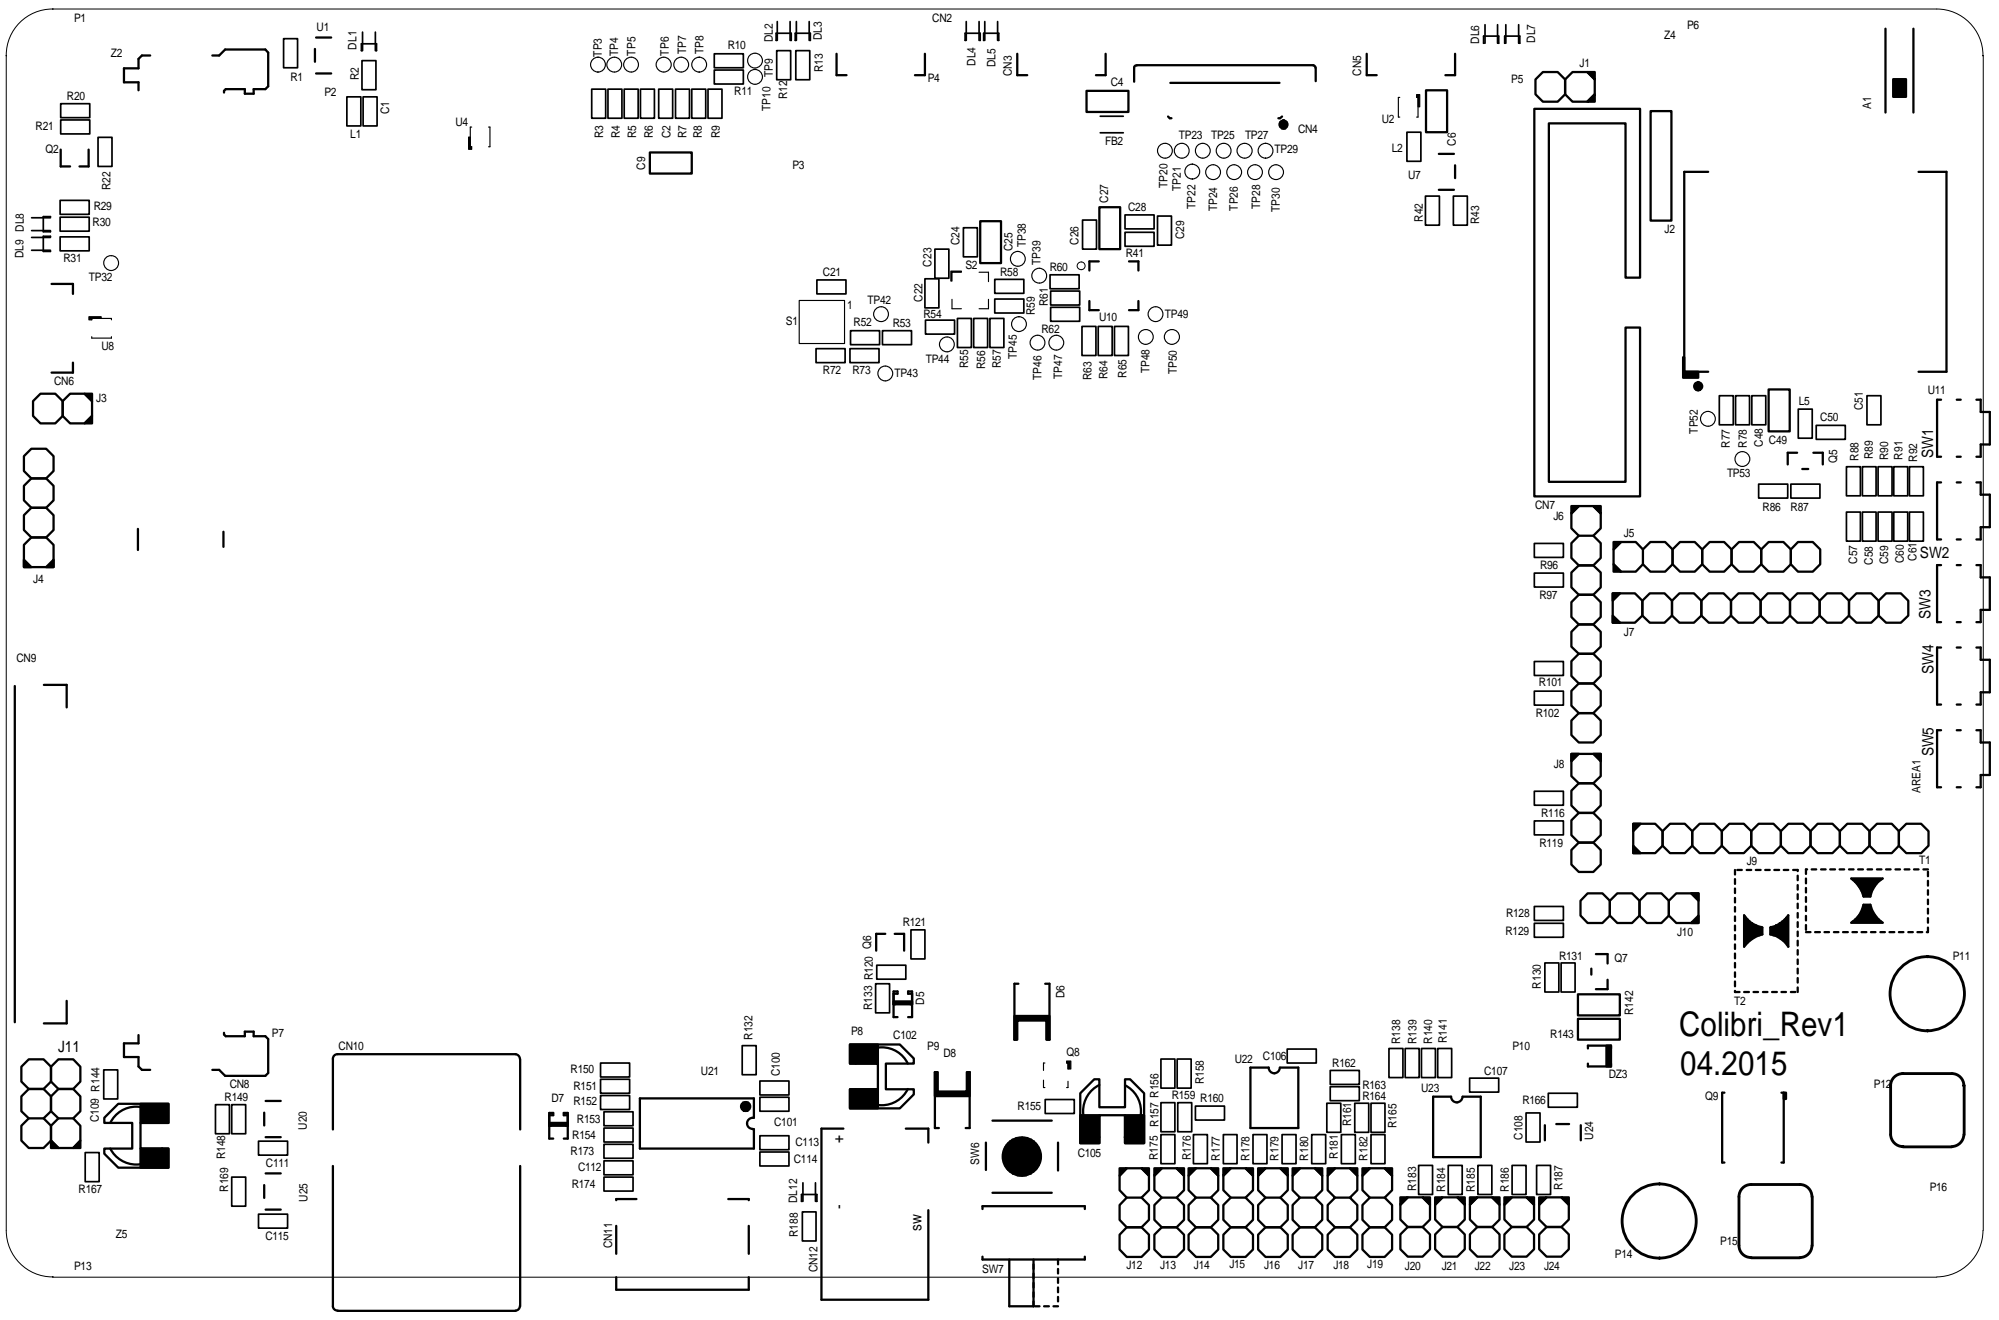
[picture p81: page 1]
