sigmadrone/sigmadrone/hardware/colibri/rev1j/Colibri_Rev1j_Top_SS_P&P.pdf

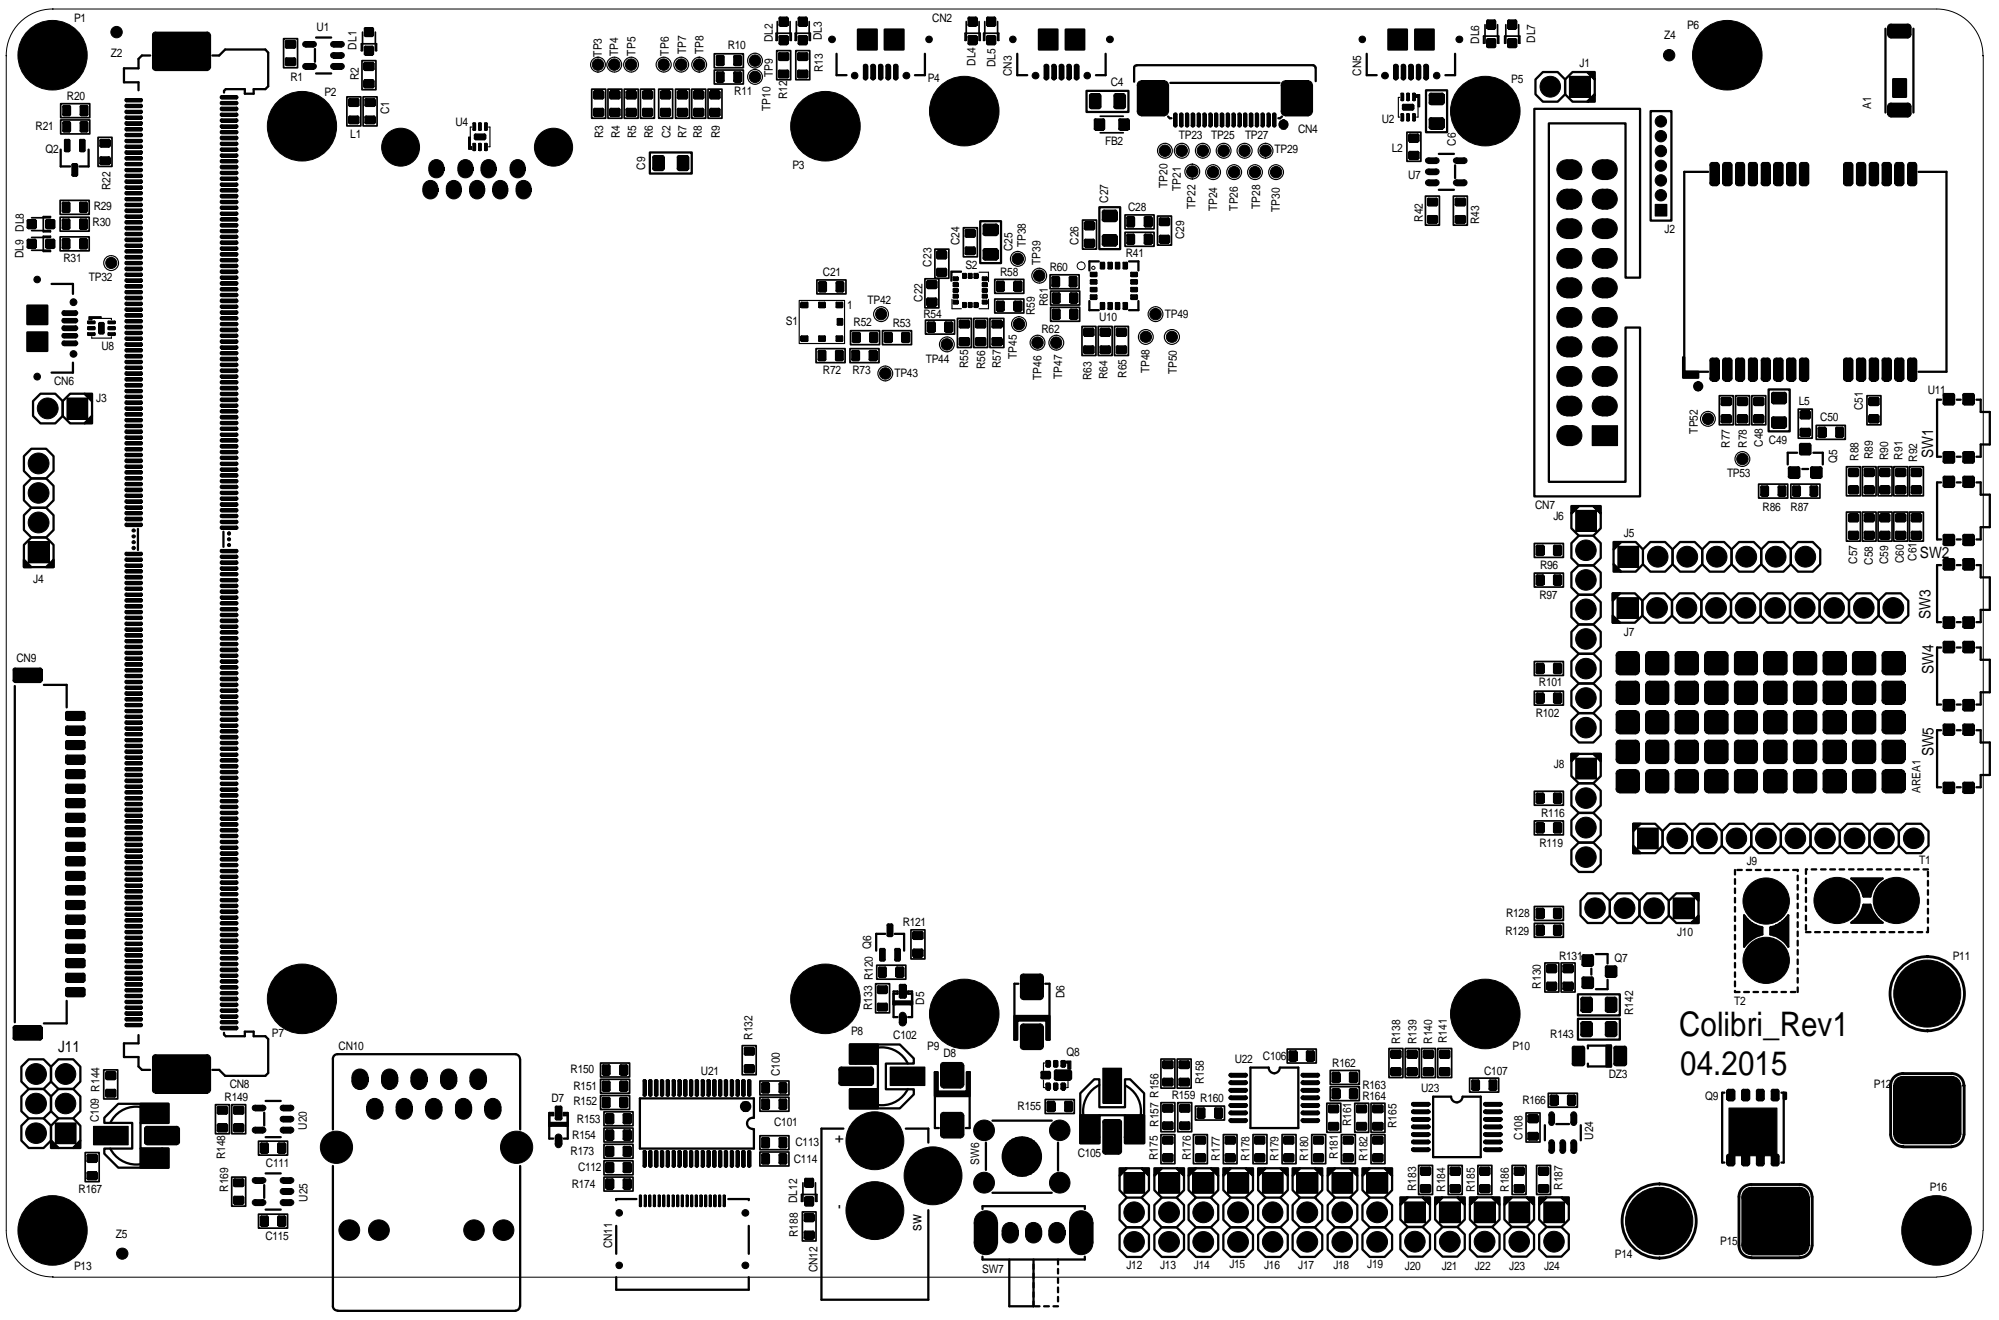
[picture p82: page 1]
