sigmadrone/sigmadrone/hardware/esc-power/esc-power.kicad_pcb

## KiCad design hardware/esc-power/esc-power.kicad_pcb (2016-10-29)

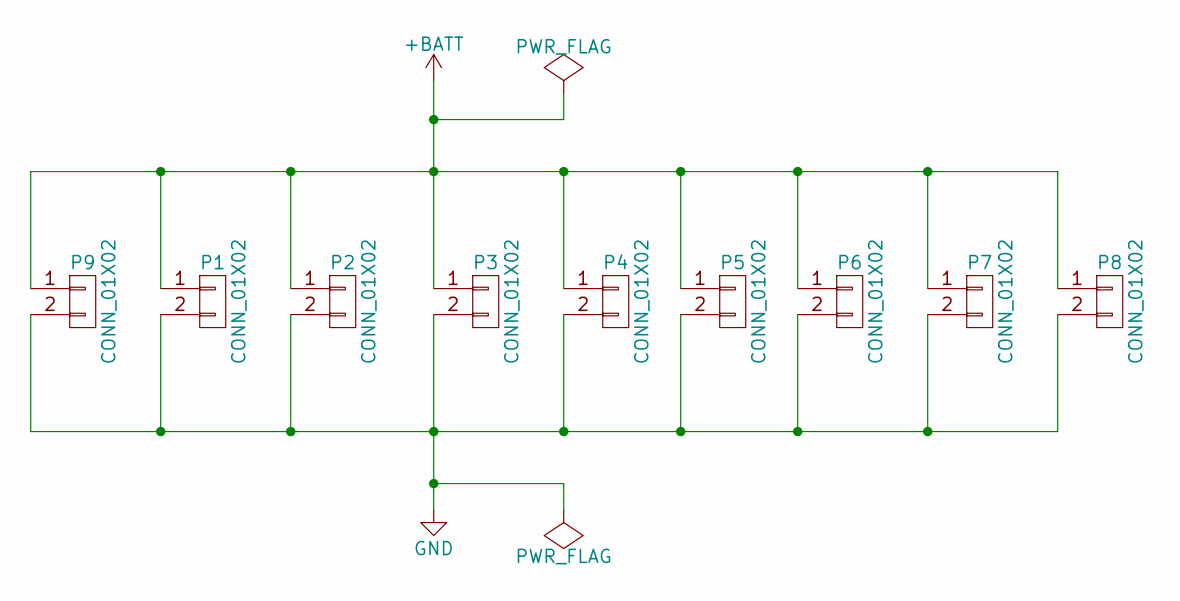
[picture p83: schematic esc-power.sch]

Parts:
P1, P2, P3, P4, P5, P6, P7, P8: CONN_01X02; WURTH_691131710002
P9: CONN_01X02; WURTH_691219610002

Connections:
+BATT: P1.1, P2.1, P3.1, P4.1, P5.1, P6.1, P7.1, P8.1, P9.1
GND: P1.2, P2.2, P3.2, P4.2, P5.2, P6.2, P7.2, P8.2, P9.2

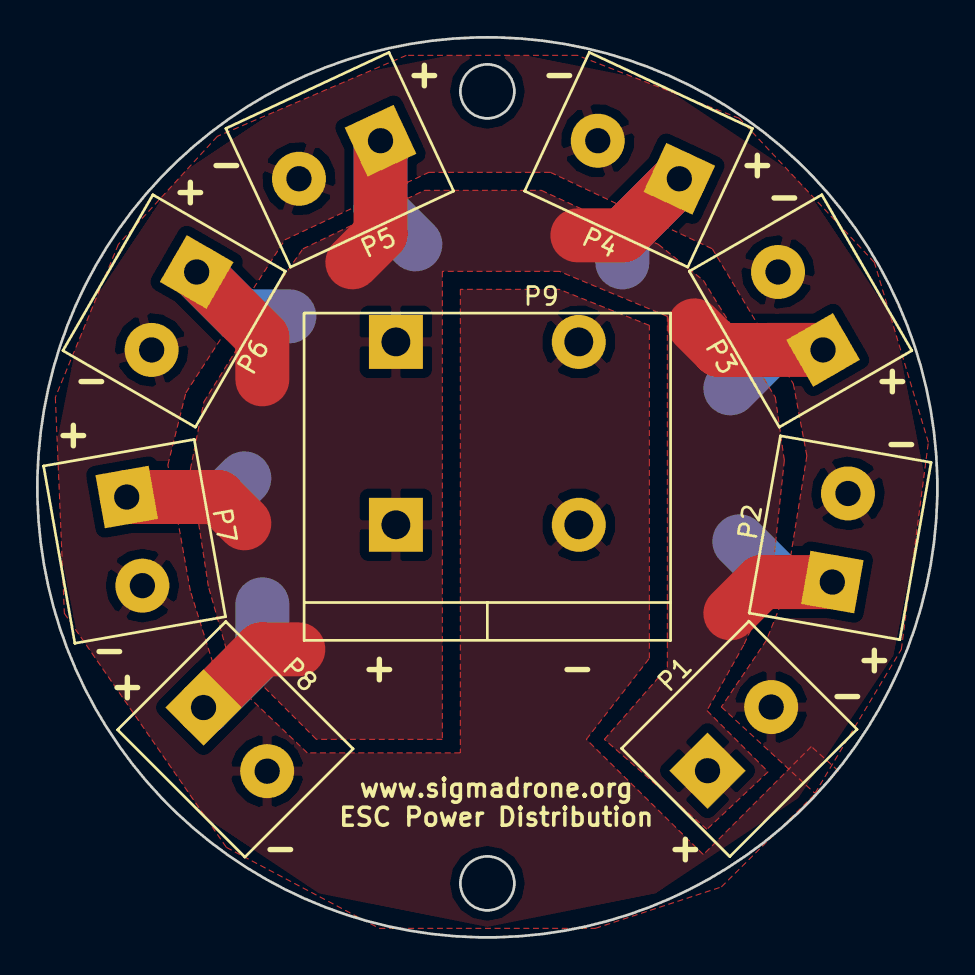
[picture p84: board esc-power.kicad_pcb from above]

Board: 2 copper layers, 50.0 x 50.0 mm, 9 parts (0 on the bottom side), 2 nets.
