sigmadrone/sigmadrone/hardware/colibri-v2/colibri-wnd.kicad_pcb

## KiCad design hardware/colibri-v2/colibri-wnd.kicad_pcb (2016-06-07)

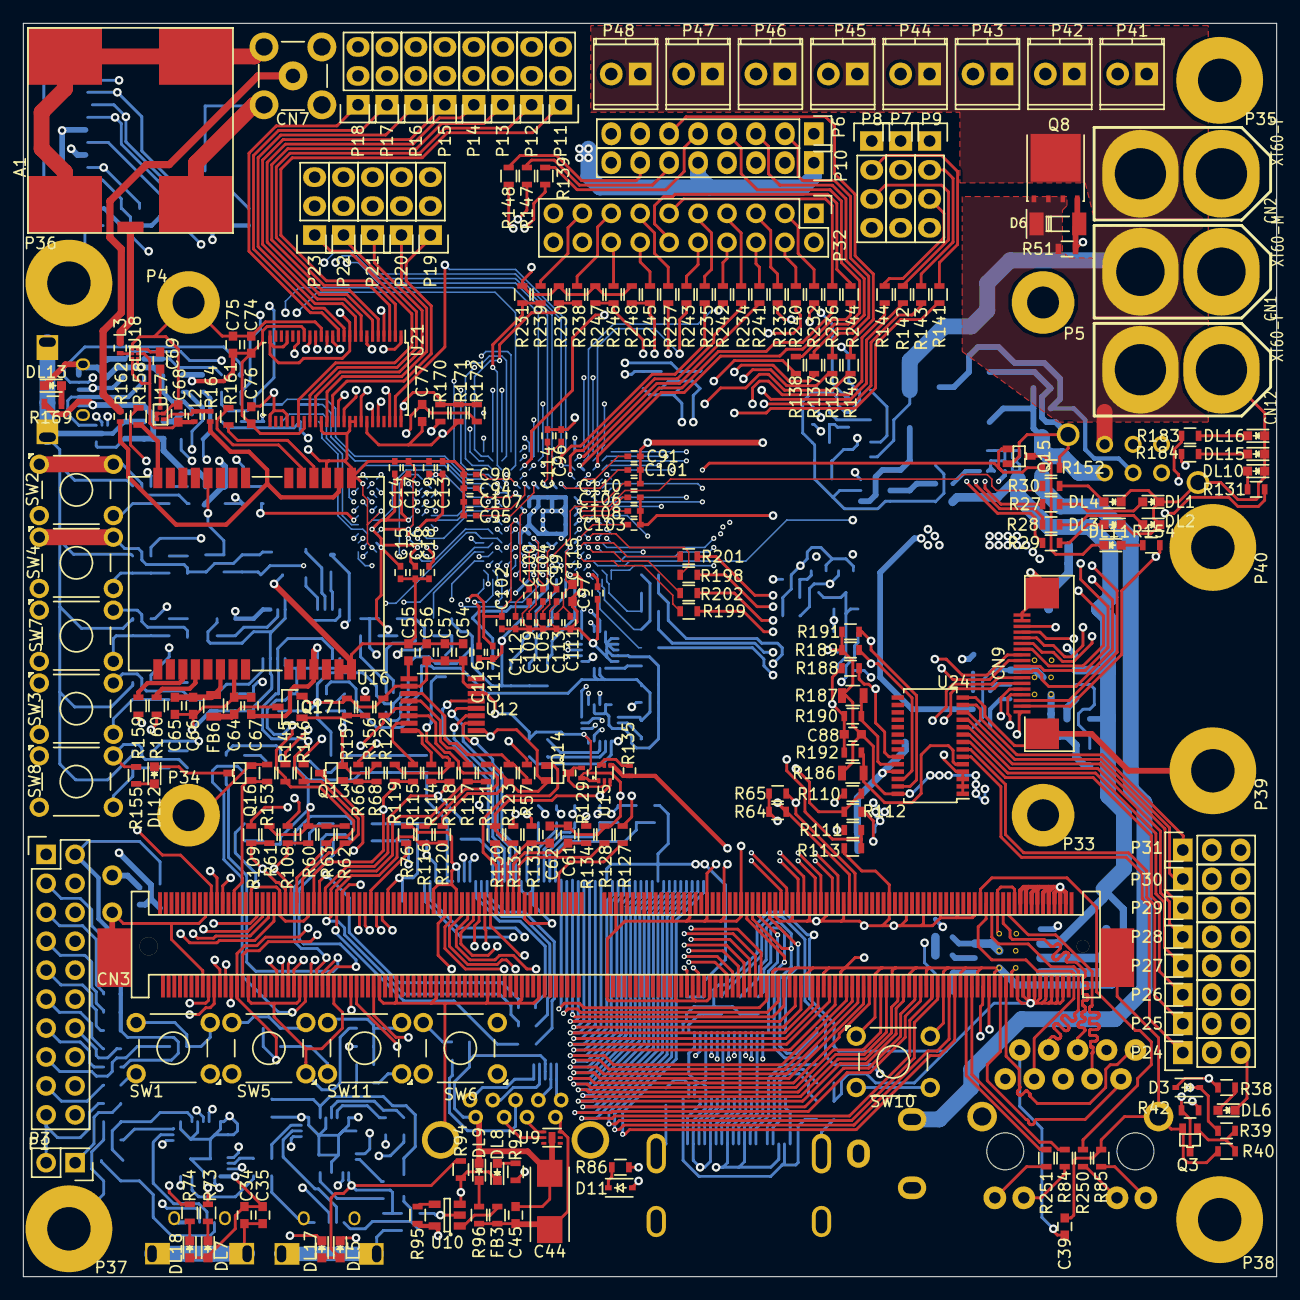
[picture p85: board colibri-wnd.kicad_pcb from above]

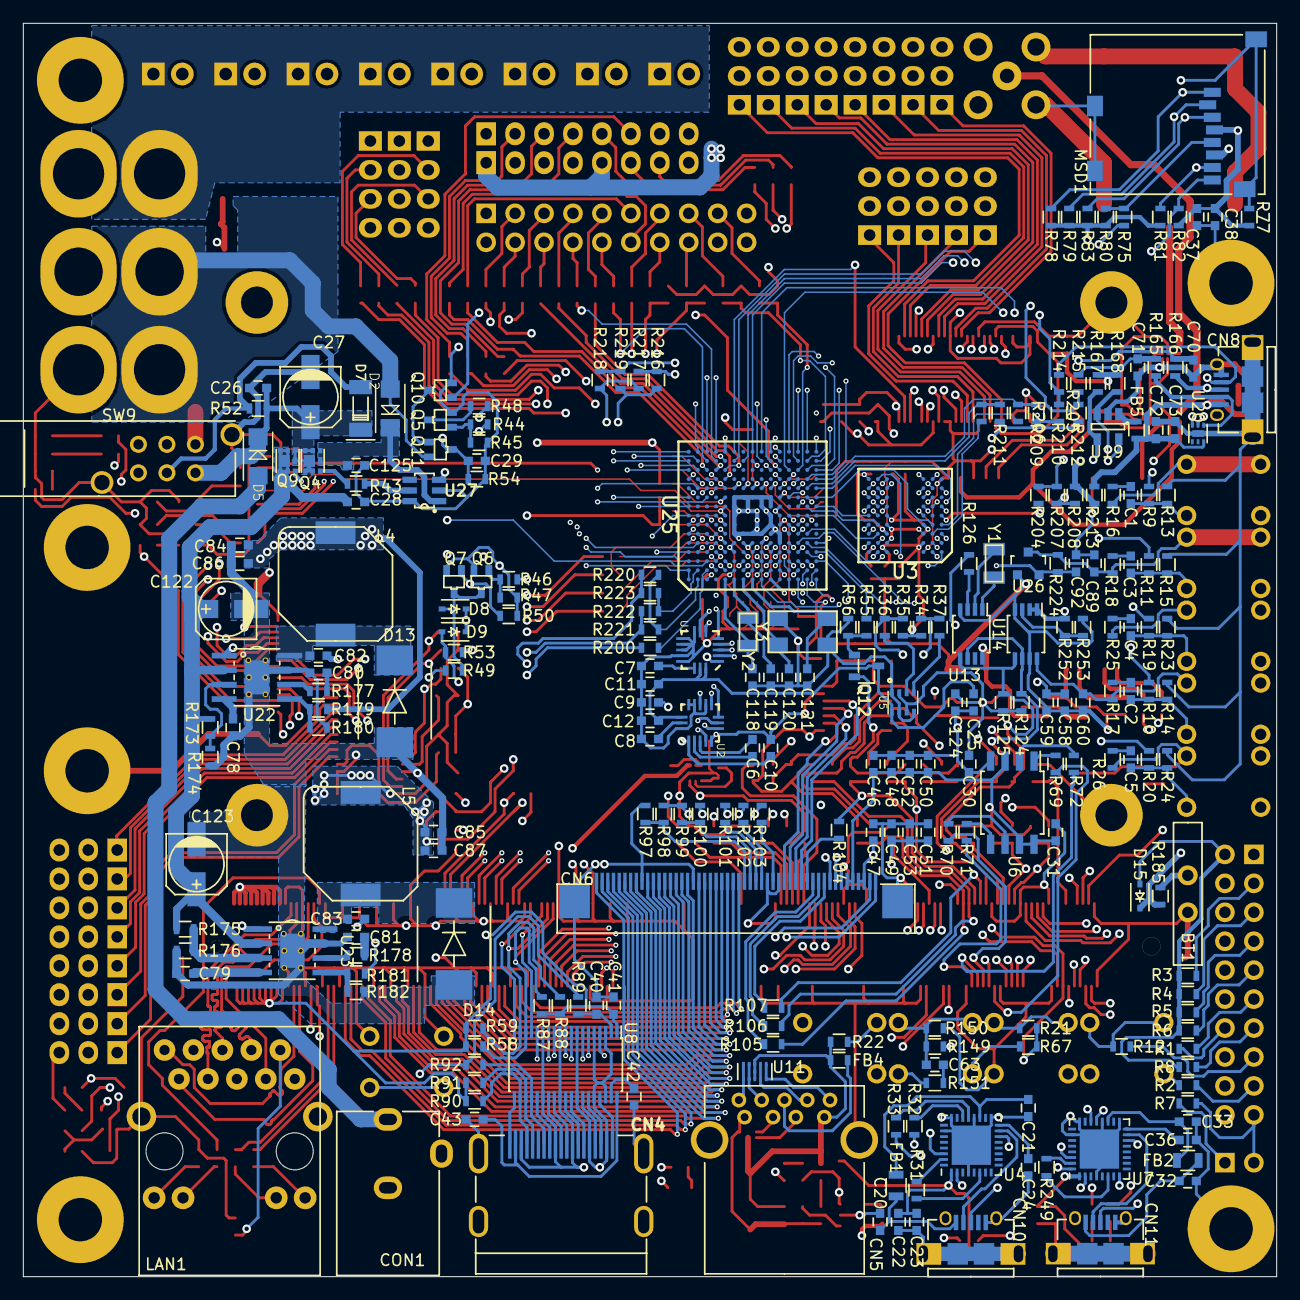
[picture p86: board colibri-wnd.kicad_pcb from below]

Board: 6 copper layers, 110.0 x 110.0 mm, 521 parts (247 on the bottom side), 486 nets.

Parts:
A1: ANT1818B00AT1575S
BT1: VL1220-1VC; VL_1220
C1, C2, C3, C4, C5, C25, C63, C92, C124: 100nF/50V; C_0603
C6: 220nF/50V/X7R; C_0603
C7: 10nF/50V/X7R; C_0603
C8: 4u7/6V3/X5R; C_0603
C9, C10, C21, C23, C24, C26, C28, C29, C31, C33, C35, C36, C37, C39, C40, C41, C42, C43, C45, C48, C49, C52, C53, C54, C55, C56, C59, C60, C66, C67, C68, C73, C74, C75, C76, C77, C78, C79, C82, C83, C89, C125: 100nF/50V/X7R; C_0603
C11, C12, C20, C22, C32, C34, C38, C58, C65, C72, C84, C85, C86, C87, C88, C115: 10uF/16V/X5R; C_0603
C13, C14, C15, C16, C17, C18, C19, C94, C95, C96, C97, C99, C100, C101, C102, C103, C104, C105, C106, C107, C108, C109, C110, C111, C112, C113, C114, C117: 100nF/16V; C_0402
C27, C122, C123: 22uF/35V; c_elec_5x5.7
C30: 2u2/10V/X5R; C_0603
C44: 220uF/10%/6V3; TantalC_SizeC_EIA-6032_Reflow
C46, C47: 47uF/25V/X7R; C_0603
C50, C51, C57, C64: 1uF/25V/X7R; C_0603
C61, C62, C70, C71: 47pF/100V/C0G; C_0603
C69: 100pF/50V/1%; C_0603
C80, C81: 470pF/50V/X7R; C_0603
C90, C91, C116: 2u2/10V; C_0402
C118, C119: 15pF/50V/NPO; C_0603
C120, C121: 10pF/50V/NPO; C_0603
CN1: XT60-M; xt60-M
CN2, CN12: XT60-F; xt60-F
CN3: AS0B821-S78B-7H
CN4: HDMI_A; MOLEX_500254_1927
CN5: 692_121_030_100; 692121030100
CN6: Wurth-68715014522-LCD; 68715014522
CN7: MOLEX_73366_0061
CN8, CN10, CN11: 629_105_150_921; WURTH_629105150921
CN9: Wurth-68711814522; 68711814522
CON1: PJ-102AH
D2, D5: VS-15MQ040NTRPBF; DO-214AC
D3, D8, D9, D11, D15: BAS316; SOD-323
D6, D7: BZV55-C18; SOD-80
D13, D14: B560C-13-F; DO-214AB-B560C-13-F
DL1, DL2, DL5, DL7, DL9, DL10, DL11, DL13, DL16: GREEN; LED_0603
DL3, DL4, DL6, DL8, DL12, DL15, DL17, DL18: RED; LED_0603
FB1, FB2: BEAD/0.6OHM/0.2A; R_0805
FB3, FB4, FB5: BEAD/0.045OHM/2A; R_0603
FB6: BEAD/330ohm/100MHz; R_0805
L2: 47nH/0A2/5%; R_0402
L3: 5.6nH/800mA/±0.5nH/0402; R_0402
L4, L5: 3u3/4A6; 7447713033
LAN1: 7499111446; WURTH_7499111446
MSD1: WURTH_693071010811
P1, P32: CONN_02X10; Pin_Header_Straight_2x10
P3: CONN_02X01; Pin_Header_Straight_2x01
P4, P5, P33, P34: ECM00870-L
P6, P10: CONN_01X08; Pin_Header_Straight_1x08
P7, P8, P9: CONN_01X04; Pin_Header_Straight_1x04
P11, P12, P13, P14, P15, P16, P17, P18, P19, P20, P21, P22, P23, P24, P25, P26, P27, P28, P29, P30, P31: CONN_01X03; Pin_Header_Straight_1x03
P35, P36, P37, P38, P39, P40: STANDOFF; STANDOFF-6-32
P41, P42, P43, P44, P45, P46, P47, P48: MPT-2.54; TerminalBlock_Pheonix_MPT-2.54mm_2pol
Q3, Q5, Q6, Q7, Q13, Q15, Q16: BSS138PW; SOT-323
Q4, Q9: FDMA530PZ
Q8: AP6681GMT-HF-3TR; AP6681GMT-HF-3
Q10: PDTC123JU; SOT-323
Q11, Q14: PDTA123JU; SOT-323
Q12, Q17: IRLML6402TRPBF; SOT23_IRLML6402
R1, R2, R3, R4, R5, R6, R8, R22, R39, R40, R42, R45, R47, R49, R51, R53, R67, R68, R76, R77, R78, R79, R80, R81, R82, R83, R89, R94, R95, R112, R113, R118, R119, R120, R121, R122, R123, R127, R152, R153, R167, R168, R188, R190, R192, R224: 10K/5%; R_0603
R7, R57, R85, R126, R128, R198, R199, R200, R201, R202, R204, R205, R206, R208, R210, R212, R217, R219, R221, R223, R249, R251, R252: 0R/5%; R_0603
R9, R10, R11, R12, R16, R17, R18, R19, R20, R21, R25, R26, R43, R44, R46, R48, R66, R149, R151: 100R/5%; R_0603
R13, R14, R15, R23, R24, R50, R52, R54, R56, R150: 100K/5%; R_0603
R27, R28, R29, R30, R86: 1K/5%; R_0603
R31, R98: N/A; R_0603
R32, R33, R73, R74: 270R/5%; R_0603
R34, R35, R38, R58, R59, R60, R61, R62, R63, R64, R65, R87, R88, R189, R191, R230, R231, R247, R248: 2k2/5%; R_0603
R36, R37, R55, R69, R70, R71, R72, R75, R97, R99, R100, R101, R102, R103, R104, R105, R106, R107, R108, R109, R110, R111, R114, R115, R116, R117, R130, R132, R133, R134, R136, R137, R138, R139, R140, R141, R142, R143, R144, R145, R146, R147, R148, R156, R158, R159, R160, R165, R166, R232, R233, R234, R235, R236, R237, R238, R239, R240, R241, R242, R243, R244, R245, R246: 22R/5%; R_0603
R84, R250: 330R/5%; R_0603
R90, R91: 1k8/5%; R_0603
R92: 27K/5%; R_0603
R93: 620R/5%; R_0603
R96, R169: 1k2/5%; R_0603
R124, R125: 2k2/5% [NA]; R_0603
R129: 100K/1%; R_0402
R131: 1k1/5%; R_0603
R135: 47K/1%; R_0402
R154: 360R; R_0603
R155: 750R; R_0603
R157: 100k/5%; R_0603
R161: 10R/5%; R_0603
R162, R164: 0R/5%; R_0402
R170: 0R[NA]; R_0603
R171: 10K/5%[NA]; R_0603
R172: 0R; R_0603
R173, R174, R175, R176, R177, R178: 150K/5%; R_0603
R179, R181: 10K2/1%; R_0603
R180: 1K96/1%; R_0603
R182: 3K24/1%; R_0603
R183: 1k5/5%; R_0603
R184: 750R/5%; R_0603
R185: 470R/5%; R_0603
R186, R187: 0R/1%; R_0805
R207, R209, R211, R213, R214, R215, R216, R218, R220, R222, R253: 0R/5%[NA]; R_0603
SW1, SW2, SW3, SW4, SW5, SW6, SW7, SW8, SW10, SW11: OMRON B3F-1070; SW_TH_Tactile_Omron_B3F-10xx_6x6
SW9: ALPS-SPPJ320600; SPPJ320600
U1: L3GD20HTR; LGA16-3MM_LONG_PADS
U2: LSM303DTR; LGA16-3MM_LONG_PADS
U3: IS42S16400J-7BLI; tfbga-54-35
U4, U7: FT232RQ; QFN-32-1EP_5x5mm_Pitch0.5mm
U5: BMP280; BMP280_LGA-8
U6: M25P32-VMW6TG; SOIJ-8_5.3x5.3mm_Pitch1.27mm
U8: TPD12S521DBTR; TSSOP-38_4.4x9.7mm_Pitch0.5mm
U9, U20: VBUS053CZ-HAF-G-08; VBUS053CZ-HAF
U10: TPS2065CDBVT; SOT-23-5
U11: VBUS054CD-FHI-GS08; VBUS054CD-FHI
U12: TSC2046IPWR; TSSOP-16_4.4x5mm_Pitch0.65mm
U13: PCF8563TS; TSSOP-8_3x3mm_Pitch0.65mm
U14: BR24L02FVM-WTR; TSSOP-8_3x3mm_Pitch0.65mm
U15: NTZD3155C; SOT-563_NTZD3155C
U16: LEA-6S; LEA-6
U17: SF1186K-3
U18: BGA825L6S; TSLP-6-3
U19: TPS2061CDBVT; SOT-23-5
U21: SN74LVC162244A; TSSOP-48_6.1x12.5mm_Pitch0.5mm
U22, U23: TPS54332DDA; TPS54332DDAR
U24: PCA9685PW; TSSOP-28_4.4x9.7mm_Pitch0.65mm
U25: STM32F429NI; tfbga-216-35
U26: TLV803SDBZT; SOT-23
U27: LTC4412; SOT23-6_LTC4412
Y1, Y2: 32.768KHZ; ABS07
Y3: ABMM2-MHz; ABMM2

Connections:
+3V3: C9.1, C10.1, C13.1, C14.1, C15.1, C16.1, C17.1, C18.1, C19.1, C22.2, C23.2, C30.1, C31.2, C34.2, C35.2, C37.1, C38.1, C46.1, C48.1, C50.1, C52.1, C54.1, C56.1, C57.1, C60.2, C74.1, C75.1, C76.1, C77.1, C85.1, C87.1, C88.2, C89.2, C94.2, C95.2, C96.2, C99.2, C100.2, C101.2, C102.2, C103.2, C104.2, C105.2, C106.2, C107.2, C108.2, C109.2, C110.2, C111.2, C112.2, C113.2, C114.2, C115.1, C116.2, C117.1, C124.1, CN6.45, CN6.46, CN9.1, D11.2, D15.2, DL5.2, DL7.2, DL17.2, DL18.2, L5.2, MSD1.4, P1.1, P1.2, P6.1, P7.1, P9.1, P10.1, P10.5, P32.1, P32.2, Q12.2, Q14.2, Q17.2, R3.1, R4.1, R5.1, R6.1, R8.1, R16.1, R17.1, R18.1, R25.1, R26.1, R34.1, R35.1, R42.1, R53.1, R60.1, R61.1, R62.1, R63.1, R64.1, R65.1, R67.1, R77.1, R78.1, R79.1, R80.1, R81.1, R82.1, R83.1, R89.1, R92.1, R93.1, R94.1, R112.2, R118.1, R119.1, R120.1, R121.1, R122.1, R123.1, R124.1, R125.1, R127.1, R151.1, R154.1, R155.1, R157.1, R167.1, R168.1, R171.1, R181.1, R184.1, R186.2, R187.2, R189.1, R191.1, R224.1, R230.1, R231.1, R247.1, R248.1, R252.1, SW2.1, SW2.2, SW3.1, SW3.2, SW4.1, SW4.2, SW6.1, SW6.2, SW7.1, SW7.2, SW8.1, SW8.2, SW11.1, SW11.2, U1.1, U2.1, U3.A7, U3.A9, U3.B3, U3.C7, U3.D3, U3.E7, U3.J9, U4.1, U5.2, U5.6, U6.3, U6.7, U6.8, U7.1, U12.1, U12.7, U12.10, U14.1, U14.2, U14.8, U21.7, U21.18, U21.31, U21.42, U24.28, U25.E5, U25.E7, U25.E8, U25.E9, U25.E10, U25.F4, U25.F5, U25.F11, U25.G5, U25.G11, U25.H5, U25.H11, U25.J5, U25.J11, U25.K5, U25.K11, U25.L7, U25.L8, U25.L9, U25.L10, U25.P1, U25.R1, U26.3
+5V: C41.2, C47.1, C49.1, C51.1, C53.1, C84.1, C86.1, CN3.1E2, CN3.1E3, CN3.1E4, CN3.1E5, CN3.1E6, CN3.1E7, CN3.1E8, CN3.1E9, CN3.1E10, CN3.2E2, CN3.2E3, CN3.2E4, CN3.2E5, CN3.2E6, CN3.2E7, CN3.2E8, CN3.2E9, CN3.2E10, CN6.47, CN6.48, L4.2, P7.4, P8.1, P11.2, P12.2, P13.2, P14.2, P15.2, P16.2, P17.2, P18.2, P19.2, P20.2, P21.2, P22.2, P23.2, P24.2, P25.2, P26.2, P27.2, P28.2, P29.2, P30.2, P31.2, R58.1, R59.1, R87.1, R88.1, R90.1, R91.1, R95.1, R135.2, R179.1, R183.2, U8.1, U10.5, U15.4, U19.5
+BATT: CN1.P, CN12.P, D2.2, D6.1, Q8.1, Q8.2, Q8.3, Q11.2, R51.1, SW9.4
/Cortex FTDI Interface/C_FTDI_RXD: U4.2, U25.B6
/Cortex FTDI Interface/C_FTDI_TXD: U4.30, U25.B5
/External Sensors/C_I2C2_SCL: R246.1, R247.2, U25.H4
/External Sensors/C_I2C2_SDA: R245.1, R248.2, U25.J3
/External Sensors/C_I2C3_SCL: R231.2, R239.1, U25.N13
/External Sensors/C_I2C3_SDA: R230.2, R238.1, U25.P14
/External Sensors/C_SPI2_CLK: R242.1, U25.D14
/External Sensors/C_SPI2_MISO: R243.1, U25.C14
/External Sensors/C_SPI2_MOSI: R244.1, U25.C13
/External Sensors/C_SPI2_NSS1: R241.1, U25.E14
/External Sensors/C_SPI2_NSS2: R240.1, U25.C3
/External Sensors/EXT_GPIO_1: R232.1, U25.P13
/External Sensors/EXT_GPIO_2: R233.1, U25.M15
/External Sensors/EXT_GPIO_3: R234.1, U25.E12
/External Sensors/EXT_GPIO_4: R235.1, U25.E13
/External Sensors/EXT_GPIO_5: R236.1, U25.D13
/External Sensors/EXT_GPIO_6: R237.1, U25.K2
/GPS/GPS_RXD(3V3): R160.2, U25.B14
/GPS/GPS_TIME_PULSE: R158.2, U25.A8
/JTAG/SWD/JTAG_POWER: P1.19, P3.2, R7.2
/JTAG/SWD/JTAG_POWER_ON: P3.1, R7.1, R46.2
/JTAG/SWD/RESET#: C92.1, P1.15, R12.2, R224.2, U25.J1, U26.2
/JTAG/SWD/TCK/SWCLK: P1.9, R6.2, U25.A14
/JTAG/SWD/TDI: P1.5, R4.2, U25.A13
/JTAG/SWD/TDO/SWO: P1.13, R8.2, U25.A10
/JTAG/SWD/TMS/SWDIO: P1.7, R5.2, U25.A15
/JTAG/SWD/TRST: P1.3, R3.2, U25.A9
/Leds/Buttons/BOOT0: R22.2, SW6.3, SW6.4, U25.E6
/Leds/Buttons/BUTTON_0: R9.2, U25.M5
/Leds/Buttons/BUTTON_1: R10.2, U25.M13
/Leds/Buttons/BUTTON_2: R11.2, U25.M12
/Leds/Buttons/BUTTON_3: R19.2, U25.J15
/Leds/Buttons/BUTTON_4: R20.2, U25.J14
/Leds/Buttons/LED1: R27.2, U25.E3
/Leds/Buttons/LED2: R28.2, U25.G3
/Leds/Buttons/LED3: R29.2, U25.H3
/Leds/Buttons/LED4: R30.2, U25.G4
/Leds/Buttons/MODULE_RESET#: CN3.254, R21.2, R67.2, U25.N4
/MEMS/MEMS_ACC_INT1: U2.11, U25.D12
/MEMS/MEMS_ACC_INT2: U2.9, U25.A12
/MEMS/MEMS_GYR_INT1: U1.7, U25.N2
/MEMS/MEMS_GYR_INT2: U1.6, U25.R2
/MEMS/V_SENS1: C11.1, C12.1, C25.1, Q12.3, U1.15, U1.16, U2.14, U5.8
/Power Control/ADAPTER_AV#: Q3.3, R42.2, U25.L4
/Power Control/BAT_MSRMNT: C29.1, Q11.3, R54.1, U25.M4
/Power Control/MSRMNT_ON: Q10.1, U25.N14
/Power Control/PWR_BTN_READ: D9.2, R53.2, U25.P15
/Power Control/PWR_ON: Q7.1, R50.1, U25.N15
/Power Control/VH_CTRL: R44.2, U25.R5
/Power Control/Vsys: C28.1, C122.1, C123.1, Q9.1, Q9.2, Q9.5, Q9.6, Q9.7, R173.1, R175.1, U22.2, U23.2
/STM32F4 SDRAM/FMC_A0: U3.H7, U25.D2
/STM32F4 SDRAM/FMC_A1: U3.H8, U25.E2
/STM32F4 SDRAM/FMC_A2: U3.J8, U25.G2
/STM32F4 SDRAM/FMC_A3: U3.J7, U25.H2
/STM32F4 SDRAM/FMC_A4: U3.J3, U25.J2
/STM32F4 SDRAM/FMC_A5: U3.J2, U25.K3
/STM32F4 SDRAM/FMC_A6: U3.H3, U25.M6
/STM32F4 SDRAM/FMC_A7: U3.H2, U25.N6
/STM32F4 SDRAM/FMC_A8: U3.H1, U25.P6
/STM32F4 SDRAM/FMC_A9: U3.G3, U25.M8
/STM32F4 SDRAM/FMC_A10: U3.H9, U25.N7
/STM32F4 SDRAM/FMC_A11: U3.G2, U25.M7
/STM32F4 SDRAM/FMC_B0: U3.G7, U25.N12
/STM32F4 SDRAM/FMC_B1: U3.G8, U25.N11
/STM32F4 SDRAM/FMC_D0: U3.A8, U25.L12
/STM32F4 SDRAM/FMC_D1: U3.B9, U25.K13
/STM32F4 SDRAM/FMC_D2: U3.B8, U25.B12
/STM32F4 SDRAM/FMC_D3: U3.C9, U25.C12
/STM32F4 SDRAM/FMC_D4: U3.C8, U25.R8
/STM32F4 SDRAM/FMC_D5: U3.D9, U25.N9
/STM32F4 SDRAM/FMC_D6: U3.D8, U25.P9
/STM32F4 SDRAM/FMC_D7: U3.E9, U25.R9
/STM32F4 SDRAM/FMC_D8: R204.2, U3.E1
/STM32F4 SDRAM/FMC_D9: U3.D2, U25.R10
/STM32F4 SDRAM/FMC_D10: R205.2, U3.D1
/STM32F4 SDRAM/FMC_D11: R206.2, U3.C2
/STM32F4 SDRAM/FMC_D12: U3.C1, U25.R11
/STM32F4 SDRAM/FMC_D13: U3.B2, U25.L15
/STM32F4 SDRAM/FMC_D14: U3.B1, U25.L14
/STM32F4 SDRAM/FMC_D15: U3.A2, U25.K15
/STM32F4 SDRAM/FMC_NBL0: U3.E8, U25.A6
/STM32F4 SDRAM/FMC_NBL1: U3.F1, U25.A5
/STM32F4 SDRAM/FMC_SDCKE0: U3.F3, U25.K4
/STM32F4 SDRAM/FMC_SDCLK: U3.F2, U25.H14
/STM32F4 SDRAM/FMC_SDNCAS: U3.F7, U25.B7
/STM32F4 SDRAM/FMC_SDNE0: U3.G9, U25.J4
/STM32F4 SDRAM/FMC_SDNRAS: U3.F8, U25.P8
/STM32F4 SDRAM/FMC_SDNWE: U3.F9, U25.M2
/Sensors Power Control/V_SENS_CTRL: R55.2, U25.R4
/Servo Motors PWM output/SRV_PWM_0: U21.47, U25.F15
/Servo Motors PWM output/SRV_PWM_1: R207.2, R208.2, U21.46
/Servo Motors PWM output/SRV_PWM_2: R209.2, R210.2, U21.44
/Servo Motors PWM output/SRV_PWM_3: R211.2, R212.2, U21.43
/Servo Motors PWM output/SRV_PWM_4: U21.41, U25.H15
/Servo Motors PWM output/SRV_PWM_6: U21.38, U25.G14
/Servo Motors PWM output/SRV_PWM_7: U21.37, U25.F14
/USB_OTG_FS/OTG_FS_DM: C71.1, R165.2, R215.2
/USB_OTG_FS/OTG_FS_DP: C70.1, R166.2, U25.B15
/USB_OTG_FS/OTG_FS_ID: CN8.4, R214.2, U20.3
/USB_OTG_FS/OTG_FS_VBUS: C72.1, C73.1, CN8.1, FB5.2, R169.2, R213.2, U20.6
/Wandboard Connector/CSPI1_CS1: CN3.230, R69.1
/Wandboard Connector/DISP0_DAT0: CN3.2, CN6.1
/Wandboard Connector/DISP0_DAT1: CN3.4, CN6.2
/Wandboard Connector/DISP0_DAT2: CN3.8, CN6.3
/Wandboard Connector/DISP0_DAT3: CN3.10, CN6.4
/Wandboard Connector/DISP0_DAT4: CN3.14, CN6.5
/Wandboard Connector/DISP0_DAT5: CN3.16, CN6.6
/Wandboard Connector/DISP0_DAT6: CN3.20, CN6.7
/Wandboard Connector/DISP0_DAT7: CN3.22, CN6.8
/Wandboard Connector/DISP0_DAT8: CN3.26, CN6.10
/Wandboard Connector/DISP0_DAT9: CN3.28, CN6.11
/Wandboard Connector/DISP0_DAT10: CN3.32, CN6.12
/Wandboard Connector/DISP0_DAT11: CN3.34, CN6.13
/Wandboard Connector/DISP0_DAT12: CN3.36, CN6.14
/Wandboard Connector/DISP0_DAT13: CN3.38, CN6.15
/Wandboard Connector/DISP0_DAT14: CN3.40, CN6.16
/Wandboard Connector/DISP0_DAT15: CN3.44, CN6.17
/Wandboard Connector/DISP0_DAT16: CN3.46, CN6.19
/Wandboard Connector/DISP0_DAT17: CN3.50, CN6.20
/Wandboard Connector/DISP0_DAT18: CN3.52, CN6.21
/Wandboard Connector/DISP0_DAT19: CN3.56, CN6.22
/Wandboard Connector/DISP0_DAT20: CN3.58, CN6.23
/Wandboard Connector/DISP0_DAT21: CN3.62, CN6.24
/Wandboard Connector/DISP0_DAT22: CN3.64, CN6.25
/Wandboard Connector/DISP0_DAT23: CN3.68, CN6.26
/Wandboard Connector/MODULE_ON/OFF: R66.2, U25.R3
/Wandboard Connector/PWR_BTN(ON/OFF): CN3.252, Q13.3
/Wandboard Connector/RTC_INT: CN3.96, R126.1, U25.C8
/Wandboard Connector/R_NANDF_CS2: CN3.92, R57.1
/Wandboard Connector/WB_GPIO1: CN3.256, R198.2
/Wandboard Connector/WB_GPIO2: CN3.258, R199.2
/Wandboard Connector/WB_GPIO3: CN3.260, R200.2
/Wandboard Connector/WB_GPIO4: CN3.262, R201.2
/Wandboard Connector/WB_GPIO5: CN3.264, R202.2
/Wandboard Connector/WB_SPI_CLK: CN3.226, R70.1, U25.A3
/Wandboard Connector/WB_SPI_CS: CN3.228, U25.A1, U25.A2
/Wandboard Connector/WB_SPI_MISO: CN3.224, R72.1, R221.2, R222.2
/Wandboard Connector/WB_SPI_MOSI: CN3.222, R71.1, R220.2, R223.2
/Wandboard Connector/Wandboard EEPROM/EEPROM_SCL: CN3.231, R62.2, R124.2, R146.1, U13.6, U14.6
/Wandboard Connector/Wandboard EEPROM/EEPROM_SDA: CN3.233, R63.2, R125.2, R145.1, U13.5, U14.5
/Wandboard Connector/Wandboard Ethernet/LED1_ACT: CN3.3E7, R250.2
/Wandboard Connector/Wandboard Ethernet/LED1_nLINK100: CN3.4E8, R84.2
/Wandboard Connector/Wandboard Ethernet/LED1_nLINK1000: CN3.4E9, R251.2
/Wandboard Connector/Wandboard Ethernet/TRD0_N: CN3.4E3, LAN1.2
/Wandboard Connector/Wandboard Ethernet/TRD0_P: CN3.4E2, LAN1.1
/Wandboard Connector/Wandboard Ethernet/TRD1_N: CN3.4E6, LAN1.6
/Wandboard Connector/Wandboard Ethernet/TRD1_P: CN3.4E5, LAN1.3
/Wandboard Connector/Wandboard Ethernet/TRD2_N: CN3.3E3, LAN1.5
/Wandboard Connector/Wandboard Ethernet/TRD2_P: CN3.3E2, LAN1.4
/Wandboard Connector/Wandboard Ethernet/TRD3_N: CN3.3E6, LAN1.8
/Wandboard Connector/Wandboard Ethernet/TRD3_P: CN3.3E5, LAN1.7
/Wandboard Connector/Wandboard FTDI Interface/WB_FTDI_CTS: CN3.241, U7.8
/Wandboard Connector/Wandboard FTDI Interface/WB_FTDI_DSR: R249.1, U7.6
/Wandboard Connector/Wandboard FTDI Interface/WB_FTDI_DTR: R249.2, U7.31
/Wandboard Connector/Wandboard FTDI Interface/WB_FTDI_RTS: CN3.247, U7.32
/Wandboard Connector/Wandboard FTDI Interface/WB_FTDI_RXD: CN3.243, U7.2
/Wandboard Connector/Wandboard FTDI Interface/WB_FTDI_TXD: CN3.245, U7.30
/Wandboard Connector/Wandboard HDMI/DDC_SCL(5V): CN3.75, R58.2, R87.2, R141.1, U8.17
/Wandboard Connector/Wandboard HDMI/HDMI1_HPD: CN3.67, U8.19
/Wandboard Connector/Wandboard HDMI/HDMI_CEC_IN: CN3.71, R86.2, U8.16
/Wandboard Connector/Wandboard HDMI/HDMI_CLK+: CN3.43, U8.13
/Wandboard Connector/Wandboard HDMI/HDMI_CLK-: CN3.45, U8.15
/Wandboard Connector/Wandboard HDMI/HDMI_D0+: CN3.49, U8.10
/Wandboard Connector/Wandboard HDMI/HDMI_D0-: CN3.51, U8.12
/Wandboard Connector/Wandboard HDMI/HDMI_D1+: CN3.55, U8.7
/Wandboard Connector/Wandboard HDMI/HDMI_D1-: CN3.57, U8.9
/Wandboard Connector/Wandboard HDMI/HDMI_D2+: CN3.61, U8.4
/Wandboard Connector/Wandboard HDMI/HDMI_D2-: CN3.63, U8.6
/Wandboard Connector/Wandboard LCD/DISP0_CLK: CN3.70, R103.2
/Wandboard Connector/Wandboard LCD/DISP0_CNTRST: CN3.76, R98.2, R99.2
/Wandboard Connector/Wandboard LCD/DISP0_DRDY: CN3.78, R100.2
/Wandboard Connector/Wandboard LCD/DISP0_HSYNC: CN3.72, R101.2
/Wandboard Connector/Wandboard LCD/DISP0_PWREN: CN3.82, R111.2
/Wandboard Connector/Wandboard LCD/DISP0_RESET: CN3.80, R110.2
/Wandboard Connector/Wandboard LCD/DISP0_VSYNC: CN3.74, R102.2
/Wandboard Connector/Wandboard LCD/TOUCH_X1: CN6.34, U12.2
/Wandboard Connector/Wandboard LCD/TOUCH_X2: CN6.35, U12.4
/Wandboard Connector/Wandboard LCD/TOUCH_Y1: CN6.36, U12.3
/Wandboard Connector/Wandboard LCD/TOUCH_Y2: CN6.37, U12.5
/Wandboard Connector/Wandboard LCD/TP_BUSY: CN3.263, R122.2, U12.13
/Wandboard Connector/Wandboard LCD/TP_PENIRQ: R57.2, R123.2, U12.11
/Wandboard Connector/Wandboard OTG to Cortex USB FS2/USB_OGT_DM: C62.1, CN3.159, R133.2
/Wandboard Connector/Wandboard OTG to Cortex USB FS2/USB_OTG_DP: C61.1, CN3.157, R134.2
/Wandboard Connector/Wandboard OTG to Cortex USB FS2/USB_OTG_ID: CN3.155, R128.2
/Wandboard Connector/Wandboard OTG to Cortex USB FS2/USB_OTG_OC: CN3.141, R127.2
/Wandboard Connector/Wandboard OTG to Cortex USB FS2/USB_OTG_PWR_EN#: CN3.163, Q14.1
/Wandboard Connector/Wandboard OTG to Cortex USB FS2/USG_OTG_VBUS: CN3.161, R130.2
/Wandboard Connector/Wandboard SD Card/SD1_CD: CN3.203, MSD1.9, R77.2
/Wandboard Connector/Wandboard SD Card/SD1_CLK: CN3.206, R75.2
/Wandboard Connector/Wandboard SD Card/SD1_CMD: CN3.205, MSD1.3, R83.2
/Wandboard Connector/Wandboard SD Card/SD1_DATA0: CN3.212, MSD1.7, R81.2
/Wandboard Connector/Wandboard SD Card/SD1_DATA1: CN3.209, MSD1.8, R82.2
/Wandboard Connector/Wandboard SD Card/SD1_DATA2: CN3.214, MSD1.1, R78.2
/Wandboard Connector/Wandboard SD Card/SD1_DATA3: CN3.211, MSD1.2, R79.2
/Wandboard Connector/Wandboard SD Card/SD1_WP: CN3.207, R76.1
/Wandboard Connector/Wandboard Service/CSPI2_CLK: CN3.223, R104.2, R114.1, R118.2, R138.1
/Wandboard Connector/Wandboard Service/CSPI2_CS0_DISPLAY: CN3.225, R107.2, R139.1
/Wandboard Connector/Wandboard Service/CSPI2_CS1_TP: CN3.227, R115.1, R119.2, R140.1
/Wandboard Connector/Wandboard Service/CSPI2_MISO: CN3.221, R106.2, R117.1, R121.2, R137.1
/Wandboard Connector/Wandboard Service/CSPI2_MOSI: CN3.219, R105.2, R116.1, R120.2, R136.1
/Wandboard Connector/Wandboard Service/DDC_SCL(5V): CN3.73, R59.2, R88.2, R142.1, U8.18
/Wandboard Connector/Wandboard Service/DISP0_I2C3_SCL(3V3): CN3.235, R60.2, R108.2, R148.1
/Wandboard Connector/Wandboard Service/DISP0_I2C3_SDA(3V3): CN3.237, R61.2, R109.2, R147.1
/Wandboard Connector/Wandboard Service/I2C1_SCL(3V3): CN3.39, R64.2, R144.1
/Wandboard Connector/Wandboard Service/I2C1_SDA(3V3): CN3.37, R65.2, R143.1
/Wandboard Connector/Wandboard Service/WB_BUTTON1: CN3.259, R149.2
/Wandboard Connector/Wandboard Service/WB_LED1: CN3.261, Q15.1, R152.1
/Wandboard Connector/Wandboard Service/WB_LED2: CN3.255, Q16.1, R153.1
/Wandboard Connector/Wandboard USB Host/GND_DRAIN: CN3.171, CN5.7, FB4.1
/Wandboard Connector/Wandboard USB Host/StdA_SSRX+: CN3.167, CN5.6, U11.4, U11.7
/Wandboard Connector/Wandboard USB Host/StdA_SSRX-: CN3.169, CN5.5, U11.5, U11.6
/Wandboard Connector/Wandboard USB Host/StdA_SSTX+: CN3.173, CN5.9, U11.1, U11.10
/Wandboard Connector/Wandboard USB Host/StdA_SSTX-: CN3.175, CN5.8, U11.2, U11.9
/Wandboard Connector/Wandboard USB Host/USB_HOST_DM: CN3.179, CN5.2, U9.1
/Wandboard Connector/Wandboard USB Host/USB_HOST_DP: CN3.181, CN5.3, U9.2
/Wandboard Connector/Wandboard USB Host/USB_HOST_OC: CN3.165, DL8.1, R94.2, U10.3
/cortex/C_OTG_FS_OC: R168.2, U19.3, U25.P5
/cortex/C_OTG_FS_PSO: R167.2, U19.4, U25.N5
/cortex/C_WB_UART_CTS: CN3.234, R217.2, R218.2
/cortex/C_WB_UART_RTS: CN3.240, R216.2, R219.2
/cortex/C_WB_UART_RX: CN3.236, U25.B11
/cortex/C_WB_UART_TX: CN3.238, U25.C10
/cortex/GPS_PWR_CTRL: R156.2, U25.A4
/cortex/GPS_RXD: R159.2, U25.B13
/cortex/IN_PWM_01: U21.13, U25.P4
/cortex/IN_PWM_02: U21.14, U25.P3
/cortex/IN_PWM_03: U21.16, U25.M10
/cortex/IN_PWM_04: U21.17, U25.N3
/cortex/IN_PWM_05: U21.19, U25.P2
/cortex/MEMS_ACC_CS: U2.8, U25.A11
/cortex/MEMS_GYRO_CS: U1.5, U25.M3
/cortex/MEMS_SPI5_MISO: U1.4, U2.7, U25.L3
/cortex/MEMS_SPI5_MOSI: U1.3, U2.6, U25.L2
/cortex/MEMS_SPI5_SCK: U1.2, U2.4, U25.K1
/cortex/OSC-IN: C118.2, U25.E1, Y2.1
/cortex/OSC-OUT: C119.2, U25.F1, Y2.2
/cortex/OTG_HS_DM: R133.1, U25.R14
/cortex/OTG_HS_DP: R134.1, U25.R15
/cortex/OTG_HS_VBUS: R132.1, U25.K14
/cortex/PCA9685_OE: R188.1, U24.23, U25.L13
/cortex/PCA9685_SCL: R189.2, U24.26, U25.P12
/cortex/PCA9685_SDA: R191.2, U24.27, U25.R13
/cortex/PH0: C120.2, U25.G1, Y3.1
/cortex/PH1: C121.2, U25.H1, Y3.3
/cortex/PI6: R198.1, U25.D6
/cortex/PI7: R199.1, U25.D4
/cortex/PI8: R200.1, U25.C2
/cortex/PI9: R201.1, U25.E4
/cortex/PI10: R202.1, U25.D5
/cortex/PS_I2C1_SCL: R34.2, R37.2, U25.A7
/cortex/PS_I2C1_SDA: R35.2, R36.2, U25.B4
/cortex/PWM_SRV_EN: R170.1, U25.D3
/cortex/SPI4_MISO: R220.1, R221.1, U25.B1
/cortex/SPI4_MOSI: R222.1, R223.1, U25.B2
/cortex/TIM1_CH2/FMC_D8: R204.1, R207.1, U25.P10
/cortex/TIM1_CH2/OTG_FS_VBUS: R208.1, R213.1, U25.E15
/cortex/TIM1_CH3/FMC_D10: R205.1, R209.1, U25.R12
/cortex/TIM1_CH3/OTG_FS_ID: R210.1, R214.1, U25.D15
/cortex/TIM1_CH4/FMC_D11: R206.1, R211.1, U25.P11
/cortex/TIM1_CH4/OTG_FS_DM: R212.1, R215.1, U25.C15
/cortex/USART2_CTS: R216.1, R217.1, U25.C11
/cortex/USART2_RTS: R218.1, R219.1, U25.D11
/cortex/VCAP1: C90.2, U25.L11
/cortex/VCAP2: C91.2, U25.E11
GND: A1.2, BT1.2, C7.2, C8.2, C9.2, C10.2, C11.2, C12.2, C13.2, C14.2, C15.2, C16.2, C17.2, C18.2, C19.2, C20.1, C21.1, C22.1, C23.1, C24.2, C25.2, C26.2, C27.2, C28.2, C29.2, C30.2, C31.1, C32.1, C33.1, C34.1, C35.1, C36.2, C37.2, C38.2, C39.2, C40.1, C41.1, C42.1, C43.1, C44.2, C45.2, C46.2, C47.2, C48.2, C49.2, C50.2, C51.2, C52.2, C53.2, C54.2, C55.2, C56.2, C57.2, C58.2, C59.2, C60.1, C61.2, C62.2, C64.1, C65.1, C66.1, C67.1, C68.1, C70.2, C71.2, C72.2, C73.2, C74.2, C75.2, C76.2, C77.2, C78.2, C79.2, C80.2, C81.2, C84.2, C85.2, C86.2, C87.2, C88.1, C89.1, C90.1, C91.1, C92.2, C94.1, C95.1, C96.1, C97.1, C99.1, C100.1, C101.1, C102.1, C103.1, C104.1, C105.1, C106.1, C107.1, C108.1, C109.1, C110.1, C111.1, C112.1, C113.1, C114.1, C115.2, C116.1, C117.2, C118.1, C119.1, C120.1, C121.1, C122.2, C123.2, C124.2, C125.1, CN1.N, CN2.N, CN3.1, CN3.3E1, CN3.3E4, CN3.3E8, CN3.4E1, CN3.4E4, CN3.4E7, CN3.4E10, CN3.6, CN3.7, CN3.12, CN3.13, CN3.18, CN3.19, CN3.24, CN3.25, CN3.30, CN3.41, CN3.42, CN3.47, CN3.48, CN3.53, CN3.54, CN3.59, CN3.60, CN3.65, CN3.66, CN3.77, CN3.83, CN3.88, CN3.89, CN3.94, CN3.95, CN3.100, CN3.101, CN3.121, CN3.124, CN3.148, CN3.153, CN3.154, CN3.166, CN3.177, CN3.184, CN3.185, CN3.198, CN3.201, CN3.204, CN3.217, CN3.220, CN3.229, CN3.232, CN3.239, CN3.249, CN3.250, CN3.265, CN3.266, CN3.P1, CN3.P2, CN4.2, CN4.5, CN4.8, CN4.11, CN4.17, CN4.FN, CN5.4, CN5.10, CN5.11, CN6.9, CN6.18, CN6.31, CN6.33, CN6.44, CN6.FN, CN7.2, CN7.3, CN7.4, CN7.5, CN8.5, CN8.6, CN8.7, CN8.8, CN8.9, CN8.10, CN8.11, CN9.17, CN9.18, CN9.FN, CN10.5, CN10.6, CN10.7, CN10.8, CN10.9, CN10.10, CN10.11, CN11.5, CN11.6, CN11.7, CN11.8, CN11.9, CN11.10, CN11.11, CN12.N, CON1.2, CON1.3, D13.2, D14.2, DL1.1, DL2.1, DL3.1, DL4.1, DL6.1, DL9.1, DL10.1, DL13.1, DL15.1, DL16.1, FB4.2, LAN1.10, LAN1.FN, MSD1.6, MSD1.10, P1.4, P1.6, P1.8, P1.10, P1.12, P1.14, P1.16, P1.18, P1.20, P4.GND, P5.GND, P6.7, P6.8, P7.2, P7.3, P8.4, P9.4, P10.4, P10.8, P11.3, P12.3, P13.3, P14.3, P15.3, P16.3, P17.3, P18.3, P19.3, P20.3, P21.3, P22.3, P23.3, P24.3, P25.3, P26.3, P27.3, P28.3, P29.3, P30.3, P31.3, P32.19, P32.20, P33.GND, P34.GND, P35.GND, P36.GND, P37.GND, P38.GND, P39.GND, P40.GND, P41.2, P42.2, P43.2, P44.2, P45.2, P46.2, P47.2, P48.2, Q3.2, Q5.2, Q6.2, Q7.2, Q10.2, Q13.2, Q15.2, Q16.2, R1.1, R2.1, R13.2, R14.2, R15.2, R22.1, R23.2, R24.2, R40.2, R45.2, R47.2, R50.2, R54.2, R56.2, R68.2, R76.2, R85.2, R97.2, R113.2, R128.1, R129.1, R150.2, R152.2, R153.2, R172.1, R174.2, R176.2, R180.2, R182.2, R188.2, R190.2, R192.2, R253.1, SW1.1, SW1.2, SW5.1, SW5.2, SW9.P1, SW9.P2, SW10.1, SW10.2, U1.8, U1.9, U1.10, U1.11, U1.12, U1.13, U2.5, U2.10, U2.12, U2.13, U2.16, U3.A1, U3.A3, U3.B7, U3.C3, U3.D7, U3.E3, U3.J1, U4.4, U4.17, U4.20, U4.24, U4.26, U4.33, U5.1, U5.5, U5.7, U6.4, U7.4, U7.17, U7.20, U7.24, U7.26, U7.33, U8.3, U8.5, U8.8, U8.11, U8.14, U8.25, U8.28, U8.31, U8.34, U8.36, U9.7, U10.2, U11.3, U11.8, U11.11, U12.6, U13.4, U14.4, U14.7, U15.1, U16.7, U16.13, U16.14, U16.15, U16.17, U16.24, U17.B, U17.D, U17.E, U18.1, U18.4, U19.2, U20.7, U21.4, U21.10, U21.15, U21.21, U21.24, U21.25, U21.28, U21.34, U21.39, U21.40, U22.7, U22.9, U23.7, U23.9, U24.1, U24.2, U24.3, U24.4, U24.14, U24.25, U25.F2, U25.F6, U25.F7, U25.F8, U25.F9, U25.F10, U25.G6, U25.G10, U25.H6, U25.H10, U25.J6, U25.J10, U25.K6, U25.K7, U25.K8, U25.K9, U25.K10, U25.L5, U25.L6, U25.M1, U25.N1, U26.1, U27.2, U27.6, Y3.2, Y3.4
unnamed: A1.1, L3.1
unnamed: BT1.1, R185.2
unnamed: C1.1, R16.2
unnamed: C1.2, R9.1, R13.1, SW2.3, SW2.4
unnamed: C2.1, R17.2
unnamed: C2.2, R10.1, R14.1, SW3.3, SW3.4
unnamed: C3.1, R18.2
unnamed: C3.2, R11.1, R15.1, SW4.3, SW4.4
unnamed: C4.1, R25.2
unnamed: C4.2, R19.1, R23.1, SW7.3, SW7.4
unnamed: C5.1, R26.2
unnamed: C5.2, R20.1, R24.1, SW8.3, SW8.4
unnamed: C6.1, U2.3
unnamed: C6.2, U2.2
unnamed: C7.1, U1.14
unnamed: C8.1, U2.15
unnamed: C20.2, CN10.1, FB1.1
unnamed: C21.2, FB1.2, U4.19
unnamed: C24.1, U4.16
unnamed: C26.1, C27.1, D5.1, D7.1, Q4.1, Q4.2, Q4.5, Q4.6, Q4.7, Q9.4, Q9.8, R52.1, SW9.1
unnamed: C32.2, CN11.1, FB2.1
unnamed: C33.2, FB2.2, U7.19
unnamed: C36.1, U7.16
unnamed: C39.1, LAN1.9
unnamed: C40.2, R89.2, U8.2
unnamed: C42.2, U8.37
unnamed: C43.2, CN4.18, U8.38
unnamed: C44.1, C45.1, CN5.1, FB3.2, R96.2, U9.6
unnamed: C55.1, U12.9
unnamed: C63.1, R151.2
unnamed: C63.2, R149.1, R150.1, SW11.3, SW11.4
unnamed: C64.2, FB6.1, Q17.3
unnamed: C65.2, C66.2, FB6.2, U16.6
unnamed: C68.2, L2.2, U18.2, U18.6
unnamed: C69.1, U17.C
unnamed: C69.2, U18.3
unnamed: C78.1, U22.4
unnamed: C79.1, U23.4
unnamed: C80.1, R177.2
unnamed: C81.1, R178.2
unnamed: C82.1, U22.1
unnamed: C82.2, D13.1, L4.1, U22.8
unnamed: C83.1, U23.1
unnamed: C83.2, D14.1, L5.1, U23.8
unnamed: C125.2, D2.1, Q4.4, Q4.8, U27.1
unnamed: CN4.1, U8.35
unnamed: CN4.3, U8.33
unnamed: CN4.4, U8.32
unnamed: CN4.6, U8.30
unnamed: CN4.7, U8.29
unnamed: CN4.9, U8.27
unnamed: CN4.10, U8.26
unnamed: CN4.12, U8.24
unnamed: CN4.13, R92.2, U8.23
unnamed: CN4.15, R91.2, U8.22
unnamed: CN4.16, R90.2, U8.21
unnamed: CN4.19, U8.20
unnamed: CN6.27, R97.1, R98.1
unnamed: CN6.28, R99.1, R100.1
unnamed: CN6.29, R101.1
unnamed: CN6.30, R102.1
unnamed: CN6.32, R103.1
unnamed: CN6.38, R104.1
unnamed: CN6.39, R105.1
unnamed: CN6.40, R106.1
unnamed: CN6.41, R107.1
unnamed: CN6.42, R108.1
unnamed: CN6.43, R109.1
unnamed: CN6.49, R110.1, R112.1
unnamed: CN6.50, R111.1, R113.1
unnamed: CN7.1, R162.2
unnamed: CN8.2, R165.1, U20.1
unnamed: CN8.3, R166.1, U20.2
unnamed: CN9.2, P32.4, R240.2
unnamed: CN9.3, P32.6, R241.2
unnamed: CN9.4, P32.8, R242.2
unnamed: CN9.5, P32.10, R243.2
unnamed: CN9.6, P32.12, R244.2
unnamed: CN9.7, P32.14, R245.2
unnamed: CN9.8, P32.16, R246.2
unnamed: CN9.9, P32.3, R232.2
unnamed: CN9.10, P32.5, R233.2
unnamed: CN9.11, P32.7, R234.2
unnamed: CN9.12, P32.9, R235.2
unnamed: CN9.13, P32.11, R236.2
unnamed: CN9.14, P32.13, R237.2
unnamed: CN9.15, P32.15, R238.2
unnamed: CN9.16, P32.17, R239.2
unnamed: CN10.2, U4.15
unnamed: CN10.3, U4.14
unnamed: CN11.2, U7.15
unnamed: CN11.3, U7.14
unnamed: CON1.1, D3.2, D5.2, R38.1
unnamed: D3.1, R39.2, U27.3
unnamed: D6.2, Q8.4, R51.2, SW9.5
unnamed: D7.2, Q9.3, R52.2, SW9.2
unnamed: D8.1, D9.1, SW10.3, SW10.4
unnamed: D8.2, Q6.3, Q7.3, R49.2
unnamed: D11.1, R86.1
unnamed: DL1.2, R27.1
unnamed: DL2.2, R28.1
unnamed: DL3.2, R29.1
unnamed: DL4.2, R30.1
unnamed: DL5.1, R32.1
unnamed: DL6.2, R38.2
unnamed: DL7.1, R73.1
unnamed: DL8.2, R93.2
unnamed: DL9.2, R96.1
unnamed: DL10.2, R131.1
unnamed: DL11.1, Q15.3
unnamed: DL11.2, R154.2
unnamed: DL12.1, Q16.3
unnamed: DL12.2, R155.2
unnamed: DL13.2, R169.1
unnamed: DL15.2, R184.2
unnamed: DL16.2, R183.1
unnamed: DL17.1, R33.1
unnamed: DL18.1, R74.1
unnamed: FB3.1, U10.1
unnamed: FB5.1, U19.1
unnamed: L2.1, R164.2, U17.A
unnamed: L3.2, U18.5
unnamed: LAN1.11, R85.1
unnamed: LAN1.12, R250.1
unnamed: LAN1.13, R84.1
unnamed: LAN1.14, R251.1
unnamed: MSD1.5, R75.1, R80.2
unnamed: P1.11, R1.2
unnamed: P1.17, R2.2
unnamed: P6.2, R136.2
unnamed: P6.3, R137.2
unnamed: P6.4, R138.2
unnamed: P6.5, R139.2
unnamed: P6.6, R140.2
unnamed: P8.2, R141.2
unnamed: P8.3, R142.2
unnamed: P9.2, R143.2
unnamed: P9.3, R144.2
unnamed: P10.2, R145.2
unnamed: P10.3, R146.2
unnamed: P10.6, R147.2
unnamed: P10.7, R148.2
unnamed: P11.1, U21.2
unnamed: P12.1, U21.3
unnamed: P13.1, U21.5
unnamed: P14.1, U21.6
unnamed: P15.1, U21.8
unnamed: P16.1, U21.9
unnamed: P17.1, U21.11
unnamed: P18.1, U21.12
unnamed: P19.1, U21.36
unnamed: P20.1, U21.35
unnamed: P21.1, U21.33
unnamed: P22.1, U21.32
unnamed: P23.1, U21.30
unnamed: P24.1, U24.6
unnamed: P25.1, U24.7
unnamed: P26.1, U24.8
unnamed: P27.1, U24.9
unnamed: P28.1, U24.10
unnamed: P29.1, U24.11
unnamed: P30.1, U24.12
unnamed: P31.1, U24.13
unnamed: Q3.1, R39.1, R40.1
unnamed: Q4.3, R43.2
unnamed: Q5.1, R44.1, R45.1
unnamed: Q5.3, R48.2
unnamed: Q6.1, R46.1, R47.1
unnamed: Q10.3, Q11.1
unnamed: Q12.1, R55.1, R56.1
unnamed: Q13.1, R66.1, R68.1
unnamed: Q14.3, R129.2, U15.2
unnamed: Q17.1, R156.1, R157.2
unnamed: R12.1, SW1.3, SW1.4
unnamed: R21.1, SW5.3, SW5.4
unnamed: R31.1, U4.6
unnamed: R31.2, U4.31
unnamed: R32.2, U4.22
unnamed: R33.2, U4.21
unnamed: R36.1, U5.3
unnamed: R37.1, U5.4
unnamed: R43.1, U27.5
unnamed: R48.1, SW9.6
unnamed: R49.1, SW9.3
unnamed: R69.2, U6.1
unnamed: R70.2, U6.6
unnamed: R71.2, U6.5
unnamed: R72.2, U6.2
unnamed: R73.2, U7.22
unnamed: R74.2, U7.21
unnamed: R95.2, U10.4
unnamed: R114.2, U12.16
unnamed: R115.2, U12.15
unnamed: R116.2, U12.14
unnamed: R117.2, U12.12
unnamed: R126.2, U13.3
unnamed: R130.1, R131.2, R132.2, U15.3
unnamed: R135.1, U15.5, U15.6
unnamed: R158.1, U16.28
unnamed: R159.1, U16.3
unnamed: R160.1, U16.4
unnamed: R161.1, U16.19
unnamed: R161.2, U16.18
unnamed: R162.1, R164.1, U16.16
unnamed: R170.2, R171.2, R172.2, U21.1, U21.48
unnamed: R173.2, R174.1, U22.3
unnamed: R175.2, R176.1, U23.3
unnamed: R177.1, U22.6
unnamed: R178.1, U23.6
unnamed: R179.2, R180.1, U22.5
unnamed: R181.2, R182.1, U23.5
unnamed: R186.1, R192.1, U24.5
unnamed: R187.1, R190.1, U24.24
unnamed: R252.2, R253.2, U14.3
unnamed: U13.1, Y1.1
unnamed: U13.2, Y1.2
VH: CN2.P, P41.1, P42.1, P43.1, P44.1, P45.1, P46.1, P47.1, P48.1, Q8.5
Vbak: C58.1, C59.1, C67.2, C97.2, D15.1, R185.1, U13.8, U16.11, U25.C1
