sigmadrone/sigmadrone/source/cortex-m4/sdfirmware/src/_initialize_hardware.c

//
// This file is part of the µOS++ III distribution.
// Copyright (c) 2014 Liviu Ionescu.
//

// ----------------------------------------------------------------------------

#include "stm32f4xx.h"
#include "stm32f4xx_hal.h"
#include "stm32f4xx_hal_cortex.h"
#include "stm32f429i_discovery_sdram.h"

// ----------------------------------------------------------------------------

// The external clock frequency is specified as a preprocessor definition
// passed to the compiler via a command line option (see the 'C/C++ General' ->
// 'Paths and Symbols' -> the 'Symbols' tab, if you want to change it).
// The value selected during project creation was HSE_VALUE=8000000.
//
// The code to set the clock is at the end.
//
// Note1: The default clock settings assume that the HSE_VALUE is a multiple
// of 1MHz, and try to reach the maximum speed available for the
// board. It does NOT guarantee that the required USB clock of 48MHz is
// available. If you need this, please update the settings of PLL_M, PLL_N,
// PLL_P, PLL_Q to match your needs.
//
// Note2: The external memory controllers are not enabled. If needed, you
// have to define DATA_IN_ExtSRAM or DATA_IN_ExtSDRAM and to configure
// the memory banks in system/src/cmsis/system_stm32f4xx.c to match your needs.

// ----------------------------------------------------------------------------

// Forward declarations.

void
__initialize_hardware(void);

void
configure_system_clock(void);

void
__initialize_hardware_early(void)
{
  // Call the CSMSIS system initialisation routine.
  SystemInit();

  // Initialise the HAL Library; it must be the first
  // instruction to be executed in the main program.
  HAL_Init();

  // Warning: The HAL always initialises the system timer.
  // For this to work, the default SysTick_Handler must not hang
  // (see system/src/cortexm/exception_handlers.c)

  // The current version of SystemInit() leaves the value of the clock
  // in a RAM variable (SystemCoreClock), which will be cleared shortly,
  // so it needs to be recomputed after the RAM initialisations
  // are completed.

#if defined(OS_INCLUDE_STARTUP_INIT_FP) || (defined (__VFP_FP__) && !defined (__SOFTFP__))

  // Normally FP init is done by SystemInit(). In case this is not done
  // there, it is possible to force its inclusion by defining
  // OS_INCLUDE_STARTUP_INIT_FP.

  // Enable the Cortex-M4 FPU only when -mfloat-abi=hard.
  // Code taken from Section 7.1, Cortex-M4 TRM (DDI0439C)

  // Set bits 20-23 to enable CP10 and CP11 coprocessor
  SCB->CPACR |= (0xF << 20);

#endif // (__VFP_FP__) && !(__SOFTFP__)

#if defined(OS_DEBUG_SEMIHOSTING_FAULTS)
  SCB->SHCSR |= SCB_SHCSR_USGFAULTENA_Msk;
#endif

  BSP_SDRAM_Init();
}

// ----------------------------------------------------------------------------

// This is the application hardware initialisation routine,
// redefined to add more inits.
//
// Called early from _start(), right after data & bss init, before
// constructors.
//
// After Reset the Cortex-M processor is in Thread mode,
// priority is Privileged, and the Stack is set to Main.

void
__initialize_hardware(void)
{
  // Call the CSMSIS system initialisation routine.
  SystemInit();

#if defined (__VFP_FP__) && !defined (__SOFTFP__)

  // Enable the Cortex-M4 FPU only when -mfloat-abi=hard.
  // Code taken from Section 7.1, Cortex-M4 TRM (DDI0439C)

  // Set bits 20-23 to enable CP10 and CP11 coprocessor
  SCB->CPACR |= (0xF << 20);

#endif // (__VFP_FP__) && !(__SOFTFP__)

  // Enable HSE Oscillator and activate PLL with HSE as source
  configure_system_clock();
}

// This is a sample SysTick handler, use it if you need HAL timings.
void __attribute__ ((section(".after_vectors")))
SysTick_Handler(void)
{
	HAL_IncTick();
}

// ----------------------------------------------------------------------------


/**
  * @brief  System Clock Configuration
  *         The system Clock is configured as follow :
  *            System Clock source            = PLL (HSE)
  *            SYSCLK(Hz)                     = 180000000
  *            HCLK(Hz)                       = 180000000
  *            AHB Prescaler                  = 1
  *            APB1 Prescaler                 = 4
  *            APB2 Prescaler                 = 2
  *            HSE Frequency(Hz)              = 8000000
  *            PLL_M                          = 8
  *            PLL_N                          = 360
  *            PLL_P                          = 2
  *            PLL_Q                          = 7
  *            VDD(V)                         = 3.3
  *            Main regulator output voltage  = Scale1 mode
  *            Flash Latency(WS)              = 5
  * @param  None
  * @retval None
  */
void
configure_system_clock(void)
{
  RCC_ClkInitTypeDef RCC_ClkInitStruct;
  RCC_OscInitTypeDef RCC_OscInitStruct;

  // Enable Power Control clock
  __PWR_CLK_ENABLE();

  // The voltage scaling allows optimizing the power consumption when the
  // device is clocked below the maximum system frequency, to update the
  // voltage scaling value regarding system frequency refer to product
  // datasheet.
  __HAL_PWR_VOLTAGESCALING_CONFIG(PWR_REGULATOR_VOLTAGE_SCALE1);

  // Enable HSE Oscillator and activate PLL with HSE as source
  RCC_OscInitStruct.OscillatorType = RCC_OSCILLATORTYPE_HSE;
  RCC_OscInitStruct.HSEState = RCC_HSE_ON;
  RCC_OscInitStruct.PLL.PLLState = RCC_PLL_ON;
  RCC_OscInitStruct.PLL.PLLSource = RCC_PLLSOURCE_HSE;

  // This assumes the HSE_VALUE is a multiple of 1MHz. If this is not
  // your case, you have to recompute these PLL constants.
  RCC_OscInitStruct.PLL.PLLM = (HSE_VALUE/1000000u);
  RCC_OscInitStruct.PLL.PLLN = 360;
  RCC_OscInitStruct.PLL.PLLP = RCC_PLLP_DIV2;
  RCC_OscInitStruct.PLL.PLLQ = 8;
  HAL_RCC_OscConfig(&RCC_OscInitStruct);

  // Select PLL as system clock source and configure the HCLK, PCLK1 and PCLK2
  // clocks dividers
  RCC_ClkInitStruct.ClockType = (RCC_CLOCKTYPE_SYSCLK | RCC_CLOCKTYPE_HCLK
      | RCC_CLOCKTYPE_PCLK1 | RCC_CLOCKTYPE_PCLK2);
  RCC_ClkInitStruct.SYSCLKSource = RCC_SYSCLKSOURCE_PLLCLK;
  RCC_ClkInitStruct.AHBCLKDivider = RCC_SYSCLK_DIV1;
  RCC_ClkInitStruct.APB1CLKDivider = RCC_HCLK_DIV4;
  RCC_ClkInitStruct.APB2CLKDivider = RCC_HCLK_DIV2;
  HAL_RCC_ClockConfig(&RCC_ClkInitStruct, FLASH_LATENCY_5);
}

// ----------------------------------------------------------------------------
