sigmadrone/sigmadrone/source/sigmad/pidtorque.cpp

/*
 *  Sigmadrone
 *  Copyright (c) 2013-2015 The Sigmadrone Developers
 *
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
 *  Martin Stoilov <martin@sigmadrone.org>
 *  Svetoslav Vassilev <svassilev@sigmadrone.org>
 */
#include <stdio.h>
#include "pidtorque.h"

pidtorque::pidtorque() :
	target_q_(1), old_q_(1)
{
	reset(0.0, 0.0, 0.0);
}

pidtorque::~pidtorque()
{

}

void pidtorque::reset(double Kp, double Ki, double Kd)
{
	Kp_ = Kp;
	Ki_ = Ki;
	Kd_ = Kd;
	integral_error_ = Vector3f();
	error_ = Vector3f();
}

void pidtorque::set_target(const QuaternionF &setQ)
{
	target_q_ = setQ;
}

Vector3f pidtorque::get_xy_torque(const QuaternionF &inQ, const Vector3f& Omega, double dT)
{
	Vector3f torq;
	Vector3f differentialError;
	Vector3f Zset = target_q_.rotate(Vector3f(0.0, 0.0, 1.0));
	Vector3f Zin = (~inQ).rotate(Vector3f(0.0, 0.0, 1.0));
	QuaternionF Qtorq = QuaternionF::fromVectors(Zin, Zset);
	Vector3f error = Qtorq.axis().normalize() * Qtorq.angle() * -1.0;
	double Kp = 1000.0 * Kp_ / 1000.0 * 22.5 / 100.0 / (3.1415/2);
	double Ki = 1000.0 * Ki_ / 1000.0 * 22.5 / 100.0 / (3.1415/2);
	double Kd = 1000.0 * Kd_ / 1000.0 * 22.5 / 100.0 / (3.1415/2);
	double err = error.length();

	integral_error_ = integral_error_ + error * dT;
	integral_error_ = integral_error_ - integral_error_ * 0.000001;
	if (integral_error_.length() * Ki > 30.0/1000.0)
		integral_error_ = integral_error_ * 0.85;
	differentialError = (error - error_)/dT;
	torq = error.normalize() * pow(err, 1.00) * Kp +
			differentialError * Kd +
			integral_error_.normalize() * pow(integral_error_.length(), 1.3) * Ki * 0.0;
	error_ = error;
	return torq;
}

Vector3f pidtorque::get_z_torque(const QuaternionF &inQ, const Vector3f& Omega, double dT)
{
	Vector3f torq;
	Vector3f differentialError;
	Vector3f Zset = target_q_.rotate(Vector3f(0.0, 0.0, 1.0));
	Vector3f Zin = (~inQ).rotate(Vector3f(0.0, 0.0, 1.0));
	QuaternionF Qtorq = QuaternionF::fromVectors(Zin, Zset);
	Vector3f error = Qtorq.axis().normalize() * Qtorq.angle() * -1.0;
	double Kp = 50.0 / 1000.0  * Kp_ * 22.5 / 100.0 / (3.1415/2);
	double Ki = 50.0 / 1000.0  * Ki_ * 22.5 / 100.0 / (3.1415/2);
	double Kd = 50.0 / 1000.0  * Kd_ * 22.5 / 100.0 / (3.1415/2);
	double err = error.length();

	integral_error_ = integral_error_ + error * dT;
	integral_error_ = integral_error_ - integral_error_ * 0.000001;
	if (integral_error_.length() * Ki > 30.0/1000.0)
		integral_error_ = integral_error_ * 0.85;
	if (dT > 0.0001)
		differentialError = (error - error_)/dT;
	torq = error.normalize() * pow(err, 1.00) * Kp +
			differentialError * Kd +
			integral_error_.normalize() * pow(integral_error_.length(), 1.3) * Ki * 0.0;
	error_ = error;
	return torq;
}
