sigmadrone/sigmadrone/source/cortex-m4/sdfirmware/src/uartrpcserver.cpp

/*
 *  Sigmadrone
 *  Copyright (c) 2013-2015 The Sigmadrone Developers
 *
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
 *  Martin Stoilov <martin@sigmadrone.org>
 *  Svetoslav Vassilev <svassilev@sigmadrone.org>
 */
#include <memory>
#include "trimstr.h"
#include "uartrpcserver.h"
#include "librexjsonrpc/jsonserialization.h"
#include "magcalibrator.h"


UartRpcServer::UartRpcServer(DroneState& dronestate, FlashMemory& configdata, MagCalibrator& mag_calibrator)
	: rpc_server<UartRpcServer, UART*>()
	, dronestate_(dronestate)
	, configdata_(configdata)
	, mag_calibrator_(mag_calibrator)
{
	add("sd_get_altitude", &UartRpcServer::rpc_get_altitude);
	add("sd_get_attitude", &UartRpcServer::rpc_get_attitude);
	add("sd_get_pressure", &UartRpcServer::rpc_get_pressure);
	add("sd_get_temperature", &UartRpcServer::rpc_get_temperature);
	add("sd_get_motors", &UartRpcServer::rpc_get_motors);
	add("sd_get_dronestate", &UartRpcServer::rpc_get_dronestate);
	add("sd_get_dronestate_ex", &UartRpcServer::rpc_get_dronestate_ex);
	add("ki", &UartRpcServer::rpc_ki);
	add("kd", &UartRpcServer::rpc_kd);
	add("kp", &UartRpcServer::rpc_kp);
	add("yaw_ki", &UartRpcServer::rpc_yaw_ki);
	add("yaw_kd", &UartRpcServer::rpc_yaw_kd);
	add("yaw_kp", &UartRpcServer::rpc_yaw_kp);
	add("yaw_bias", &UartRpcServer::rpc_yaw_bias);
	add("pitch_bias", &UartRpcServer::rpc_pitch_bias);
	add("roll_bias", &UartRpcServer::rpc_roll_bias);
	add("sd_set_accelerometer_correction_period", &UartRpcServer::rpc_set_accelerometer_correction_period);
	add("sd_set_gyro_factor", &UartRpcServer::rpc_set_gyro_factor);
	add("sd_set_yaw_throttle_factor", &UartRpcServer::rpc_set_yaw_throttle_factor);
	add("sd_get_configdata", &UartRpcServer::rpc_get_configdata);
	add("sd_set_configdata", &UartRpcServer::rpc_set_configdata);
	add("sd_save_bootconfigdata_to_flash", &UartRpcServer::rpc_save_bootconfigdata_to_flash);
	add("sd_accelerometer_adjustment", &UartRpcServer::rpc_accelerometer_adjustment);
	add("sd_flight_ceiling", &UartRpcServer::rpc_flight_ceiling);
	add("sd_restore_config", &UartRpcServer::rpc_restore_config);
	add("sd_pid_filter_freq", &UartRpcServer::rpc_pid_filter_freq);
	add("sd_set_mag_tracking", &UartRpcServer::rpc_set_mag_tracking);
	add("sd_set_acc_tracking", &UartRpcServer::rpc_set_acc_tracking);
	add("sd_set_pilot_type", &UartRpcServer::rpc_set_pilot_type);
	add("sd_gyro_drift_kp", &UartRpcServer::rpc_gyro_drift_kp);
	add("sd_gyro_drift_ki", &UartRpcServer::rpc_gyro_drift_ki);
	add("sd_gyro_drift_kd", &UartRpcServer::rpc_gyro_drift_kd);
	add("sd_gyro_drift_leak_rate", &UartRpcServer::rpc_gyro_drift_leak_rate);
	add("sd_enable_external_gyro", &UartRpcServer::rpc_enable_external_gyro);
	add("sd_external_gyro_align", &UartRpcServer::rpc_external_gyro_align);
	add("sd_altitude_kp", &UartRpcServer::rpc_altitude_kp);
	add("sd_altitude_ki", &UartRpcServer::rpc_altitude_ki);
	add("sd_altitude_kd", &UartRpcServer::rpc_altitude_kd);
	add("sd_altitude_ki_leak", &UartRpcServer::rpc_altitude_ki_leak);
	add("sd_flight_mode", &UartRpcServer::rpc_flight_mode);
	add("sd_altitude_tracker_kp_ki_kd", &UartRpcServer::rpc_altitude_tracker_kp_ki_kd);
	add("sd_altitude_tracker_kp2", &UartRpcServer::rpc_altitude_tracker_kp2);
	add("sd_altitude_correction_period", &UartRpcServer::rpc_altitude_correction_period);
	add("sd_altitude_filter", &UartRpcServer::rpc_altitude_filter);
	add("sd_calibrate_mag", &UartRpcServer::rpc_calibrate_mag);
	add("sd_position_kp", &UartRpcServer::rpc_position_kp);
	add("sd_position_ki", &UartRpcServer::rpc_position_ki);
	add("sd_position_kd", &UartRpcServer::rpc_position_kd);
}

UartRpcServer::~UartRpcServer()
{

}

rexjson::value UartRpcServer::rpc_get_attitude(UART* , rexjson::array& params, rpc_exec_mode mode)
{
	static unsigned int types[] = {rpc_null_type};
	if (mode != execute) {
		if (mode == spec)
			return create_json_spec(types, ARRAYSIZE(types));
		if (mode == helpspec)
			return create_json_helpspec(types, ARRAYSIZE(types));
		return
	            "sd_get_attitude\n"
	            "\nGet the current attitude Quaternion."
				"\n"
				"Arguments:\n"
				;
	}
	verify_parameters(params, types, ARRAYSIZE(types));
	return quaternion_to_json_value(dronestate_.attitude_);
}

rexjson::value UartRpcServer::rpc_get_pressure(UART* , rexjson::array& params, rpc_exec_mode mode)
{
	static unsigned int types[] = {rpc_null_type};
	if (mode != execute) {
		if (mode == spec)
			return create_json_spec(types, ARRAYSIZE(types));
		if (mode == helpspec)
			return create_json_helpspec(types, ARRAYSIZE(types));
		return
	            "sd_get_pressure\n"
	            "\nGet the current pressure in hPa."
				"\n"
				"Arguments:\n"
				;
	}
	verify_parameters(params, types, ARRAYSIZE(types));
	return dronestate_.pressure_hpa_;
}

rexjson::value UartRpcServer::rpc_get_altitude(UART* , rexjson::array& params, rpc_exec_mode mode)
{
	static unsigned int types[] = {rpc_null_type};
	if (mode != execute) {
		if (mode == spec)
			return create_json_spec(types, ARRAYSIZE(types));
		if (mode == helpspec)
			return create_json_helpspec(types, ARRAYSIZE(types));
		return
	            "sd_get_altitude\n"
	            "\nGet the current altitude in meters."
				"\n"
				"Arguments:\n"
				;
	}
	verify_parameters(params, types, ARRAYSIZE(types));
	return dronestate_.altitude_.meters();
}

rexjson::value UartRpcServer::rpc_get_temperature(UART* , rexjson::array& params, rpc_exec_mode mode)
{
	static unsigned int types[] = {rpc_null_type};
	if (mode != execute) {
		if (mode == spec)
			return create_json_spec(types, ARRAYSIZE(types));
		if (mode == helpspec)
			return create_json_helpspec(types, ARRAYSIZE(types));
		return
	            "sd_get_temperature\n"
	            "\nGet the current temperature in Celsius."
				"\n"
				"Arguments:\n"
				;
	}
	verify_parameters(params, types, ARRAYSIZE(types));
	return dronestate_.temperature_;
}

rexjson::value UartRpcServer::rpc_get_motors(UART* , rexjson::array& params, rpc_exec_mode mode)
{
	static unsigned int types[] = {rpc_null_type};
	if (mode != execute) {
		if (mode == spec)
			return create_json_spec(types, ARRAYSIZE(types));
		if (mode == helpspec)
			return create_json_helpspec(types, ARRAYSIZE(types));
		return
	            "sd_get_motors\n"
	            "\nGet motors state."
				"\n"
				"Arguments:\n"
				;
	}
	verify_parameters(params, types, ARRAYSIZE(types));
	rexjson::array ret;
	for (size_t i = 0; i < 4; i++) {
		ret.push_back(dronestate_.motors_.at(i));
	}
	return ret;
}

rexjson::value UartRpcServer::rpc_accelerometer_adjustment(UART* , rexjson::array& params, rpc_exec_mode mode)
{
	static unsigned int types[] = {rpc_array_type|rpc_null_type};
	if (mode != execute) {
		if (mode == spec)
			return create_json_spec(types, ARRAYSIZE(types));
		if (mode == helpspec)
			return create_json_helpspec(types, ARRAYSIZE(types));
		return
	            "sd_accelerometer_adjustment\n"
	            "\nGet/Set accelerometer adjustment values"
				"\nIf no parameters are specified, the current accelerometer_adjustment will be returned."
				"\n"
				"Arguments:\n"
				"1. accelerometer_adjustment          (array, optional) Array of adjustment values for X,Y,Z\n"
				"   to be added to the current reading of the accelerometer sensor."
				;
	}
	verify_parameters(params, types, ARRAYSIZE(types));
	if ((params[0].type() == rexjson::array_type))
		dronestate_.accelerometer_adjustment_ = matrix_from_json_value<float, 3, 1>(params[0]);
	return matrix_to_json_value(dronestate_.accelerometer_adjustment_);
}


rexjson::value UartRpcServer::rpc_kp(UART* , rexjson::array& params, rpc_exec_mode mode)
{
	static unsigned int types[] = {rpc_real_type|rpc_int_type|rpc_null_type};
	if (mode != execute) {
		if (mode == spec)
			return create_json_spec(types, ARRAYSIZE(types));
		if (mode == helpspec)
			return create_json_helpspec(types, ARRAYSIZE(types));
		return
	            "kp\n"
	            "\nGet/Set Kp."
				"\nIf the new coefficient is not specified, the current Kp will be returned."
				"\n"
				"Arguments:\n"
				"1. Kp          (real, optional) The Kp of the PID controller.\n"
				;
	}
	verify_parameters(params, types, ARRAYSIZE(types));
	if ((params[0].type() != rexjson::null_type))
		dronestate_.kp_ = params[0].get_real();
	return dronestate_.kp_;
}

rexjson::value UartRpcServer::rpc_kd(UART* , rexjson::array& params, rpc_exec_mode mode)
{
	static unsigned int types[] = {rpc_real_type|rpc_int_type|rpc_null_type};
	if (mode != execute) {
		if (mode == spec)
			return create_json_spec(types, ARRAYSIZE(types));
		if (mode == helpspec)
			return create_json_helpspec(types, ARRAYSIZE(types));
		return
	            "kd\n"
	            "\nGet/Set Kd."
				"\nIf the new coefficient is not specified, the current Kd will be returned."
				"\n"
				"Arguments:\n"
				"1. Kd          (real, optional) The Kd of the PID controller.\n"
				;
	}
	verify_parameters(params, types, ARRAYSIZE(types));
	if ((params[0].type() != rexjson::null_type))
		dronestate_.kd_ = params[0].get_real();
	return dronestate_.kd_;
}

rexjson::value UartRpcServer::rpc_ki(UART* , rexjson::array& params, rpc_exec_mode mode)
{
	static unsigned int types[] = {rpc_real_type|rpc_int_type|rpc_null_type};
	if (mode != execute) {
		if (mode == spec)
			return create_json_spec(types, ARRAYSIZE(types));
		if (mode == helpspec)
			return create_json_helpspec(types, ARRAYSIZE(types));
		return
	            "ki\n"
	            "\nGet/Set Ki."
				"\nIf the new coefficient is not specified, the current Ki will be returned."
				"\n"
				"Arguments:\n"
				"1. Ki          (real, optional) The Ki of the PID controller.\n"
				;
	}
	verify_parameters(params, types, ARRAYSIZE(types));
	if ((params[0].type() != rexjson::null_type))
		dronestate_.ki_ = params[0].get_real();
	return dronestate_.ki_;
}


rexjson::value UartRpcServer::rpc_yaw_kp(UART* , rexjson::array& params, rpc_exec_mode mode)
{
	static unsigned int types[] = {rpc_real_type|rpc_int_type|rpc_null_type};
	if (mode != execute) {
		if (mode == spec)
			return create_json_spec(types, ARRAYSIZE(types));
		if (mode == helpspec)
			return create_json_helpspec(types, ARRAYSIZE(types));
		return
	            "yaw_kp\n"
	            "\nGet/Set yaw_kp."
				"\nIf the new coefficient is not specified, the current yaw_kp will be returned."
				"\n"
				"Arguments:\n"
				"1. yaw_kp          (real, optional) The yaw_kp of the PID controller.\n"
				;
	}
	verify_parameters(params, types, ARRAYSIZE(types));
	if ((params[0].type() != rexjson::null_type))
		dronestate_.yaw_kp_ = params[0].get_real();
	return dronestate_.yaw_kp_;
}

rexjson::value UartRpcServer::rpc_yaw_kd(UART* , rexjson::array& params, rpc_exec_mode mode)
{
	static unsigned int types[] = {rpc_real_type|rpc_int_type|rpc_null_type};
	if (mode != execute) {
		if (mode == spec)
			return create_json_spec(types, ARRAYSIZE(types));
		if (mode == helpspec)
			return create_json_helpspec(types, ARRAYSIZE(types));
		return
	            "yaw_kd\n"
	            "\nGet/Set yaw_kd."
				"\nIf the new coefficient is not specified, the current yaw_kd will be returned."
				"\n"
				"Arguments:\n"
				"1. yaw_kd          (real, optional) The yaw_kd of the PID controller.\n"
				;
	}
	verify_parameters(params, types, ARRAYSIZE(types));
	if ((params[0].type() != rexjson::null_type))
		dronestate_.yaw_kd_ = params[0].get_real();
	return dronestate_.yaw_kd_;
}

rexjson::value UartRpcServer::rpc_yaw_ki(UART* , rexjson::array& params, rpc_exec_mode mode)
{
	static unsigned int types[] = {rpc_real_type|rpc_int_type|rpc_null_type};
	if (mode != execute) {
		if (mode == spec)
			return create_json_spec(types, ARRAYSIZE(types));
		if (mode == helpspec)
			return create_json_helpspec(types, ARRAYSIZE(types));
		return
	            "yaw_ki\n"
	            "\nGet/Set yaw_ki."
				"\nIf the new coefficient is not specified, the current yaw_ki will be returned."
				"\n"
				"Arguments:\n"
				"1. yaw_ki          (real, optional) The yaw_ki of the PID controller.\n"
				;
	}
	verify_parameters(params, types, ARRAYSIZE(types));
	if ((params[0].type() != rexjson::null_type))
		dronestate_.yaw_ki_ = params[0].get_real();
	return dronestate_.yaw_ki_;
}

rexjson::value UartRpcServer::rpc_yaw_bias(UART* , rexjson::array& params, rpc_exec_mode mode)
{
	static unsigned int types[] = {rpc_real_type|rpc_int_type|rpc_null_type};
	if (mode != execute) {
		if (mode == spec)
			return create_json_spec(types, ARRAYSIZE(types));
		if (mode == helpspec)
			return create_json_helpspec(types, ARRAYSIZE(types));
		return
	            "yaw_bias\n"
	            "\nGet/Set yaw_bias."
				"\nIf the new coefficient is not specified, the current yaw_bias will be returned."
				"\n"
				"Arguments:\n"
				"1. yaw_bias          (real, optional) The new yaw_bias.\n"
				;
	}
	verify_parameters(params, types, ARRAYSIZE(types));
	if ((params[0].type() != rexjson::null_type)) {
		float value = params[0].get_real();
		if (value > 0.1 || value < -0.1)
			throw std::range_error("Invalid yaw_bias value");
		dronestate_.yaw_bias_ = value;
	}
	return dronestate_.yaw_bias_;
}

rexjson::value UartRpcServer::rpc_pitch_bias(UART* , rexjson::array& params, rpc_exec_mode mode)
{
	static unsigned int types[] = {rpc_real_type|rpc_int_type|rpc_null_type};
	if (mode != execute) {
		if (mode == spec)
			return create_json_spec(types, ARRAYSIZE(types));
		if (mode == helpspec)
			return create_json_helpspec(types, ARRAYSIZE(types));
		return
	            "pitch_bias\n"
	            "\nGet/Set pitch_bias."
				"\nIf the new coefficient is not specified, the current pitch_bias will be returned."
				"\n"
				"Arguments:\n"
				"1. pitch_bias          (real, optional) The new pitch_bias.\n"
				;
	}
	verify_parameters(params, types, ARRAYSIZE(types));
	if ((params[0].type() != rexjson::null_type)) {
		float value = params[0].get_real();
		if (value > 0.1 || value < -0.1)
			throw std::range_error("Invalid pitch_bias value");
		dronestate_.pitch_bias_ = value;
	}
	return dronestate_.pitch_bias_;
}

rexjson::value UartRpcServer::rpc_roll_bias(UART* , rexjson::array& params, rpc_exec_mode mode)
{
	static unsigned int types[] = {rpc_real_type|rpc_int_type|rpc_null_type};
	if (mode != execute) {
		if (mode == spec)
			return create_json_spec(types, ARRAYSIZE(types));
		if (mode == helpspec)
			return create_json_helpspec(types, ARRAYSIZE(types));
		return
	            "roll_bias\n"
	            "\nGet/Set roll_bias."
				"\nIf the new coefficient is not specified, the current roll_bias will be returned."
				"\n"
				"Arguments:\n"
				"1. roll_bias          (real, optional) The new roll_bias.\n"
				;
	}
	verify_parameters(params, types, ARRAYSIZE(types));
	if ((params[0].type() != rexjson::null_type)) {
		float value = params[0].get_real();
		if (value > 0.1 || value < -0.1)
			throw std::range_error("Invalid roll_bias value");
		dronestate_.roll_bias_ = value;
	}
	return dronestate_.roll_bias_;
}

rexjson::value UartRpcServer::rpc_flight_ceiling(UART*, rexjson::array& params, rpc_exec_mode mode)
{
	static unsigned int types[] = {rpc_real_type|rpc_int_type|rpc_null_type};
	if (mode != execute) {
		if (mode == spec)
			return create_json_spec(types, ARRAYSIZE(types));
		if (mode == helpspec)
			return create_json_helpspec(types, ARRAYSIZE(types));
		return
				"sd_flight_ceiling\n"
				"\nGet/Set flight ceiling, which is relative to the lift-off altitude."
				"\nIf the new ceiling is not specified, then the current one is returned."
				"\n"
				"Arguments:\n"
				"1. flight_ceiling   (real, optional) The new flight ceiling in meters.\n"
				;
	}
	verify_parameters(params, types, ARRAYSIZE(types));
	if ((params[0].type() != rexjson::null_type)) {
		dronestate_.flight_ceiling_ = Altitude::from_meters(params[0].get_real());
	}
	return dronestate_.flight_ceiling_.meters();
}

rexjson::value UartRpcServer::rpc_flight_mode(UART*, rexjson::array& params, rpc_exec_mode mode)
{
	static unsigned int types[] = {rpc_int_type|rpc_null_type};
	if (mode != execute) {
		if (mode == spec)
			return create_json_spec(types, ARRAYSIZE(types));
		if (mode == helpspec)
			return create_json_helpspec(types, ARRAYSIZE(types));
		return
				"sd_flight_mode\n"
				"\nGet/Set new flight mode, where:"
				"\n    0 - auto level (default)"
				"\n    1 - auto level and altitude hold"
				"\n    2 - loiter"
				"\n    3 - mission"
				"\nIf the new flight mode is not specified, then the current one is returned."
				"\n"
				"Arguments:\n"
				"1. flight_mode   (int, optional) The new flight mode.\n"
				;
	}
	verify_parameters(params, types, ARRAYSIZE(types));
	if ((params[0].type() != rexjson::null_type)) {
		dronestate_.flight_mode_ = params[0].get_int() <= FLIGHT_MODE_LAST ?
				static_cast<FlightMode>(params[0].get_int()) : FLIGHT_MODE_AUTO_LEVEL;
	}
	return dronestate_.flight_mode_;
}

rexjson::value UartRpcServer::rpc_restore_config(UART*, rexjson::array& params, rpc_exec_mode mode)
{
	static unsigned int types[] = {rpc_null_type};
	if (mode != execute) {
		if (mode == spec)
			return create_json_spec(types, ARRAYSIZE(types));
		if (mode == helpspec)
			return create_json_helpspec(types, ARRAYSIZE(types));
		return
				"sd_restore_config\n"
				"\nRestores the factory default configuration data."
				"\nPreviously stored configuration will be erased"
				"\nArguments:\n";
	}
	verify_parameters(params, types, ARRAYSIZE(types));
	dronestate_ = DroneState();
	std::string default_config = dronestate_.boot_config_to_json().write(false, true, 0, 8);
	configdata_.program((void*)default_config.c_str(), default_config.size());
	return default_config;
}

rexjson::value UartRpcServer::rpc_set_accelerometer_correction_period(UART* , rexjson::array& params, rpc_exec_mode mode)
{
	static unsigned int types[] = {rpc_real_type|rpc_int_type};
	if (mode != execute) {
		if (mode == spec)
			return create_json_spec(types, ARRAYSIZE(types));
		if (mode == helpspec)
			return create_json_helpspec(types, ARRAYSIZE(types));
		return
	            "sd_set_accelerometer_correction_period\n"
				"\nSet the correction period for the accelerometer."
				"\nThe attitude tracker will try to correct the attitude error for the"
				"\nspecified period. Shorter period means the error will be corrected"
				"\nfaster, but this will introduce noise from the accelerometer sensor."
				"\nLonger periods will suppress the noise, but it will take longer time"
				"\nto correct the error."
				"\n"
				"Arguments:\n"
				"1. n          (real) correction period\n"
				;
	}
	verify_parameters(params, types, ARRAYSIZE(types));
	float period = params[0].get_real();
	if (period < 0.01)
		throw std::range_error("Invalid value");
	dronestate_.accelerometer_correction_speed_ = period;
	return dronestate_.accelerometer_correction_speed_;
}

rexjson::value UartRpcServer::rpc_set_gyro_factor(UART* , rexjson::array& params, rpc_exec_mode mode)
{
	static unsigned int types[] = {rpc_real_type|rpc_int_type};
	if (mode != execute) {
		if (mode == spec)
			return create_json_spec(types, ARRAYSIZE(types));
		if (mode == helpspec)
			return create_json_helpspec(types, ARRAYSIZE(types));
		return
	            "sd_set_gyro_factor\n"
				"\nSet the correction factor for the gyro sensor."
				"\n"
				"Arguments:\n"
				"1. n          (real) gyro factor\n"
				;
	}
	verify_parameters(params, types, ARRAYSIZE(types));
	float factor = params[0].get_real();
	if (factor < 0.25 || factor > 2.0)
		throw std::range_error("Invalid value");
	dronestate_.gyro_factor_ = factor;
	return dronestate_.gyro_factor_;
}

rexjson::value UartRpcServer::rpc_set_mag_tracking(UART* , rexjson::array& params, rpc_exec_mode mode)
{
	static unsigned int types[] = {rpc_bool_type};
	if (mode != execute) {
		if (mode == spec)
			return create_json_spec(types, ARRAYSIZE(types));
		if (mode == helpspec)
			return create_json_helpspec(types, ARRAYSIZE(types));
		return
	            "sd_set_mag_tracking\n"
				"\nSet Turn on/off magnetometer tracking."
				"\n"
				"Arguments:\n"
				"1. on          (bool) On/Off\n"
				;
	}
	verify_parameters(params, types, ARRAYSIZE(types));
	bool on = params[0].get_bool();
	dronestate_.track_magnetometer_ = on;
	return dronestate_.track_magnetometer_;
}

rexjson::value UartRpcServer::rpc_set_acc_tracking(UART* , rexjson::array& params, rpc_exec_mode mode)
{
	static unsigned int types[] = {rpc_bool_type};
	if (mode != execute) {
		if (mode == spec)
			return create_json_spec(types, ARRAYSIZE(types));
		if (mode == helpspec)
			return create_json_helpspec(types, ARRAYSIZE(types));
		return
	            "sd_set_acc_tracking\n"
				"\nDANGEROUS!!! Set Turn on/off Accelerometer tracking."
				"\nThe accelerometer should not be turned off for "
				"more than a few seconds."
				"\n"
				"Arguments:\n"
				"1. on          (bool) On/Off\n"
				;
	}
	verify_parameters(params, types, ARRAYSIZE(types));
	bool on = params[0].get_bool();
	dronestate_.track_accelerometer_ = on;
	return dronestate_.track_accelerometer_;
}

rexjson::value UartRpcServer::rpc_set_pilot_type(UART* , rexjson::array& params, rpc_exec_mode mode)
{
	static unsigned int types[] = {rpc_str_type};
	if (mode != execute) {
		if (mode == spec)
			return create_json_spec(types, ARRAYSIZE(types));
		if (mode == helpspec)
			return create_json_helpspec(types, ARRAYSIZE(types));
		return
	            "sd_set_pilot_type\n"
				"\nSet the active pilot type. Don't do it during flight!\n"
				"Arguments:\n"
				"1. pilot_type          (string) pid_pilot_legacy | pid_pilot_new\n"
				;
	}
	verify_parameters(params, types, ARRAYSIZE(types));
	const std::string& pilot_type = params[0].get_str();
	dronestate_.set_pilot_type(PilotTypeFromStr(pilot_type));
	return pilot_type;
}


rexjson::value UartRpcServer::rpc_set_yaw_throttle_factor(UART* , rexjson::array& params, rpc_exec_mode mode)
{
	static unsigned int types[] = {rpc_real_type|rpc_int_type};
	if (mode != execute) {
		if (mode == spec)
			return create_json_spec(types, ARRAYSIZE(types));
		if (mode == helpspec)
			return create_json_helpspec(types, ARRAYSIZE(types));
		return
	            "sd_set_yaw_throttle_factor\n"
				"\nSet the maximum percentage modification that can be"
				"applied to the current throttle to generate yaw torque."
				"\n"
				"Arguments:\n"
				"1. n          (real) maximum percentage modification of the throttle\n"
				;
	}
	verify_parameters(params, types, ARRAYSIZE(types));
	float factor = params[0].get_real();
	if (factor > 0.90 || factor < 0)
		throw std::range_error("Invalid value");
	dronestate_.yaw_throttle_factor_ = factor;
	return dronestate_.yaw_throttle_factor_;
}


rexjson::value UartRpcServer::rpc_get_dronestate(UART* , rexjson::array& params, rpc_exec_mode mode)
{
	static unsigned int types[] = {rpc_null_type};
	if (mode != execute) {
		if (mode == spec)
			return create_json_spec(types, ARRAYSIZE(types));
		if (mode == helpspec)
			return create_json_helpspec(types, ARRAYSIZE(types));
		return
	            "sd_get_dronestate\n"
	            "\nGet the current drone state."
				"\n"
				"Arguments:\n"
				;
	}
	verify_parameters(params, types, ARRAYSIZE(types));
	return dronestate_.to_json();
}

rexjson::value UartRpcServer::rpc_get_dronestate_ex(UART* , rexjson::array& params, rpc_exec_mode mode)
{
	static unsigned int types[] = {rpc_null_type};
	if (mode != execute) {
		if (mode == spec)
			return create_json_spec(types, ARRAYSIZE(types));
		if (mode == helpspec)
			return create_json_helpspec(types, ARRAYSIZE(types));
		return
	            "sd_get_dronestate_ex\n"
	            "\nGet the extended drone state."
				"\n"
				"Arguments:\n"
				;
	}
	verify_parameters(params, types, ARRAYSIZE(types));
	return dronestate_.to_json_ex();
}

rexjson::value UartRpcServer::rpc_get_configdata(UART* , rexjson::array& params, rpc_exec_mode mode)
{
	static unsigned int types[] = {rpc_null_type};
	if (mode != execute) {
		if (mode == spec)
			return create_json_spec(types, ARRAYSIZE(types));
		if (mode == helpspec)
			return create_json_helpspec(types, ARRAYSIZE(types));
		return
	            "sd_get_configdata\n"
	            "\nGet the current boot time firmware configuration data."
				"\n"
				"Arguments:\n"
				;
	}
	verify_parameters(params, types, ARRAYSIZE(types));
	rexjson::value v;
	v.read((char*)configdata_.mem_, configdata_.size());
	std::string ret = v.write(false, true, 0, 8);
	return ret;
}

rexjson::value UartRpcServer::rpc_set_configdata(UART* , rexjson::array& params, rpc_exec_mode mode)
{
	static unsigned int types[] = {rpc_obj_type};
	if (mode != execute) {
		if (mode == spec)
			return create_json_spec(types, ARRAYSIZE(types));
		if (mode == helpspec)
			return create_json_helpspec(types, ARRAYSIZE(types));
		return
	            "sd_set_configdata\n"
	            "\nSaves the passed configuration data to flash memory. Upon reboot the firmware will "
	            "\nread the flash memory and initialize its configurable parameters with the content of"
	            "\nthe data received by this call."
				"\nWARNING: this RPC call overwrites any previously saved configuration in the flash, "
				"\nso tread lightly and make sure the passed data is properly formatted JSON and"
				"\ncontains values parse-able by sdfirmware (see sd_get_configdata)!"
				"\n"
				"Arguments:\n"
				"1. Boot time firmware configuration data"
				;
	}
	verify_parameters(params, types, ARRAYSIZE(types));
	std::string configstr = params[0].write(false, true, 0, 8);
	configdata_.program((void*)configstr.c_str(), configstr.size());
	return configstr;
}

rexjson::value UartRpcServer::rpc_save_bootconfigdata_to_flash(UART* , rexjson::array& params, rpc_exec_mode mode)
{
	static unsigned int types[] = {rpc_null_type};
	if (mode != execute) {
		if (mode == spec)
			return create_json_spec(types, ARRAYSIZE(types));
		if (mode == helpspec)
			return create_json_helpspec(types, ARRAYSIZE(types));
		return
	            "sd_save_bootconfigdata_to_flash\n"
	            "\nSaves the currently configured data to flash memory."
				"\nReturns the currently saved data."
				"\n"
				"Arguments:\n"
				;
	}
	verify_parameters(params, types, ARRAYSIZE(types));
	rexjson::value v = dronestate_.boot_config_to_json();
	std::string configstr = v.write(false, true, 0, 8);
	configdata_.program((void*)configstr.c_str(), configstr.size());
	return v;
}


rexjson::value UartRpcServer::rpc_pid_filter_freq(UART* , rexjson::array& params, rpc_exec_mode mode)
{
	static unsigned int types[] = {rpc_real_type|rpc_int_type|rpc_null_type};
	if (mode != execute) {
		if (mode == spec)
			return create_json_spec(types, ARRAYSIZE(types));
		if (mode == helpspec)
			return create_json_helpspec(types, ARRAYSIZE(types));
		return
	            "sd_pid_filter_freq\n"
	            "\nGet/Set the cutoff frequency (Hz) of the first order low pass filter applied."
	            "\nto the derivative component of the PID controller."
				"\nIf no parameter is passed, then the currently set frequency will be returned."
				"\n"
				"Arguments:\n"
				"1. frequency        (real, optional) New cutoff frequency, 0 - disables the filter.\n"
				;
	}
	verify_parameters(params, types, ARRAYSIZE(types));
	if ((params[0].type() != rexjson::null_type))
		dronestate_.pid_filter_freq_ = params[0].get_real();
	return dronestate_.pid_filter_freq_;
}

rexjson::value UartRpcServer::rpc_gyro_drift_kp(UART* , rexjson::array& params, rpc_exec_mode mode)
{
	static unsigned int types[] = {rpc_real_type|rpc_int_type|rpc_null_type};
	if (mode != execute) {
		if (mode == spec)
			return create_json_spec(types, ARRAYSIZE(types));
		if (mode == helpspec)
			return create_json_helpspec(types, ARRAYSIZE(types));
		return
	            "sd_gyro_drift_kp\n"
	            "\nGet/Set Kp for the gyro-drift error PID controller."
				"\nIf the new coefficient is not specified, the current Kp will be returned."
				"\n"
				"Arguments:\n"
				"1. Kp          (real, optional) The Kp of the PID controller.\n"
				;
	}
	verify_parameters(params, types, ARRAYSIZE(types));
	if (params[0].type() != rexjson::null_type) {
		dronestate_.gyro_drift_kp_ = params[0].get_real();
	}
	return dronestate_.gyro_drift_kp_;
}

rexjson::value UartRpcServer::rpc_gyro_drift_ki(UART* , rexjson::array& params, rpc_exec_mode mode)
{
	static unsigned int types[] = {rpc_real_type|rpc_int_type|rpc_null_type};
	if (mode != execute) {
		if (mode == spec)
			return create_json_spec(types, ARRAYSIZE(types));
		if (mode == helpspec)
			return create_json_helpspec(types, ARRAYSIZE(types));
		return
	            "sd_gyro_drift_ki\n"
	            "\nGet/Set Ki for the gyro-drift error PID controller."
				"\nIf the new coefficient is not specified, the current Ki will be returned."
				"\n"
				"Arguments:\n"
				"1. Ki          (real, optional) The Ki of the PID controller.\n"
				;
	}
	verify_parameters(params, types, ARRAYSIZE(types));
	if (params[0].type() != rexjson::null_type) {
		dronestate_.gyro_drift_ki_ = params[0].get_real();
	}
	return dronestate_.gyro_drift_ki_;
}

rexjson::value UartRpcServer::rpc_gyro_drift_kd(UART* , rexjson::array& params, rpc_exec_mode mode)
{
	static unsigned int types[] = {rpc_real_type|rpc_int_type|rpc_null_type};
	if (mode != execute) {
		if (mode == spec)
			return create_json_spec(types, ARRAYSIZE(types));
		if (mode == helpspec)
			return create_json_helpspec(types, ARRAYSIZE(types));
		return
	            "sd_gyro_drift_kd\n"
	            "\nGet/Set Kd for the gyro-drift error PID controller."
				"\nIf the new coefficient is not specified, the current Kd will be returned."
				"\n"
				"Arguments:\n"
				"1. Kd          (real, optional) The Kd of the PID controller.\n"
				;
	}
	verify_parameters(params, types, ARRAYSIZE(types));
	if (params[0].type() != rexjson::null_type) {
		dronestate_.gyro_drift_kd_ = params[0].get_real();
	}
	return dronestate_.gyro_drift_kd_;
}

rexjson::value UartRpcServer::rpc_altitude_kp(UART* , rexjson::array& params, rpc_exec_mode mode)
{
	static unsigned int types[] = {rpc_real_type|rpc_int_type|rpc_null_type};
	if (mode != execute) {
		if (mode == spec)
			return create_json_spec(types, ARRAYSIZE(types));
		if (mode == helpspec)
			return create_json_helpspec(types, ARRAYSIZE(types));
		return
	            "sd_altitude_kp\n"
	            "\nGet/Set Kp for the altitude PID controller."
				"\nIf the new coefficient is not specified, the current Kp will be returned."
				"\n"
				"Arguments:\n"
				"1. Kp          (real, optional) The Kp of the PID controller.\n"
				;
	}
	verify_parameters(params, types, ARRAYSIZE(types));
	if (params[0].type() != rexjson::null_type) {
		dronestate_.altitude_kp_ = params[0].get_real();
	}
	return dronestate_.altitude_kp_;
}

rexjson::value UartRpcServer::rpc_altitude_ki(UART* , rexjson::array& params, rpc_exec_mode mode)
{
	static unsigned int types[] = {rpc_real_type|rpc_int_type|rpc_null_type};
	if (mode != execute) {
		if (mode == spec)
			return create_json_spec(types, ARRAYSIZE(types));
		if (mode == helpspec)
			return create_json_helpspec(types, ARRAYSIZE(types));
		return
	            "sd_altitude_ki\n"
	            "\nGet/Set Ki for the altitude PID controller."
				"\nIf the new coefficient is not specified, the current Ki will be returned."
				"\n"
				"Arguments:\n"
				"1. Ki          (real, optional) The Ki of the PID controller.\n"
				;
	}
	verify_parameters(params, types, ARRAYSIZE(types));
	if (params[0].type() != rexjson::null_type) {
		dronestate_.altitude_ki_ = params[0].get_real();
	}
	return dronestate_.altitude_ki_;
}

rexjson::value UartRpcServer::rpc_altitude_kd(UART* , rexjson::array& params, rpc_exec_mode mode)
{
	static unsigned int types[] = {rpc_real_type|rpc_int_type|rpc_null_type};
	if (mode != execute) {
		if (mode == spec)
			return create_json_spec(types, ARRAYSIZE(types));
		if (mode == helpspec)
			return create_json_helpspec(types, ARRAYSIZE(types));
		return
	            "sd_altitude_kd\n"
	            "\nGet/Set Kd for the altitude PID controller."
				"\nIf the new coefficient is not specified, the current Kd will be returned."
				"\n"
				"Arguments:\n"
				"1. Kd          (real, optional) The Kd of the PID controller.\n"
				;
	}
	verify_parameters(params, types, ARRAYSIZE(types));
	if (params[0].type() != rexjson::null_type) {
		dronestate_.altitude_kd_ = params[0].get_real();
	}
	return dronestate_.altitude_kd_;
}

rexjson::value UartRpcServer::rpc_altitude_ki_leak(UART* , rexjson::array& params, rpc_exec_mode mode)
{
	static unsigned int types[] = {rpc_real_type|rpc_int_type|rpc_null_type};
	if (mode != execute) {
		if (mode == spec)
			return create_json_spec(types, ARRAYSIZE(types));
		if (mode == helpspec)
			return create_json_helpspec(types, ARRAYSIZE(types));
		return
	            "sd_altitude_ki_leak\n"
	            "\nGet/Set Ki leak rate for the altitude PID controller."
				"\nIf no parameter is passed, then the current Ki leak rate will be returned."
				"\n"
				"Arguments:\n"
				"1. Ki_leak_rate    (real, optional) The Ki leak rate [0..1] of the PID controller.\n"
				;
	}
	verify_parameters(params, types, ARRAYSIZE(types));
	if (params[0].type() != rexjson::null_type) {
		dronestate_.altitude_ki_leak_ = params[0].get_real();
	}
	return dronestate_.altitude_ki_leak_;
}

rexjson::value UartRpcServer::rpc_altitude_tracker_kp_ki_kd(UART*, rexjson::array& params, rpc_exec_mode mode)
{
	static const int real_int_null_type = rpc_real_type|rpc_int_type|rpc_null_type;
	static unsigned int types[] = {real_int_null_type, real_int_null_type, real_int_null_type};
	if (mode != execute) {
		if (mode == spec)
			return create_json_spec(types, ARRAYSIZE(types));
		if (mode == helpspec)
			return create_json_helpspec(types, ARRAYSIZE(types));
		return
	            "sd_altitude_tracker_kp_ki_kd\n"
	            "\nGet/Set Kp, Ki, Kd for the altitude tracker PID controller."
				"\nIf no arguments are passed, then an array of the current coefficients is returned."
				"\n"
				"Arguments:\n"
				"1. Kp          (real, optional) The Kp of the PID controller.\n"
				"2. Ki          (real, optional) The Ki of the PID controller.\n"
				"3. Kd          (real, optional) The Kd of the PID controller.\n"
				;
	}
	verify_parameters(params, types, ARRAYSIZE(types));
	if (params[0].type() != rexjson::null_type) {
		dronestate_.altitude_tracker_kp_ = params[0].get_real();
		if (params[1].type() != rexjson::null_type) {
			dronestate_.altitude_tracker_ki_ = params[1].get_real();
			if (params[2].type() != rexjson::null_type) {
				dronestate_.altitude_tracker_kd_ = params[2].get_real();
			}
		}
	}
	return matrix_to_json_value(Vector3f(dronestate_.altitude_tracker_kp_,
			dronestate_.altitude_tracker_ki_,dronestate_.altitude_tracker_kd_));
}

rexjson::value UartRpcServer::rpc_altitude_tracker_kp2(
		UART*, rexjson::array& params, rpc_exec_mode mode)
{
	static unsigned int types[] = {rpc_real_type|rpc_int_type|rpc_null_type};
	if (mode != execute) {
		if (mode == spec)
			return create_json_spec(types, ARRAYSIZE(types));
		if (mode == helpspec)
			return create_json_helpspec(types, ARRAYSIZE(types));
		return
				"sd_altitude_tracker_kp2\n"
				"\nGet/Set Kp for inner PID controller of the altitude tracker."
				"\nIf the new coefficient is not specified, the current Kp will be returned."
				"\n"
				"Arguments:\n"
				"1. Kp          (real, optional) The Kp of the PID controller.\n"
				;
	}
	verify_parameters(params, types, ARRAYSIZE(types));
	if (params[0].type() != rexjson::null_type) {
		dronestate_.altitude_tracker_kp2_ = params[0].get_real();
	}
	return dronestate_.altitude_tracker_kp2_;
}

rexjson::value UartRpcServer::rpc_altitude_correction_period(
		UART*, rexjson::array& params, rpc_exec_mode mode)
{
	static unsigned int types[] = {rpc_real_type|rpc_int_type|rpc_null_type};
	if (mode != execute) {
		if (mode == spec)
			return create_json_spec(types, ARRAYSIZE(types));
		if (mode == helpspec)
			return create_json_helpspec(types, ARRAYSIZE(types));
		return
				"sd_altitude_correction_period\n"
				"\nGet/Set altitude correction period when hovering, i.e. how fast to return to the desired altitude."
				"\n"
				"Arguments:\n"
				"1. Period         (real, optional) Period in seconds.\n"
				;
	}
	verify_parameters(params, types, ARRAYSIZE(types));
	if (params[0].type() != rexjson::null_type) {
		dronestate_.altitude_correction_period_ = TimeSpan::from_milliseconds(params[0].get_real()*1000.0f);
		if (dronestate_.altitude_correction_period_ < TimeSpan::from_milliseconds(100)) {
			dronestate_.altitude_correction_period_ = TimeSpan::from_seconds(10);
		}
	}
	return dronestate_.altitude_correction_period_.seconds_float();
}

rexjson::value UartRpcServer::rpc_altitude_filter(
		UART*, rexjson::array& params, rpc_exec_mode mode)
{
	static unsigned int types[] = {rpc_real_type|rpc_int_type|rpc_null_type};
	if (mode != execute) {
		if (mode == spec)
			return create_json_spec(types, ARRAYSIZE(types));
		if (mode == helpspec)
			return create_json_helpspec(types, ARRAYSIZE(types));
		return
				"sd_altitude_filter\n"
				"\nGet/Set altitude low-pass filter coefficient \"A\", i.e. y(n)=A*y(n-1) + (1-A)*x(n)."
				"\n"
				"Arguments:\n"
				"1. Coefficient         (real, optional).\n"
				;
	}
	verify_parameters(params, types, ARRAYSIZE(types));
	if (params[0].type() != rexjson::null_type) {
		dronestate_.altitude_lpf_ = params[0].get_real();
	}
	return dronestate_.altitude_lpf_;
}

rexjson::value UartRpcServer::rpc_gyro_drift_leak_rate(UART* , rexjson::array& params, rpc_exec_mode mode)
{
	static unsigned int types[] = {rpc_real_type|rpc_int_type|rpc_null_type};
	if (mode != execute) {
		if (mode == spec)
			return create_json_spec(types, ARRAYSIZE(types));
		if (mode == helpspec)
			return create_json_helpspec(types, ARRAYSIZE(types));
		return
	            "sd_gyro_drift_leak_rate\n"
	            "\nGet/Set the leak rate for the integral component of the gyro drift PID controller."
				"\nIf no parameter is passed, then the current leak rate will be returned."
				"\n"
				"Arguments:\n"
				"1. leak_rate   (real, optional) Leak rate for the gyro drift PID controller.\n"
				;
	}
	verify_parameters(params, types, ARRAYSIZE(types));
	if (params[0].type() != rexjson::null_type) {
		dronestate_.gyro_drift_leak_rate_ = params[0].get_real();
	}
	return dronestate_.gyro_drift_leak_rate_;
}

rexjson::value UartRpcServer::rpc_enable_external_gyro(UART* , rexjson::array& params, rpc_exec_mode mode)
{
	static unsigned int types[] = {rpc_bool_type|rpc_null_type};
	if (mode != execute) {
		if (mode == spec)
			return create_json_spec(types, ARRAYSIZE(types));
		if (mode == helpspec)
			return create_json_helpspec(types, ARRAYSIZE(types));
		return
	            "sd_enable_external_gyro\n"
	            "\nEnable/disable the external gyro sensor for attitude tracking."
				"\nIf the external gyro is enabled, then the internal one is disabled and vice versa."
				"\nIf no parameter is passed, then the current external gyro usage value is returned."
				"\n"
				"Arguments:\n"
				"1. enable_external_gyro   (bool, optional) True - enable, false - disable external gyro.\n"
				;
	}
	verify_parameters(params, types, ARRAYSIZE(types));
	if (params[0].type() != rexjson::null_type) {
		dronestate_.external_gyro_enabled_ = params[0].get_bool();
	}
	return dronestate_.external_gyro_enabled_;
}

rexjson::value UartRpcServer::rpc_external_gyro_align(UART* , rexjson::array& params, rpc_exec_mode mode)
{
	static unsigned int types[] = {rpc_array_type|rpc_null_type};
	if (mode != execute) {
		if (mode == spec)
			return create_json_spec(types, ARRAYSIZE(types));
		if (mode == helpspec)
			return create_json_helpspec(types, ARRAYSIZE(types));
		return
	            "sd_external_gyro_align\n"
	            "\nSet/get the axes alignment matrix for the external gyro. The alignment 3x3 matrix is"
				"\nmultiplied by the 3x1 vector read from the sensor and the resultant 3x1 vector is"
				"\nused for attitude tracking."
				"\nIf no parameter is passed, then the current alignment matrix is returned."
				"\n"
				"Arguments:\n"
				"1. alignment_matrix   (float[9], optional) The matrix used for gyro axes alignment.\n"
				;
	}
	verify_parameters(params, types, ARRAYSIZE(types));
	if (params[0].type() != rexjson::null_type) {
		dronestate_.external_gyro_align_ = matrix_from_json_value<float, 3, 3>(params[0]);
	}
	return matrix_to_json_value(dronestate_.external_gyro_align_);
}

rexjson::value UartRpcServer::rpc_calibrate_mag(UART* , rexjson::array& params, rpc_exec_mode mode)
{
	static unsigned int types[] = {rpc_bool_type | rpc_null_type};
	if (mode != execute) {
		if (mode == spec)
			return create_json_spec(types, ARRAYSIZE(types));
		if (mode == helpspec)
			return create_json_helpspec(types, ARRAYSIZE(types));
		return
	            "sd_calibrate_mag\n"
	            "\nStart/stop magnetometer calibration."
				"\nAfter starting the calibration process, rotate the platform along all 3 axes."
				"\nIf no parameter is passed the current calibration state is returned"
				"\n"
				"Arguments:\n"
				"1. start_calibration   (bool, optional) True - start, false - stop calibration.\n"
				;
	}
	verify_parameters(params, types, ARRAYSIZE(types));
	if (params[0].type() != rexjson::null_type) {
		bool was_calibrating = mag_calibrator_.is_calibrating();
		mag_calibrator_.start_stop_calibration(params[0].get_bool());
		if (was_calibrating && !params[0].get_bool()) {
			dronestate_.mag_bias_ = mag_calibrator_.bias();
			dronestate_.mag_scale_factor_ = mag_calibrator_.scale_factor();
		}
	}

	return mag_calibrator_.is_calibrating();
}

rexjson::value UartRpcServer::rpc_position_kp(UART* , rexjson::array& params, rpc_exec_mode mode)
{
	static unsigned int types[] = {rpc_real_type|rpc_int_type|rpc_null_type};
	if (mode != execute) {
		if (mode == spec)
			return create_json_spec(types, ARRAYSIZE(types));
		if (mode == helpspec)
			return create_json_helpspec(types, ARRAYSIZE(types));
		return
	            "sd_position_kp\n"
	            "\nGet/Set Kp for the geo location PID controller."
				"\nIf the new coefficient is not specified, the current Kp will be returned."
				"\n"
				"Arguments:\n"
				"1. Kp          (real, optional) The Kp of the PID controller.\n"
				;
	}
	verify_parameters(params, types, ARRAYSIZE(types));
	if (params[0].type() != rexjson::null_type) {
		dronestate_.position_kp_ = params[0].get_real();
	}
	return dronestate_.position_kp_;
}

rexjson::value UartRpcServer::rpc_position_ki(UART* , rexjson::array& params, rpc_exec_mode mode)
{
	static unsigned int types[] = {rpc_real_type|rpc_int_type|rpc_null_type};
	if (mode != execute) {
		if (mode == spec)
			return create_json_spec(types, ARRAYSIZE(types));
		if (mode == helpspec)
			return create_json_helpspec(types, ARRAYSIZE(types));
		return
	            "sd_position_ki\n"
	            "\nGet/Set Ki for the geo location PID controller."
				"\nIf the new coefficient is not specified, the current Ki will be returned."
				"\n"
				"Arguments:\n"
				"1. Ki          (real, optional) The Ki of the PID controller.\n"
				;
	}
	verify_parameters(params, types, ARRAYSIZE(types));
	if (params[0].type() != rexjson::null_type) {
		dronestate_.position_ki_ = params[0].get_real();
	}
	return dronestate_.position_ki_;
}

rexjson::value UartRpcServer::rpc_position_kd(UART* , rexjson::array& params, rpc_exec_mode mode)
{
	static unsigned int types[] = {rpc_real_type|rpc_int_type|rpc_null_type};
	if (mode != execute) {
		if (mode == spec)
			return create_json_spec(types, ARRAYSIZE(types));
		if (mode == helpspec)
			return create_json_helpspec(types, ARRAYSIZE(types));
		return
	            "sd_altitude_kd\n"
	            "\nGet/Set Kd for the geo location PID controller."
				"\nIf the new coefficient is not specified, the current Kd will be returned."
				"\n"
				"Arguments:\n"
				"1. Kd          (real, optional) The Kd of the PID controller.\n"
				;
	}
	verify_parameters(params, types, ARRAYSIZE(types));
	if (params[0].type() != rexjson::null_type) {
		dronestate_.position_kd_ = params[0].get_real();
	}
	return dronestate_.position_kd_;
}

void UartRpcServer::jsonrpc_request_handler(UART* uart)
{
	rexjson::value response;
	std::string request;

	cached_request_ += uart->read();
	if (*cached_request_.rbegin() != '\n')
		return;
	request = cached_request_;
	cached_request_.clear();
	trim(request);
	if (request.empty())
		return;
	response = call(uart, request);
	uart->write(response.write(false, false, 0, 5) + "\n");
}
