sigmadrone/sigmadrone/source/cortex-m4/sdfirmware/src/tripilot.cpp

/*
 *  Sigmadrone
 *  Copyright (c) 2013-2015 The Sigmadrone Developers
 *
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
 *  Martin Stoilov <martin@sigmadrone.org>
 *  Svetoslav Vassilev <svassilev@sigmadrone.org>
 */
#include "tripilot.h"

TriPilot::TriPilot()
	: pf_(0.24, 1.0)
	, pid_(0.0, 0.0, 0.0, 80)
	, pidz_(0.0, 0.0, 0.0, 80)
	, pitch_avg_(0.94)
	, roll_avg_(0.94)
{
	min_thrust_ = 0.15;
	max_thrust_ = 1.0;
	target_thrust_ = 0.0;
	max_integral_torque_ = 0.25;

	Vector3f thrust_dir(0, 0, -1);
#ifdef USE_SIXPROPELLERS
	propellers_.push_back(Propeller(Vector3f(-0.866, -0.5,   0), thrust_dir, Propeller::CCW));
	propellers_.push_back(Propeller(Vector3f(-0.866,  0.5,   0), thrust_dir, Propeller::CW));
	propellers_.push_back(Propeller(Vector3f( 0.0,    1.0,   0), thrust_dir, Propeller::CCW));
	propellers_.push_back(Propeller(Vector3f( 0.866,  0.5,   0), thrust_dir, Propeller::CW));
	propellers_.push_back(Propeller(Vector3f( 0.866, -0.5,   0), thrust_dir, Propeller::CCW));
	propellers_.push_back(Propeller(Vector3f( 0.0,   -1.0,   0), thrust_dir, Propeller::CW));
#else
	propellers_.push_back(Propeller(Vector3f(-0.707, -0.707, 0), thrust_dir, Propeller::CCW));
	propellers_.push_back(Propeller(Vector3f(-0.707,  0.707, 0), thrust_dir, Propeller::CW));
	propellers_.push_back(Propeller(Vector3f( 0.707,  0.707, 0), thrust_dir, Propeller::CCW));
	propellers_.push_back(Propeller(Vector3f( 0.707, -0.707, 0), thrust_dir, Propeller::CW));
#endif
}

TriPilot::~TriPilot()
{
}

void TriPilot::set_pid_coefficents(const DroneState& state)
{
	pid_.set_kp_ki_kd(state.kp_, state.ki_, state.kd_);
	pidz_.set_kp_ki_kd(state.yaw_kp_, state.yaw_ki_, state.yaw_kd_);
	pid_.set_derivative_filter(state.pid_filter_freq_);
	pidz_.set_derivative_filter(state.pid_filter_freq_);
}

Vector3f TriPilot::get_torque(const DroneState& state)
{
	Vector3f torq_xy, torq_z, torq;
	QuaternionF twist, swing;
	QuaternionF::decomposeTwistSwing(~state.attitude_, Vector3f(0,0,1), swing, twist);

	// targetSwing = attitudeSwing * errorSwing; ==> ~attitudeSwing * targetSwing = ~attitudeSwing * attitudeSwing * errorSwing;
	QuaternionF errorSwing = (~swing) * (~state.target_swing_);
	QuaternionF errorTwist = (~twist) * (~state.target_twist_);
	Vector3f error_xy = errorSwing.axis().normalize() * errorSwing.angle() * -1.0f;
	Vector3f error_z = errorTwist.axis().normalize() * errorTwist.angle() * -1.0f;

	float ki = pid_.get_ki();
	Vector3f integral_error = pid_.get_integral_error();
	if (integral_error.length() * ki > max_integral_torque_ * target_thrust_) {
		integral_error = integral_error.normalize() * (max_integral_torque_ * target_thrust_ / ki);
		pid_.set_integral_error(integral_error);
	}
	torq_xy += pid_.get_p(error_xy);
	torq_xy += pid_.get_d(error_xy, state.dt_.seconds_float());
	torq_xy += pid_.get_i(error_xy, 1.0f * state.dt_.seconds_float(), state.dt_.seconds_float() / 15.0f);
	torq_z += pidz_.get_p(error_z);
	torq_z += pidz_.get_d_median(error_z, state.dt_.seconds_float());
	if (torq_z.length() > target_thrust_ * 0.6)
		torq_z = torq_z.normalize() * target_thrust_ * 0.6;
	torq = torq_xy + torq_z;
	if (target_thrust_ < 0.1)
		torq *= std::pow(target_thrust_ / 0.1, 2.0f);
//	std::cout << "Twist error: " << errorTwist.toString(4) << "( " << torq.transpose().to_string(4) << " )" << target_twist_.to_string(4)
//			<< ", target_yawv_ rad/s: " << target_yawv_.transpose() << std::endl;

	return torq;
}

void TriPilot::update_state(DroneState& state)
{
	set_target_thrust(state.base_throttle_ * 0.5f);
	set_pid_coefficents(state);
	if (target_thrust_ < 0.1) {
		pid_.set_integral_error(Vector3f(0));
	}
	torque_correction_ = get_torque(state);
	std::vector<float> torq_rpm;
	for (size_t i = 0; i < propellers_.size(); i++) {
		torq_rpm.push_back(pf_.nvelocity(torque_correction_.dot(propellers_.at(i).torque_dir()) + target_thrust_));
	}
	state.pid_torque_ = torque_correction_;
	motors_ = state.motors_ = clip_motors(torq_rpm);
	return;
}


std::vector<float> TriPilot::clip_motors(const std::vector<float>& motors)
{
	std::vector<float> ret;

	for (size_t i = 0; i < motors.size(); i++)
		ret.push_back(std::max(min_thrust_, std::min(motors[i], max_thrust_)));
	return ret;
}

const std::vector<float>& TriPilot::motors() const
{
	return motors_;
}

void TriPilot::set_min_thrust(float min)
{
	min_thrust_ = fmax(0.0, min);
}

void TriPilot::set_max_thrust(float max)
{
	max_thrust_ = fmin(1.0, max);
}

void TriPilot::set_target_thrust(float thr)
{
	target_thrust_ = thr;
}
