sigmadrone/sigmadrone/source/include/matrix.h

/*
 *  Sigmadrone
 *  Copyright (c) 2013-2015 The Sigmadrone Developers
 *
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
 *  Martin Stoilov <martin@sigmadrone.org>
 *  Svetoslav Vassilev <svassilev@sigmadrone.org>
 */

#ifndef __MATRIX_H__
#define __MATRIX_H__

#include <sstream>
#include <cassert>
#include <cmath>

#ifndef M_PI
#define M_PI 3.14159265358979323846
#endif

#ifndef DEG2RAD
#define DEG2RAD(__d__) (((__d__) * M_PI) / 180.0)
#define RAD2DEG(__r__) (((__r__) / M_PI) * 180.0)
#endif

#ifdef MATRIX_NAMESPACE
namespace MATRIX_NAMESPACE
{
#endif

const double EPSILON = 4.37114e-05;

template<typename T>
class Quaternion;

template <typename T, int M, int N>
class MatrixMN
{
public:
	/*
	 * Data is stored in column major order
	 */
	T data[M * N];

public:
	/*
	 * Data must be provided in row major order,
	 * but it will be converted to column major order.
	 * If the data is already in column major order
	 * set transposed to true.
	 */
	MatrixMN(T *a, bool transposed = false)
	{
		if (transposed) {
			for (int i = 0; i < M * N; i++)
				data[i] = a[i];
		} else {
			for (int i = 0; i < M; i++)
				for (int j = 0; j < N; j++)
					at(i, j) = a[i * M + j];
		}
	}

	MatrixMN(T a0 = 0, T a1 = 0, T a2 = 0, T a3 = 0, T a4 = 0, T a5 = 0, T a6 = 0, T a7 = 0,
			T a8 = 0, T a9 = 0, T a10 = 0, T a11 = 0, T a12 = 0, T a13 = 0, T a14 = 0, T a15 = 0, T a16 = 0,
			T a17 = 0, T a18 = 0, T a19 = 0, T a20 = 0, T a21 = 0, T a22 = 0, T a23 = 0, T a24 = 0)
	{
		T temp[25];
		temp[0] = a0; temp[1] = a1; temp[2] = a2; temp[3] = a3; temp[4] = a4;
		temp[5] = a5; temp[6] = a6; temp[7] = a7; temp[8] = a8; temp[9] = a9;
		temp[10] = a10; temp[11] = a11; temp[12] = a12;
		temp[13] = a13; temp[14] = a14; temp[15] = a15;
		temp[16] = a16; temp[17] = a17; temp[18] = a18;
		temp[19] = a19; temp[20] = a20; temp[21] = a21;
		temp[22] = a22; temp[23] = a23; temp[24] = a24;

		for (int i = 0; i < M; i++)
			for (int j = 0; j < N; j++)
				at(i, j) = ((i * N + j) < (int)(sizeof(temp)/sizeof(temp[0]))) ? temp[i * N + j] : static_cast<T>(0);
	}

	template<typename From, int FromM, int FromN>
	MatrixMN(const MatrixMN<From, FromM, FromN>& src)
	{
		for (int i = 0; i < M; i++) {
			for (int j = 0; j < N; j++) {
				at(i, j) = (i < FromM && j < FromN) ? src.at(i, j) : static_cast<T>(0);
			}
		}
	}

	T& at(int row, int col)
	{
		return data[col * M + row];
	}

	const T& at(int row, int col) const
	{
		return data[col * M + row];
	}

	void clear()
	{
		for (int i = 0; i < N * M; i++)
			data[i] = static_cast<T>(0);
	}

	void identity()
	{
		assert(M == N);
		for (int i = 0; i < M * M; i++)
			data[i] = (i % (M + 1)) ? static_cast<T>(0) : static_cast<T>(1);
	}

	template<typename From, int FromM, int FromN>
	MatrixMN<T, M, N>& operator=(const MatrixMN<From, FromM, FromN>& src)
	{
		for (int i = 0; i < N; i++) {
			for (int j = 0; j < N; j++) {
				at(i, j) = (i < FromM && j < FromN) ? src.at(i, j) : static_cast<T>(0);
			}
		}
		return *this;
	}

	MatrixMN<T, 1, N> row(int m) const
	{
		MatrixMN<T, 1, N> ret;
		for (int i = 0; i < N; i++)
			ret.at(0, i) = at(m, i);
		return ret;
	}

	void setRow(int m, const MatrixMN<T, 1, N>& r)
	{
		for (int i = 0; i < N; i++)
			at(m, i) = r.at(0, i);
	}

	MatrixMN<T, M, 1> column(int n) const
	{
		MatrixMN<T, M, 1> ret;
		for (int i = 0; i < M; i++)
			ret.at(i, 0) = at(i, n);
		return ret;
	}

	void setColumn(int n, const MatrixMN<T, M, 1>& c)
	{
		for (int i = 0; i < M; i++)
			at(i, n) = c.at(i, 0);
	}

	void swapRows(int m, int n)
	{
		T temp;
		if (m == n)
			return;
		for (int i = 0; i < N; i++) {
			temp = at(m, i);
			at(m, i) = at(n, i);
			at(n, i) = temp;
		}
	}

	void swapColumns(int m, int n)
	{
		T temp;
		if (m == n)
			return;
		for (int i = 0; i < M; i++) {
			temp = at(i, m);
			at(i, m) = at(i, n);
			at(i, n) = temp;
		}
	}

	MatrixMN<T, M, N> operator+(const MatrixMN<T, M, N>& rhs) const
	{
		MatrixMN<T, M, N> ret;
		for (int i = 0; i < N * M; i++)
			ret.data[i] = data[i] + rhs.data[i];
		return ret;
	}

	MatrixMN<T, M, N> operator+(T rhs) const
	{
		MatrixMN<T, M, N> ret;
		for (int i = 0; i < N * M; i++)
			ret.data[i] = data[i] + rhs;
		return ret;
	}

	MatrixMN<T, M, N> operator-(const MatrixMN<T, M, N>& rhs) const
	{
		MatrixMN<T, M, N> ret;
		for (int i = 0; i < N * M; i++)
			ret.data[i] = data[i] - rhs.data[i];
		return ret;
	}

	MatrixMN<T, M, N> operator-(T rhs) const
	{
		MatrixMN<T, M, N> ret;
		for (int i = 0; i < N * M; i++)
			ret.data[i] = data[i] - rhs;
		return ret;
	}

	MatrixMN<T, M, N> operator/(T rhs) const
	{
		MatrixMN<T, M, N> ret;
		for (int i = 0; i < N * M; i++)
			ret.data[i] = data[i] / rhs;
		return ret;
	}

	MatrixMN<T, M, N> operator*(T rhs) const
	{
		MatrixMN<T, M, N> ret;
		for (int i = 0; i < N * M; i++)
			ret.data[i] = data[i] * rhs;
		return ret;
	}

	template<typename rhsT, int rhsN>
	MatrixMN<T, M, rhsN> operator*(const MatrixMN<rhsT, N, rhsN>& rhs) const
	{
		MatrixMN<T, M, rhsN> ret;
		for (int h = 0; h < rhsN; h++) {
			for (int i = 0; i < M; i++) {
				for (int j = 0; j < N; j++) {
					ret.at(i, h) += at(i, j) * rhs.at(j, h);
				}
			}
		}
		return ret;
	}

	MatrixMN<T, N, M> transpose() const
	{
		MatrixMN<T, N, M> ret;
		for (int i = 0; i < N; i++)
			for (int j = 0; j < M; j++)
				ret.at(i, j) = at(j, i);
		return ret;
	}

	bool lup(MatrixMN<T, M, N> &L, MatrixMN<T, M, N> &U, MatrixMN<T, M, N> &P) const
	{
		assert(M == N);
		int K, k, i, j;

		L.clear();
		P.identity();
		U = *this;
		for (k = 0; k < M; k++) {
			T p = 0;
			K = k;
			for (i = k; i < M; i++) {
				if (abs(U.at(i, k)) > p) {
					p = abs(U.at(i, k));
					K = i;
				}
			}
			if (!p)
				return false;
			P.swapRows(k, K);
			U.swapRows(k, K);
			L.swapRows(k, K);
			for (i = k + 1; i < M; i++) {
				L.at(i, k) = U.at(i, k)/U.at(k, k);
				for (j = 0; j < N; j++)
					U.at(i, j) -= L.at(i, k) * U.at(k, j);
			}
		}
		for (i = 0; i < M; i++)
			L.at(i, i) = static_cast<T>(1);
		return true;
	}

	MatrixMN<T, M, 1> lupSolve(
			const MatrixMN<T, M, N> &L,
			const MatrixMN<T, M, N> &U,
			const MatrixMN<T, M, N> &P,
			const MatrixMN<T, M, 1> &B) const
	{
		MatrixMN<T, M, 1> X;
		MatrixMN<T, M, 1> Y = P * B;
		for (int i = 0; i < M; i++) {
			for (int j = 0; j < i; j++)
				Y.at(i, 0) -= Y.at(j, 0)*L.at(i, j);
		}
		X = Y;
		for (int i = M - 1; i >= 0; i--) {
			for (int j = i + 1; j < M; j++)
				X.at(i, 0) -= X.at(j, 0)*U.at(i, j);
			X.at(i, 0) /= U.at(i,i);
		}
		return X;
	}

	MatrixMN<T, M, N> inverse() const
	{
		assert(M == N);
		MatrixMN<T, M, N> ret;
		MatrixMN<T, M, 1> In;
		MatrixMN<T, M, N> L, U, P;

		if (!lup(L, U, P))
			return ret;
		for (int i = 0; i < M; i++) {
			In.at(i, 0) = 1;
			ret.setColumn(i, lupSolve(L, U, P, In));
			In.at(i, 0) = 0;
		}
		return ret;
	}

	std::string toString() const
	{
		std::stringstream oss;
		oss.setf(std::ios::fixed, std::ios::floatfield);
		oss.precision(2);
		for (int i = 0; i < M; i++) {
			for (int j = 0; j < N; j++) {
				oss.width(7);
				oss << at(i, j) << " ";
			}
			oss << std::endl;
		}
		return oss.str();
	}

	friend std::ostream& operator<<(std::ostream& os, const MatrixMN<T, M, N>& m)
	{
		os << m.toString();
		return os;
	}

	static MatrixMN<T, 4, 4> createRotationMatrix(T xrad, T yrad, T zrad)
	{
		float cx = cos(xrad);
		float sx = sin(xrad);
		float cy = cos(yrad);
		float sy = sin(yrad);
		float cz = cos(zrad);
		float sz = sin(zrad);
		MatrixMN<T, 4, 4> mx( 1,   0,   0,  0,
							  0,  cx, -sx,  0,
							  0,  sx,  cx,  0,
							  0,   0,   0,  1);
		MatrixMN<T, 4, 4> my( cy,   0,  sy,  0,
							   0,   1,   0,  0,
							 -sy,   0,  cy,  0,
							   0,   0,   0,  1);
		MatrixMN<T, 4, 4> mz( cz, -sz,  0,  0,
							  sz,  cz,  0,  0,
							   0,   0,  1,  0,
							   0,   0,  0,  1);
		return mx * my * mz;
	}

	static MatrixMN<T, 4, 4> createTranslationMatrix(T x, T y, T z)
	{
		MatrixMN<T, 4, 4> ret(	1,   0,  0,  x,
								0,   1,  0,  y,
								0,   0,  1,  z,
								0,   0,  0,  1);
		return ret;
	}

	static MatrixMN<T, 4, 4> createScaleMatrix(T x, T y, T z)
	{
		MatrixMN<T, 4, 4> ret(	x,   0,  0,  0,
								0,   y,  0,  0,
								0,   0,  z,  0,
								0,   0,  0,  1);
		return ret;
	}

	static MatrixMN<T, M, M> createIdentityMatrix()
	{
		MatrixMN<T, M, M> ret;
		ret.identity();
		return ret;
	}

	static MatrixMN<T, 4, 4> createFrustumMatrix(T left, T right, T bottom, T top, T zNear, T zFar)
	{
		MatrixMN<T, 4, 4> ret
		(
			2 * zNear/(right-left),	0,						(right+left)/(right-left),	0,
			0,						2*zNear/(top-bottom),	(top+bottom)/(top-bottom),	0,
			0,						0,						-(zFar+zNear)/(zFar-zNear),	-(2*zFar*zNear)/(zFar-zNear),
			0,						0,						-1,							0
		);
		return ret;
	}

	static MatrixMN<T, 4, 4> createOrthoMatrix(T left, T right, T bottom, T top, T zNear, T zFar)
	{
		MatrixMN<T, 4, 4> ret
		(
			2/(right-left),			0,						0,							(right+left)/(right-left),
			0,						2/(top-bottom),			0,							(top+bottom)/(top-bottom),
			0,						0,						-2/(zFar-zNear),			-(zFar+zNear)/(zFar-zNear),
			0,						0,						0,							1
		);
		return ret;
	}

	static MatrixMN<T, 4, 4> createLookAt(
			const MatrixMN<T, 3, 1>& eyePos,
			const MatrixMN<T, 3, 1>& centerPos,
			const MatrixMN<T, 3, 1>& upDir)
	{
		MatrixMN<T, 3, 1> forward, side, up(upDir);
		MatrixMN<T, 4, 4> m;

		m.identity();
		forward = (centerPos - eyePos).normalize();

		// Side = forward x up
		side = MatrixMN<T, 3, 1>::cross(forward, up).normalize();

		// Recompute up as: up = side x forward
		up = MatrixMN<T, 3, 1>::cross(side, forward);

		m.at(0, 0) = side.at(0,0);
		m.at(0, 1) = side.at(1,0);
		m.at(0, 2) = side.at(2,0);

		m.at(1, 0) = up.at(0,0);
		m.at(1, 1) = up.at(1,0);
		m.at(1, 2) = up.at(2,0);

		m.at(2, 0) = -forward.at(0,0);
		m.at(2, 1) = -forward.at(1,0);
		m.at(2, 2) = -forward.at(2,0);

		return (m * MatrixMN<T, 4, 4>::createTranslationMatrix(-eyePos.at(0,0), -eyePos.at(1,0), -eyePos.at(2,0)));
	}

private:
	T abs(T a) const
	{
		return (a < 0) ? -a : a;
	}
};


template<typename T, int M>
class MatrixMN<T, M, 1>
{
public:
	static const int N = 1;

	/*
	 * Data is stored in column major order
	 */
	T data[M * N];

public:
	/*
	 * Data must be provided in row major order,
	 * but it will be converted to row major order.
	 * If the data is already in column major order
	 * set transposed to true.
	 */
	MatrixMN(T *a, bool transposed = false)
	{
		if (transposed) {
		for (int i = 0; i < M * N; i++)
			data[i] = a[i];
		} else {
			for (int i = 0; i < M; i++)
				for (int j = 0; j < N; j++)
					at(i, j) = a[i * M + j];
		}
	}

	MatrixMN(T a0 = 0, T a1 = 0, T a2 = 0, T a3 = 0, T a4 = 0, T a5 = 0, T a6 = 0, T a7 = 0, T a8 = 0,
			T a9 = 0, T a10 = 0, T a11 = 0, T a12 = 0, T a13 = 0, T a14 = 0, T a15 = 0,	T a16 = 0,
			T a17 = 0, T a18 = 0, T a19 = 0, T a20 = 0, T a21 = 0, T a22 = 0, T a23 = 0, T a24 = 0)
	{
		T temp[25];
		temp[0] = a0; temp[1] = a1; temp[2] = a2; temp[3] = a3; temp[4] = a4;
		temp[5] = a5; temp[6] = a6; temp[7] = a7; temp[8] = a8; temp[9] = a9;
		temp[10] = a10; temp[11] = a11; temp[12] = a12;
		temp[13] = a13; temp[14] = a14; temp[15] = a15;
		temp[16] = a16; temp[17] = a17; temp[18] = a18;
		temp[19] = a19; temp[20] = a20; temp[21] = a21;
		temp[22] = a22; temp[23] = a23; temp[24] = a24;

		for (int i = 0; i < M; i++)
			for (int j = 0; j < N; j++)
				at(i, j) = ((i * N + j) < (int)(sizeof(temp)/sizeof(temp[0]))) ? temp[i * N + j] : static_cast<T>(0);
	}

	template<typename From, int FromM, int FromN>
	MatrixMN(const MatrixMN<From, FromM, FromN>& src)
	{
		for (int i = 0; i < M; i++) {
			for (int j = 0; j < N; j++) {
				at(i, j) = (i < FromM && j < FromN) ? src.at(i, j) : static_cast<T>(0);
			}
		}
	}

	T& at(int row, int col = 0)
	{
		return data[col * M + row];
	}

	const T& at(int row, int col = 0) const
	{
		return data[col * M + row];
	}

	void clear()
	{
		for (int i = 0; i < N * M; i++)
			data[i] = static_cast<T>(0);
	}

	template<typename From, int FromM, int FromN>
	MatrixMN<T, M, N>& operator=(const MatrixMN<From, FromM, FromN>& src)
	{
		for (int i = 0; i < N; i++) {
			for (int j = 0; j < N; j++) {
				at(i, j) = (i < FromM && j < FromN) ? src.at(i, j) : static_cast<T>(0);
			}
		}
		return *this;
	}

	MatrixMN<T, 1, N> row(int m) const
	{
		MatrixMN<T, 1, N> ret;
		for (int i = 0; i < N; i++)
			ret.at(0, i) = at(m, i);
		return ret;
	}

	void setRow(int m, const MatrixMN<T, 1, N>& r)
	{
		for (int i = 0; i < N; i++)
			at(m, i) = r.at(0, i);
	}

	MatrixMN<T, M, 1> column(int n) const
	{
		MatrixMN<T, M, 1> ret;
		for (int i = 0; i < M; i++)
			ret.at(i, 0) = at(i, n);
		return ret;
	}

	void setColumn(int n, const MatrixMN<T, M, 1>& c)
	{
		for (int i = 0; i < M; i++)
			at(i, n) = c.at(i, 0);
	}

	void swapRows(int m, int n)
	{
		T temp;
		if (m == n)
			return;
		for (int i = 0; i < N; i++) {
			temp = at(m, i);
			at(m, i) = at(n, i);
			at(n, i) = temp;
		}
	}

	void swapColumns(int m, int n)
	{
		T temp;
		if (m == n)
			return;
		for (int i = 0; i < M; i++) {
			temp = at(i, m);
			at(i, m) = at(i, n);
			at(i, n) = temp;
		}
	}

	MatrixMN<T, M, N> operator+(const MatrixMN<T, M, N>& rhs)
	{
		MatrixMN<T, M, N> ret;
		for (int i = 0; i < N * M; i++)
			ret.data[i] = data[i] + rhs.data[i];
		return ret;
	}

	MatrixMN<T, M, N> operator+(T rhs)
	{
		MatrixMN<T, M, N> ret;
		for (int i = 0; i < N * M; i++)
			ret.data[i] = data[i] + rhs;
		return ret;
	}

	MatrixMN<T, M, N> operator-(const MatrixMN<T, M, N>& rhs) const
	{
		MatrixMN<T, M, N> ret;
		for (int i = 0; i < N * M; i++)
			ret.data[i] = data[i] - rhs.data[i];
		return ret;
	}

	MatrixMN<T, M, N> operator-() const
	{
		MatrixMN<T, M, N> ret;
		for (int i = 0; i < N * M; i++)
			ret.data[i] = -data[i];
		return ret;
	}

	MatrixMN<T, M, N> operator-(T rhs) const
	{
		MatrixMN<T, M, N> ret;
		for (int i = 0; i < N * M; i++)
			ret.data[i] = data[i] - rhs;
		return ret;
	}

	MatrixMN<T, M, N> operator/(T rhs) const
	{
		MatrixMN<T, M, N> ret;
		for (int i = 0; i < N * M; i++)
			ret.data[i] = data[i] / rhs;
		return ret;
	}

	MatrixMN<T, M, N> operator*(T rhs) const
	{
		MatrixMN<T, M, N> ret;
		for (int i = 0; i < N * M; i++)
			ret.data[i] = data[i] * rhs;
		return ret;
	}

	template<typename rhsT, int rhsN>
	MatrixMN<T, M, rhsN> operator*(const MatrixMN<rhsT, N, rhsN>& rhs) const
	{
		MatrixMN<T, M, rhsN> ret;
		for (int h = 0; h < rhsN; h++) {
			for (int i = 0; i < M; i++) {
				for (int j = 0; j < N; j++) {
					ret.at(i, h) += at(i, j) * rhs.at(j, h);
				}
			}
		}
		return ret;
	}

	MatrixMN<T, N, M> transpose() const
	{
		MatrixMN<T, N, M> ret;
		for (int i = 0; i < N; i++)
			for (int j = 0; j < M; j++)
				ret.at(i, j) = at(j, i);
		return ret;
	}

	std::string toString() const
	{
		std::stringstream oss;
		oss.setf(std::ios::fixed, std::ios::floatfield);
		oss.precision(2);
		for (int i = 0; i < M; i++) {
			for (int j = 0; j < N; j++) {
				oss.width(7);
				oss << at(i, j) << " ";
			}
			oss << std::endl;
		}
		return oss.str();
	}

	T length() const
	{
		return std::sqrt(lengthSq());
	}

	T lengthSq() const
	{
		T ret = static_cast<T>(0);
		for (int i = 0; i < M; i++)
			ret += at(i, 0) * at(i, 0);
		return ret;
	}

	T sum() const
	{
		T ret = static_cast<T>(0);
		for (int i = 0; i < M; i++) {
			ret += at(i, 0);
		}
		return ret;
	}

	T minValue() const
	{
		T min = at(0,0);
		for (int i = 1; i < M; i++) {
			if (at(i,0) < min) {
				min = at(i,0);
			}
		}
		return min;
	}

	T maxValue() const
	{
		T max = at(0,0);
		for (int i = 1; i < M; i++) {
			if (at(i,0) > max) {
				max = at(i,0);
			}
		}
		return max;
	}

	MatrixMN<T, M, 1> normalize() const
	{
		MatrixMN<T, M, 1> ret;
		T s = length();
		if (s) {
			for (int i = 0; i < M; i++)
				ret.at(i, 0) = at(i, 0) / s;
		}
		return ret;
	}

	MatrixMN<T, 3, 1> projection(const MatrixMN<T, 3, 1>& u) const
	{
		return (*this) * dot(u, (*this)) / lengthSq();
	}

	MatrixMN<T, 3, 1> perpendicular(const MatrixMN<T, 3, 1>& u) const
	{
		return u - projection(u);
	}

	static MatrixMN<T, 3, 1> cross(const MatrixMN<T, 3, 1>& u, const MatrixMN<T, 3, 1>& v)
	{
		return MatrixMN<T, 3, 1>(u.at(1,0) * v.at(2,0) - v.at(1,0) * u.at(2,0), u.at(2,0) * v.at(0,0) -
				v.at(2,0) * u.at(0,0), u.at(0,0) * v.at(1,0) - v.at(0,0) * u.at(1,0));
	}

	static T dot(const MatrixMN<T, M, 1>& u, const MatrixMN<T, M, 1>& v)
	{
		T ret = static_cast<T>(0);
		for (int i = 0; i < M; i++)
			ret += u.at(i, 0) * v.at(i, 0);
		return ret;
	}

	/*
	 * n denotes the normal vector to a plane
	 */
	static MatrixMN<T, 3, 1> parallel(const MatrixMN<T, 3, 1>& n, const MatrixMN<T, 3, 1>& v)
	{
		Quaternion<T> qn(0, n.at(0, 0), n.at(1, 0), n.at(2, 0));
		Quaternion<T> qv(0, v.at(0, 0), v.at(1, 0), v.at(2, 0));
		Quaternion<T> qr = (qv + qn * qv * qn) * 1.0 / 2.0;
		return MatrixMN<T, 3, 1>(qr.x, qr.y, qr.z);
	}

	/*
	 * n denotes the normal vector to a plane
	 */
	static MatrixMN<T, 3, 1> perpendicular(const MatrixMN<T, 3, 1>& n, const MatrixMN<T, 3, 1>& v)
	{
		Quaternion<T> qn(0, n.at(0, 0), n.at(1, 0), n.at(2, 0));
		Quaternion<T> qv(0, v.at(0, 0), v.at(1, 0), v.at(2, 0));
		Quaternion<T> qr = (qv - qn * qv * qn) * 1.0 / 2.0;
		return MatrixMN<T, 3, 1>(qr.x, qr.y, qr.z);
	}

	/*
	 * n denotes the normal vector to a plane
	 */
	static MatrixMN<T, 3, 1> reflection(const MatrixMN<T, 3, 1>& n, const MatrixMN<T, 3, 1>& v)
	{
		Quaternion<T> qn(0, n.at(0, 0), n.at(1, 0), n.at(2, 0));
		Quaternion<T> qv(0, v.at(0, 0), v.at(1, 0), v.at(2, 0));
		Quaternion<T> qr = (qn * qv * qn);
		return MatrixMN<T, 3, 1>(qr.x, qr.y, qr.z);
	}

	friend std::ostream& operator<<(std::ostream& os, const MatrixMN<T, M, N>& m)
	{
		os << m.toString();
		return os;
	}
};

template<typename T>
class Quaternion
{
public:
	T w, x, y, z;
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
