sigmadrone/sigmadrone/source/cortex-m4/sdfirmware/src/uartrpcserver.h

/*
 *  Sigmadrone
 *  Copyright (c) 2013-2015 The Sigmadrone Developers
 *
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
 *  Martin Stoilov <martin@sigmadrone.org>
 *  Svetoslav Vassilev <svassilev@sigmadrone.org>
 */

#ifndef UARTRPCSERVER_H_
#define UARTRPCSERVER_H_

#include "uart.h"
#include "dronestate.h"
#include "flashmemory.h"
#include "librexjsonrpc/rpcserver.h"

class MagCalibrator;

class UartRpcServer : public rpc_server<UartRpcServer, UART*>
{
public:
	UartRpcServer(DroneState& dronestate, FlashMemory& configdata, MagCalibrator& mag_calibrator);
	virtual ~UartRpcServer();

	void jsonrpc_request_handler(UART* uart);

protected:
	rexjson::value rpc_spec(UART* uart, rexjson::array& params, rpc_exec_mode mode = execute);
	rexjson::value rpc_help(UART* uart, rexjson::array& params, rpc_exec_mode mode = execute);
	rexjson::value rpc_get_attitude(UART* uart, rexjson::array& params, rpc_exec_mode mode = execute);
	rexjson::value rpc_get_altitude(UART* uart, rexjson::array& params, rpc_exec_mode mode = execute);
	rexjson::value rpc_get_pressure(UART* uart, rexjson::array& params, rpc_exec_mode mode = execute);
	rexjson::value rpc_get_temperature(UART* uart, rexjson::array& params, rpc_exec_mode mode = execute);
	rexjson::value rpc_get_motors(UART* uart, rexjson::array& params, rpc_exec_mode mode = execute);
	rexjson::value rpc_get_dronestate(UART* uart, rexjson::array& params, rpc_exec_mode mode = execute);
	rexjson::value rpc_get_dronestate_ex(UART* uart, rexjson::array& params, rpc_exec_mode mode = execute);
	rexjson::value rpc_get_configdata(UART* uart, rexjson::array& params, rpc_exec_mode mode = execute);
	rexjson::value rpc_set_configdata(UART* uart, rexjson::array& params, rpc_exec_mode mode = execute);
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
