sigmadrone/sigmadrone/(commit log)

2013-09-19 Initial import from old repository
    [batterycharger.sch, header-gpio.sch, i2c-bus.sch, i2c-sensors.sch, onoffcontrol.sch, pandaext.sch, servo-control.sch, voltageregulators.sch]
2013-09-22 tracelog plugin - attaches at the highest altitude
2013-09-24 tracelog changes
2013-09-30 display help if no command args are available;allow servodecie plugin to configure higher rates;fix bias samples display problem
    [main.cpp]
2013-10-12 minor fixes/updates in the quad pilot logic; added low-pass filter on the accelerometer data
    [firfilt.h, main.cpp, sdroneapi.h]
2013-11-17 avoid division by 0
    [matrix.h]
2013-11-17 can receive and execute commands while running; shutdown motors before stopping
2013-11-18 fix bug in kalman filter - now it works; quadriple the time to calc bias
2013-11-28 fix motor scaling error
2013-12-03 limit integral error; introduce secondary pid loop tracking the angular velocity
    [pidcontroller.h, sdroneapi.h]
2013-12-06 leverage the FileLock class and install default handler for error signals, so we can reset drone hardware on error
    [main.cpp]
2013-12-12 add kalman attitude filter to the build
2013-12-27 we should not be reading more than 16 samples with one call
2014-03-03 disable velocity pid
2014-03-03 remap the sensors
2014-03-09 fix earth G calc if the drone is upside down; print earth G after calculating it
2014-04-01 added junk call to fix assert failure
    [main.cpp]
2014-05-12 remove unused code. fixed compilation error
    [main.cpp]
2014-08-16 json rpc related bug fixes
    [main.cpp, sdroneapi.h]
2014-08-17 use the SdJsonValue::GetXXXSafe routines, so if value is not present the current config will not be overwritten
2014-08-20 added support for pwm OE and motor power OE
2014-08-27 major rework on how rpc are sent - now there is differennt method for every command/operation; ditched the local copy of cmdargs
    [main.cpp, sdroneapi.h]
2014-08-28 fixed cmdargs and jsonrpc unit tests
    [sdroneapi.h]
2014-08-28 bug fixes for ping and set_thrust
    [main.cpp, sdroneapi.h]
2014-09-01 Fix sampling rate spelling; incorrect return value from iocallback and print ping cookies as unsigned
2014-09-02 fixed axes remapping and angle between motors and imu axis; now axis Z points down
2014-09-04 control the power from the ServoDevice plugin
2014-09-15 added spec command that prints the json schema for all the supported RPC's; wired up getconfig/thrust methods as well and now they are printed as well as json
2014-09-16 use non blocking calls to read the accelerometer
2014-09-17 alldata using imu_sensor. Also fixed cmdargs to use const for argv parameter, fixed all related build errors.
    [clientapp.cpp, clientapp.h, main.cpp, serverapp.cpp, serverapp.h]
2014-09-18 added support for imu data scaling
2014-09-19 added sampler and filesensor
2014-09-19 optimize the command line workflow: 1) if not -s (server) is not specified, then client role is assumed; 2) if --host is not specified, then localhost is assumed to be the server; 3) do not print whe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
    [jsonrpc.h, main.cpp]
2014-09-19 renamed the RPC calls - made them all small caps and shorter; now daemon implies server role
    [jsonrpc.h, sdroneapi.h]
2014-09-20 added threaded update operation for the slow file_sensor.
2014-09-20 use libdevice to read sensor data
2014-09-20 fixed deltaT; now the --rate cmd param controls only the gyro rate, added watermark parameters for gyro and accel
2014-09-23 write data from the sensors to the log
2014-09-23 implemented file sampler
2014-09-25 commands can now be specified w/o -c=; sensor log does not get created when using the filereader
2014-09-28 pid pilot code merged
2014-09-28 pid pilot now seems to work, only motor axes need to be fixed
    [pidtorque.cpp]
2014-09-29 reflect current config
2014-09-29 print original and re-built value from spec
2014-09-30 added disable sensor reading
2014-10-01 Started servo control classes
2014-10-01 Work on servo control.
2014-10-02 added servocontroller setpulse/getpulse.
2014-10-02 Fixed setrate to initiate update.
    [serverapp.cpp, userrpcserver.cpp, userrpcserver.h]
2014-10-04 execute command without naming the arguments, i.e. sdroned thrust 0.2 0.4 0.5. Parameters must follow the ordering of the json schema
2014-10-05 added sensor adjustment.
2014-10-06 use the new servo classes in the servo plugin
2014-10-06 print the current attitude and not the target
2014-10-06 initialize servoctrl_ in the constructor of ServoDevicePlugin
2014-10-07 enable low pass filter, disable bias from the gyro sensor
2014-10-08 properly arm/disarm motors; there is still an issu as the limits are not quite correct
    [servocontroller.h]
2014-10-08 arm/disarm motors
2014-10-12 create a separate thread to read the device
2014-10-12 fixed sensor worker thread start/stop.
2014-10-13 work on pid controller
2014-10-16 change the limits for the servo plugin
2014-10-16 set/get earht G vector; reworked set/get quaternon to use objects
    [jsonrpc.h]
2014-10-18 get/set motors and is_running command
2014-10-18 sd_set_safe_thrust sets thrust with limits; once executed the thrust is always set in safe manner until the next reset comes; sd_set_thrust now accepts only double as param
    [jsonrpc.h]
2014-10-19 renamed header() to find_header(), insert_header()
2014-10-19 added commented out logger, in case we want to debug the RPC transport.
2014-10-20 diagnostic printfs
2014-10-21 sd_get_thrust now returns thrust as double; introdude sd_get_safe_thrust which return in object thrust,minThrust,maxThrust
2014-10-21 work on magnetometer tracking
2014-10-21 provide accel date from the low pass filter if it is running
2014-10-23 added motor thrust correction.
    [mainwindow.cpp, mainwindow.h, userrpcserver.cpp, userrpcserver.h]
2014-10-23 fixes for set correction thrust.
    [mainwindow.cpp, mainwindow.h, userrpcserver.cpp]
2014-10-23 make the kalman attitude filter usable
2014-10-24 implement thrust correction plugin
    [jsonrpc.h, sdroneapi.h]
2014-10-29 restore the previous method of tracking the accelerometer by generating angular velocity in the direction of the sensed G vector
2014-11-02 200th order low pass filter; sd_get_correction_thrust
2014-11-10 number of small changes/fixes, not leading to significant improvement though; 1) fixed plugin command params to not hold refernce to the data, this was leading to crash; 2) changed default params to 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
    [pidtorque.cpp, pidtorque.h]
2014-12-23 print the task list
2014-12-23 added lcd files to makefile; print hello world on lcd
2014-12-23 print gyro readings on the lcd
2014-12-24 Added l3gd20_driver (gyro platform independent driver) from STM
2014-12-25 added FIFO support for the gyro
2014-12-30 added lsm303d driver
2015-01-07 Cleaned up LSM303D driver
2015-01-07 work on LSM303D spi interface
2015-01-08 Display Accelerometer data on the LCD
2015-01-12 added LSM303D interrupt
2015-01-13 Enabled HP Filter
2015-01-13 sample on how to control layers on the lcd; display info on the lcd once every 200 ms
2015-01-14 work on SPI slave
2015-01-16 Incrased the priority of the system tick to fix SPI timeouts
    [digitalin.cpp, main.cpp, spislave.cpp]
2015-01-16 Added Reboot of memory content
    [l3gd20.cpp, l3gd20.h]
2015-01-17 Added delay in Reboot
    [l3gd20.cpp]
2015-01-19 fix-up the timer clock if the resulting period will overflow the timer resolution
    [hwtimer.cpp, hwtimer.h, units.h]
2015-01-26 PWM encoder/decoder functionality
2015-01-26 fixed-up the comments in the header files
    [hwtimer.cpp, hwtimer.h, pwmdecoder.h, pwmencoder.h]
2015-01-26 commented out trace_printf
2015-01-28 move spi slave interrupt init code to main.cpp file
2015-01-31 started uart class
2015-02-02 work on uart communication
2015-02-04 UART communication
2015-02-04 set UART rate to 2 Mbits
2015-02-05 update the wp on interrupts
2015-02-09 increase the priority of the tim7 used for timestamps, which fixes timing problem in TimeStamp::elapsed when the timer counter was rolling over
    [hwtimer.cpp, main.cpp, timestamp.cpp, timestamp.h, units.h]
2015-02-12 trigger context switch immediately after the isr finishes
2015-04-26 fixed firmware name. updated rexjson.
    [_initialize_hardware.c, _write.c, attitudetracker.cpp, attitudetracker.h, circbuffer.cpp, circbuffer.h, digitalin.cpp]
2015-05-03 removed jsonspirit, replaced it with rexjson
    [clientapp.cpp, clientapp.h, jsonserialization.h]
2015-05-05 Renamed old panda ext board design as obsolete
    [batterycharger.sch, header-gpio.sch, i2c-bus.sch, i2c-sensors.sch, onoffcontrol.sch, pandaext.sch, servo-control.sch, voltageregulators.sch]
2015-05-27 Started eclipse arm project for the Cortex-M4 firmware
2015-05-30 Fixed interrupt init
2015-06-08 Added tm display driver
2015-06-15 Colibri hardware schematics, gerber, BOM, PCB
    [Colibri_Rev1j_BOM.xlsx, Colibri_Rev1j_PCB_Order.xlsx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]
2015-06-22 test communication between Cortex-M4 and A9 CPUs using UART
2015-06-25 Make the capture channels and input trigger on the PwmDecoder class configurable. Now both PWM encode and decode work
2015-06-26 Test for 8 output and 4 input Colibri specific PWM channels - now all the PWM functionality seems to be in place
2015-07-03 support for uart tracing; colibri board uses uart6
2015-07-04 Use input/max timer frequency for pwm encoding/decoding; reworked Frequency class to be able to handle milli and micro hertz
    [hwtimer.cpp, main.cpp, pwmdecoder.cpp, pwmencoder.cpp, units.h]
2015-07-04 Define PWM in/out channel count
2015-07-04 Start using printf for displayin diagnostic and status messages
2015-07-05 Track accelerometer
2015-07-08 servo implementation interim checkin
2015-07-09 go back to 1 based scheme for timer channel numbers; fix math in PwmPulse; now we can control the motors with the radio
    [hwtimer.cpp, hwtimer.h, main.cpp, pwmencoder.cpp, rcvalueconverter.h]
2015-07-10 Added RC value scale factor to compensate for the fact that max pulse from the RC is 1.91 ms, which seems to max the motors
2015-07-11 Use the RC GEAR channel to control the start/stop PWM impulse generation
2015-07-13 control motor power using PB2
2015-07-13 Added User buttons
2015-07-17 Do not consider gear RC value of 0.0 as a valid input
2015-07-18 reverse the semantics of the gear channel - now the motors will be armed if the read gear value is > 0.5
    [rcvalueconverter.cpp]
2015-07-18 refactor pid pilot code; still work in progress
2015-07-18 make the pid pilot code compile
2015-07-18 move the FlightControl class into its own files; increased the bias calc samples to 100
2015-07-22 Work on UartRpcServer
2015-07-22 add to the state and print the correction torque
    [dronestate.h, main.cpp]
2015-07-24 Added uart write method
2015-07-25 Added uart rpc client
2015-07-25 added uartrpc tool
2015-07-25 Work on UART rpc communication. Increased the baud rate.
2015-07-25 detect if an RC channel is dead and raise an alarm, which right now will either cut-off the engines or try to do a controlled descend
2015-07-26 Improvements of the UART rpc communication.
2015-07-27 Reading the pressure sensor.
2015-07-27 added temp i pressure to the RPC server
2015-07-28 introduced bmp180reader that reads and converts pressure to altitude; the code takes moving average of 25 samples
2015-07-28 Change the RPC server to return temperature/pressure/altitude from DroneState
2015-07-29 Reimplemented the BMP180 driver
2015-08-01 make calibration 4 times the size of the lpf filter
2015-08-01 ignore the last derivative error, when the derivative filter is not set
    [pidcontroller.h]
2015-08-02 clean-up main.cpp from old/test code; move interrupt handlers into their own file
2015-08-02 #3 Offload reading of the BMP180 sensor to a lower priority task
2015-08-08 Testing reading the pressure sensor.
2015-08-11 Fixes for FreeRTOS version 8.2.1
    [_interrupt_handlers.cpp, rtoshooks.cpp]
2015-08-12 use min_-epsilon if the value is too small or max_ if it is too big
    [rcvalueconverter.h]
2015-08-16 #4 Enforce flight ceiling by limiting the engines up to the emergency throttle; the alarm is lifted off when the UAV gets below the safe threshold - 70% of the ceiling
2015-08-17 pre-filter accel data
2015-08-17 #5 Enable Z compensation, use separate pid controller for Z torque, there is still work to be done though
2015-08-24 minor fix - do not assume the vector is going to be of dim 3
    [pidcontroller.h]
2015-08-24 preparation for integrating the read rudder value
2015-08-24 Integrate the yaw/rudder channel in order to get desired Z rotation
2015-08-25 Added yaw, pitch, roll to drone state
2015-08-25 Set/Reset kp, ki, kd using the dronestate structure
    [dronestate.h, flightcontrol.cpp, main.cpp, pidcontroller.h, pidtorque.cpp, pidtorque.h]
2015-08-25 fix init-preorder compiler warning
    [flightcontrol.cpp]
2015-08-25 Refactored the pid set coefficients code, now both pid and pid_yaw coefficients are controlled from DroneState
2015-08-25 Added support in the UI for xy and yaw PID settings
2015-08-26 Added gyro_factor and acc_period to the UI
2015-08-26 fixed sigmad client app initialization
    [clientapp.cpp]
2015-08-26 Fixed UI exit issues
    [main.cpp, mainwindow.cpp, mainwindow.h, rpcclientuart.cpp, rpcclientuart.h, uartrpcserver.cpp, userrpcserver.cpp]
2015-08-26 fixed the mainwindow.xml path
    [main.cpp]
2015-08-27 Added yaw_throttle_factor
2015-08-27 decrease emergency throttle to 0.3
2015-08-28 Changed the default track/control coefficients
2015-08-29 Adjust coeff for bigger props
2015-08-29 increase number of samples for calc bias to 800
2015-09-01 Fixed bugs related to flash memory configuration data
    [attitudetracker.cpp, flashmemory.cpp, flashmemory.h, main.cpp, rpcclientuart.h, uartrpcserver.cpp]
2015-09-03 Changed GetFifoAcc to return the number of samples read.
2015-09-03 Fixed the rpc help messages for rpc_get_configdata/rpc_set_configdata
    [uartrpcserver.cpp]
2015-09-05 Set emergency throttle to .45
2015-09-05 #5 - calc pid torque using the diff quaternion
2015-09-05 #5 - limit the Z torque; adjust Yaw PID coeff
2015-09-07 Readjust the yaw_kp/kd, increase the max yaw torque. Now the flight is fairly nimble even around the Z axis
2015-09-08 control max Z torque using yaw_throttle_factor; increase the yaw kd coeff
2015-09-08 Added yaw,pitch,roll bias
2015-09-09 work on adding support for yaw,pitch,roll bias
2015-09-09 Changed the coordinate system to use the standard yaw,pitch,roll orientation
2015-09-14 Read battery level.
2015-09-14 Reverse yaw reading in the code
    [rcvalueconverter.cpp]
2015-09-14 fixed build warnings in dronestate.h
    [dronestate.h]
2015-09-14 introduced class Battery that reads data from adc and converts it to the corresponding voltage
2015-09-18 Re-detect battery type only if the newly measured voltage is greater than the current max
2015-09-18 reset the starting altitude when the motors are powered off
    [altitudetracker.cpp, altitudetracker.h, flightcontrol.cpp]
2015-09-20 1) Use open-drain GPIOs on the I2C master; 2) Re-initialize I2C if exception is thrown while accessing bmp180 sensor
2015-09-20 Decrase the clock to 100000 and increase the timeout to 250 - seems to fix the issue of I2C bus going into constant busy state; left the re-init code in the exception handler, as a fail-safe feature
    [main.cpp]
2015-09-20 fix re-order compiler warning
    [serverapp.cpp]
2015-09-21 Increased I2C timeout to 750 ms
2015-09-27 Initial commit of version 2 of colibri board
    [c_ftdi_interface.sch, colibri-wnd.sch, cortex.sch, leds_buttons.sch, mems.sch, powerctrl.sch, pressure_sensor.sch, sensors_pwr_ctrl.sch]
2015-09-27 added sigmadrone schematic symbols library
2015-09-28 TinyGPS library taken verbatim from arduino for parsing GPRMC and GPGGA sentences
2015-09-28 Added WB connector and WB FTDI interface sheets
    [c_ftdi_interface.sch, colibri-wnd.sch, cortex.sch, leds_buttons.sch, mems.sch, powerctrl.sch, pressure_sensor.sch, sensors_pwr_ctrl.sch]
2015-10-02 Added connector: as0b826-s78b-7h
2015-10-06 Testing KiCad changes.
    [colibri-wnd.sch]
2015-10-06 Added test sheet
    [c_ftdi_interface.sch, colibri-wnd.sch, cortex.sch, leds_buttons.sch, mems.sch, powerctrl.sch, pressure_sensor.sch, sensors_pwr_ctrl.sch]
2015-10-07 Added Wandboard OTG and SD card sheets
    [c_ftdi_interface.sch, colibri-wnd.sch, cortex.sch, leds_buttons.sch, mems.sch, powerctrl.sch, pressure_sensor.sch, sensors_pwr_ctrl.sch]
2015-10-09 Added Wandboard ethernet connector
    [c_ftdi_interface.sch, colibri-wnd.sch, cortex.sch, leds_buttons.sch, mems.sch, powerctrl.sch, pressure_sensor.sch, sensors_pwr_ctrl.sch]
2015-10-09 Added HDMI interface
    [c_ftdi_interface.sch, colibri-wnd.sch, cortex.sch, leds_buttons.sch, mems.sch, powerctrl.sch, pressure_sensor.sch, sensors_pwr_ctrl.sch]
2015-10-10 Added PWM input/output sheets. Added GPS sheet.
    [gps.sch, receiver_pwm_input.sch, servo_pwm_output.sch]
2015-10-10 Fixed background color
    [c_ftdi_interface.sch, colibri-wnd.sch, cortex.sch, leds_buttons.sch, mems.sch, powerctrl.sch, pressure_sensor.sch, receiver_pwm_input.sch]
2015-10-10 Added voltage regulators sheet
    [c_ftdi_interface.sch, colibri-wnd.sch, cortex.sch, gps.sch, leds_buttons.sch, mems.sch, powerctrl.sch, pressure_sensor.sch]
2015-10-10 Added voltage regulator
2015-10-11 Added Wandboard USB Host
    [c_ftdi_interface.sch, colibri-wnd.sch, cortex.sch, gps.sch, leds_buttons.sch, mems.sch, powerctrl.sch, pressure_sensor.sch]
2015-10-11 Added hierarchical pins to the sheet
    [wb_connector.sch]
2015-10-14 added wnd_lcd.sch
    [c_ftdi_interface.sch, colibri-wnd.sch, cortex.sch, gps.sch, leds_buttons.sch, mems.sch, powerctrl.sch, pressure_sensor.sch]
2015-10-14 ADDED R1, R2 R3
    [swd_jtag.sch]
2015-10-15 Work on Wandboard LCD
    [wb_connector.sch, wnd_lcd.sch]
2015-10-17 Annotated Components
    [c_ftdi_interface.sch, cortex.sch, gps.sch, leds_buttons.sch, mems.sch, powerctrl.sch, pressure_sensor.sch, receiver_pwm_input.sch]
2015-10-17 Changes in the button sheet
    [leds_buttons.sch, swd_jtag.sch]
2015-10-17 Changes the leds
    [leds_buttons.sch]
2015-10-17 Changes to BOOT0
    [leds_buttons.sch]
2015-10-17 Separate VDD_IO
    [mems.sch, sensors_pwr_ctrl.sch]
2015-10-17 Use separate VDD IO
    [c_ftdi_interface.sch, cortex.sch, gps.sch, leds_buttons.sch, mems.sch, powerctrl.sch, pressure_sensor.sch, receiver_pwm_input.sch]
2015-10-17 Work on hardware
    [usb_otg_fs.sch, wb_connector.sch, wnd_ethernet.sch, wnd_lcd.sch, wnd_micro_sd.sch]
2015-10-17 Reworked the buttons/leds sheet
    [leds_buttons.sch, mems.sch, receiver_pwm_input.sch, servo_pwm_output.sch, swd_jtag.sch, usb_otg_fs.sch, wnd_ethernet.sch]
2015-10-19 Replaced PWM buffers with SN74LVC162244A, which doesn't require pull-ups
    [receiver_pwm_input.sch, servo_pwm_output.sch, voltage_regulators.sch]
2015-10-19 Work on LCD module
    [wnd_lcd.sch]
2015-10-19 base web page for drone status and control; bootstrap framework is utilized
2015-10-19 Re-annotated schematic
    [c_ftdi_interface.sch, cortex.sch, gps.sch, leds_buttons.sch, mems.sch, powerctrl.sch, pressure_sensor.sch, receiver_pwm_input.sch]
2015-10-19 Editted lcd connector
2015-10-19 Associated footprints for R and some of the C
    [c_ftdi_interface.sch, cortex.sch, gps.sch, leds_buttons.sch, mems.sch, powerctrl.sch, pressure_sensor.sch, receiver_pwm_input.sch]
2015-10-20 make the sensors section collapsible
2015-10-21 Made motors section collapsible as well
2015-10-22 Added schematic symbols R and C
2015-10-22 Work on JTAG and buttons sheets
    [leds_buttons.sch, swd_jtag.sch]
2015-10-24 Forms for PID control, not wired up yet
2015-10-25 Changed navbar to use pill-style buttons and the buttons are right-adjusted
2015-10-27 dynamically enable/disable the submit/apply button
2015-10-27 Work on cortex USB connection.
    [c_ftdi_interface.sch, cortex.sch, gps.sch, leds_buttons.sch, mems.sch, powerctrl.sch, pressure_sensor.sch, receiver_pwm_input.sch]
2015-10-27 wired up pid forms
2015-10-29 Worn on USB OTG connection for the cortex MCU
    [c_ftdi_interface.sch, leds_buttons.sch, usb_otg_fs.sch]
2015-10-30 Work on wandboard lcd and usb
    [c_ftdi_interface.sch, gps.sch, mems.sch, receiver_pwm_input.sch, servo_pwm_output.sch, stm32f4_sdram.sch, wb_ftdi_interface.sch, wnd_lcd.sch]
2015-10-31 Work on the Cortex sheet
    [cortex.sch, wb_ftdi_interface.sch, wnd_ethernet.sch, wnd_hdmi.sch, wnd_lcd.sch, wnd_micro_sd.sch, wnd_usb_host.sch, wnd_usb_otg.sch]
2015-10-31 Work on voltage regulators sheet.
    [usb_otg_fs.sch, voltage_regulators.sch, wnd_usb_otg.sch]
2015-10-31 MEMS NRND
    [mems.sch]
2015-11-01 Work on PWM, USB, MEMS, Power
    [cortex.sch, mems.sch, receiver_pwm_input.sch, sensors_pwr_ctrl.sch, servo_pwm_output.sch, usb_otg_fs.sch, wb_connector.sch, wnd_hdmi.sch]
2015-11-01 Added form for configuring sensors
2015-11-02 added symbol STM32F429NI
    [cortex.sch]
2015-11-03 reworked alarm reporting code - now alarm data is reported in string format; also the alarm is auto-cleared if it is not present anymore
    [alarm.h, dronestate.h, flightcontrol.cpp, flightcontrol.h, main.cpp, rcdefs.h, rcvalueconverter.cpp, rcvalueconverter.h]
2015-11-05 reworked the alarms to report the additional data in the form of a string; added new rpc methods to restore the default config and set the flight ceiling
    [altitudetracker.cpp, altitudetracker.h, dronestate.h, flightcontrol.cpp, main.cpp, uartrpcserver.cpp, uartrpcserver.h]
2015-11-06 Replaced the cortex processor with STM32F429NI
    [cortex.sch]
2015-11-07 Display motor values in percent; keep the OK button in the forms disabled, until the user inputs data
2015-11-09 Changed accelerometer_adjustment to accel_adjustmant value name to match the one in DroneState; when restoring defaults persists the default config to the flash, rather than erasing the flash
2015-11-12 Display battery icon
2015-11-12 Graphical display for motor values
2015-11-12 Report whether motors are armed
2015-11-15 Change the property name to motors_armed
2015-11-16 Added icon displaying motors armed on/off state; if motors are not armed always display their thrust as 0
2015-11-16 Work on power conrol sheet
    [powerctrl.sch, receiver_pwm_input.sch, servo_pwm_output.sch, wnd_usb_host.sch]
2015-11-21 Work on power control sheet
    [powerctrl.sch, voltage_regulators.sch]
2015-11-22 work on power control
    [powerctrl.sch, wnd_usb_host.sch]
2015-11-23 Added Power-On-Reset controller MCP120 to the Cortex
    [cortex.sch, receiver_pwm_input.sch, servo_pwm_output.sch, voltage_regulators.sch]
2015-11-23 Work on Cortex wiring
    [colibri-wnd.sch, cortex.sch, leds_buttons.sch]
2015-11-23 read the magnetometer
2015-11-23 Work on power controll, buttons
    [colibri-wnd.sch, cortex.sch, leds_buttons.sch, powerctrl.sch]
2015-12-01 Added UART polling functions
2015-12-01 Added uart_test from Freescale to test HW flow control
2015-12-02 Added voltage monitor TLV803SDBZT
    [cortex.sch, leds_buttons.sch]
2015-12-02 Removed the pullup resistor at the RESET button. The pullup is now at the voltage monitor
    [leds_buttons.sch]
2015-12-03 Added RTC to pandaboard
    [c_ftdi_interface.sch, colibri-wnd.sch, cortex.sch, gps.sch, leds_buttons.sch, mems.sch, powerctrl.sch, pressure_sensor.sch]
2015-12-03 Added XT60 connectors to battery and mottors
    [powerctrl.sch]
2015-12-05 Removed usb_otg_fs.sch, will not ULPI, so we don't need this sheet for now.
    [usb_otg_fs.sch]
2015-12-08 Track mangetometer in order to compensate for drift around the Z axis. Note: tracking is performed only if the altitude is sufficiently close to the XY plane
    [attitudetracker.cpp, main.cpp]
2015-12-10 Restored usb_otg_fs.sch file
    [usb_otg_fs.sch]
2015-12-10 Added eeprom to wandboard
    [c_ftdi_interface.sch, colibri-wnd.sch, cortex.sch, gps.sch, leds_buttons.sch, mems.sch, powerctrl.sch, pressure_sensor.sch]
2015-12-16 Added missing HPF filter functionality
    [lsm303d.cpp, lsm303d.h]
2015-12-17 Fix rpc calls to handle integer parameters
    [clientapp.cpp]
2015-12-17 Every exception handler that finishes with while(1) now calls EmergencyShutdown_Handler which turns off the motors
2015-12-17 Work on GPS. Added PCA9685
    [PCA9685PW_led_ctrl.sch, c_ftdi_interface.sch, colibri-wnd.sch, cortex.sch, gps.sch, leds_buttons.sch, mems.sch, powerctrl.sch]
2015-12-21 Switch the button selection to home when clicking on the logo
2015-12-23 Added connection between wandboard and cortex USB FS2
    [c_ftdi_interface.sch, colibri-wnd.sch, cortex.sch, gps.sch, leds_buttons.sch, mems.sch, pca9685pw_led_ctrl.sch, powerctrl.sch]
2015-12-25 Visualise gyro on the same chart
2016-01-01 use sd_get_dastream to get the sensor data. There is more to be desired from perf perspective - collecting 70k samples on 6 parameters made the chart very laggy when zooming and moving
2016-01-03 Sync-up samples with the timeline. For now using the sensor data from sd_get_dronestate_ex as the datastream takes too long to be served by the UART rpc
2016-01-03 Add quaternion and torque to the chart
2016-01-03 Renamed and re-ordered the Y axis items
2016-01-04 added second chart containing motors and the target attitude
2016-01-08 Fixed matrix multiplication and operator overloading
    [d3math.h]
2016-01-09 Added googletest framework for creating unit tests.
2016-01-10 Made chart titles h4; renamed Y Axis Data to Filter Data
2016-01-10 Changed the second chart to display the current and target Z vector
2016-01-14 Handle singularity case in Quaternion::decomposeTwistSwing
2016-01-14 Enabled the LPF on the derivative error, Fc=100 Hz; this resulted in much less pronounced jumps in the torques when the target quaternion is rapidly moving
    [pidcontroller.h, pidtorque.cpp]
2016-01-15 Control the pid filter frequency using the RPC mechanism
2016-01-16 Scale down the correctin torque if it greater than the base thrust.
2016-01-18 Added median filter for the derivative component of the pid controller, currently disabled
2016-01-25 IIR (recursive) filter implementation, according to direct form II
2016-01-26 set the pitch pid filter to 80 Hz
2016-01-26 Add IIR filter with Fc=5Hz
2016-01-26 Start using the IIR filters for accelerometer; set accelerometer sampling rate to 800 Hz
2016-01-27 Set the default accelerometer_correction_period_ to 2.0
2016-01-27 Reworked the IirFilter class, so it can be specialized with Vectors
    [accellowpassfilter.h, iirfilt.h, main.cpp]
2016-01-27 Changed the tripilot torque dir calculation
2016-01-27 Reworked firfilter.h to take advantage of the new Vector class
    [attitudefilter.h, firfilt.h, iirfilt.h, main.cpp, sensorsprefilters.h]
2016-01-29 work on wandboard service sheet.
    [c_ftdi_interface.sch, colibri-wnd.sch, cortex.sch, gps.sch, leds_buttons.sch, mems.sch, pca9685pw_led_ctrl.sch, powerctrl.sch]
2016-01-31 work on cortex sheet.
    [cortex.sch, wnd_service.sch]
2016-02-01 Changed the pwm encoder clock frequency.
2016-02-01 reduced the rate of the servo ctontroller to 350Hz
2016-02-02 Added test for moving avarage filter.
2016-02-02 Work on integral error
    [pidcontroller.h]
2016-02-02 Removed gyro_raw_ from DroneState
2016-02-02 Try filtering and integral error.
    [main.cpp, rcvalueconverter.cpp, rcvalueconverter.h, tripilot.cpp, tripilot.h]
2016-02-02 Use ODR_760Hz_BW_30 rate for the gyro
2016-02-02 Fixed multi-row matrix printing.
    [d3math.h]
2016-02-02 Increased the filter size
2016-02-02 Work on integral error.
    [tripilot.cpp]
2016-02-03 Reverted the pitch_bias_ roll_bias_ back to 0.0
    [rcvalueconverter.cpp]
2016-02-04 work on integrall error
    [main.cpp, rcvalueconverter.cpp, rcvalueconverter.h, tripilot.cpp, tripilot.h]
2016-02-04 reverted the throttle filter
    [rcvalueconverter.cpp, rcvalueconverter.h]
2016-02-05 In case voltage drops with more than 1 lipo cell, auto-detect the battery
2016-02-06 Add integral component with leak rate
    [pidtorque.cpp, pidtorque.h]
2016-02-07 use the correct pid controller for I component
    [pidtorque.cpp]
2016-02-08 added more experimental filters
2016-02-08 Set up code for potential gyro filtering
2016-02-08 Increase PID coeffecients by 2.96 and remove unnecessary multiplication in pidpilot.cpp
2016-02-08 Print entering main loop
2016-02-08 Increase the limits on PID coefficients
2016-02-08 Round up PID coefficients
2016-02-08 Scale down the throttle.
2016-02-08 Reduce the rate of the servo controller to 350Hz
2016-02-08 Changed the GYRO configuration to use: L3GD20::FULLSCALE_500, L3GD20::ODR_760Hz_BW_30
2016-02-08 Fixed multiline matrix output.
    [d3math.h]
2016-02-09 Clean-up compile warnings; got rid of the gyro pre-filter as it never provided better results
2016-02-11 Added tests: fir, propeller
2016-02-13 use AirflowForce::nvelocity to calculate the motors rpm
2016-02-13 Increse the torque generated byt the z error
    [dronestate.h, tripilot.cpp]
2016-02-13 Separated the pid controllers for xy, z in tripilot
2016-02-14 Updated yaw torque calculations for tripilot.
2016-02-14 reduced yaw zero tolerance offset to 0.0075
    [rcvalueconverter.cpp]
2016-02-14 Updated the yaw stearing for tripilot
2016-02-15 Added RPC for turning the accelerometer on/off
2016-02-15 Display base throttle RC value
2016-02-15 Display battery voltage
2016-02-15 Added control to enable/disable magnetometer tracking
2016-02-16 Class implementing fixed point math operations
    [fixedpoint.h]
2016-02-17 Fixed point - overload operators +-/*
    [fixedpoint.h]
2016-02-17 Added moving avarage filters for pitch,roll in tripilot
2016-02-17 Work on cortex sheet
    [cortex.sch]
2016-02-18 Work on cortex,jtag,buttons sheets
    [cortex.sch, leds_buttons.sch, swd_jtag.sch]
2016-02-18 unit test against filtering with Qm.n numbers
2016-02-19 Wired SDRAM pins. Added reset, power on/off for the WB module
    [colibri-wnd.sch, cortex.sch, leds_buttons.sch, receiver_pwm_input.sch, wb_connector.sch, wnd_usb_otg_to_cortex_usb_fs2.sch]
2016-02-19 work on sheets wiring
    [colibri-wnd.sch, cortex.sch, gps.sch, leds_buttons.sch, wb_connector.sch]
2016-02-20 Added M25P32
    [colibri-wnd.sch, wb_connector.sch, wnd_service.sch, wnd_usb_otg_to_cortex_usb_fs2.sch]
2016-02-21 Reduced the default accelerometer_correction_period_ for tripilot
2016-02-21 Added ext_sensors.sch sheet
    [colibri-wnd.sch, ext_sensors.sch, pressure_sensor.sch, wb_connector.sch, wb_ftdi_interface.sch, wnd_eeprom.sch, wnd_hdmi.sch, wnd_lcd.sch]
2016-02-21 Added wurth connector to the expansion sheet.
    [colibri-wnd.sch, cortex.sch, ext_sensors.sch, sensors_pwr_ctrl.sch, voltage_regulators.sch, wnd_lcd.sch]
2016-02-22 Resolving ERC problems
    [c_ftdi_interface.sch, colibri-wnd.sch, cortex.sch, ext_sensors.sch, gps.sch, leds_buttons.sch, mems.sch, pca9685pw_led_ctrl.sch]
2016-02-22 Fixed ERC errors
    [colibri-wnd.sch, cortex.sch, ext_sensors.sch, gps.sch, pca9685pw_led_ctrl.sch, powerctrl.sch, receiver_pwm_input.sch, sensors_pwr_ctrl.sch]
2016-02-22 Removed R41
    [c_ftdi_interface.sch, colibri-wnd.sch, cortex.sch, ext_sensors.sch, gps.sch, leds_buttons.sch, mems.sch, pca9685pw_led_ctrl.sch]
2016-02-22 Restored used libraries. Removed R41
    [c_ftdi_interface.sch, colibri-wnd.sch, cortex.sch, ext_sensors.sch, gps.sch, leds_buttons.sch, mems.sch, pca9685pw_led_ctrl.sch]
2016-02-23 Replaced the SDRAM with TFBGA-54
    [cortex.sch, ext_sensors.sch, gps.sch, leds_buttons.sch, pca9685pw_led_ctrl.sch, powerctrl.sch, receiver_pwm_input.sch, servo_pwm_output.sch]
2016-02-23 Assigning footprints
    [receiver_pwm_input.sch, servo_pwm_output.sch, stm32f4_sdram.sch]
2016-02-24 Added footprint for AS0B821-S78B-7H
2016-02-24 Added C to power inputs for MEMS and pressure. Work on board to board connector.
    [c_ftdi_interface.sch, cortex.sch, ext_sensors.sch, gps.sch, mems.sch, pca9685pw_led_ctrl.sch, powerctrl.sch, pressure_sensor.sch]
2016-02-24 Added BMP180_LGA footprint
    [wb_connector.sch]
2016-02-25 Added MOLEX_500254_1927.kicad_mod
    [wnd_hdmi.sch]
2016-02-26 Added and assigned footprints.
    [c_ftdi_interface.sch, wb_connector.sch, wb_ftdi_interface.sch, wnd_usb_host.sch]
2016-02-26 Adding and assigning footprints
    [ext_sensors.sch, gps.sch, pca9685pw_led_ctrl.sch, powerctrl.sch, pressure_sensor.sch, receiver_pwm_input.sch, sensors_pwr_ctrl.sch, servo_pwm_output.sch]
2016-02-27 Added new footprints
    [ext_sensors.sch, pca9685pw_led_ctrl.sch, voltage_regulators.sch]
2016-02-28 Added footprints
    [c_ftdi_interface.sch, gps.sch, powerctrl.sch, sensors_pwr_ctrl.sch, usb_otg_fs.sch, voltage_regulators.sch, wb_connector.sch, wb_ftdi_interface.sch]
2016-03-01 Fixed footprint layers
2016-03-01 Assigned footprints
    [gps.sch, mems.sch, wb_connector.sch, wnd_usb_otg_to_cortex_usb_fs2.sch]
2016-03-01 Added Power Jack footprint
    [c_ftdi_interface.sch, cortex.sch, ext_sensors.sch, gps.sch, leds_buttons.sch, mems.sch, pca9685pw_led_ctrl.sch, powerctrl.sch]
2016-03-03 Added SPPJ320600.kicad_mod
    [powerctrl.sch, wnd_micro_sd.sch, wnd_service.sch]
2016-03-03 Added VL_1220.kicad_mod footprint
    [cortex.sch, ext_sensors.sch, gps.sch, pca9685pw_led_ctrl.sch, powerctrl.sch, receiver_pwm_input.sch, sensors_pwr_ctrl.sch, servo_pwm_output.sch]
2016-03-03 Added AP6681GMT-HF-3.kicad_mod. Fixed netlist errors
    [c_ftdi_interface.sch, leds_buttons.sch, powerctrl.sch, usb_otg_fs.sch, voltage_regulators.sch, wb_connector.sch, wb_ftdi_interface.sch, wnd_ethernet.sch]
2016-03-03 Started the PCB file
    [c_ftdi_interface.sch, colibri-wnd.kicad_pcb, cortex.sch, ext_sensors.sch, gps.sch, leds_buttons.sch, mems.sch, pca9685pw_led_ctrl.sch]
2016-03-03 Added STANDOFF-4-40.kicad_mod footprint
    [colibri-wnd.kicad_pcb, colibri-wnd.sch, wb_connector.sch]
2016-03-04 Work on PCB placement
    [c_ftdi_interface.sch, colibri-wnd.kicad_pcb, colibri-wnd.sch, cortex.sch, ext_sensors.sch, gps.sch, leds_buttons.sch, mems.sch]
2016-03-05 Working on placement.
    [c_ftdi_interface.sch, colibri-wnd.kicad_pcb, colibri-wnd.sch, cortex.sch, ext_sensors.sch, gps.sch, pca9685pw_led_ctrl.sch, powerctrl.sch]
2016-03-06 Work on placement
    [c_ftdi_interface.sch, colibri-wnd.kicad_pcb, colibri-wnd.sch, cortex.sch, ext_sensors.sch, gps.sch, leds_buttons.sch, mems.sch]
2016-03-13 Added one more standoff, next to external sensors
    [colibri-wnd.kicad_pcb, colibri-wnd.sch]
2016-03-14 Added design rules and net classes
    [colibri-wnd.kicad_pcb]
2016-03-14 Removed net classes. Changed design rules.
    [colibri-wnd.kicad_pcb]
2016-03-15 Changed the tfbga footprints to use smaller pads
    [colibri-wnd.kicad_pcb, cortex.sch, stm32f4_sdram.sch]
2016-03-15 Work on PCB design rules.
    [colibri-wnd.kicad_pcb]
2016-03-16 Added lib.pretty/tfbga-216-32.kicad_mod lib.pretty/tfbga-54-32.kicad_mod
    [colibri-wnd.kicad_pcb, cortex.sch, stm32f4_sdram.sch]
2016-03-16 Work on cortex routing
    [colibri-wnd.kicad_pcb]
2016-03-17 Rearanged Voltage regulators
    [colibri-wnd.kicad_pcb]
2016-03-17 Reverted the TFBGA ball size back to 0.35mm
    [colibri-wnd.kicad_pcb, cortex.sch, stm32f4_sdram.sch]
2016-03-18 Fanned out all cortex pads
    [colibri-wnd.kicad_pcb]
2016-03-18 Added power vias to cortex
    [colibri-wnd.kicad_pcb]
2016-03-19 connected VREF, VCAP capacitors to cortex
    [colibri-wnd.kicad_pcb]
2016-03-19 Work on cortex filter C
    [colibri-wnd.kicad_pcb, cortex.sch]
2016-03-19 Changed the footprints of SDRAM filter capacitors
    [colibri-wnd.kicad_pcb, cortex.sch, ext_sensors.sch, servo_pwm_output.sch, stm32f4_sdram.sch]
2016-03-20 Fixed footprint DRC errors
    [colibri-wnd.kicad_pcb]
2016-03-21 Work on SDRAM routing
    [colibri-wnd.kicad_pcb]
2016-03-22 Word on SDRAM routing
    [colibri-wnd.kicad_pcb]
2016-03-23 Work on SDRAM
    [colibri-wnd.kicad_pcb]
2016-03-23 Work on Cortex and SDRAM routing
    [colibri-wnd.kicad_pcb]
2016-03-25 Work on SDRAM/Cortex routing
    [colibri-wnd.kicad_pcb]
2016-03-27 Work on Voltage regulators placement/routing
    [colibri-wnd.kicad_pcb]
2016-03-28 Routing Power connections
    [colibri-wnd.kicad_pcb]
2016-03-28 Changed the inner signal layers 2->4, 3->5
    [colibri-wnd.kicad_pcb]
2016-03-28 Changed the inner signal layers 2->4, 3->5. Rearanged GPS chip and cortex.
    [colibri-wnd.kicad_pcb]
2016-03-29 Work on voltage regulators
    [colibri-wnd.kicad_pcb]
2016-03-29 Routed Voltage Regulators
    [colibri-wnd.kicad_pcb]
2016-03-29 Routed Voltage Regulators. Connected wall adapter.
    [colibri-wnd.kicad_pcb]
2016-03-30 Work on VH power
    [colibri-wnd.kicad_pcb]
2016-03-30 Work on FTDI placement
    [colibri-wnd.kicad_pcb]
2016-03-31 Routed FTDI and OTG
    [colibri-wnd.kicad_pcb]
2016-04-01 Placed WB RTC and EEPROM
    [colibri-wnd.kicad_pcb]
2016-04-02 Placed buttons and LED resistors
    [colibri-wnd.kicad_pcb]
2016-04-03 Routed WB USB
    [colibri-wnd.kicad_pcb]
2016-04-04 Routed oscilators and MEMS
    [colibri-wnd.kicad_pcb, cortex.sch, gps.sch]
2016-04-06 Work on Cortex connections
    [colibri-wnd.kicad_pcb]
2016-04-07 Work on MEMS routing
    [colibri-wnd.kicad_pcb]
2016-04-07 Routed MEMS and cortex oscilators
    [colibri-wnd.kicad_pcb]
2016-04-08 Routed PWM connectors
    [colibri-wnd.kicad_pcb]
2016-04-10 Prototype bracket acting as a hub between the bottom, top base and an tube arm
    [bracket.FCStd]
2016-04-10 Work on external sensors routing
    [colibri-wnd.kicad_pcb]
2016-04-11 Work on FTDI routing
    [colibri-wnd.kicad_pcb]
2016-04-12 Work on USB OTG, FTDI routing
    [colibri-wnd.kicad_pcb]
2016-04-13 Bracket between a tube and the body
    [body-bracket.fcstd]
2016-04-14 Updated bracket design
    [body-bracket.fcstd]
2016-04-14 Updated bracket design - 2
    [body-bracket.fcstd]
2016-04-15 Optimized the complexity of the bracket
    [body-bracket.fcstd]
2016-04-15 Added light version of the body bracket
    [body-bracket-light.fcstd]
2016-04-16 More brackets for 1inch pipes
    [H_hub.FCStd, bracket1inch.FCStd, hub2.FCStd, hub2_no_union.FCStd]
2016-04-17 new body bracket design
    [body-bracket-c.fcstd]
2016-04-18 Added power connectors
    [colibri-wnd.kicad_pcb, cortex.sch, ext_sensors.sch, gps.sch, pca9685pw_led_ctrl.sch, powerctrl.sch, receiver_pwm_input.sch, sensors_pwr_ctrl.sch]
2016-04-18 bracket modifications
    [body-bracket-c.fcstd, body-bracket-light.fcstd]
2016-04-19 Reworked voltage regulators and power supply
    [colibri-wnd.kicad_pcb]
2016-04-19 Work on extension connectors
    [colibri-wnd.kicad_pcb]
2016-04-20 base for mounting motors
    [motor_mount.FCStd]
2016-04-20 Work on PWM routing
    [colibri-wnd.kicad_pcb]
2016-04-21 Work on LEDS routing
    [colibri-wnd.kicad_pcb, cortex.sch]
2016-04-21 Routed buttons
    [colibri-wnd.kicad_pcb]
2016-04-22 Connected buttons to MCU
    [colibri-wnd.kicad_pcb]
2016-04-22 New motor mound with round profile
    [motor_mount_round.FCStd]
2016-04-22 Routed power control
    [colibri-wnd.kicad_pcb]
2016-04-23 Routed touch screen controller
    [colibri-wnd.kicad_pcb, wnd_lcd.sch]
2016-04-23 Finished the motor mount
    [motor_mount.FCStd]
2016-04-23 Decrease size of the pocket for cables, increase radius of mounting pockets to 1.7mm
    [motor_mount.FCStd]
2016-04-24 Make the link between the motor mount and the bracket stronger
    [motor_mount.FCStd]
2016-04-24 Make the pocket for the motor cables a bit smaller
    [motor_mount.FCStd]
2016-04-24 Decreased the bracket side-cut, so the screw hole will be positioned in the center
    [motor_mount.FCStd]
2016-04-24 Body mounting holes
    [body-bracket-c.fcstd]
2016-04-26 Modified the mounting holes
    [body-bracket-c.fcstd]
2016-04-29 Cleaned up SDRAM routing
    [colibri-wnd.kicad_pcb]
2016-04-30 Another version of motor mouning bracket, cut from solid cube
    [motor_mount_cut.FCStd]
2016-04-30 More routing
    [colibri-wnd.kicad_pcb]
2016-04-30 Finished the motor mount plate
    [motor_mount_cut.FCStd]
2016-04-30 Introduce edge that limits the tube insertion
    [motor_mount_cut.FCStd]
2016-04-30 Before removing some of the LEDS
    [colibri-wnd.kicad_pcb]
2016-05-01 Make it more 3d print friendly
    [motor_mount_cut.FCStd]
2016-05-02 routing clean-up
    [colibri-wnd.kicad_pcb]
2016-05-03 moved the oscilators
    [colibri-wnd.kicad_pcb]
2016-05-04 Move pin headers arround
    [colibri-wnd.kicad_pcb]
2016-05-04 reconnected pin headers
    [colibri-wnd.kicad_pcb]
2016-05-05 Work on pin headers routing
    [colibri-wnd.kicad_pcb]
2016-05-05 Work on display connector
    [colibri-wnd.kicad_pcb]
2016-05-07 Work on USB connectors
    [colibri-wnd.kicad_pcb]
2016-05-08 Work on LCD connector
    [colibri-wnd.kicad_pcb, leds_buttons.sch, wb_connector.sch]
2016-05-10 Work on buttons and LCD connector
    [colibri-wnd.kicad_pcb]
2016-05-11 Work on external sensor connections
    [colibri-wnd.kicad_pcb]
2016-05-11 bracket for mounting motor and attaching landing gear
    [motor_base_landing_gear.fcstd]
2016-05-11 bracket for mounting motor and attaching landing gear v2
    [motor_base_landing_gear_2.fcstd]
2016-05-12 Rearanged the USB connections
    [colibri-wnd.kicad_pcb]
2016-05-16 Routed the seccond SD card
    [colibri-wnd.kicad_pcb]
2016-05-17 Make the bracket a bit smaller and more 3d print friendly (I hope)
    [motor_mount_cut.FCStd]
2016-05-17 Work on routing GND and power
    [colibri-wnd.kicad_pcb]
2016-05-18 Work on cortex processor power routing
    [colibri-wnd.kicad_pcb]
2016-05-18 Connected all pads
    [colibri-wnd.kicad_pcb]
2016-05-18 Routing clean up
    [colibri-wnd.kicad_pcb]
2016-05-19 holes for the bracket
    [motor_base_landing_gear_2.fcstd]
2016-05-20 Added plane stiching
    [colibri-wnd.kicad_pcb]
2016-05-21 Changed the pressure sensor to BMP280. Added more 3D models
    [colibri-wnd.kicad_pcb, pressure_sensor.sch]
2016-05-22 Fixed the GPS connection
    [colibri-wnd.kicad_pcb]
2016-06-01 started removing the velocity pid controller
2016-06-01 pwm support for colibri-v2
2016-06-03 initial commit for the sto-1 frame
    [assembly_sto-1.fcstd, battery.fcstd, body-bottom-reversed.fcstd, body-bottom.fcstd, body-bracket-mt-holes.fcstd, body-bracket.fcstd, body-bracket2.fcstd, body-top.fcstd]
2016-06-05 Added EXTI3_IRQHandler to DigitalIn interrupt handling, to be able to handle interrupts from the GYRO which is now on EXTI3
2016-06-05 Turn on the power_on pin, to keet the board powered. Added the USER LEDs
2016-06-06 Port the battery monitoring code; now battery voltage is measured every 3 seconds; temp enabled tracing
2016-06-07 Changed the help message for firmware-uart, now default device is /dev/ttymxc1
2016-06-07 Redefined the labels for the inter boards UART communication.
    [colibri-wnd.kicad_pcb, colibri-wnd.sch, cortex.sch]
2016-06-08 Fix the gyro and accelerometer alignment
    [main.cpp]
2016-06-09 Added stand mount part
    [assembly_sto-1.fcstd, body-bottom.fcstd, colibri-v2-frame.fcstd, stand-mount.fcstd]
2016-06-12 Fix pwm timer definition for pins 5-8
    [colibripwm.h]
2016-06-14 Modified 3D frame design
    [assembly_sto-1.fcstd, body-bottom.fcstd, body-top.fcstd, body-tube-leg.fcstd, esc-frame-e300.fcstd, motor_mount_bottom.fcstd, motor_mount_top-flat.fcstd]
2016-06-15 Use correction speed instead of correction period to track the accelerometer
    [attitudetracker.cpp, attitudetracker.h, dronestate.h, main.cpp, rcvalueconverter.cpp, uartrpcserver.cpp]
2016-06-15 report gyro_raw in drone_state
2016-06-15 print unbiased gyro
2016-06-15 redefine LEDs to match the switches
2016-06-17 driver for pca9685; verified motors can be controlled using pca9685, so now we have 16 pwm outputs
2016-06-17 In case of RPC failure, print the error details
2016-06-17 Avoid division by 0 when reading the sensors
    [main.cpp]
2016-06-17 Use PID controller to compensate for the gyroscope drift.
    [attitudetracker.cpp, attitudetracker.h, main.cpp]
2016-06-17 Use avarage angular speed as reference for the Z axis drift.
    [attitudetracker.cpp, dronestate.h, main.cpp]
2016-06-18 Use the the correction angular velocity generated by the accelerometer as an input for PID controller to compensate for the gyroscope drift
    [attitudetracker.cpp, attitudetracker.h, main.cpp]
2016-06-18 RPC methods for controlling the gyro drift PID controller; report the gyro drift and the drift PID coeff as part of drone state_ex
    [attitudetracker.cpp, attitudetracker.h, dronestate.h, main.cpp, uartrpcserver.cpp, uartrpcserver.h]
2016-06-18 Form for gyro drift PID controller
2016-06-18 turn-off printing to console; report the estimated gyro-drift in deg/s
    [main.cpp]
2016-06-20 Added new 3D parts
    [ar6260-holder.fcstd, assembly_sto-1.fcstd, colibri-v2-frame-receiver-mnt.fcstd, colibri-v2-gyrotest-frame.fcstd, distribution-box.fcstd, motor_mount_top-flat.fcstd, steval-holder.fcstd]
2016-06-22 rpc methods for controlling the leak rate for the integral component of the gyro drift PID controller
    [attitudetracker.cpp, attitudetracker.h, dronestate.h, main.cpp, uartrpcserver.cpp, uartrpcserver.h]
2016-06-23 L3GD20Reader in preparation for reading external gyro sensor
2016-06-25 Updated colibri-v2-gyrotest-frame.fcstd
    [colibri-v2-gyrotest-frame.fcstd]
2016-06-29 Interim checkin for enabling the external gyro, subsequent checkin will make use of the RPC calls to seamlessly transition from the internal gyro sensor to the external and vice versa
2016-07-03 Moved the gyro ISR inside the L3GD20Reader class; now the external gyro has its own interrupt and signalling queue; only one gyro interrupt is active at a time depending on which sensor is being used.
2016-07-04 rename external gyro json value
2016-07-04 Enable disble external gyro usage from the UI
2016-07-04 fix voltmeter vref - 3.25v is passed and not 3.3
    [adc.h]
2016-07-17 Support for presenting colibri board as a mass storage device when the usb otg port is connected to a host USB. I could see a USB storage device on linus/windows/osx, but could not format a partition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
2016-07-17 Fix compilation error, when USE_CORTEX_USB_OTG is not defined
    [colibrihwmap.h]
2016-07-17 Turn off printf
2016-07-25 removed velocity pid controller; rpc methods for altitude pid controllers coeff
2016-07-28 Decrease the bmp180 loop to 30 mS by using medium filter and not sleeping inside the bmp's loop. It seems that the altitude now is measured with delay of ~70 mS, but the error is +/-0.75 m as opposed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
    [altitudecontrol.cpp, dronestate.h, main.cpp, sensorsprefilters.h, timestamp.h]
2016-07-30 Change default PID coeff for altitude controller
2016-07-30 Changed the formula for calculating the altitude - now we calculate relative altitude to the initial position and factor in the temperature, as opposed to taking the pressure at sea level
2016-07-30 experimental code to calc vert velocity from accel, has no effect
2016-08-01 Added derivative filter which may prove useful for calculating vertical speed
2016-08-27 Remove empty line, printed after each line
2016-08-27 Calc the average on every sample, so it can easily be inspected in the debugger
2016-08-27 Update altitude PID controller default coeff
2016-08-27 Calculate samples using provided dT,which is sufficiently uniform
2016-08-27 New altitude tracking, using fusion between accel and pressure sensor
2016-09-03 Removed LPF for the torque
2016-09-03 Updated accelerometer tracking
2016-09-03 Allow for faster sync of the attitude and the accelerometer
2016-09-03 Altitude pid controller form; flight mode drop-down list
2016-09-05 colibir v2 box
    [colibri-v2-box.fcstd, colibri-v2-cover.fcstd]
2016-09-09 made the cover thicker
    [colibri-v2-cover.fcstd]
2016-09-23 Use filtered correction speed
    [attitudetracker.cpp, attitudetracker.h, dronestate.h, main.cpp, pidcontroller.h, tripilot.cpp]
2016-09-23 Added power distribution PCB
    [esc-power.kicad_pcb, esc-power.sch]
2016-09-23 Using components with 5mm pitch
    [esc-power.kicad_pcb, esc-power.sch]
2016-09-24 Modified the project settings
    [esc-power.kicad_pcb]
2016-09-24 Fixed build error with the gcc 5.4
    [d3math.h]
2016-09-25 Increased pitch and roll filter alpha
2016-10-03 Cleanup the altitude tracking code; simplify a bit by specializing the pid controller on the Altitude type
2016-10-10 Changed the way the vertical velocity estimate was compensated, by using the error between the estimated and measured altitude; added rpc methods to get/set the pid controller coefficients
    [altitudetracker.cpp, altitudetracker.h, dronestate.h, sensorsprefilters.h, uartrpcserver.cpp, uartrpcserver.h]
2016-10-17 Changed the altitude pid controller to track the vertical speed as opposed to the altitude- seems to result in much smoother flight, even though it may drift a bit
    [altitudecontrol.cpp, altitudecontrol.h, altitudetracker.cpp, altitudetracker.h, battery.cpp, battery.h, dronestate.h, main.cpp]
2016-10-18 Minor fixes to the box and the cover
    [colibri-v2-box.fcstd, colibri-v2-cover.fcstd]
2016-10-26 Implement altitude control scheme, where both vertical velocity and altitude are tracked, when throttle is at 0.5, results in much better altitude hold, as tracking just speed can't result in no drif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
    [altitudecontrol.cpp, altitudecontrol.h, altitudetracker.cpp, altitudetracker.h, colibrihwmap.h, derivativefilter.h, dronestate.h, main.cpp]
2016-10-27 Decreased pitch and roll filter alpha
2016-10-27 Work on six propeller setup. Code cleanup
2016-10-29 Added six propeller configuration. Tested both six and four configurations.
2016-11-02 fix initial values for pitch, yaw and roll
    [rcvalueconverter.cpp]
2016-11-02 Decrease the integral component leak rate of the vertical velocity pid
    [altitudecontrol.cpp]
2016-11-02 Effectively disable the altitude error input for the vertical velocity pid
    [dronestate.h]
2016-11-12 Use UART4 for the the GPS reader
2016-11-13 Revert back to using USART3 fro the GPS reader
    [_interrupt_handlers.cpp, colibrihwmap.h, gpsreader.cpp, main.cpp]
2016-12-07 Read gear value as binary 0 or 1 so comparison with previous value would be accurate
2016-12-07 redefine prop rotation direction for quad, so it is inline with the rest of the world
2016-12-07 Remapped the sensor orientation for six propeller frame
2016-12-15 Added BMP280 driver
2016-12-15 Added support for power on/off button
2016-12-15 Update shutdown pin
2016-12-15 Added interrupts for power off
2016-12-15 Use BMP280 for pressure measurement
2016-12-15 Restored the old bmp180reader. Added task delay in the pressure measurement task
2016-12-16 fix acc alignment for quad frame
    [main.cpp]
2016-12-16 Adjusted altitude tracking coeff; correctly set the raw altitude in drone state
    [altitudetracker.cpp, dronestate.h]
2016-12-16 Updated PID init falues
2016-12-16 Added external ST pressure sensor pins
2016-12-16 Added ST pressure sensor to SPI2 bus.
2016-12-17 Added LPS25HB driver
2016-12-17 fix-up the calibration of bmp280
    [bmp280reader.cpp, sensorsprefilters.h]
2016-12-17 Added pressure sensor
2016-12-17 Fixed the configuration of LPS25HB to be used for altitude tracking.
    [dronestate.h, lps25hb.cpp, main.cpp]
2016-12-18 Pressure and temperature units
2016-12-18 Set altitude tracking to FLIGHT_MODE_ALTITUDE_HOLD for six propellers frame
2016-12-22 Report raw gear reading from the rc receiver
2016-12-22 save to flash altitude pid coefficients
2016-12-22 Read the the temperature from LPS25HB sensor
2016-12-22 Assert the interrupt line is empty, before assigning the value
2016-12-22 Added support to arm the motors using the second push button. Disarming the buttons using the gear channel is disabled for six propellers frame.
2016-12-22 Added temperature field.
2016-12-22 Disable motor disarming from the RC transmitter for six propelers frame.
2016-12-23 Added gear_alive to drone state.
2016-12-24 Added support for arming/disarming motors using the left and right control sticks
2017-01-23 Added USE_ALIGNMENT_MIPIFRONT for sensors alignment
2017-01-23 Removed pid_d lpf, it doesn't work.
    [tripilot.cpp, tripilot.h]
2017-01-24 Added accelerometer reader. Cleaned up main.cpp, removed ext gyro.
2017-01-25 Added separate accelerometer filter for the altitude tracker.
2017-01-25 Tuned the gyro filter.
2017-01-25 Tuned the gyro filter, lower alpha.
2017-02-26 Changed PID coeff for lite frame
2017-03-12 display correctly motors, so they match the ones on the frame
2017-03-29 sleep less between gps readings; measure the time it takes to obtain a new gps sample - currently ~1s
2017-03-29 increase the throttle range for altitude hold; control the altitude for modes >= alttiude_hold
2017-03-29 Use uint32_t as a base type for an angle in order to maintain precision for smaller lat/long angles; fixed the math for positioncontrol
    [gpsreader.cpp, gpsreader.h, positioncontrol.cpp, positioncontrol.h, units.h]
2017-03-30 Increase the number of callibration samples to 2400
2017-03-30 Drain the fifo and warm up the filter, before starting the callibration
2017-03-31 magnetometer calibration code, so far not impressed with the results
2017-04-03 Changed the propellers direction for the hex frame to be consistent with the quad.
2017-04-04 Added driver for LSM330 gyro.
2017-04-05 alignment matrix for the _normal_ case, when WB connector is pointing to X
2017-04-05 Added LSM330 accelerometer driver.
2017-04-05 Fixed bug in GPIOPin::init
    [gpiopin.cpp]
2017-04-05 Added pin configurations for the second MEMS sensor LSM330
2017-04-05 Added DigitalIn::vector_handler(14); to handle interrupts from the LSM330 gyro.
2017-04-05 Setup LPF for accelerometer. Changed the cutoff frequency to 50Hz for gyroscope.
2017-04-06 Control bmp280 thru SPI; deleted the bmp280 task; added new axesalignment.h which holds the alignment matrises
2017-04-07 Prefilter magnetometer. Verified after calibration, emf from motors skew the measurement by ~10 deg, which seems to be acceptable
2017-04-08 Pre-filter mag data; save mag calibration params to flash; introduced new rpc call that saves currently active boot config to flash as opposed to whatever was passed with the call; verified mag calib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
2017-04-10 ui artifacts for mag calibration
2017-04-15 Make altitude PID controller integral leak rate configurable
    [altitudecontrol.cpp, dronestate.h, main.cpp, uartrpcserver.cpp, uartrpcserver.h]
2017-04-15 rpc calls for configuring the position PID controller
2017-04-18 pos control: added lpf for axis and angle/distance; reversed the way tthe error vector is calculated, so positive swing angles will be passed - more intuitive
    [dronestate.h, main.cpp, positioncontrol.cpp, positioncontrol.h]
2017-09-03 Fix build error with the new arm compiler.
    [main.cpp]
2018-03-12 1) fix derivative filter coefficients; 2) inc altitude Kp and dec Kd; 3) set bmp280 as default pressure sensor
    [derivativefilter.h, dronestate.h]
2018-03-13 Reduce SPI baudrate to 5.6 MHz
2018-08-16 Remove unused USB device code
2018-10-07 SD card pin mappings
